pulp-platform/pulp/doc/IP_REFERENCES/BASIC_TIMER_reference.xlsx

Sheet: Info
Document Information
Name | BASIC_TIMER reference
Category | IP reference
Author | Florent Rotenberg
Version | 1.0
Status | Fisrt Release
Description | BASIC_TIMER interface definition
IP Information
IP type | BASIC_TIMER
Delivery Type
History
Date | Modification | Author
26/10/2016 | 1strelease | F.Rotenberg
Content
Info | This sheet. General information about document usage
Usage | Guidelines on how to used the various sheet
IP Release | Release information sheet describing
IPIF_relx.x | IP interface description reference, describing IP symbol/entity and integration and test information relative to IP interface.
IPDESCR_Relx.x | Description of the main features of the IP
IPREGLIST_rely.y | Description of the list of registers used by IP. Registers can be physically instanciated inside IP or outside IP.
IPREGMAP_relz.z | Description of mapping of bit fields when registers are internal to IP. This sheet is optional for IP which are not instanciating registers as information can be build from IPIF and IPRELIST sheet.
IPTREGMAP_relz.z | Description of mapping of test bit field when registers are internal to IP. This sheet is optional for IP which are not instanciating registers as information can be build from IPIF and IPRELIST sheet.

Sheet: Usage
IP Release Sheet
 | Column | Description | Possible Value
 | Version | IP release version numeroted as [major release].[minor release]. A release is major whenever IP interface is modified. | X.Y. Z
 | Release description | This is a free text entry expliciting the release main modifications and purpose. | Text
 | IPIF | IPIF sheet version to be used for this release. | X.Y. Z
 | IPDESCR | IPDESCR sheet version to nbe used for this release | X.Y.Z
 | IPREGLIST | IPREGLIST sheet version to be used for this release. | X.Y. Z
 | IPREGMAP | IPREGMAP sheet version to be used for this release. | X.Y. Z
 | IPDOC | IPDOC version to be used for this release. | X.Y. Z
 | GIT version | GIT database number corresponding to IP design code and IP reference XLS. | Integer
IPIF sheet
IP Interface description | IP Pin Name | Name of IP Pin. This must must exactly name find in code or schematic (including case).
 | Direction | Direction or type of signal | In,Out,IO
 | Type | Analog, Digital, supply, DR (Dual Rail), SR (SingleRail) | Analog,Digital, VDD, GND, DR, SR
 | Voltage Domain
 | Clock domain
 | IO
 | Size
 | Reset Value
 | Description
Integration information | Integration comment
 | Core Interface
 | Register Interface
 | Register name
 | DFT value
 | Level Shifter
 | Isolation cell
 | Connected to
 | Load
 | Drive
 | Destination supply
Hard Macro information | location
 | layer
 | Antenna
Additonal Information | FreeText 1
 | FreeText 2
Driver information | Function1
 | Function2

Sheet: IP Release
Version | Release description | IPIF | IPDESCR | IPREGLIST | IPREGMAP | IPDOC | GIT version
1.0.0 |  | Rel1.0.0 | Rel1.0.0 | Rel1.0.0 | Rel1.0.0

Sheet: IPIF_rel1.0.0
IP Interface description |  |  |  |  |  |  |  |  | Integration information |  |  |  |  |  |  |  |  |  |  |  |  | Hard Macro information |  |  | Additonal Information |  | Driver information
IP Pin Name | Direction | Type | Voltage Domain | Clock domain | IO | Size | Reset Value | Description | Integration comment | Core Interface | Register Interface | Register name | Bit position | Trim during production | DFT value | Level Shifter | Isolation cell | Connected to | Load | Drive | Destination supply | location | layer | Antenna | FreeText 1 | FreeText 2 | Function1 | Function2
clk_i | IN | digital
rstn_i | IN | digital

Sheet: IPDESCR_rel1.0.0
Description
BASIC TIMER component manages the following features: - 2 general purpose 32bits up counter timers - Input trigger sources: - FLL clock - FLL clock + Prescaler - Reference clock at 32kHz - External event - 8bit programmable prescaler to FLL clock - Counting modes: - One shot mode: timer is stopped after first comparison match - Continuous mode: timer continues counting after comparison match - Cycle mode: timer resets to 0 after comparison match and continues counting - 64 bit cascaded mode - Interrupt request generation on comparison match

Sheet: IPREGLIST_rel1.0.0
Register Name | Address | Size | Register Type | Host Access Type | IP access Type | Default Value | Description | FootNote | Comment
CFG_LO | 0x0 | 32 | Config | R/W | R/W | 0x0 | Timer Low Configuration register.
CFG_HI | 0x4 | 32 | Config | R/W | R/W | 0x0 | Timer High Configuration register.
CNT_LO | 0x8 | 32 | Data | R/W | R/W | 0x0 | Timer Low counter value register.
CNT_HI | 0xC | 32 | Data | R/W | R/W | 0x0 | Timer High counter value register.
CMP_LO | 0x10 | 32 | Config | R/W | R/W | 0x0 | Timer Low comparator value register.
CMP_HI | 0x14 | 32 | Config | R/W | R/W | 0x0 | Timer High comparator value register.
START_LO | 0x18 | 32 | Config | R/W | R/W | 0x0 | Start Timer Low counting register.
START_HI | 0x1C | 32 | Config | R/W | R/W | 0x0 | Start Timer High counting register.
RESET_LO | 0x20 | 32 | Config | R/W | R/W | 0x0 | Reset Timer Low counter register.
RESET_HI | 0x24 | 32 | Config | R/W | R/W | 0x0 | Reset Timer High counter register.

Sheet: IPREGMAP_rel1.0.0
Bit field | Register | Bit Position | Size | Host Access Type | IP access Type | Reset Value | Description
ENABLE | CFG_LO | 0 | 1 | R/W | R/W | 0x0 | Timer low enable configuration bitfield: - 1'b0: disabled - 1'b1: enabled
RESET | CFG_LO | 1 | 1 | R/W | R/W | 0x0 | Timer low counter reset command bitfield. Cleared after Timer Low reset execution.
IRQEN | CFG_LO | 2 | 1 | R/W | R/W | 0x0 | Timer low compare match interrupt enable configuration bitfield: - 1'b0: disabled - 1'b1: enabled
MODE | CFG_LO | 4 | 1 | R/W | R/W | 0x0 | Timer low continuous mode configuration bitfield: - 1'b0: Continue mode - continue incrementing Timer low counter when compare match with CMP_LO occurs. - 1'b1: Cycle mode - reset Timer low counter when compare match with CMP_LO occurs.
ONE_S | CFG_LO | 5 | 1 | R/W | R/W | 0x0 | Timer low one shot configuration bitfield: - 1'b0: let Timer low enabled counting when compare match with CMP_LO occurs. - 1'b1: disable Timer low when compare match with CMP_LO occurs.
PEN | CFG_LO | 6 | 1 | R/W | R/W | 0x0 | Timer low prescaler enable configuration bitfield: - 1'b0: disabled - 1'b1: enabled
CCFG | CFG_LO | 7 | 1 | R/W | R/W | 0x0 | Timer low clock source configuration bitfield: - 1'b0: FLL or FLL+Prescaler - 1'b1: Reference clock at 32kHz
PVAL | CFG_LO | 8 | 8 | R/W | R/W | 0x0 | Timer low prescaler value bitfield. Ftimer = Fclk / (1 + PRESC_VAL)
CASC | CFG_LO | 31 | 1 | R/W | R/W | 0x0 | Timer low + Timer high 64bit cascaded mode configuration bitfield.
ENABLE | CFG_HI | 0 | 1 | R/W | R/W | 0x0 | Timer high enable configuration bitfield: - 1'b0: disabled - 1'b1: enabled
RESET | CFG_HI | 1 | 1 | W | R | 0x0 | Timer high counter reset command bitfield. Cleared after Timer high reset execution.
IRQEN | CFG_HI | 2 | 1 | R/W | R/W | 0x0 | Timer high compare match interrupt enable configuration bitfield: - 1'b0: disabled - 1'b1: enabled
MODE | CFG_HI | 4 | 1 | R/W | R/W | 0x0 | Timer high continuous mode configuration bitfield: - 1'b0: Continue mode - continue incrementing Timer high counter when compare match with CMP_LO occurs. - 1'b1: Cycle mode - reset Timer high counter when compare match with CMP_LO occurs.
ONE_S | CFG_HI | 5 | 1 | R/W | R/W | 0x0 | Timer high one shot configuration bitfield: - 1'b0: let Timer high enabled counting when compare match with CMP_LO occurs. - 1'b1: disable Timer high when compare match with CMP_LO occurs.
PEN | CFG_HI | 6 | 1 | R/W | R/W | 0x0 | Timer high prescaler enable configuration bitfield: - 1'b0: disabled - 1'b1: enabled
CLKCFG | CFG_HI | 7 | 1 | R/W | R/W | 0x0 | Timer high clock source configuration bitfield: - 1'b0: FLL or FLL+Prescaler - 1'b1: Reference clock at 32kHz
CNT_LO | CNT_LO | 0 | 32 | R/W | R/W | 0x0 | Timer Low counter value bitfield.
CNT_HI | CNT_HI | 0 | 32 | R/W | R/W | 0x0 | Timer High counter value bitfield.
CMP_LO | CMP_LO | 0 | 32 | R/W | R/W | 0x0 | Timer Low comparator value bitfield.
CMP_HI | CMP_HI | 0 | 32 | R/W | R/W | 0x0 | Timer High comparator value bitfield.
STRT_LO | START_LO | 0 | 1 | W | R | 0x0 | Timer Low start command bitfield. When executed, CFG_LO.ENABLE is set.
STRT_HI | START_HI | 0 | 1 | W | R | 0x0 | Timer High start command bitfield. When executed, CFG_HI.ENABLE is set.
RST_LO | RESET_LO | 0 | 1 | W | R | 0x0 | Timer Low counter reset command bitfield. When executed, CFG_LO.RESET is set.
RST_HI | RESET_HI | 0 | 1 | W | R | 0x0 | Timer High counter reset command bitfield. When executed, CFG_HI.RESET is set.

Sheet: VerPlan_rel1.0.0
Name | Description | testcase location&name | Status
