pulp-platform/pulp/doc/IP_REFERENCES/CL_DMA_reference.xlsx

Sheet: Info
Document Information
Name | CL_DMA reference
Category | IP reference
Author | Florent Rotenberg
Version | 1.0
Status | Fisrt Release
Description | CL_DMA interface definition
IP Information
IP type | CL_DMA
Delivery Type
History
Date | Modification | Author
26/10/2016 | 1strelease | F.Rotenberg
Content
Info | This sheet. General information about document usage
Usage | Guidelines on how to used the various sheet
IP Release | Release information sheet describing
IPIF_relx.x | IP interface description reference, describing IP symbol/entity and integration and test information relative to IP interface.
IPDESCR_Relx.x | Description of the main features of the IP
IPREGLIST_rely.y | Description of the list of registers used by IP. Registers can be physically instanciated inside IP or outside IP.
IPREGMAP_relz.z | Description of mapping of bit fields when registers are internal to IP. This sheet is optional for IP which are not instanciating registers as information can be build from IPIF and IPRELIST sheet.
IPTREGMAP_relz.z | Description of mapping of test bit field when registers are internal to IP. This sheet is optional for IP which are not instanciating registers as information can be build from IPIF and IPRELIST sheet.
IPUDMACMDLIST_relz.z | Description of IP UDMA commands list used by IP.
IPUDMACMDMAP_relz.z | Description of mapping of bit fields in IP UDMA commands used by IP.

Sheet: Usage
IP Release Sheet
 | Column | Description | Possible Value
 | Version | IP release version numeroted as [major release].[minor release]. A release is major whenever IP interface is modified. | X.Y. Z
 | Release description | This is a free text entry expliciting the release main modifications and purpose. | Text
 | IPIF | IPIF sheet version to be used for this release. | X.Y. Z
 | IPDESCR | IPDESCR sheet version to nbe used for this release | X.Y.Z
 | IPREGLIST | IPREGLIST sheet version to be used for this release. | X.Y. Z
 | IPREGMAP | IPREGMAP sheet version to be used for this release. | X.Y. Z
 | IPUDMACMDLIST | IPUDMACMDLIST sheet version to be used for this release. | X.Y. Z
 | IPUDMACMDMAP | IPUDMACMDMAP sheet version to be used for this release. | X.Y. Z
 | IPDOC | IPDOC version to be used for this release. | X.Y. Z
 | GIT version | GIT database number corresponding to IP design code and IP reference XLS. | Integer
IPIF sheet
IP Interface description | IP Pin Name | Name of IP Pin. This must must exactly name find in code or schematic (including case).
 | Direction | Direction or type of signal | In,Out,IO
 | Type | Analog, Digital, supply, DR (Dual Rail), SR (SingleRail) | Analog,Digital, VDD, GND, DR, SR
 | Voltage Domain
 | Clock domain
 | IO
 | Size
 | Reset Value
 | Description
Integration information | Integration comment
 | Core Interface
 | Register Interface
 | Register name
 | DFT value
 | Level Shifter
 | Isolation cell
 | Connected to
 | Load
 | Drive
 | Destination supply
Hard Macro information | location
 | layer
 | Antenna
Additonal Information | FreeText 1
 | FreeText 2
Driver information | Function1
 | Function2

Sheet: IP Release
Version | Release description | IPDESCR | IPIF | IPREGLIST | IPREGMAP | IPUDMACMDLIST | IPUDMACMDMAP | IPDOC | GIT version
1.0.0 |  | Rel1.0.0 | Rel1.0.0 | Rel1.0.0 | Rel1.0.0 | Rel1.0.0 | Rel1.0.0

Sheet: IPIF_rel1.0.0
IP Interface description |  |  |  |  |  |  |  |  | Integration information |  |  |  |  |  |  |  |  |  |  |  |  | Hard Macro information |  |  | Additonal Information |  | Driver information
IP Pin Name | Direction | Type | Voltage Domain | Clock domain | IO | Size | Reset Value | Description | Integration comment | Core Interface | Register Interface | Register name | Bit position | Trim during production | DFT value | Level Shifter | Isolation cell | Connected to | Load | Drive | Destination supply | location | layer | Antenna | FreeText 1 | FreeText 2 | Function1 | Function2

Sheet: IPDESCR_rel1.0.0
Description
Cluster DMA component manages the following features: - 8 RX/TX full-duplex channels - Up to 16 outstanding transfers between L1 and L2 memories - Linear or 2D transfers modes

Sheet: IPREGLIST_rel1.0.0
Register Name | Address | Size | Register Type | Host Access Type | Host access bus | IP access Type | Default Value | Description | FootNote | Comment
CMD | 0x0 | 32 | Config | R/W | DEMUX | R/W | 0x0 | Cluster DMA configuration register.
STATUS | 0x4 | 32 | Status | R/W | DEMUX | R/W | 0x0 | Cluster DMA status register.

Sheet: IPREGMAP_rel1.0.0
Bit field | Register | Bit Position | Size | Host Access Type | IP access Type | Reset Value | Description
CMD | CMD | 0 | 32 | R/W | R/W | 0x0 | Format is operation dependent. See below.
STATUS | STATUS | 0 | 32 | R/W | R/W | 0x0 | Format is operation dependent. See below.

Sheet: IPFSMSTATES_rel1.0.0
State | Format Name | Next State | Start graph | Comment | Graph title
IDLE | GET_TID | ID_ACK | 1 |  | Queue transaction with ID
IDLE | CMD | CMD_ACK | 2 |  | Queue transaction without ID
IDLE | STATUS | IDLE | 3 |  | Get DMA status
IDLE | FREE_TID | IDLE | 4 |  | Free DMA transfer
ID_ACK | CMD | CMD_ACK
CMD_ACK | TCDM | TCDM_ACK
TCDM_ACK | EXT_L2 | IDLE |  | CMD - Not 2D
TCDM_ACK | EXT_L2 | EXT_ACK |  | CMD - 2D
EXT_ACK | 2D | IDLE

Sheet: IPFSMFMTLIST_rel1.0.0
Register Name | Format Name | Size | Host Access Type | Description | FootNote | Comment
CMD | GET_TID | 32 | R | Cluster DMA transfer identifier format.
CMD | CMD | 32 | W | Cluster DMA transfer configuration format.
CMD | TCDM | 32 | W | Cluster DMA L1 base address configuration format.
CMD | EXT_L2 | 32 | W | Cluster DMA L2 base address configuration format.
CMD | 2D | 32 | W | Cluster DMA 2D transfer configuration format.
STATUS | STATUS | 32 | R | Cluster DMA transfer free command format.
STATUS | FREE_TID | 32 | W | Cluster DMA transfer status format.

Sheet: IPFSMFMTMAP_rel1.0.0
Bit field | Register name | Format Name | Bit Position | Size | Host Access Type | IP access Type | Reset Value | Description
LEN | CMD | CMD | 0 | 16 | W | R | 0x0 | Transfer length in bytes configuration bitfield.
TYPE | CMD | CMD | 16 | 1 | W | R | 0x0 | Transfer direction configuration bitfield: - 1'b0: L1 to L2 - 1'b1: L2 to L1
INC | CMD | CMD | 17 | 1 | W | R | 0x0 | Transfer incremental configuration bitfield: - 1'b0: non incremental - 1'b1: incremental
2D | CMD | CMD | 18 | 1 | W | R | 0x0 | Transfer type configuration bitfield: - 1'b0: linear transfer - 1'b1: 2D transfer
ELE | CMD | CMD | 19 | 1 | W | R | 0x0 | Transfer event generation configuration bitfield: - 1'b0: disabled - 1'b1: enabled
ILE | CMD | CMD | 20 | 1 | W | R | 0x0 | Transfer interrupt generation configuration bitfield: - 1'b0: disabled - 1'b1: enabled
BLE | CMD | CMD | 21 | 1 | W | R | 0x0 | Transfer event or interrupt broadcast configuration bitfield: - 1'b0: event or interrupt is routed to the cluster core who initiated the transfer - 1'b1: event or interrupt are broadcasted to all cluster cores
TID | CMD | GET_TID | 0 | 4 | R | W | 0x0 | Transfer identifier value bitfield.
ADDR | CMD | TCDM | 0 | 32 | W | R | 0x0 | Transfer L1 base address configuration bitfield.
ADDR | CMD | EXT_L2 | 0 | 32 | W | R | 0x0 | Transfer L2 base address configuration bitfield.
LEN | CMD | 2D | 0 | 16 | W | R | 0x0 | 2D transfer length value configuration bitfield.
STRIDE | CMD | 2D | 16 | 16 | W | R | 0x0 | 2D transfer stride value configuration bitfield.
TID_TR | STATUS | STATUS | 0 | 16 | R | W | 0x0 | Transfer status bitfield: TID_TR[i]=1'b1 means that transfer with TID i is active.
TID_ALLOC | STATUS | STATUS | 16 | 16 | R | W | 0x0 | Transfer status bitfield: - TID_TR[i]=1'b0 means that transfer allocator with TID i-16 is free. - TID_TR[i]=1'b1 means that transfer allocator with TID i-16 is reserved.
TID_FREE | STATUS | FREE_TID | 0 | 16 | W | R | 0x0 | Transfer canceller configuration bitfield. Writing a 1'b1 in TID_FREE[i] will free transfer with TID i.

Sheet: VerPlan_rel1.0.0
Name | Description | testcase location&name | Status
