pulp-platform/pulp/doc/IP_REFERENCES/CLUSTER_ICACHE_CTRL_reference.xlsx

Sheet: Info
Document Information
Name | FC_ICACHE_CTRL reference
Category | IP reference
Author | Florent Rotenberg
Version | 1.0
Status | Fisrt Release
Description | FC_ICACHE_CTRL interface definition
IP Information
IP type | FC_ICACHE_CTRL
Delivery Type
History
Date | Modification | Author
26/10/2016 | 1st release | F.Rotenberg
Content
Info | This sheet. General information about document usage
Usage | Guidelines on how to used the various sheet
IP Release | Release information sheet describing
IPIF_relx.x | IP interface description reference, describing IP symbol/entity and integration and test information relative to IP interface.
IPDESCR_Relx.x | Description of the main features of the IP
IPREGLIST_rely.y | Description of the list of registers used by IP. Registers can be physically instanciated inside IP or outside IP.
IPREGMAP_relz.z | Description of mapping of bit fields when registers are internal to IP. This sheet is optional for IP which are not instanciating registers as information can be build from IPIF and IPRELIST sheet.
IPTREGMAP_relz.z | Description of mapping of test bit field when registers are internal to IP. This sheet is optional for IP which are not instanciating registers as information can be build from IPIF and IPRELIST sheet.

Sheet: Usage
IP Release Sheet
 | Column | Description | Possible Value
 | Version | IP release version numeroted as [major release].[minor release]. A release is major whenever IP interface is modified. | X.Y. Z
 | Release description | This is a free text entry expliciting the release main modifications and purpose. | Text
 | IPIF | IPIF sheet version to be used for this release. | X.Y. Z
 | IPDESCR | IPDESCR sheet version to nbe used for this release | X.Y.Z
 | IPREGLIST | IPREGLIST sheet version to be used for this release. | X.Y. Z
 | IPREGMAP | IPREGMAP sheet version to be used for this release. | X.Y. Z
 | IPDOC | IPDOC version to be used for this release. | X.Y. Z
 | GIT version | GIT database number corresponding to IP design code and IP reference XLS. | Integer
IPIF sheet
IP Interface description | IP Pin Name | Name of IP Pin. This must must exactly name find in code or schematic (including case).
 | Direction | Direction or type of signal | In,Out,IO
 | Type | Analog, Digital, supply, DR (Dual Rail), SR (SingleRail) | Analog,Digital, VDD, GND, DR, SR
 | Voltage Domain
 | Clock domain
 | IO
 | Size
 | Reset Value
 | Description
Integration information | Integration comment
 | Core Interface
 | Register Interface
 | Register name
 | DFT value
 | Level Shifter
 | Isolation cell
 | Connected to
 | Load
 | Drive
 | Destination supply
Hard Macro information | location
 | layer
 | Antenna
Additonal Information | FreeText 1
 | FreeText 2
Driver information | Function1
 | Function2

Sheet: IP Release
Version | Release description | IPIF | IPDESCR | IPREGLIST | IPREGMAP | IPDOC | GIT version
1.0.0 |  | Rel1.0.0 | Rel1.0.0 | Rel1.0.0 | Rel1.0.0

Sheet: IPIF_rel1.0.0
IP Interface description |  |  |  |  |  |  |  |  | Integration information |  |  |  |  |  |  |  |  |  |  |  |  | Hard Macro information |  |  | Additonal Information |  | Driver information
IP Pin Name | Direction | Type | Voltage Domain | Clock domain | IO | Size | Reset Value | Description | Integration comment | Core Interface | Register Interface | Register name | Bit position | Trim during production | DFT value | Level Shifter | Isolation cell | Connected to | Load | Drive | Destination supply | location | layer | Antenna | FreeText 1 | FreeText 2 | Function1 | Function2
clk_i | IN | digital
rstn_i | IN | digital

Sheet: IPDESCR_rel1.0.0
Description
CL_ICACHE_CTRL component manages the following features: - Bypassable Cluster instruction cache controller - Flush and selective flush commands

Sheet: IPREGLIST_rel1.0.0
Register Name | Header | Address | Size | Register Type | Host Access Type | IP access Type | Default Value | Description | FootNote | Comment | Hide
ENABLE |  | 0x0 | 32 | Config | W | R | 0x0 | Cluster instruction cache unit enable configuration register.
FLUSH |  | 0x4 | 32 | Config | W | R | 0x0 | Cluster instruction cache unit flush command register.
L0_FLUSH |  | 0x8 | 32 | Config | W | R | 0x0 | Cluster level 0 instruction cache unit flush command register. |  |  | X
SEL_FLUSH |  | 0xC | 32 | Config | W | R | 0x0 | Cluster instruction cache unit selective flush command register.
IS_PRIVATE |  | 0x10 | 32 | Config | W | R | 0x0 |  |  |  | X

Sheet: IPREGMAP_rel1.0.0
Bit field | Register | Bit Position | Size | Host Access Type | IP access Type | Reset Value | Description | Hide
EN | ENABLE | 0 | 1 | W | R | 0x0 | Cluster instruction cache enable configuration bitfield: - 1'b0: disabled - 1'b1: enabled
FL | FLUSH | 0 | 1 | W | R | 0x0 | Cluster instruction cache full flush command.
L0_FL | L0_FLUSH | 0 | 1 | W | R | 0x0 | Cluster level 0 instruction cache full flush command. | X
ADDR | SEL_FLUSH | 0 | 32 | W | R | 0x0 | Cluster instruction cache selective flush address configuration bitfield.

Sheet: VerPlan_rel1.0.0
Name | Description | testcase location&name | Status
