pulp-platform/pulp/doc/IP_REFERENCES/SOC_EVENT_GENERATOR_reference.xlsx

Sheet: Info
Document Information
Name | SOC_EVENT_GENERATOR reference
Category | IP reference
Author | Florent Rotenberg
Version | 1.0
Status | Fisrt Release
Description | SOC_EVENT_GENERATOR interface definition
IP Information
IP type | SOC_EVENT_GENERATOR
Delivery Type
History
Date | Modification | Author
26/10/2016 | 1strelease | F.Rotenberg
Content
Info | This sheet. General information about document usage
Usage | Guidelines on how to used the various sheet
IP Release | Release information sheet describing
IPIF_relx.x | IP interface description reference, describing IP symbol/entity and integration and test information relative to IP interface.
IPREGLIST_rely.y | Description of the list of registers used by IP. Registers can be physically instanciated inside IP or outside IP.
IPREGLIST_rely.y | Description of the list of registers used by IP. Registers can be physically instanciated inside IP or outside IP.
IPREGMAP_relz.z | Description of mapping of bit fields when registers are internal to IP. This sheet is optional for IP which are not instanciating registers as information can be build from IPIF and IPRELIST sheet.
IPTREGMAP_relz.z | Description of mapping of test bit field when registers are internal to IP. This sheet is optional for IP which are not instanciating registers as information can be build from IPIF and IPRELIST sheet.
IPUDMACMDLIST_relz.z | Description of IP UDMA commands list used by IP.
IPUDMACMDMAP_relz.z | Description of mapping of bit fields in IP UDMA commands used by IP.

Sheet: Usage
IP Release Sheet
 | Column | Description | Possible Value
 | Version | IP release version numeroted as [major release].[minor release]. A release is major whenever IP interface is modified. | X.Y. Z
 | Release description | This is a free text entry expliciting the release main modifications and purpose. | Text
 | IPIF | IPIF sheet version to be used for this release. | X.Y. Z
 | IPDESCR | IPDESCR sheet version to nbe used for this release | X.Y.Z
 | IPREGLIST | IPREGLIST sheet version to be used for this release. | X.Y. Z
 | IPREGMAP | IPREGMAP sheet version to be used for this release. | X.Y. Z
 | IPUDMACMDLIST | IPUDMACMDLIST sheet version to be used for this release. | X.Y. Z
 | IPUDMACMDMAP | IPUDMACMDMAP sheet version to be used for this release. | X.Y. Z
 | IPDOC | IPDOC version to be used for this release. | X.Y. Z
 | GIT version | GIT database number corresponding to IP design code and IP reference XLS. | Integer
IPIF sheet
IP Interface description | IP Pin Name | Name of IP Pin. This must must exactly name find in code or schematic (including case).
 | Direction | Direction or type of signal | In,Out,IO
 | Type | Analog, Digital, supply, DR (Dual Rail), SR (SingleRail) | Analog,Digital, VDD, GND, DR, SR
 | Voltage Domain
 | Clock domain
 | IO
 | Size
 | Reset Value
 | Description
Integration information | Integration comment
 | Core Interface
 | Register Interface
 | Register name
 | DFT value
 | Level Shifter
 | Isolation cell
 | Connected to
 | Load
 | Drive
 | Destination supply
Hard Macro information | location
 | layer
 | Antenna
Additonal Information | FreeText 1
 | FreeText 2
Driver information | Function1
 | Function2

Sheet: IP Release
Version | Release description | IPDESCR | IPIF | IPREGLIST | IPREGMAP | IPUDMACMDLIST | IPUDMACMDMAP | IPDOC | GIT version
1.0.0 |  | Rel1.0.0 | Rel1.0.0 | Rel1.0.0 | Rel1.0.0 | Rel1.0.0 | Rel1.0.0

Sheet: IPIF_rel1.0.0
IP Interface description |  |  |  |  |  |  |  |  | Integration information |  |  |  |  |  |  |  |  |  |  |  |  | Hard Macro information |  |  | Additonal Information |  | Driver information
IP Pin Name | Direction | Type | Voltage Domain | Clock domain | IO | Size | Reset Value | Description | Integration comment | Core Interface | Register Interface | Register name | Bit position | Trim during production | DFT value | Level Shifter | Isolation cell | Connected to | Load | Drive | Destination supply | location | layer | Antenna | FreeText 1 | FreeText 2 | Function1 | Function2

Sheet: IPDESCR_rel1.0.0
Description
SoC event generator component manages the following features: - Soc events dispatching to FC event unit, Cluster event unit and uDMA - FC High and Low timers input trigger events configuration - SoC software event generation - Event queue of width 2 for each event line with overflow error event generation - 2 high priority events generation Input events managed by SoC event generator are: - 32kHz reference clock - 48 SoC peripherals events inciming from uDMA interfaces, PMU, Advanced timers, GPIOs and RTC - 8 software events

Sheet: IPREGLIST_rel1.0.0
Register Name | Header | Address | Size | Register Type | Host Access Type | IP access Type | Default Value | Description | FootNote | Comment
SW_EVENT |  | 0x0 | 32 | Config | W | R | 0x0 | SoC software events trigger command register.
FC_MASK_MSB |  | 0x4 | 32 | Config | R/W | R/W | 0xFFFFFFFF | MSB FC event unit event dispatch mask configuration register.
FC_MASK_LSB |  | 0x8 | 32 | Config | R/W | R/W | 0xFFFFFFFF | LSB FC event unit event dispatch mask configuration register.
CL_MASK_MSB |  | 0xC | 32 | Config | R/W | R/W | 0xFFFFFFFF | MSB Cluster event dispatch mask configuration register.
CL_MASK_LSB |  | 0x10 | 32 | Config | R/W | R/W | 0xFFFFFFFF | LSB Cluster event dispatch mask configuration register.
PR_MASK_MSB |  | 0x14 | 32 | Config | R/W | R/W | 0xFFFFFFFF | MSB uDMA event dispatch mask configuration register.
PR_MASK_LSB |  | 0x18 | 32 | Config | R/W | R/W | 0xFFFFFFFF | LSB uDMA event dispatch mask configuration register.
ERR_MSB |  | 0x1C | 32 | Status | R | R/W | 0x0 | MSB event queue overflow status register.
ERR_LSB |  | 0x20 | 32 | Status | R | R/W | 0x0 | LSB event queue overflow status register.
TIMER_SEL_HI |  | 0x24 | 32 | Config | R/W | R/W | 0x0 | FC High Timer source event configuration register.
TIMER_SEL_LO |  | 0x28 | 32 | Config | R/W | R/W | 0x0 | FC Low Timer source event configuration register.

Sheet: IPREGMAP_rel1.0.0
Bit field | Register | Bit Position | Size | Host Access Type | IP access Type | Reset Value | Description
EVENT | SW_EVENT | 0 | 8 | W | R | 0x0 | Writing a one-hot value into EVENT bitfield triggers SoC software event i. 8 software events are provided.
FC_MASK_MSB | FC_MASK_MSB | 0 | 32 | R/W | R/W | 0xFFFFFFFF | MSB event mask to enable/disable event dispatch to FC event unit. - Setting bit[i] to 1'b1 disable dispatching event[32+i] to FC event unit. - Setting bit[i] to 1'b0 enable dispatching event[32+i] to FC event unit.
FC_MASK_LSB | FC_MASK_LSB | 0 | 32 | R/W | R/W | 0xFFFFFFFF | LSB event mask to enable/disable event dispatch to FC event unit. - Setting bit[i] to 1'b1 disable dispatching event[i] to FC event unit. - Setting bit[i] to 1'b0 enable dispatching event[i] to FC event unit.
CL_MASK_MSB | CL_MASK_MSB | 0 | 32 | R/W | R/W | 0xFFFFFFFF | MSB event mask to enable/disable event dispatch to Cluster event unit. - Setting bit[i] to 1'b1 disable dispatching event[32+i] to Cluster event unit. - Setting bit[i] to 1'b0 enable dispatching event[32+i] to Cluster event unit.
CL_MASK_LSB | CL_MASK_LSB | 0 | 32 | R/W | R/W | 0xFFFFFFFF | LSB event mask to enable/disable event dispatch to Cluster event unit. - Setting bit[i] to 1'b1 disable dispatching event[i] to Cluster event unit. - Setting bit[i] to 1'b0 enable dispatching event[i] to Cluster event unit.
PR_MASK_MSB | PR_MASK_MSB | 0 | 32 | R/W | R/W | 0xFFFFFFFF | MSB event mask to enable/disable event dispatch to UDMA peripherals. - Setting bit[i] to 1'b1 disable dispatching event[32+i] to uDMA. - Setting bit[i] to 1'b0 enable dispatching event[32+i] to uDMA.
PR_MASK_LSB | PR_MASK_LSB | 0 | 32 | R/W | R/W | 0xFFFFFFFF | LSB event mask to enable/disable event dispatch to UDMA peripherals. - Setting bit[i] to 1'b1 disable dispatching event[i] to uDMA. - Setting bit[i] to 1'b0 enable dispatching event[i] to uDMA.
ERR_MSB | ERR_MSB | 0 | 32 | R | R/W | 0x0 | Report MSB event queue overflows. Cleared after read. Reading a 1'b1 at ERR_MSB[i] means that an overflow occurred for SoC event[32+i] FIFO queue.
ERR_LSB | ERR_LSB | 0 | 32 | R | R/W | 0x0 | Report LSB event queue overflows. Cleared after read. Reading a 1'b1 at ERR_LSB[i] means that an overflow occurred for SoC event[i] FIFO queue.
TIMER_SEL_HI | TIMER_SEL_HI | 0 | 6 | R/W | R/W | 0x0 | Configure which SoC event generator input event is propagated to FC Timer High input trigger event.
TIMER_SEL_LO | TIMER_SEL_LO | 0 | 6 | R/W | R/W | 0x0 | Configure which SoC event generator input event is propagated to FC Timer Low input trigger event.

Sheet: IPUDMACMDLIST_rel1.0.0
Command name | Parameter | Description

Sheet: IPUDMACMDMAP_rel1.0.0
Parameter Bit field | Command name | Bit Position | Size | Reset Value | Description

Sheet: VerPlan_rel1.0.0
Name | Description | testcase location&name | Status
