pulp-platform/pulp/doc/IP_REFERENCES/CL_RI5CY_DEBUG_reference.xlsx

Sheet: Info
Document Information
Name | RI5CY_DEBUG reference
Category | IP reference
Author | Florent Rotenberg
Version | 1.0
Status | Fisrt Release
Description | RI5CY_DEBUG interface definition
IP Information
IP type | RI5CY_DEBUG
Delivery Type
History
Date | Modification | Author
26/10/2016 | 1strelease | F.Rotenberg
Content
Info | This sheet. General information about document usage
Usage | Guidelines on how to used the various sheet
IP Release | Release information sheet describing
IPIF_relx.x | IP interface description reference, describing IP symbol/entity and integration and test information relative to IP interface.
IPREGLIST_rely.y | Description of the list of registers used by IP. Registers can be physically instanciated inside IP or outside IP.
IPREGLIST_rely.y | Description of the list of registers used by IP. Registers can be physically instanciated inside IP or outside IP.
IPREGMAP_relz.z | Description of mapping of bit fields when registers are internal to IP. This sheet is optional for IP which are not instanciating registers as information can be build from IPIF and IPRELIST sheet.
IPTREGMAP_relz.z | Description of mapping of test bit field when registers are internal to IP. This sheet is optional for IP which are not instanciating registers as information can be build from IPIF and IPRELIST sheet.
IPUDMACMDLIST_relz.z | Description of IP UDMA commands list used by IP.
IPUDMACMDMAP_relz.z | Description of mapping of bit fields in IP UDMA commands used by IP.

Sheet: Usage
IP Release Sheet
 | Column | Description | Possible Value
 | Version | IP release version numeroted as [major release].[minor release]. A release is major whenever IP interface is modified. | X.Y. Z
 | Release description | This is a free text entry expliciting the release main modifications and purpose. | Text
 | IPIF | IPIF sheet version to be used for this release. | X.Y. Z
 | IPDESCR | IPDESCR sheet version to nbe used for this release | X.Y.Z
 | IPREGLIST | IPREGLIST sheet version to be used for this release. | X.Y. Z
 | IPREGMAP | IPREGMAP sheet version to be used for this release. | X.Y. Z
 | IPUDMACMDLIST | IPUDMACMDLIST sheet version to be used for this release. | X.Y. Z
 | IPUDMACMDMAP | IPUDMACMDMAP sheet version to be used for this release. | X.Y. Z
 | IPDOC | IPDOC version to be used for this release. | X.Y. Z
 | GIT version | GIT database number corresponding to IP design code and IP reference XLS. | Integer
IPIF sheet
IP Interface description | IP Pin Name | Name of IP Pin. This must must exactly name find in code or schematic (including case).
 | Direction | Direction or type of signal | In,Out,IO
 | Type | Analog, Digital, supply, DR (Dual Rail), SR (SingleRail) | Analog,Digital, VDD, GND, DR, SR
 | Voltage Domain
 | Clock domain
 | IO
 | Size
 | Reset Value
 | Description
Integration information | Integration comment
 | Core Interface
 | Register Interface
 | Register name
 | DFT value
 | Level Shifter
 | Isolation cell
 | Connected to
 | Load
 | Drive
 | Destination supply
Hard Macro information | location
 | layer
 | Antenna
Additonal Information | FreeText 1
 | FreeText 2
Driver information | Function1
 | Function2

Sheet: IP Release
Version | Release description | IPDESCR | IPIF | IPREGLIST | IPREGMAP | IPUDMACMDLIST | IPUDMACMDMAP | IPDOC | GIT version
1.0.0 |  | Rel1.0.0 | Rel1.0.0 | Rel1.0.0 | Rel1.0.0 | Rel1.0.0 | Rel1.0.0

Sheet: IPIF_rel1.0.0
IP Interface description |  |  |  |  |  |  |  |  | Integration information |  |  |  |  |  |  |  |  |  |  |  |  | Hard Macro information |  |  | Additonal Information |  | Driver information
IP Pin Name | Direction | Type | Voltage Domain | Clock domain | IO | Size | Reset Value | Description | Integration comment | Core Interface | Register Interface | Register name | Bit position | Trim during production | DFT value | Level Shifter | Isolation cell | Connected to | Load | Drive | Destination supply | location | layer | Antenna | FreeText 1 | FreeText 2 | Function1 | Function2

Sheet: IPDESCR_rel1.0.0
Description
Cluster RI5CY Debug component manages the following features: - controls break and single step RI5CY core execution modes - configurable execution behavior on RI5CY core exception occurrence - access to PC, GPR and CSR RI5CY core registers - no HW breakpoint are provided

Sheet: IPREGLIST_rel1.0.0
Register Name | Address | Size | Register Type | Host Access Type | IP access Type | Default Value | Description | FootNote | Comment
CTRL | 0x0 | 32 | Config | R/W | R/W | 0x0 | Debug control configuration register. |  | Always accessible, even when the RI5CY core is running.
HIT | 0x4 | 32 | Config | R/W | R/W | 0x0 | Debug hit status register. |  | Always accessible, even when the RI5CY core is running.
IE | 0x8 | 32 | Config | R/W | R/W | 0x0 | Debug exception trap enable configuration register. |  | Always accessible, even when the RI5CY core is running.
CAUSE | 0xC | 32 | Config | R | W | 0x0 | Debug trap cause status register. |  | Always accessible, even when the RI5CY core is running.
NPC | 0x2000 | 32 | Config | R/W | R/W | 0x0 | Debug next program counter value register. |  | Only accessible if the RI5CY core is halted.
PPC | 0x2004 | 32 | Config | R | W | 0x0 | Debug previous program counter value register. |  | Only accessible if the RI5CY core is halted.
GPR0 | 0x400 | 32 | Config | R/W | R/W | 0x0 | Core general purpose register 0 value register. |  | Only accessible if the RI5CY core is halted.
GPR1 | 0x404 | 32 | Config | R/W | R/W | 0x0 | Core general purpose register 1 value register. |  | Only accessible if the RI5CY core is halted.
GPR2 | 0x408 | 32 | Config | R/W | R/W | 0x0 | Core general purpose register 2 value register. |  | Only accessible if the RI5CY core is halted.
GPR3 | 0x40C | 32 | Config | R/W | R/W | 0x0 | Core general purpose register 3 value register. |  | Only accessible if the RI5CY core is halted.
GPR4 | 0x410 | 32 | Config | R/W | R/W | 0x0 | Core general purpose register 4 value register. |  | Only accessible if the RI5CY core is halted.
GPR5 | 0x414 | 32 | Config | R/W | R/W | 0x0 | Core general purpose register 5 value register. |  | Only accessible if the RI5CY core is halted.
GPR6 | 0x418 | 32 | Config | R/W | R/W | 0x0 | Core general purpose register 6 value register. |  | Only accessible if the RI5CY core is halted.
GPR7 | 0x41C | 32 | Config | R/W | R/W | 0x0 | Core general purpose register 7 value register. |  | Only accessible if the RI5CY core is halted.
GPR8 | 0x420 | 32 | Config | R/W | R/W | 0x0 | Core general purpose register 8 value register. |  | Only accessible if the RI5CY core is halted.
GPR9 | 0x424 | 32 | Config | R/W | R/W | 0x0 | Core general purpose register 9 value register. |  | Only accessible if the RI5CY core is halted.
GPR10 | 0x428 | 32 | Config | R/W | R/W | 0x0 | Core general purpose register 10 value register. |  | Only accessible if the RI5CY core is halted.
GPR11 | 0x42C | 32 | Config | R/W | R/W | 0x0 | Core general purpose register 11 value register. |  | Only accessible if the RI5CY core is halted.
GPR12 | 0x430 | 32 | Config | R/W | R/W | 0x0 | Core general purpose register 12 value register. |  | Only accessible if the RI5CY core is halted.
GPR13 | 0x434 | 32 | Config | R/W | R/W | 0x0 | Core general purpose register 13 value register. |  | Only accessible if the RI5CY core is halted.
GPR14 | 0x438 | 32 | Config | R/W | R/W | 0x0 | Core general purpose register 14 value register. |  | Only accessible if the RI5CY core is halted.
GPR15 | 0x43C | 32 | Config | R/W | R/W | 0x0 | Core general purpose register 15 value register. |  | Only accessible if the RI5CY core is halted.
GPR16 | 0x440 | 32 | Config | R/W | R/W | 0x0 | Core general purpose register 16 value register. |  | Only accessible if the RI5CY core is halted.
GPR17 | 0x444 | 32 | Config | R/W | R/W | 0x0 | Core general purpose register 17 value register. |  | Only accessible if the RI5CY core is halted.
GPR18 | 0x448 | 32 | Config | R/W | R/W | 0x0 | Core general purpose register 18 value register. |  | Only accessible if the RI5CY core is halted.
GPR19 | 0x44C | 32 | Config | R/W | R/W | 0x0 | Core general purpose register 19 value register. |  | Only accessible if the RI5CY core is halted.
GPR20 | 0x450 | 32 | Config | R/W | R/W | 0x0 | Core general purpose register 20 value register. |  | Only accessible if the RI5CY core is halted.
GPR21 | 0x454 | 32 | Config | R/W | R/W | 0x0 | Core general purpose register 21 value register. |  | Only accessible if the RI5CY core is halted.
GPR22 | 0x458 | 32 | Config | R/W | R/W | 0x0 | Core general purpose register 22 value register. |  | Only accessible if the RI5CY core is halted.
GPR23 | 0x45C | 32 | Config | R/W | R/W | 0x0 | Core general purpose register 23 value register. |  | Only accessible if the RI5CY core is halted.
GPR24 | 0x460 | 32 | Config | R/W | R/W | 0x0 | Core general purpose register 24 value register. |  | Only accessible if the RI5CY core is halted.
GPR25 | 0x464 | 32 | Config | R/W | R/W | 0x0 | Core general purpose register 25 value register. |  | Only accessible if the RI5CY core is halted.
GPR26 | 0x468 | 32 | Config | R/W | R/W | 0x0 | Core general purpose register 26 value register. |  | Only accessible if the RI5CY core is halted.
GPR27 | 0x46C | 32 | Config | R/W | R/W | 0x0 | Core general purpose register 27 value register. |  | Only accessible if the RI5CY core is halted.
GPR28 | 0x470 | 32 | Config | R/W | R/W | 0x0 | Core general purpose register 28 value register. |  | Only accessible if the RI5CY core is halted.
GPR29 | 0x474 | 32 | Config | R/W | R/W | 0x0 | Core general purpose register 29 value register. |  | Only accessible if the RI5CY core is halted.
GPR30 | 0x478 | 32 | Config | R/W | R/W | 0x0 | Core general purpose register 30 value register. |  | Only accessible if the RI5CY core is halted.
GPR31 | 0x47C | 32 | Config | R/W | R/W | 0x0 | Core general purpose register 31 value register. |  | Only accessible if the RI5CY core is halted.
CSR_MSTATUS | 0x4C00 | 32 | Config | R/W | R/W | 0x0 | Core CSR machine status value register. |  | Only accessible if the RI5CY core is halted.
CSR_MTVEC | 0x4C14 | 32 | Config | R/W | R | 0x0 | Core CSR machine vector-trap base address value register. |  | Only accessible if the RI5CY core is halted.
CSR_MEPC | 0x4D04 | 32 | Config | R/W | R/W | 0x0 | Core CSR machine exception program counter value register. |  | Only accessible if the RI5CY core is halted.
CSR_MCAUSE | 0x4D08 | 32 | Config | R/W | R/W | 0x0 | Core CSR machine trap cause value register. |  | Only accessible if the RI5CY core is halted.
CSR_PCCR | 0x5E00 | 32 | Config | R/W | R/W | 0x0 | Core CSR performance counter counter register. |  | Only accessible if the RI5CY core is halted.
CSR_PCER | 0x5E80 | 32 | Config | R/W | R/W | 0x0 | Core CSR performance counter enable configuration register. |  | Only accessible if the RI5CY core is halted.
CSR_PCMR | 0x5E84 | 32 | Config | R/W | R/W | 0x0 | Core CSR performance counter mode configuration register. |  | Only accessible if the RI5CY core is halted.
CSR_HWLP0S | 0x5EC0 | 32 | Config | R/W | R/W | 0x0 | Core CSR hardware loop 0 start configuration register. |  | Only accessible if the RI5CY core is halted.
CSR_HWLP0E | 0x5EC4 | 32 | Config | R/W | R/W | 0x0 | Core CSR hardware loop 0 end configuration register. |  | Only accessible if the RI5CY core is halted.
CSR_HWLP0C | 0x5EC8 | 32 | Config | R/W | R/W | 0x0 | Core CSR hardware loop 0 counter configuration register. |  | Only accessible if the RI5CY core is halted.
CSR_HWLP1S | 0x5ED0 | 32 | Config | R/W | R/W | 0x0 | Core CSR hardware loop 1 start configuration register. |  | Only accessible if the RI5CY core is halted.
CSR_HWLP1E | 0x5ED4 | 32 | Config | R/W | R/W | 0x0 | Core CSR hardware loop 1 end configuration register. |  | Only accessible if the RI5CY core is halted.
CSR_HWLP1C | 0x5ED8 | 32 | Config | R/W | R/W | 0x0 | Core CSR hardware loop 1 counter configuration register. |  | Only accessible if the RI5CY core is halted.
CSR_PRIVLV | 0x7040 | 32 | Config | R | W | 0x0 | Cose CSR privilege level status register. |  | Only accessible if the RI5CY core is halted.
CSR_UHARTID | 0x4050 | 32 | Config | R | W | 0x0 | Core CSR user privilege mode hardware thread ID status register. |  | Only accessible if the RI5CY core is halted.
CSR_MHARTID | 0x7C50 | 32 | Config | R | W | 0x0 | Core CSR machine privilege mode hardware thread ID status register. |  | Only accessible if the RI5CY core is halted.

Sheet: IPREGMAP_rel1.0.0
Bit field | Register | Core Privilege | Bit Position | Size | Host Access Type | IP access Type | Reset Value | Description | Hide
SSTE | CTRL | SECURED/NOT_SECURED | 0 | 1 | R/W | R/W | 0x0 | Single step mode configuration bitfield: - 1'b0: disabled - 1'b1: enabled
HALT | CTRL | SECURED/NOT_SECURED | 16 | 1 | W | R | 0x0 | Debug mode configuration bitfield: - 1'b0: exits debug mode - 1'b1: enters debug mode breaking code execution
HALT_STATUS | CTRL | SECURED/NOT_SECURED | 16 | 1 | R | W | 0x0 | Debug mode status bitfield: - 1'b0: running mode - 1'b1: debug mode
SSTH | HIT | SECURED/NOT_SECURED | 0 | 1 | R/W | R/W | 0x0 | Single step hit status bitfield: - 1'b0: disabled - single step mode disabled - 1'b1: enabled – single step mode enabled Sticky bit that must be cleared by external debugger.
SLEEP | HIT | SECURED/NOT_SECURED | 16 | 1 | R | W | 0x0 | Sleep mode status bitfield: - 1'b0: running - core is in running state - 1'b1: sleeping – core is in sleeping state and waits for en event to wake up
EILL | IE | SECURED/NOT_SECURED | 2 | 1 | R/W | R/W | 0x0 | Illegal instruction trap configuration bitfield: - 1'b0: normal - normal exception behavior mode - 1'b1: cause trap – exception causes trap and core switch into debug mode
EBRK | IE | SECURED/NOT_SECURED | 3 | 1 | R/W | R/W | 0x0 | Environment break trap configuration bitfield: - 1'b0: normal - normal exception behavior mode - 1'b1: cause trap – exception causes trap and core switch into debug mode
ELSU | IE | SECURED/NOT_SECURED | 5 | 1 | R/W | R/W | 0x0 | Load/store access fault trap configuration bitfield: - 1'b0: normal - normal exception behavior mode - 1'b1: cause trap – exception causes trap and core switch into debug mode
ELSU_DUP | IE | SECURED/NOT_SECURED | 7 | 1 | R/W | R/W | 0x0 | Load/store access fault trap configuration bitfield: - 1'b0: normal - normal exception behavior mode - 1'b1: cause trap – exception causes trap and core switch into debug mode This bitfield is duplicates the ELSU bitfield.
ECALL | IE | SECURED/NOT_SECURED | 11 | 1 | R/W | R/W | 0x0 | Environment call trap configuration bitfield: - 1'b0: normal - normal exception behavior mode - 1'b1: cause trap - exception causes trap and core switch into debug mode
CAUSE | CAUSE | SECURED/NOT_SECURED | 0 | 5 | R | W | 0x0 | Exception ID bitfield. If IRQ is 1'b1 contains interrupt number otherwise: - 6'h02: sigill - Illegal Instruction - 6'h03: sigtrap - breakpoint - 6'h0B: sigecall - eCall user mode - 6'h0b sigecall - eCall machine mode - 6'h1f sigstop - core was halted by an external signal
IRQ | CAUSE | SECURED/NOT_SECURED | 31 | 1 | R | W | 0x0 | Core in debug mode due to interrupt trap status bitfield: - 1'b0: false - 1'b1: true
NPC | NPC | SECURED/NOT_SECURED | 0 | 32 | R/W | R/W | 0x0 | Next program counter value bitfield.
PPC | PPC | SECURED/NOT_SECURED | 0 | 32 | R | W | 0x0 | Previous program counter value bitfield.
GPR0 | GPR0 | SECURED/NOT_SECURED | 0 | 32 | R/W | R/W | 0x0 | General purpose register 0 value bitfield.
GPR1 | GPR1 | SECURED/NOT_SECURED | 0 | 32 | R/W | R/W | 0x0 | General purpose register 1 value bitfield.
GPR2 | GPR2 | SECURED/NOT_SECURED | 0 | 32 | R/W | R/W | 0x0 | General purpose register 2 value bitfield.
GPR3 | GPR3 | SECURED/NOT_SECURED | 0 | 32 | R/W | R/W | 0x0 | General purpose register 3 value bitfield.
GPR4 | GPR4 | SECURED/NOT_SECURED | 0 | 32 | R/W | R/W | 0x0 | General purpose register 4 value bitfield.
GPR5 | GPR5 | SECURED/NOT_SECURED | 0 | 32 | R/W | R/W | 0x0 | General purpose register 5 value bitfield.
GPR6 | GPR6 | SECURED/NOT_SECURED | 0 | 32 | R/W | R/W | 0x0 | General purpose register 6 value bitfield.
GPR7 | GPR7 | SECURED/NOT_SECURED | 0 | 32 | R/W | R/W | 0x0 | General purpose register 7 value bitfield.
GPR8 | GPR8 | SECURED/NOT_SECURED | 0 | 32 | R/W | R/W | 0x0 | General purpose register 8 value bitfield.
GPR9 | GPR9 | SECURED/NOT_SECURED | 0 | 32 | R/W | R/W | 0x0 | General purpose register 9 value bitfield.
GPR10 | GPR10 | SECURED/NOT_SECURED | 0 | 32 | R/W | R/W | 0x0 | General purpose register 10 value bitfield.
GPR11 | GPR11 | SECURED/NOT_SECURED | 0 | 32 | R/W | R/W | 0x0 | General purpose register 11 value bitfield.
GPR12 | GPR12 | SECURED/NOT_SECURED | 0 | 32 | R/W | R/W | 0x0 | General purpose register 12 value bitfield.
GPR13 | GPR13 | SECURED/NOT_SECURED | 0 | 32 | R/W | R/W | 0x0 | General purpose register 13 value bitfield.
GPR14 | GPR14 | SECURED/NOT_SECURED | 0 | 32 | R/W | R/W | 0x0 | General purpose register 14 value bitfield.
GPR15 | GPR15 | SECURED/NOT_SECURED | 0 | 32 | R/W | R/W | 0x0 | General purpose register 15 value bitfield.
GPR16 | GPR16 | SECURED/NOT_SECURED | 0 | 32 | R/W | R/W | 0x0 | General purpose register 16 value bitfield.
GPR17 | GPR17 | SECURED/NOT_SECURED | 0 | 32 | R/W | R/W | 0x0 | General purpose register 17 value bitfield.
GPR18 | GPR18 | SECURED/NOT_SECURED | 0 | 32 | R/W | R/W | 0x0 | General purpose register 18 value bitfield.
GPR19 | GPR19 | SECURED/NOT_SECURED | 0 | 32 | R/W | R/W | 0x0 | General purpose register 19 value bitfield.
GPR20 | GPR20 | SECURED/NOT_SECURED | 0 | 32 | R/W | R/W | 0x0 | General purpose register 20 value bitfield.
GPR21 | GPR21 | SECURED/NOT_SECURED | 0 | 32 | R/W | R/W | 0x0 | General purpose register 21 value bitfield.
GPR22 | GPR22 | SECURED/NOT_SECURED | 0 | 32 | R/W | R/W | 0x0 | General purpose register 22 value bitfield.
GPR23 | GPR23 | SECURED/NOT_SECURED | 0 | 32 | R/W | R/W | 0x0 | General purpose register 23 value bitfield.
GPR24 | GPR24 | SECURED/NOT_SECURED | 0 | 32 | R/W | R/W | 0x0 | General purpose register 24 value bitfield.
GPR25 | GPR25 | SECURED/NOT_SECURED | 0 | 32 | R/W | R/W | 0x0 | General purpose register 25 value bitfield.
GPR26 | GPR26 | SECURED/NOT_SECURED | 0 | 32 | R/W | R/W | 0x0 | General purpose register 26 value bitfield.
GPR27 | GPR27 | SECURED/NOT_SECURED | 0 | 32 | R/W | R/W | 0x0 | General purpose register 27 value bitfield.
GPR28 | GPR28 | SECURED/NOT_SECURED | 0 | 32 | R/W | R/W | 0x0 | General purpose register 28 value bitfield.
GPR29 | GPR29 | SECURED/NOT_SECURED | 0 | 32 | R/W | R/W | 0x0 | General purpose register 29 value bitfield.
GPR30 | GPR30 | SECURED/NOT_SECURED | 0 | 32 | R/W | R/W | 0x0 | General purpose register 30 value bitfield.
GPR31 | GPR31 | SECURED/NOT_SECURED | 0 | 32 | R/W | R/W | 0x0 | General purpose register 31 value bitfield.
MIE | CSR_MSTATUS | SECURED | 3 | 1 | R/W | R/W | 0x0 | Machine privilege mode interrupt enable configuration bitfield: - 1'b0: disabled - 1'b1: enabled
MPIE | CSR_MSTATUS | SECURED | 7 | 1 | R/W | R/W | 0x0 | Machine privilege mode previous interrupt enable value bitfield. When an interrupis encountered, MPIE will store the value existing in MIE. When mret instruction is executed, the value of MPIE is restored into MIE.
MPP | CSR_MSTATUS | SECURED | 11 | 2 | R/W | R/W | 0x3 | Hardwired to 2'b11.
MTVEC | CSR_MTVEC | SECURED/NOT_SECURED | 8 | 24 | R/W | R/W | 0x0 | Machine trap-vector base address value bitfield.
MEPC | CSR_MEPC | SECURED/NOT_SECURED | 0 | 32 | R/W | R/W | 0x0 | Machine exception program counter value bitfield. When an exception is encountered, the current program counter is saved in MEPC, and the core jumps to the exception address. When an mret instruction is executed, the value from MEPC is restored to the current program counter.
CAUSE | CSR_MCAUSE | SECURED/NOT_SECURED | 0 | 5 | R | W | 0x0 | Exception ID bitfield. If IRQ is 1'b1 contains interrupt number otherwise: - 6'h02: sigill - Illegal Instruction - 6'h03: sigtrap - breakpoint - 6'h0B: sigecall - eCall user mode - 6'h0b sigecall - eCall machine mode - 6'h1f sigstop - core was halted by an external signal
IRQ | CSR_MCAUSE | SECURED/NOT_SECURED | 31 | 1 | R | W | 0x0 | Core triggered an exception due to interrupt status bitfield: - 1'b0: false - 1'b1: true
PCCR | CSR_PCCR | SECURED/NOT_SECURED | 0 | 32 | R/W | R/W | 0x0 | Program counter counter value bitfield.
PCER | CSR_PCER | SECURED/NOT_SECURED | 0 | 21 | R/W | R/W | 0x0 | See documentation on [RI5CY core](<https://pulp-platform.org//wp-content/uploads/2017/11/ri5cy_user_manual.pdf>) for details.
SAT | CSR_PCMR | SECURED/NOT_SECURED | 0 | 1 | R/W | R/W | 0x0 | Performance counter saturation mode configuration bitfield: - 1'b0: wrap around - wrap-around mode - 1'b1: saturation – saturation mode
GE | CSR_PCMR | SECURED/NOT_SECURED | 1 | 1 | R/W | R/W | 0x0 | Performance counter activation configuration bitfield: - 1'b0: disabled - 1'b1: enabled
START | CSR_HWLP0S | SECURED/NOT_SECURED | 0 | 32 | R/W | R/W | 0x0 | Hardware loop start address configuration bitfield.
END | CSR_HWLP0E | SECURED/NOT_SECURED | 0 | 32 | R/W | R/W | 0x0 | Hardware loop end address configuration bitfield.
CNT | CSR_HWLP0C | SECURED/NOT_SECURED | 0 | 32 | R/W | R/W | 0x0 | Hardware loop counter configuration bitfield.
START | CSR_HWLP1S | SECURED/NOT_SECURED | 0 | 32 | R/W | R/W | 0x0 | Hardware loop start address configuration bitfield.
END | CSR_HWLP1E | SECURED/NOT_SECURED | 0 | 32 | R/W | R/W | 0x0 | Hardware loop end address configuration bitfield.
CNT | CSR_HWLP1C | SECURED/NOT_SECURED | 0 | 32 | R/W | R/W | 0x0 | Hardware loop counter configuration bitfield.
PLEV | CSR_PRIVLV | SECURED/NOT_SECURED | 0 | 2 | R | W | 0x0 | Hardwired to 2'b11.
CORE_ID | CSR_UHARTID | SECURED/NOT_SECURED | 0 | 4 | R | W | 0x0 | RI5CY core ID value bitfield.
CLUSTER_ID | CSR_UHARTID | SECURED/NOT_SECURED | 5 | 6 | R | W | 0x0 | Cluster ID value bitfield.
CORE_ID | CSR_MHARTID | SECURED/NOT_SECURED | 0 | 4 | R | W | 0x0 | RI5CY core ID value bitfield.
CLUSTER_ID | CSR_MHARTID | SECURED/NOT_SECURED | 5 | 6 | R | W | 0x0 | Cluster ID value bitfield.

Sheet: VerPlan_rel1.0.0
Name | Description | testcase location&name | Status
