pulp-platform/pulp/doc/Pulp_configuration.xlsx

Sheet: Info
Document Information
Name | GAP8 configuration
Category | Template
Author | Florent Rotenberg
Version | 0.1
Status | Draft
Description | Reference document for GAP8 information exchange inside project team.
GAP8 Information
Delivery Type
History
Date | Modification | Author
Content
Info | This sheet. General information about document usage
Usage | Guidelines on how to use the various sheet
Release | PULP release information sheet
IPCONFIG_relx.y.z | Description of the list of IP used in Pulp.
MEMMAP_relx.y.z | Description of the Pulp memory map visible as a software programming interface.

Sheet: Usage
IP Config Sheet
 | Column | Description | Possible Value
 | IP name
 | IP owner
 | IP owner email
 | GIT version | GIT database number corresponding to IP design code and IP reference XLS. | Integer

Sheet: Release
Version | Release description | IPCONFIG | MEMMAP
1.0.0 | First PULP Release | Rel1.0.0 | Rel1.0.0

Sheet: IPCONFIG_rel1.0.0
IP domain | IP hierarchy | IP name | IP RTL review | RTL Lint | IP integrated | Memory Mapped IP | IP Base Address | IP hal/archi/driver SDK | IP spec summary | Register Map IP reference (xlsx) | IP UDMA CMD (xlsx) | doc IP person in charge | doc IP comment | IP Doc Location | IP detailed design spec | IP VERIF PLAN | IP testcase regression | IP unit test tetbench | GIT version | IP owner | IP owner email
SAFE
 |  | SAFE_DOMAIN_REG_IF |  |  | YES | NO | N/A | N/A | N/A | N/A | N/A |  | associated to apb_soc_ctrl | docs/IP_REFERENCES |  | To be done | To be checked | To be checked
 |  | POR_BOR_AON |  |  | YES | NO | N/A | N/A | To be done | N/A | N/A | Eric/Antonio | describe here how gap power startup sequence works with RAR/DCDC | docs/IP_REFERENCES |  | To be done | To be checked | To be checked |  | Dolphin/Antonio Pullini | antonio.pullini@greenwaves-technologies.com
 |  | PMU MAESTRO |  |  | YES | NO | N/A | To be checked | To be done | N/A | N/A | Eric | Describe here power architecture and programming model | docs/IP_REFERENCES |  | To be done | To be checked | To be checked |  | Dolphin/Antonio Pullini | antonio.pullini@greenwaves-technologies.com
 |  | PAD_CONTROL |  |  | YES | NO | N/A | N/A | N/A | N/A | N/A | Florent | this is padmux alternate description | docs/IP_REFERENCES |  | To be done | To be checked | To be checked |  | Antonio Pullini | antonio.pullini@greenwaves-technologies.com
 |  | JTAG |  |  | YES | NO | N/A | N/A | To be done | N/A | N/A | Florent |  | docs/IP_REFERENCES |  | To be done | To be checked | To be checked |  | Antonio Pullini | antonio.pullini@greenwaves-technologies.com
 |  | RAR(DCDC) |  |  | YES | NO | N/A | N/A | To be done | N/A | N/A | Eric/Antonio | describe here how gap power startup sequence works | docs/IP_REFERENCES |  | To be done | To be checked | To be checked |  | Dolphin/Antonio Pullini | antonio.pullini@greenwaves-technologies.com
 |  | RSTGEN (cluster_soc_rstgen) |  |  | YES | NO | N/A | N/A | YES | N/A | N/A | Florent |  | docs/IP_REFERENCES |  | To be done | To be checked | To be checked
 |  | RTC |  |  | YES | YES | YES | To be checked | YES | YES | N/A | Florent |  | docs/IP_REFERENCES |  | To be done | To be checked | To be checked |  | Dolphin/Antonio Pullini | antonio.pullini@greenwaves-technologies.com
SOC
 | SOC_TRC | CLICK (trc) |  |  | YES | NO | N/A | N/A | To be done | N/A | N/A | Eric/Antonio | Associated to PMU description | docs/IP_REFERENCES |  | To be done | To be checked | To be checked |  | Dolphin/Antonio Pullini | antonio.pullini@greenwaves-technologies.com
 | ULPSOC | DC_TOKEN_RING_FIFO_DIN (event_dc) |  |  | YES | NO | N/A | N/A | N/A | N/A | N/A | Eric/Antonio | Associated to bus architecture description | docs/IP_REFERENCES |  | To be done | To be checked | To be checked
 | ULPSOC | L2_RAM_MULTIBANK |  |  | YES | YES | YES | N/A | To be done | N/A | N/A |  |  | docs/IP_REFERENCES |  | To be done | To be checked | To be checked
 | ULPSOC | AXI_MEM_IF_DP_WRAP (L2_MEM_IF) |  |  | YES | NO | N/A | N/A | N/A | N/A | N/A |  |  | docs/IP_REFERENCES |  | To be done | To be checked | To be checked
 | ULPSOC | AXI_ID_REMAP_WRAP |  |  | YES | NO | N/A | N/A | N/A | N/A | N/A | Igor | Associated to bus architecture description | docs/IP_REFERENCES |  | To be done | To be checked | To be checked
 | ULPSOC | AXI_SLICE_DC_MASTER (dc_fifo_dataout) |  |  | YES | NO | N/A | N/A | N/A | N/A | N/A | Eric/Antonio | Associated to bus architecture description | docs/IP_REFERENCES |  | To be done | To be checked | To be checked
 | ULPSOC | AXI_SLICE_DC_SLAVE (dc_fifo_datain) |  |  | YES | NO | N/A | N/A | N/A | N/A | N/A | Eric/Antonio | Associated to bus architecture description | docs/IP_REFERENCES |  | To be done | To be checked | To be checked
 | ULPSOC | BOOT_ROM |  |  | YES | YES | YES | N/A | To be done | N/A | N/A |  |  | docs/IP_REFERENCES |  | To be done | To be checked | To be checked
 | ULPSOC | AXI_SPI_SLAVE |  |  | YES | NO | N/A | N/A | YES | N/A | N/A | Florent |  | docs/IP_REFERENCES |  | To be done | To be checked | To be checked
 | ULPSOC | ADBG_AXIONLY |  |  | YES | NO | N/A | To be checked | To be done | N/A | N/A | Florent |  | docs/IP_REFERENCES |  | To be done | To be checked | To be checked
 | ULPSOC | AXI2APB |  |  | YES | NO | N/A | N/A | To be done | N/A | N/A | Igor | Associated to bus architecture description | docs/IP_REFERENCES |  | To be done | To be checked | To be checked
 | ULPSOC/APB_MPU | ADDRESS_FILTER |  |  | YES | NO | N/A | N/A | To be done | N/A | N/A | Igor | Associated to MPU architecture description | docs/IP_REFERENCES |  | To be done | To be checked | To be checked
 | ULPSOC/SOC_PERIPH | SOC_EVENT_GENERATOR |  |  | YES | YES | YES | To be checked | YES | YES | N/A | Florent |  | docs/IP_REFERENCES |  | To be done | To be checked | To be checked |  | Antonio Pullini | antonio.pullini@greenwaves-technologies.com
 | ULPSOC/SOC_PERIPH | DLC_BRIDGE_APB (Maestro) |  |  | YES | YES | YES | To be checked | To be done | YES | N/A | Martin |  | docs/IP_REFERENCES |  | To be done | To be checked | To be checked |  | Antonio Pullini
 | ULPSOC/SOC_PERIPH | PERIPH_BUS (APB_NODE) |  |  | YES | NO | N/A | N/A | To be done | N/A | N/A | Igor | Associated to bus architecture description | docs/IP_REFERENCES |  | To be done | To be checked | To be checked
 | ULPSOC/SOC_PERIPH/UDMA_SUBSYSTEM | UDMA_CORE |  |  | YES | NO | N/A | N/A | To be done | N/A | N/A | Antonio |  | fe/ips/udma/doc |  | To be done | To be checked | To be checked |  | Antonio Pullini | antonio.pullini@greenwaves-technologies.com
 | ULPSOC/SOC_PERIPH/UDMA_SUBSYSTEM | UDMA_CTRL |  |  | YES | YES | YES | To be checked | YES | YES | N/A | Florent |  | fe/ips/udma/doc |  | To be done | To be checked | To be checked |  | Antonio Pullini | antonio.pullini@greenwaves-technologies.com
 | ULPSOC/SOC_PERIPH/UDMA_SUBSYSTEM | UART |  |  | YES | YES | YES | To be checked | YES | YES | N/A | Florent |  | fe/ips/udma/doc |  | To be done | To be checked | To be checked |  | Antonio Pullini | antonio.pullini@greenwaves-technologies.com
 | ULPSOC/SOC_PERIPH/UDMA_SUBSYSTEM | LVDS TRANSCEIVER |  |  | YES | YES | YES | To be checked | To be done | To be checked | N/A | Fabien |  | fe/ips/udma/doc |  | To be done | To be checked | To be checked
 | ULPSOC/SOC_PERIPH/UDMA_SUBSYSTEM | TCDM_IF |  |  | YES | YES | YES | To be checked | YES | YES | N/A | Florent |  | fe/ips/udma/doc |  | To be done | To be checked | To be checked
 | ULPSOC/SOC_PERIPH/UDMA_SUBSYSTEM | SPIM (0 to 2) |  |  | YES | YES | YES | To be checked | YES | YES | YES | Florent |  | fe/ips/udma/doc |  | To be done | To be checked | To be checked |  | Antonio Pullini | antonio.pullini@greenwaves-technologies.com
 | ULPSOC/SOC_PERIPH/UDMA_SUBSYSTEM | I2S 2 inputs channels |  |  | YES | YES | YES | To be checked | YES | YES | N/A | Florent |  | fe/ips/udma/doc |  | To be done | To be checked | To be checked |  | Antonio Pullini | antonio.pullini@greenwaves-technologies.com
 | ULPSOC/SOC_PERIPH/UDMA_SUBSYSTEM | I2C (0 to 1) |  |  | YES | YES | YES | To be checked | YES | YES | YES | Florent |  | fe/ips/udma/doc |  | To be done | To be checked | To be checked |  | Antonio Pullini | antonio.pullini@greenwaves-technologies.com
 | ULPSOC/SOC_PERIPH/UDMA_SUBSYSTEM | CAMERA_IF |  |  | YES | YES | YES | To be checked | YES | YES | N/A | Florent |  | fe/ips/udma/doc |  | To be done | To be checked | To be checked |  | Antonio Pullini | antonio.pullini@greenwaves-technologies.com
 | ULPSOC/SOC_PERIPH/UDMA_SUBSYSTEM | HYPERMEM |  |  | YES | YES | YES | To be checked | To be done | YES | N/A | Florent |  | fe/ips/udma/doc |  | To be done | To be checked | To be checked |  | Antonio Pullini | antonio.pullini@greenwaves-technologies.com
 | ULPSOC/SOC_PERIPH/UDMA_SUBSYSTEM | APB_IF |  |  | YES | NO | N/A | N/A | N/A | N/A | N/A |  |  | fe/ips/udma/doc |  | To be done | To be checked | To be checked
 | ULPSOC/SOC_PERIPH/UDMA_SUBSYSTEM | CLOCK_GATE (for all periphs) |  |  | YES | NO | N/A | N/A | N/A | N/A | N/A |  |  | fe/ips/udma/doc |  | To be done | To be checked | To be checked
 | ULPSOC/SOC_PERIPH | APB_SOC_CTRL |  |  | YES | YES | YES | To be checked | YES | YES | N/A | Martin | safe_domain_reg_if included | docs/IP_REFERENCES |  | To be done | To be checked | To be checked |  | Antonio Pullini | antonio.pullini@greenwaves-technologies.com
 | ULPSOC/SOC_PERIPH | APB_GPIO |  |  | YES | YES | YES | To be checked | YES | YES | N/A | Florent |  | docs/IP_REFERENCES |  | To be done | To be checked | To be checked |  | Antonio Pullini | antonio.pullini@greenwaves-technologies.com
 | ULPSOC/SOC_PERIPH | APB_FLL_IF |  |  | YES | NO | N/A | N/A | N/A | N/A | N/A
 | ULPSOC/SOC_PERIPH | APB_EFUSE_IF |  |  | YES | YES | YES | To be checked | YES | YES | N/A | Florent |  | docs/IP_REFERENCES |  | To be done | To be checked |  |  | Antonio Pullini | antonio.pullini@greenwaves-technologies.com
 | ULPSOC/SOC_PERIPH | APB_ADV_TIMER |  |  | YES | NO | N/A | N/A | N/A | N/A | N/A |  |  | docs/IP_REFERENCES |  | To be done | To be checked |  |  | Antonio Pullini | antonio.pullini@greenwaves-technologies.com
 | ULPSOC/SOC_PERIPH/APB_ADV_TIMER | TIMER_MODULE (0 to 3) |  |  | YES | NO | N/A | N/A | N/A | N/A | N/A |  |  |  |  |  |  |  |  | Antonio Pullini | antonio.pullini@greenwaves-technologies.com
 | ULPSOC/SOC_PERIPH/APB_ADV_TIMER | ADV_TIMER_APB_IF |  |  | YES | YES | YES | To be checked | YES | YES | N/A | Florent |  |  |  |  |  |  |  | Antonio Pullini | antonio.pullini@greenwaves-technologies.com
 | ULPSOC/SOC_BUS_WRAP | AXI_BUS |  |  | YES | NO | N/A | N/A | To be done | N/A | N/A | Igor | Associated to bus architecture description
 | ULPSOC/SOC_BUS_WRAP | AXI_INTERCONNECT |  |  | YES | NO | N/A | N/A | To be done | N/A | N/A | Igor | Associated to bus architecture description
 | ULPSOC/CLK_RST_GEN | SOC_RSTGEN |  |  | YES | NO | N/A | N/A | N/A | N/A | N/A |  |  |  |  |  |  |  |  | Antonio Pullini | antonio.pullini@greenwaves-technologies.com
 | ULPSOC/CLK_RST_GEN | CLUSTER_RSTGEN |  |  | YES | NO | N/A | N/A | N/A | N/A | N/A |  |  |  |  |  |  |  |  | Antonio Pullini | antonio.pullini@greenwaves-technologies.com
 | ULPSOC/CLK_RST_GEN | SOC_RSTCTRL |  |  | YES | NO | N/A | N/A | N/A | N/A | N/A |  |  |  |  |  |  |  |  | Antonio Pullini | antonio.pullini@greenwaves-technologies.com
 | ULPSOC/CLK_RST_GEN | CLUSTER_RSTCTRL |  |  | YES | NO | N/A | N/A | N/A | N/A | N/A |  |  |  |  |  |  |  |  | Antonio Pullini | antonio.pullini@greenwaves-technologies.com
 | ULPSOC/CLK_RST_GEN | SOC_CG |  |  | YES | NO | N/A | N/A | N/A | N/A | N/A
 | ULPSOC/CLK_RST_GEN | CLUSTER_CG |  |  | YES | NO | N/A | N/A | N/A | N/A | N/A
 | ULPSOC/CLK_RST_GEN | SOC_FLL |  |  | YES | YES | YES | To be checked | YES | YES | N/A | Florent
 | ULPSOC/CLK_RST_GEN | CLUSTER_FLL |  |  | YES | YES | YES | To be checked | YES | YES | N/A | Florent
 | ULPSOC/FC_SUBSYSTEM | PER2AXI |  |  | YES | NO | N/A | N/A | To be done | N/A | N/A | Igor | Associated to bus architecture description
 | ULPSOC/FC_SUBSYSTEM | IC_DEMUX |  |  | YES | NO | N/A | N/A | To be done | N/A | N/A | Igor | Associated to bus architecture description
 | ULPSOC/FC_SUBSYSTEM | RSTGEN (cluster_soc_rstgen) |  |  | YES | NO | N/A | N/A | YES | N/A | N/A | Florent
 | ULPSOC/FC_SUBSYSTEM | TIMER_UNIT |  |  | YES | YES | YES | To be checked | YES | YES | N/A | Florent |  | docs/IP_REFERENCES |  | To be done | To be checked |  |  | Davide Rossi
 | ULPSOC/FC_SUBSYSTEM | FC_TCDM_XBAR |  |  | YES | NO | N/A | N/A | To be done | N/A | N/A | Igor | Associated to bus architecture description
 | ULPSOC/FC_SUBSYSTEM | TCDM_BANK |  |  | YES | YES | YES | N/A | To be done | N/A | N/A
 | ULPSOC/FC_SUBSYSTEM | FC_TCDM_ADDRESS_FILTER |  |  | YES | NO | N/A | N/A | To be done | N/A | N/A | Igor | Associated to bus architecture description
 | ULPSOC/FC_SUBSYSTEM | XBAR_PE (fc_periph_interco) |  |  | YES | NO | N/A | N/A | To be done | N/A | N/A | Igor | Associated to bus architecture description |  |  |  |  |  |  | Igor
 | ULPSOC/FC_SUBSYSTEM | FC_PERIPH_DEMUX |  |  | YES | NO | N/A | N/A | To be done | N/A | N/A | Igor | Associated to bus architecture description
 | ULPSOC/FC_SUBSYSTEM | FC_MPU |  |  | YES | YES | YES | To be checked | YES | YES | N/A | Martin
 | ULPSOC/FC_SUBSYSTEM | FC_ICACHE |  |  | YES | NO | N/A | N/A | N/A | N/A | N/A | Igor |  |  |  |  |  |  |  | Igor & Davide
 | ULPSOC/FC_SUBSYSTEM | FC_ICACHE_CTRL |  |  | YES | YES | YES | To be checked | YES | YES | N/A | Florent
 | ULPSOC/FC_SUBSYSTEM | FC_EVENT_UNIT |  |  | YES | YES | YES | To be checked | YES | YES | N/A | Florent |  | docs/IP_REFERENCES |  | To be done | To be checked | To be checked |  | Andy traburn
 | ULPSOC/FC_SUBSYSTEM | FC_CTRL |  |  | YES | YES | YES | To be checked | YES | YES | N/A | Florent |  | docs/IP_REFERENCES |  | To be done | To be checked | To be checked
 | ULPSOC/FC_SUBSYSTEM | FC_CORE_DEMUX |  |  | YES | NO | N/A | N/A | To be done | N/A | N/A | Igor | Associated to bus architecture description
 | ULPSOC/FC_SUBSYSTEM | RISCV_CORE (FC_CORE) |  |  | YES | YES | YES | To be checked | To be done | to be finished | N/A | Eric/Antonio
 | ULPSOC/FC_SUBSYSTEM | APB_NODE (fc_bus) |  |  | YES | NO | N/A | N/A | To be done | N/A | N/A | Igor | Associated to bus architecture description
 | ULPSOC/FC_SUBSYSTEM | APB2MEM |  |  | YES | NO | N/A | N/A | To be done | N/A | N/A | Igor | Associated to bus architecture description
 | ULPSOC/FC_SUBSYSTEM | APB2PER |  |  | YES | NO | N/A | N/A | To be done | N/A | N/A | Igor | Associated to bus architecture description
 | ULPSOC/FC_SUBSYSTEM | APB2PER_DBG |  |  | YES | NO | N/A | N/A | N/A | N/A | N/A
CLUSTER |  |  |  |  | YES
 | CLUSTER_TRC | ICK_HVT_HSTRCDL (cluster_trc) |  |  | YES | NO | N/A | N/A | To be done | N/A | N/A | Eric/Antonio | Associated to PMU description
 | CLUSTER | DC_TOKEN_RING_FIFO_DOUT (event_dc) |  |  | YES | NO | N/A | N/A | N/A | N/A | N/A | Eric/Antonio
 | CLUSTER | CLUSTER_CLOCK_GATE |  |  | YES | NO | N/A | N/A | N/A | N/A | N/A
 | CLUSTER | TCDM_BANKS (tcdm_sram_island) |  |  | YES | YES | YES | N/A | To be done | N/A | N/A
 | CLUSTER | TCDM_BUS_2x1_ARB |  |  | YES | NO | N/A | N/A | N/A | N/A | N/A
 | CLUSTER | RSTGEN |  |  | YES | NO | N/A | N/A | YES | N/A | N/A | Florent
 | CLUSTER | PER_DEMUX |  |  | YES | NO | N/A | N/A | To be done | N/A | N/A | Igor | Associated to bus architecture description
 | CLUSTER | PER2AXI |  |  | YES | NO | N/A | N/A | To be done | N/A | N/A | Igor | Associated to bus architecture description
 | CLUSTER | MMU |  |  | YES | NO | N/A | N/A | N/A | N/A | N/A |  | NOT IMPLEMENTED IN GAP
 | CLUSTER | ICACHE_TOP_SCM_MP_R5 |  |  | YES | NO | N/A | N/A | N/A | N/A | N/A
 | CLUSTER | HWCE |  |  | YES | YES | YES | To be checked | YES | YES | N/A | Martin |  | docs/IP_REFERENCES |  |  |  |  | gap branch | Francesco Conti | f.conti@unibo.it or fconti@iis.ee.ethz.ch
 | CLUSTER | MCHAN (dmac) |  |  | YES | YES | YES | To be checked | YES | YES | N/A | Florent |  | docs/IP_REFERENCES |  |  |  |  |  | Davide Rossi
 | CLUSTER | PER_DEMUX (debug_interco) |  |  | YES | NO | N/A | N/A | To be done | N/A | N/A | Igor | Associated to bus architecture description
 | CLUSTER | AXI_SLICE_DC_MASTER (data_slave_slice) |  |  | YES | NO | N/A | N/A | N/A | N/A | N/A
 | CLUSTER | AXI_SLICE_DC_SLAVE (data_master_slice) |  |  | YES | NO | N/A | N/A | N/A | N/A | N/A
 | CLUSTER | CORE_REGION (core 0 to 7) |  |  | YES | YES | YES | To be checked | To be done | to be finished | N/A | Eric/Antonio
 | CLUSTER/CORE_REGION | RISCV_CORE |  |  | YES | NO | N/A | To be checked | N/A | N/A | N/A | Eric/Antonio | difference with FC_CORE is that secured mode is not implemented here |  |  |  |  |  |  | Pasquale Davide Schiavone
 | CLUSTER/CORE_REGION | PERIPH_DEMUX |  |  | YES | NO | N/A | N/A | To be done | N/A | N/A | Igor | Associated to bus architecture description
 | CLUSTER/CORE_REGION | CORE_DEMUX |  |  | YES | NO | N/A | N/A | To be done | N/A | N/A | Igor | Associated to bus architecture description
 | CLUSTER/CORE_REGION | CLUSTER_CLOCK_GATING |  |  | YES | NO | N/A | N/A | N/A | N/A | N/A
 | CLUSTER/CLUSTER_PERIPHERALS | NEW_ICACHE_CTRL_UNIT |  |  | YES | YES | YES | To be checked | YES | YES | N/A | Florent |  | docs/IP_REFERENCES |  |  |  |  |  | Igor
+ | CLUSTER/CLUSTER_PERIPHERALS | EVENT_UNIT_FLEX |  |  | YES | YES | YES | To be checked | YES | YES | N/A | Florent |  | docs/IP_REFERENCES |  |  |  |  |  | Florian Glaser
 | CLUSTER/CLUSTER_PERIPHERALS | TIMER_UNIT |  |  | YES | YES | YES | To be checked | YES | YES | N/A | Florent |  | docs/IP_REFERENCES |  | To be done | To be checked |  |  | Davide Rossi
 | CLUSTER/CLUSTER_PERIPHERALS | CLUSTER_CONTROL_UNIT |  |  | YES | YES | YES | To be checked | YES | YES | N/A | Florent |  | docs/IP_REFERENCES |  | To be done | To be checked
 | CLUSTER | CLUSTER_INTERCONNECT |  |  | YES | NO | N/A | N/A | To be done | N/A | N/A | Igor | Associated to bus architecture description
 | CLUSTER/CLUSTER_INTERCONNECT | XBAR_PE |  |  | YES | NO | N/A | N/A | To be done | N/A | N/A | Igor | Associated to bus architecture description
 | CLUSTER/CLUSTER_INTERCONNECT | XBAR_TCDM |  |  | YES | NO | N/A | N/A | To be done | N/A | N/A | Igor | Associated to bus architecture description
 | CLUSTER | AXI_NODE (cluster bus) |  |  | YES | NO | N/A | N/A | To be done | N/A | N/A | Igor | Associated to bus architecture description
 | CLUSTER | CLKGATE_BBMUX_UNIT |  |  | YES
 | CLUSTER | AXI2PER |  |  | YES | NO | N/A | N/A | To be done | N/A | N/A | Igor | Associated to bus architecture description
 | CLUSTER | AXI2MEM |  |  | YES | NO | N/A | N/A | To be done | N/A | N/A | Igor | Associated to bus architecture description
PADFRAME |  | all pads instantiation |  |  | YES | NO | N/A | N/A | To be done | N/A | N/A | Florent

Sheet: MEMMAP_rel1.0.0
IP instance | IP name | IP instance description | Base address | Aliased base address | Length | Description | IP file | IP md file | IP version | IP hierarchy
ALIASED_AREA | ALIASED |  | 0x00000000 |  | 0x00400000 |  | None | None |  | ALIASED
ALIASED_L2_PRI_CH0_SCM | ALIASED_L2_PRI_CH0_SCM |  | 0x00006000 |  | 0x2000 |  | None | None |  | ALIASED
CL_TCDM | CL_TCDM | Cluster L1 RAM (128kB) | 0x10000000 | 0x00000000 | 0x20000 |  | None | None |  | CLUSTER
CL_TEST&SET | CL_TEST&SET |  | 0x10100000 | 0x00100000 | 0x100000 |  | None | None |  | CLUSTER
CL_CTRL_EOC | CLUSTER_CTRL_UNIT |  | 0x10200000 | 0x00200000 | 0x400 |  | docs/IP_REFERENCES/CLUSTER_CRTL_UNIT_reference.xlsx | None | rel1.0.0 | CLUSTER
CL_TIMER_UNIT | BASIC_TIMER | Cluster timer | 0x10200400 | 0x00200400 | 0x400 |  | docs/IP_REFERENCES/BASIC_TIMER_reference.xlsx | None | rel1.0.0 | CLUSTER
CL_EVENT_UNIT | CLUSTER_EU_CORE | Cluster event unit | 0x10200800 |  | 0x800 |  | docs/IP_REFERENCES/CL_EVENT_UNIT_reference.xlsx | None | rel1.0.0 | CLUSTER
CL_ICACHE_CTRL | CL_ICACHE_CTRL |  | 0x10201400 | 0x00201400 | 0x400 |  | docs/IP_REFERENCES/CLUSTER_ICACHE_CTRL_reference.xlsx | None | rel1.0.0 | CLUSTER
DMA | DMA |  | 0X10201C00 | 0X00201C00 | 0x400 |  | docs/IP_REFERENCES/CL_DMA_reference.xlsx | None | rel1.0.0 | CLUSTER
CL_DEMUX_EU | CL_EU_CORE |  | 0x10204000 |  | 0x400 |  | None | None |  | CLUSTER
CL_DEMUX_MCHAN | DMA |  | 0x10204400 |  | 0x400 |  | None | None |  | CLUSTER
CL_CORE0 | CL_RI5CY_DEBUG | Cluster Core 0 (Debug Unit) | 0x10300000 | 0x00300000 | 0x8000 |  | docs/IP_REFERENCES/CL_RI5CY_DEBUG_reference.xlsx | None | rel1.0.0 | CLUSTER
CL_CORE1 | CL_RI5CY_DEBUG | Cluster Core 1 (Debug Unit) | 0x10308000 | 0x00308000 | 0x8000 |  | docs/IP_REFERENCES/CL_RI5CY_DEBUG_reference.xlsx | None | rel1.0.0 | CLUSTER
CL_CORE2 | CL_RI5CY_DEBUG | Cluster Core 2 (Debug Unit) | 0x10310000 | 0x00310000 | 0x8000 |  | docs/IP_REFERENCES/CL_RI5CY_DEBUG_reference.xlsx | None | rel1.0.0 | CLUSTER
CL_CORE3 | CL_RI5CY_DEBUG | Cluster Core 3 (Debug Unit) | 0x10318000 | 0x00318000 | 0x8000 |  | docs/IP_REFERENCES/CL_RI5CY_DEBUG_reference.xlsx | None | rel1.0.0 | CLUSTER
CL_CORE4 | CL_RI5CY_DEBUG | Cluster Core 4 (Debug Unit) | 0x10320000 | 0x00320000 | 0x8000 |  | docs/IP_REFERENCES/CL_RI5CY_DEBUG_reference.xlsx | None | rel1.0.0 | CLUSTER
CL_CORE5 | CL_RI5CY_DEBUG | Cluster Core 5 (Debug Unit) | 0x10328000 | 0x00328000 | 0x8000 |  | docs/IP_REFERENCES/CL_RI5CY_DEBUG_reference.xlsx | None | rel1.0.0 | CLUSTER
CL_CORE6 | CL_RI5CY_DEBUG | Cluster Core 6 (Debug Unit) | 0x10330000 | 0x00330000 | 0x8000 |  | docs/IP_REFERENCES/CL_RI5CY_DEBUG_reference.xlsx | None | rel1.0.0 | CLUSTER
CL_CORE7 | CL_RI5CY_DEBUG | Cluster Core 7 (Debug Unit) | 0x10338000 | 0x00338000 | 0x8000 |  | docs/IP_REFERENCES/CL_RI5CY_DEBUG_reference.xlsx | None | rel1.0.0 | CLUSTER
ROM | ROM | ROM (8kB) | 0x1A000000 |  | 0x4000 |  | None | None |  | ROM
SOC_FLL | FLL | SoC FLL | 0x1A100000 |  | 0x800 |  | docs/IP_REFERENCES/FLL_reference.xlsx | None | rel1.0.0 | SOC_PERIPH
APB_GPIO | APB_GPIO | Apb GPIO | 0x1A101000 |  | 0x1000 |  | docs/IP_REFERENCES/APB_GPIO_reference.xlsx | None | rel1.0.0 | SOC_PERIPH
UDMA | UDMA | Micro DMA | 0x1A102000 |  | 0x2000 |  | None | None |  | SOC_PERIPH
UART | UART | UART Channel | 0x1A102000 |  | 0x80 |  | ips/udma/doc/UART_reference.xlsx | None | rel1.0.0 | SOC_PERIPH/UDMA
SPIM0 | SPIM | SPI Master Channel 0 | 0x1A102080 |  | 0x80 |  | ips/udma/doc/SPIM_reference.xlsx | None | rel1.0.0 | SOC_PERIPH/UDMA
STDIO | STDIO | STDIO Channel | 0x1A102100 |  | 0x80 |  | None | None | rel1.0.0 | SOC_PERIPH/UDMA
I2C0 | I2C | I2C Channel 0 | 0x1A102180 |  | 0x80 |  | ips/udma/doc/I2C_reference.xlsx | None | rel1.0.0 | SOC_PERIPH/UDMA
I2C1 | I2C | I2C Channel 1 | 0x1A102200 |  | 0x80 |  | ips/udma/doc/I2C_reference.xlsx | None | rel1.0.0 | SOC_PERIPH/UDMA
I2S | I2S | I2S Channel 0 | 0x1A102280 |  | 0x100 |  | ips/udma/doc/I2S_reference.xlsx | None | rel1.0.0 | SOC_PERIPH/UDMA
CAM | CAM | CAM channel | 0x1A102380 |  | 0x80 |  | ips/udma/doc/CPI_reference.xlsx | None | rel1.0.0 | SOC_PERIPH/UDMA
UDMA_CTRL | UDMA_CTRL | UDMA control | 0x1A102780 |  | 0x80 |  | ips/udma/doc/UDMA_CTRL_reference.xlsx | None | rel1.0.0 | SOC_PERIPH/UDMA
APB_SOC_CTRL | APB_SOC_CTRL | SoC Control | 0x1A104000 |  | 0x1000 |  | docs/IP_REFERENCES/APB_SOC_CTRL_reference.xlsx | None | rel1.0.0 | SOC_PERIPH
APB_ADV_TIMER | APB_ADV_TIMER | Advanced timers | 0x1A105000 |  | 0x1000 |  | docs/IP_REFERENCES/APB_ADV_TIMER_reference.xlsx | None | rel1.0.0 | SOC_PERIPH
SOC_EVENT_GENERATOR | SOC_EVENT_GENERATOR | SoC Event Generator | 0x1A106000 |  | 0x1000 |  | docs/IP_REFERENCES/SOC_EVENT_GENERATOR_reference.xlsx | None | rel1.0.0 | SOC_PERIPH
DLC_BRIDGE | DLC_BRIDGE |  | 0x1A107000 |  | 0x1000 |  | docs/IP_REFERENCES/DLC_reference.xlsx | None | rel1.0.0 | SOC_PERIPH
SOC_EVENT_UNIT | SOC_EVENT_UNIT | SoC Event Unit | 0x1A109000 |  | 0x2000 |  | None | None | rel1.0.0 | SOC_PERIPH
APB_TIMER_UNIT | APB_TIMER_UNIT | FC timer | 0X1A10B000 |  | 0X1000 |  | docs/IP_REFERENCES/BASIC_TIMER_reference.xlsx | None | rel1.0.0 | SOC_PERIPH
FC_HWPE_UNIT | HWPE | Hw processing element | 0x1A10C000 |  | 0X1000 |  | None | None |  | SOC_PERIPH
STDOUT | STDOUT | Stdout | 0x1A10F000 |  | 0X1000 |  | None | None |  | SOC_PERIPH
DEBUG | DEBUG | FC Debug | 0x1A110000 |  | 0x1000 |  | docs/IP_REFERENCES/FC_RI5CY_DEBUG_reference.xlsx | None | rel1.0.0 | SOC_PERIPH
L2 | L2 | L2 RAM (512kB) | 0x1C000000 |  | 0x800000 |  | None | None |  | L2
L2_PRIVATE_CH0 | L2_PRIVATE_CH0 | L2 RAM PRIVATE CH 0 | 0x1C000000 |  | 0x8000 |  | None | None |  | L2
L2_PRIVATE_CH0_SCM | L2_PRIVATE_CH0_SCM | L2 RAM PRIVATE CH 0 (SCM) | 0x1C006000 |  | 0x2000 |  | None | None |  | L2
L2_PRIVATE_CH1 | L2_PRIVATE_CH1 | L2 RAM PRIVATE CH 1 | 0x1C008000 |  | 0x8000 |  | None | None |  | L2
L2_TCDM_INTERLEAVED | L2_TCDM_INTERLEAVED | L2 RAM INTERLEAVED (TCDM) | 0x1C010000 |  | 0x82000 |  | None | None |  | L2

Sheet: IPNAMEDESC_rel1.0.0
IP name | IP description
L2 | L2 memory
ROM | ROM memory
CL_TCDM | Cluster L1 memory
DMA | DMA
CL_ICACHE_CTRL | Cluster instruction cache control unit
CLUSTER_EU_CORE | Cluster event unit
CL_TIMER_UNIT | Cluster timer
CLUSTER_CTRL_UNIT | Cluster control unit
CL_TEST&SET | Cluster L1 memory test and set unit
ADV_DEBUG | Advanced debug unit
APB_GPIO | GPIO
FLL | FLL
DLC_BRIDGE | PMU DLC bridge
UDMA_CTRL | uDMA control unit
UART | uDMA UART interface
MEMCPY | uDMA MEMCPY interface
SPIM | uDMA SPI master interface
I2S | uDMA I2S interface
I2C | uDMA I2C interface
CPI | uDMA CPI interface
APB_SOC_CTRL | SoC control unit
APB_ADV_TIMER | Advanced timer
APB_FLL_IF | SoC and cluster FLL unit
SOC_EVENT_GENERATOR | SoC event generator
BASIC_TIMER | Basic timer
FC_TCDM | FC TCDM memory
FC_CTRL | FC control unit
CL_RI5CY_DEBUG | Cluster RISCY core
ALIASED | Aliased memory map area
FC_TIMER_UNIT | FC timer
HWPE | Hardware processing element
STDIO | Standard I/O
SOC_EVENT_UNIT | FC_event_unit

Sheet: IPHIERARCHY_rel1.0.0
Name | Description | Base address | End address
ALIASED | Aliased Memory Area | 0x00000000 | 0x003FFFFF
SOC_PERIPH | SoC Peripherals Subsystem | 0x1A100000 | 0x1A10FFFF
UDMA | MicroDMA Subsystem | 0x1A102000 | 0x1A102FFF
FC_SUBSYSTEM | Fabric Controller Subsystem | 0x1B000000 | 0x1B3FFFFF
CLUSTER | Cluster Subsystem | 0x10000000 | 0x103FFFFF
L2 | L2 Memory | 0x1C000000 | 0x1FFFFFFF
ROM | ROM Memory | 0x1A000000 | 0x1A0FFFFF

Sheet: PADFRAME_rel1.0.0
 | Power Domain | Pad Number | Package Pad Position | Name | VDDIO GROUP | Cell Type | Driving Strength | SlewRate controll | Schmitt Trigger | PU | PD | default func | Direction default | Alternate 1 | Direction 1 | Alternate 2 | Direction 2 | Alternate 3 | Direction 3 | SCAN | Direction | FMC boards | DS & PE config Index
LVDS Interface | LVDS (2.5V) | 0 | B20 | pad_rf_txd_p | VDDIO_lvds | LDP_OU_675_25V_T |  |  |  |  |  | rf_txd_p | O |  |  |  |  |  |  |  |  | Chartreuse
 |  | 1 | A22 | pad_rf_txd_n | VDDIO_lvds |  |  |  |  |  |  | rf_txd_n | O |  |  |  |  |  |  |  |  | Chartreuse
 |  | 2 | B19 | pad_rf_txclk_p | VDDIO_lvds | LDP_OU_675_25V_T |  |  |  |  |  | rf_txclk_p | O |  |  |  |  |  |  |  |  | Chartreuse
 |  | 3 | A21 | pad_rf_txclk_n | VDDIO_lvds |  |  |  |  |  |  | rf_txclk_n | O |  |  |  |  |  |  |  |  | Chartreuse
 |  | 4 | A19 | pad_rf_rxd_p | VDDIO_lvds | LDP_IN_675_25V_DN |  |  |  |  |  | rf_rxd_p | I |  |  |  |  |  |  |  |  | Chartreuse
 |  | 5 | B18 | pad_rf_rxd_n | VDDIO_lvds |  |  |  |  |  |  | rf_rxd_n | I |  |  |  |  |  |  |  |  | Chartreuse
 |  | 6 | A18 | pad_rf_rxclk_p | VDDIO_lvds | LDP_IN_675_25V_DN |  |  |  |  |  | rf_rxclk_p | I |  |  |  |  |  |  |  |  | Chartreuse
 |  | 7 | B17 | pad_rf_rxclk_n | VDDIO_lvds |  |  |  |  |  |  | rf_rxclk_n | I |  |  |  |  |  |  |  |  | Chartreuse
 | PD CAM (1.8V-2.5V-3.3V) | 8 | A4 | pad_rf_miso | cam_VDDIO | PDDW0812CDG | 0812 | NO | NO | NO | YES | spim1_miso | I | gpioA0 | IO |  |  |  |  |  |  | Chartreuse | 0
 |  | 9 | B3 | pad_rf_mosi | cam_VDDIO | PDDW0812CDG | 0812 | NO | NO | NO | YES | spim1_mosi | O | gpioA1 | IO |  |  |  |  |  |  | Chartreuse | 1
 |  | 10 | A5 | pad_rf_csn | cam_VDDIO | PDDW0812CDG | 0812 | NO | NO | NO | YES | spim1_cs0 | O | gpioA2 | IO | i2c1_sda | IO |  |  |  |  | Chartreuse | 2
 |  | 11 | B4 | pad_rf_sck | cam_VDDIO | PDDW0812SCDG | 0812 | NO | YES | NO | YES | spim1_sck | O | gpioA3 | IO | i2c1_scl | IO |  |  |  |  | Chartreuse | 3
 |  | 12 | A3 | pad_rf_pactrl0 | cam_VDDIO | PDDW0812CDG | 0812 | NO | NO | NO | YES | orca_txsync | I | gpioA0 | IO | spim1_cs0 | O |  |  |  |  | Chartreuse | 4
 |  | 13 | B2 | pad_rf_pactrl1 | cam_VDDIO | PDDW0812CDG | 0812 | NO | NO | NO | YES | orca_rxsync | I | gpioA1 | IO | spim1_cs1 | O |  |  |  |  | Chartreuse | 5
 |  | 14 | A2 | pad_rf_pactrl2 | cam_VDDIO | PDDW0812CDG | 0812 | NO | NO | NO | YES | orca_txi | O | gpioA2 | IO |  |  |  |  |  |  | Chartreuse | 6
 |  | 15 | B1 | pad_rf_pactrl3 | cam_VDDIO | PDDW0812CDG | 0812 | NO | NO | NO | YES | orca_txq | O | gpioA3 | IO |  |  |  |  |  |  | Chartreuse | 7
 |  | 16 | A44 | pad_rf_pactrl4 | cam_VDDIO | PDDW0812CDG | 0812 | NO | NO | NO | YES | orca_rxi | I | gpioA4 | IO | spis0_sdio0 | IO | spis0_sdio2 | IO | IN OSI_DFT_ICG_SE | I | Chartreuse | 8
 |  | 17 | B40 | pad_rf_pactrl5 | cam_VDDIO | PDDW0812CDG | 0812 | NO | NO | NO | YES | orca_rxq | I | gpioA5 | IO | spis0_sdio1 | IO | spis0_sdio3 | IO | IN OSI_DFT_SE | I | Chartreuse | 9
Camera Interface |  | 18 | A43 | pad_cam_pclk | cam_VDDIO | PDDW0812SCDG | 0812 | NO | YES | NO | YES | cam_pclk | I | gpioA4 | IO | timer1_ch0 | O |  |  | OUT soc edt channels out 1 | O | Sensor | 10
 |  | 19 | A37 | pad_cam_hsync | cam_VDDIO | PDDW0812CDG | 0812 | NO | NO | NO | YES | cam_hsync | I | gpioA5 | IO | timer1_ch1 | O |  |  | Spare | IO | Sensor | 11
 |  | 20 | B39 | pad_cam_data0 | cam_VDDIO | PDDW0812CDG | 0812 | NO | NO | NO | YES | cam_data0 | I | gpioA6 | IO | timer1_ch2 | O |  |  | IN slow_clk5 | I | Sensor | 12
 |  | 21 | A42 | pad_cam_data1 | cam_VDDIO | PDDW0812CDG | 0812 | NO | NO | NO | YES | cam_data1 | I | gpioA7 | IO | timer1_ch3 | O |  |  | IN slow_clk6 | I | Sensor | 13
 |  | 22 | B38 | pad_cam_data2 | cam_VDDIO | PDDW0812CDG | 0812 | NO | NO | NO | YES | cam_data2 | I | gpioA8 | IO | timer2_ch0 | O |  |  | IN slow_clk7 | I | Sensor | 14
 |  | 23 | A41 | pad_cam_data3 | cam_VDDIO | PDDW0812CDG | 0812 | NO | NO | NO | YES | cam_data3 | I | gpioA9 | IO | timer2_ch1 | O |  |  | IN osi_dft_occ_sdi | I | Sensor | 15
 |  | 24 | B37 | pad_cam_data4 | cam_VDDIO | PDDW0812CDG | 0812 | NO | NO | NO | YES | cam_data4 | I | gpioA10 | IO | timer2_ch2 | O |  |  | IN soc edt channels_in 0 | I | Sensor | 16
 |  | 25 | A40 | pad_cam_data5 | cam_VDDIO | PDDW0812CDG | 0812 | NO | NO | NO | YES | cam_data5 | I | gpioA11 | IO | timer2_ch3 | O |  |  | IN soc edt channels_in 1 | I | Sensor | 17
 |  | 26 | B36 | pad_cam_data6 | cam_VDDIO | PDDW0812CDG | 0812 | NO | NO | NO | YES | cam_data6 | I | gpioA12 | IO | timer3_ch0 | O |  |  | IN top edt channels in | I | Sensor | 18
 |  | 27 | A38 | pad_cam_data7 | cam_VDDIO | PDDW0812CDG | 0812 | NO | NO | NO | YES | cam_data7 | I | gpioA13 | IO | timer3_ch1 | O |  |  | OUT top edt channels out | O | Sensor | 19
 |  | 28 | A36 | pad_cam_vsync | cam_VDDIO | PDDW0812CDG | 0812 | NO | NO | NO | YES | cam_vsync | I | gpioA14 | IO | timer3_ch2 | O |  |  | Spare | IO | Sensor | 20
 |  | 29 | B34 | pad_cam_sda | cam_VDDIO | PDDW0812CDG | 0812 | NO | NO | NO | YES | i2c1_sda | IO | gpioA15 | IO | timer3_ch3 | O |  |  | IN slow_clk4 | I | Sensor | 21
V |  | 30 | D1 | pad_cam_scl | cam_VDDIO | PDDW0812SCDG | 0812 | NO | YES | NO | YES | i2c1_scl | IO | gpioA16 | IO | orca_clk | I |  |  | OUT osi_dft_occ_sdo | O | Sensor | 22
TIMER | PD GPIO (1.8V-2.5V-3.3) | 31 | B11 | pad_timer0_ch0 | spim_VDDIO | PDDW0812CDG | 0812 | NO | NO | NO | YES | timer0_ch0 | O | gpioA17 | IO |  |  |  |  | Spare | IO | Sensor | 23
 |  | 32 | A13 | pad_timer0_ch1 | spim_VDDIO | PDDW0812CDG | 0812 | NO | NO | NO | YES | timer0_ch1 | O | gpioA18 | IO | timer1_ch0 | O |  |  | Spare | IO | Sensor | 24
 |  | 33 | B12 | pad_timer0_ch2 | spim_VDDIO | PDDW0812CDG | 0812 | NO | NO | NO | YES | timer0_ch2 | O | gpioA19 | IO | timer2_ch0 | O |  |  |  |  | Sensor | 25
 |  | 34 | A14 | pad_timer0_ch3 | spim_VDDIO | PDDW0812CDG | 0812 | NO | NO | NO | YES | timer0_ch3 | O | gpioA20 | IO | timer3_ch0 | O |  |  |  |  | Sensor | 26
I2S1 |  | 35 | B13 | pad_i2s1_sck | spim_VDDIO | PDDW0812SCDG | 0812 | NO | YES | NO | YES | i2s1_sck | IO | gpioA21 | IO | spis0_sck | I | i2s1_sdi | I | IN slow_clk1 | I | Sensor | 27
 |  | 36 | A15 | pad_i2s1_ws | spim_VDDIO | PDDW0812CDG | 0812 | NO | NO | NO | YES | i2s1_ws | IO | gpioA22 | IO | spis0_cs | I | hyper_ckn | O | IN slow_clk3 | I | Sensor | 28
 |  | 37 | B14 | pad_i2s1_sdi | spim_VDDIO | PDDW0812CDG | 0812 | NO | NO | NO | YES | i2s1_sdi | I | gpioA23 | IO | spis0_sdio2 | IO | hyper_ck | O | IN slow_clk2 | I | Sensor | 29
UART |  | 38 | B6 | pad_uart_rx | spim_VDDIO | PDUW0812CDG | 0812 | NO | NO | YES | NO | uart_rx | I | gpioA24 | IO |  |  |  |  | Spare | IO | Sensor | 30
 |  | 39 | A7 | pad_uart_tx | spim_VDDIO | PDUW0812CDG | 0812 | NO | NO | YES | NO | uart_tx | O | gpioA25 | IO |  |  |  |  | Spare | IO | Sensor | 31
SPIM0 |  | 40 | D2 | pad_spim0_sdio0 (mosi) | spim_VDDIO | PDDW0812CDG | 0812 | NO | NO | NO | YES | spim0_sdio0 | IO |  |  |  |  | hyper_dq[0] | IO |  |  | Sensor | 32
 |  | 41 | A11 | pad_spim0_sdio1 (miso) | spim_VDDIO | PDDW0812CDG | 0812 | NO | NO | NO | YES | spim0_sdio1 | IO |  |  |  |  | hyper_dq[1] | IO |  |  | Sensor | 33
 |  | 42 | B10 | pad_spim0_sdio2 | spim_VDDIO | PDDW0812CDG | 0812 | NO | NO | NO | YES | spim0_sdio2 | IO | gpioA26 | IO | i2c1_sda | IO | hyper_dq[2] | IO |  |  | Sensor | 34
 |  | 43 | A10 | pad_spim0_sdio3 | spim_VDDIO | PDDW0812SCDG | 0812 | NO | YES | NO | YES | spim0_sdio3 | IO | gpioA27 | IO | i2c1_scl | IO | hyper_dq[3] | IO |  |  | Sensor | 35
 |  | 44 | B8 | pad_spim0_csn0 | spim_VDDIO | PDDW0812CDG | 0812 | NO | NO | NO | YES | spim0_cs0 | O |  |  |  |  | hyper_dq[4] | IO |  |  | Sensor | 36
 |  | 45 | A8 | pad_spim0_csn1 | spim_VDDIO | PDDW0812CDG | 0812 | NO | NO | NO | YES | spim0_cs1 | O | gpioA28 | IO | spis0_sdio3 | IO | hyper_dq[5] | IO |  |  | Sensor | 37
 |  | 46 | B7 | pad_spim0_sck | spim_VDDIO | PDDW0812SCDG | 0812 | NO | YES | NO | YES | spim0_sck | O |  |  |  |  | hyper_dq[6] | IO |  |  | Sensor | 38
SPIM1 |  | 47 | A9 | pad_spis0_csn | spim_VDDIO | PDDW0812CDG | 0812 | NO | NO | NO | YES | spis0_cs | I | gpioA29 | IO | spim1_cs0 | O | hyper_dq[7] | IO | OUT cluster edt channels out 0 | O | Sensor | 39
 |  | 48 | B15 | pad_spis0_miso | spim_VDDIO | PDDW0812CDG | 0812 | NO | NO | NO | YES | spis0_sdio0 | IO | gpioA30 | IO | spim1_cs1 | O | hyper_csn0 | O | OUT cluster edt channels out 1 | O | Sensor | 40
 |  | 49 | A16 | pad_spis0_mosi | spim_VDDIO | PDDW0812CDG | 0812 | NO | NO | NO | YES | spis0_sdio1 | IO | gpioA31 | IO |  |  | hyper_csn1 | O | OUT soc edt channels out 0 | O | Sensor | 41
 |  | 50 | B9 | pad_spis0_sck | spim_VDDIO | PDUW0204CDG | 0204 | NO | NO | YES | NO | spis0_sck | I |  |  |  |  | hyper_rwds | IO |  |  | Sensor | 42
 | XTAL PD | 51 | A32 | pad_xtal_in | xtal_AVDD,xtal_AVSS |  |  |  |  |  |  | xtal_in | I
 |  | 52 | B30 | pad_xtal_out | xtal_AVDD,xtal_AVSS |  |  |  |  |  |  | xtal_out | O
I2C | SAFE PD (1.8V- 2.5V-3.3V) | 53 | B22 | pad_i2c0_sda | safe_VDDIO | PDDW0812CDG | 0812 | NO | NO | NO | YES | i2c0_sda | IO |  |  |  |  |  |  | IN cluster_edt_channels_in_1 | I | Sensor | 43
 |  | 54 | A25 | pad_i2c0_scl | safe_VDDIO | PDDW0812SCDG | 0812 | NO | NO | NO | YES | i2c0_scl | IO |  |  |  |  |  |  | IN cluster_edt_channels_in_0 | I | Sensor | 44
I2S0 |  | 55 | A24 | pad_i2s0_sck | safe_VDDIO | PDDW0812SCDG | 0812 | NO | YES | NO | YES | i2s0_sck | IO |  |  |  |  |  |  | IN osi_dft_scan_reset | I | Sensor | 45
 |  | 56 | A26 | pad_i2s0_ws | safe_VDDIO | PDDW0812CDG | 0812 | NO | NO | NO | YES | i2s0_ws | IO |  |  |  |  |  |  | IN edt_Update | I | Sensor | 46
 |  | 57 | B23 | pad_i2s0_sdi | safe_VDDIO | PDDW0812CDG | 0812 | NO | NO | NO | YES | i2s0_sdi | I |  |  |  |  |  |  | IN edt_Clock | I | Sensor | 47
 |  | 58 | A23 | pad_reset_n | safe_VDDIO | PDUW0204SCDG | 0204 | NO | YES | YES | NO | reset_n | I |  |  |  |  |  |  |  |  | zc706 connector
DEBUG |  | 59 | B25 | pad_jtag_tck | safe_VDDIO | PDUW0204SCDG | 0204 | NO | YES | YES | NO | jtag_tck | I |  |  |  |  |  |  |  |  | zc706 connector
 |  | 60 | A28 | pad_jtag_tdi | safe_VDDIO | PDUW0204CDG | 0204 | NO | NO | YES | NO | jtag_tdi | I |  |  |  |  |  |  |  |  | zc706 connector
 |  | 61 | B26 | pad_jtag_tdo | safe_VDDIO | PDDW0812CDG | 0204 | NO | NO | NO | YES | jtag_tdo | O |  |  |  |  |  |  |  |  | zc706 connector
 |  | 62 | A29 | pad_jtag_tms | safe_VDDIO | PDUW0204CDG | 0204 | NO | NO | YES | NO | jtag_tms | I |  |  |  |  |  |  |  |  | zc706 connector
 |  | 63 | B27 | pad_jtag_trst | safe_VDDIO | PDUW0204SCDG | 0204 | NO | YES | YES | NO | jtag_trst | I |  |  |  |  |  |  |  |  | zc706 connector
 | CORE PD | 64 | A33 | RAR_AVS |  |  |  |  |  |  |  | RAR_AVS
 |  | 65 | A34 | RAR_AVD |  |  |  |  |  |  |  | RAR_AVD
 |  | 66 | A35 | RAR_VSENSE |  |  |  |  |  |  |  | RAR_VSENSE
 |  | 67 | B31 | RAR_AVDPWR |  |  |  |  |  |  |  | RAR_AVDPWR
 |  | 68 | B32 | RAR_GNDSENSE |  |  |  |  |  |  |  | RAR_GNDSENSE
 |  | 69 | D4 | RAR_LX |  |  |  |  |  |  |  | RAR_LX
 |  | 70 | B5 | VDD_ext_cluster |  |  |  |  |  |  |  | VDD_ext_cluster
 |  | 71 | B16 | VDD_ext_cluster |  |  |  |  |  |  |  | VDD_ext_cluster
 |  | 72 | B35 | VDD_ext_cluster |  |  |  |  |  |  |  | VDD_ext_cluster
 |  | 74 | A6 | VDD_ext_cluster |  |  |  |  |  |  |  | VDD_ext_cluster
 |  | 75 | A17 | VDD |  |  |  |  |  |  |  | VDD
 |  | 76 | A30 | VDD |  |  |  |  |  |  |  | VDD
 |  | 77 | B33 | VDD |  |  |  |  |  |  |  | VDD
 | PD CAM (2.5V-3.3V) | 78 | A1 | cam_VDDIO |  |  |  |  |  |  |  | cam_VDDIO
 |  | 79 | A39 | cam_VDDIO |  |  |  |  |  |  |  | cam_VDDIO
 | PD GPIO (1.8V-2.5V-3.3) | 80 | A12 | spim_VDDIO |  |  |  |  |  |  |  | spim_VDDIO
 |  | 81 | A27 | safe_VDDIO |  |  |  |  |  |  |  | safe_VDDIO
 | LVDS (2.5V) | 82 | D3 | VDDIO_lvds |  |  |  |  |  |  |  | VDDIO_lvds
 | XTAL PD | 83 | A31 | xtal_AVSS |  |  |  |  |  |  |  | xtal_AVSS
 |  | 84 | B29 | xtal_AVDD |  |  |  |  |  |  |  | xtal_AVDD
 |  | 85 | A20 | VDD_lvds1p2v |  |  |  |  |  |  |  | VDD_lvds_1p2v
 |  | 86 | B28 | VQPS |  |  |  |  |  |  |  | VQPS
 |  | 87 | B24 | pad_jtag_tapsel_en | safe_VDDIO |  |  |  |  |  |  | jtag_tapsel_en | I
 |  | 73 | B21 | VSS |  |  |  |  |  |  |  | VSS

Sheet: EFUSELIST_rel1.0.0
Setting Name | Register number | Size | Description | Comment
INFO | 0 | 8 | Info register 1
INFO2 | 1 | 8 | Info register 2
AES_KEY | 2 | 128 | Secure boot AES key
AES_IV | 18 | 128 | Secure boot AES IV
WAIT_XTAL_DELTA | 26 | 16 | XTAL delta threshold | A fixed point Q15 fraction. The variation between 2 consecutive measurement should not be higher than this percentage.
WAIT_XTAL_MIN | 28 | 8 | XTAL minimum stabilization time
WAIT_XTAL_MAX | 29 | 8 | XTAL maximum stabilization time
HYPER_RDS_DELAY | 30 | 8 | HyperFlash read delay
FLL_FREQ | 31 | 8 | FLL frequency
FLL_TOLERANCE | 32 | 8 | FLL tolerance
FLL_ASSERT_CYCLES | 33 | 8 | FLL assert cycles
RESERVED | 35 | 48 | Reserved for future use
USER | 40 | 704 | Free for application use

Sheet: EFUSEMAP_rel1.0.0
Bit field | Setting Name | Bit Position | Size | Description
PLT | INFO | 0 | 3 | Platform type: - 3'b000: Other - 3'b001: FPGA - 3'b010: RTL - 3'b011: VP - 3'b100: Chip
BOOT | INFO | 3 | 3 | Platform type: - 3'b000: Other - 3'b001: SPIS_ALT2 - 3'b010: JTAG - 3'b011: SPIS_DFLT - 3'b100: PRELOAD - 3'b101: HYPER - 3'b110: SPIM - 3'b111: SPIM_QPI
ENCRYPTED | INFO | 6 | 1 | Encrypted boot code: - 1'b0: Not encrypted - 1'b1: Encrypted
WAIT_XTAL | INFO | 7 | 1 | Wait for clock to settle: - 1'b0: Don't wait - 1'b1: Wait
FLL_FREQ_SET | INFO2 | 0 | 1 | Set FLL frequency: - 1'b0: Don't set - 1'b1: Set
FLL_CONF | INFO2 | 1 | 1 | Configure FLL: - 1'b0: Don't configure - 1'b1: Configure
FLL_BYPASS_LOCK | INFO2 | 2 | 1 | Gate FLL output: - 1'b0: Don't gate - 1'b1: Gate
SPIM_CLKDIV | INFO2 | 3 | 1 | SPIM clock division factor - 1'b0: 1 - 1'b1: 2
LSB | WAIT_XTAL_DELTA | 8 | 8 | LSB of delta
MSB | WAIT_XTAL_DELTA | 0 | 8 | MSB of delta
TIME | WAIT_XTAL_MIN | 0 | 8 | Minimum time that the clock must be under the threshold to be considered stable.
TIME | WAIT_XTAL_MAX | 0 | 8 | Maximum amount of time to wait for clock stabilization

Sheet: IPEVENTS_rel1.0.0
Event sheet name | Version | Associated IP hierarchy | Description | Hide
SOC_PERIPH_EVENTS | rel1.0.0 | SOC_PERIPH | Events generated by all SoC peripherals
UDMA_SUBSYSTEM_EVENTS | rel1.0.0 | SOC_PERIPH/UDMA | Events generated by uDMA interfaces | Not relevant for datasheet
FC_SUBSYSTEM_EVENTS | rel1.0.0 | FC_SUBSYSTEM | Events managed by FC event unit
CLUSTER_EVENTS | rel1.0.0 | CLUSTER | Events managed by Cluster event unit

Sheet: SOC_PERIPH_EVENTS_rel1.0.0
Event number | Event name | IP instance name | Description | Direction | Hide
0 | UART_RX_EVT | UART | uDMA UART RX channel transfer done event | Input
1 | UART_TX_EVT | UART | uDMA UART TX channel transfer done event | Input
2 | SPIM0_RX_EVT | SPIM0 | uDMA SPIM1 RX channel transfer done event | Input
3 | SPIM0_TX_EVT | SPIM0 | uDMA SPIM1 TX channel transfer done event | Input
4 | STDIO_RX_EVT | STDIO | uDMA SDIO TX channel transfer done event | Input
5 | STDIO_TX_EVT | STDIO | uDMA SDIO RX channel transfer done event | Input
6 | I2C0_RX_EVT | I2C0 | uDMA I2C0 RX channel transfer done event | Input
7 | I2C0_TX_EVT | I2C0 | uDMA I2C0 TX channel transfer done event | Input
8 | I2C1_RX_EVT | I2C1 | uDMA I2C1 RX channel transfer done event | Input
9 | I2C1_TX_EVT | I2C1 | uDMA I2C1 TX channel transfer done event | Input
10 | Reserved |  | Reserved
11 | Reserved |  | Reserved
12 | CPI_RX_EVT | CAM | uDMA CPI RX channel transfer done event | Input
13 | CPI_EVT | CAM | uDMA CPI channel event | Input
14 | Reserved |  | Reserved
15 | Reserved |  | Reserved
16 | Reserved |  | Reserved
17 | Reserved |  | Reserved
18 | Reserved |  | Reserved
19 | Reserved |  | Reserved
20 | I2S_EVT | I2S | uDMA I2S channel event | Input
21 | I2S_CH1_RX_EVT | I2S | uDMA I2S TX channel transfer done event | Input
22 | UART_EVT | UART | uDMA SPIM0 End of Transaction event | Input
23 | SPIM0_EOT_EVT | SPIM0 | uDMA SPIM0 End of Transaction event | Input
24 | Reserved |  | Reserved
25 | I2C0_EVT | I2C0 | uDMA I2C0 channel event | Input
26 | I2C1_EVT | I2C0 | uDMA I2C1 channel event | Input
27 | I2S_CH0_RX_EVT | I2S | uDMA I2S RX channel transfer done event | Input
28 | Reserved |  | Reserved
29 | Reserved |  | Reserved
30 | Reserved |  | Reserved
31 | Reserved |  | Reserved
32 | Reserved |  | Reserved
33 | Reserved |  | Reserved
34 | Reserved |  | Reserved
35 | Reserved |  | Reserved
36 | Reserved |  | Reserved
37 | Reserved |  | Reserved
38 | ADV_TIMER_EVT_0 | APB_ADV_TIMER | ADV_TIMER event 0 | Input
39 | ADV_TIMER_EVT_1 | APB_ADV_TIMER | ADV_TIMER event 1 | Input
40 | ADV_TIMER_EVT_2 | APB_ADV_TIMER | ADV_TIMER event 2 | Input
41 | ADV_TIMER_EVT_3 | APB_ADV_TIMER | ADV_TIMER event 3 | Input
42 | GPIO_EVT | APB_GPIO | GPIO event | Input
43 | Reserved |  | Reserved
44 | Reserved |  | Reserved
45 | Reserved |  | Reserved
46 | HWPE_EVT_0 | FC_HWPE_UNIT | Hwpe event 0 | Input
47 | HWPE_EVT_1 | FC_HWPE_UNIT | Hwpe event 1 | Input

Sheet: UDMA_SUBSYSTEM_EVENTS_rel1.0.0
Event number | Event name | IP instance name | Description | Direction | Hide
0 | Reserved |  | Reserved
1 | Reserved |  | Reserved
2 | Reserved |  | Reserved
3 | Reserved |  | Reserved
4 | UART_TX_EVT | UART | uDMA UART TX channel transfer done event | Output
5 | UART_RX_EVT | UART | uDMA UART RX channel transfer done event | Output
6 | UART_EVT | UART | uDMA SPIM0 End of Transaction event | Output
7 | SPIM0_TX_EVT | SPIM0 | uDMA SPIM0 TX channel transfer done event | Output
8 | SPIM0_RX_EVT | SPIM0 | uDMA SPIM0 RX channel transfer done event | Output
9 | SPIM0_EVT | SPIM0 | uDMA SPIM0 End of Transaction event | Output
10 | SDIO_TX_EVT | SDIO | uDMA SDIO TX channel transfer done event | Output
11 | SDIO_RX_EVT | SDIO | uDMA SDIO RX channel transfer done event | Output
12 | Reserved |  | Reserved
13 | I2C0_TX_EVT | I2C0 | uDMA I2C0 TX channel transfer done event | Output
14 | I2C0_RX_EVT | I2C0 | uDMA I2C0 RX channel transfer done event | Output
15 | I2C0_EVT | I2C0 | uDMA I2C0 channel event | Output
16 | I2C1_TX_EVT | I2C1 | uDMA I2C1 TX channel transfer done event | Output
17 | I2C1_RX_EVT | I2C1 | uDMA I2C1 RX channel transfer done event | Output
18 | I2C1_EVT | I2C1 | uDMA I2C1 channel event | Output
19 | Reserved |  | Reserved
20 | Reserved |  | Reserved
21 | I2S_CH0_RX_EVT | I2S | uDMA I2S RX channel transfer done event | Output
22 | I2S_CH1_RX_EVT | I2S | uDMA I2S TX channel transfer done event | Output
23 | I2S_EVT | I2S | uDMA I2S channel event | Output
24 | CPI_RX_EVT | CAM | uDMA CPI RX channel transfer done event | Output
25 | CPI_EVT | CAM | uDMA CPI channel event | Output
26 | Reserved |  | Reserved
27 | Reserved |  | Reserved
28 | Reserved |  | Reserved

Sheet: FC_SUBSYSTEM_EVENTS_rel1.0.0
Event number | Event name | IP instance name | Description | Direction
0 | SW_EVT_0 | FC_CORE | Software event 0 from FC_CORE or FC interconnect | Input
1 | SW_EVT_1 | FC_CORE | Software event 1 from FC_CORE or FC interconnect | Input
2 | SW_EVT_2 | FC_CORE | Software event 2 from FC_CORE or FC interconnect | Input
3 | SW_EVT_3 | FC_CORE | Software event 3 from FC_CORE or FC interconnect | Input
4 | SW_EVT_4 | FC_CORE | Software event 4 from FC_CORE or FC interconnect | Input
5 | SW_EVT_5 | FC_CORE | Software event 5 from FC_CORE or FC interconnect | Input
6 | SW_EVT_6 | FC_CORE | Software event 6 from FC_CORE or FC interconnect | Input
7 | SW_EVT_7 | FC_CORE | Software event 7 from FC_CORE or FC interconnect | Input
8 | uDMA_EVT | uDMA | uDMA event | Input
9 | DMA_IRQ | uDMA | Interrupt request from uDMA | Input
10 | FC_TIMER_LO_EVT | FC_TIMER_UNIT | FC timer low event | Input
11 | FC_TIMER_HI_EVT | FC_TIMER_UNIT | FC timer high event | Input
12 | Reserved |  | Reserved
13 | Reserved |  | Reserved
14 | Reserved |  | Reserved
15 | GPIO_EVT | APB_GPIO | GPIO event | Input
16 | Reserved |  | Reserved
17 | ADV_TIMER_EVT_0 | APB_ADV_TIMER | ADV_TIMER event 0 | Input
18 | ADV_TIMER_EVT_1 | APB_ADV_TIMER | ADV_TIMER event 1 | Input
19 | ADV_TIMER_EVT_2 | APB_ADV_TIMER | ADV_TIMER event 2 | Input
20 | ADV_TIMER_EVT_3 | APB_ADV_TIMER | ADV_TIMER event 3 | Input
21 | Reserved |  | Reserved
22 | Reserved |  | Reserved
23 | Reserved |  | Reserved
24 | Reserved |  | Reserved
25 | Reserved |  | Reserved
26 | Reserved |  | Reserved
27 | Reserved |  | Reserved
28 | Reserved |  | Reserved
29 | FC_ERR_EVT | SOC_EVENT_GENERATOR | Fabric Controller error event | Input
30 | HP_EVT_0 | SOC_EVENT_GENERATOR | High priority event 0 | Input
31 | HP_EVT_1 | SOC_EVENT_GENERATOR | High priority event 1 | Input

Sheet: CLUSTER_EVENTS_rel1.0.0
Event number | Event name | IP instance name | Description | Direction
0 | SW_EVT_0 | [Cluster RISCY cores](#cluster_cl_ri5cy_debug) | Software event 0 from one of the CL_COREs | Input
1 | SW_EVT_1 | [Cluster RISCY cores](#cluster_cl_ri5cy_debug) | Software event 1 from one of the CL_COREs | Input
2 | SW_EVT_2 | [Cluster RISCY cores](#cluster_cl_ri5cy_debug) | Software event 2 from one of the CL_COREs | Input
3 | SW_EVT_3 | [Cluster RISCY cores](#cluster_cl_ri5cy_debug) | Software event 3 from one of the CL_COREs | Input
4 | SW_EVT_4 | [Cluster RISCY cores](#cluster_cl_ri5cy_debug) | Software event 4 from one of the CL_COREs | Input
5 | SW_EVT_5 | [Cluster RISCY cores](#cluster_cl_ri5cy_debug) | Software event 5 from one of the CL_COREs | Input
6 | SW_EVT_6 | [Cluster RISCY cores](#cluster_cl_ri5cy_debug) | Software event 6 from one of the CL_COREs | Input
7 | SW_EVT_7 | [Cluster RISCY cores](#cluster_cl_ri5cy_debug) | Software event 7 from one of the CL_COREs | Input
8 | DMA_EVT_0 | DMA | DMA event 0 | Input
9 | DMA_EVT_1 | DMA | DMA event 1 | Input
10 | CL_TIMER_LO_EVT | CL_TIMER_UNIT | Cluster basic timer low event | Input
11 | CL_TIMER_HI_EVT | CL_TIMER_UNIT | Cluster basic timer high event | Input
12 | Reserved |  | Reserved | Input
13 | Reserved |  | Reserved | Input
14 | Reserved |  | Reserved
15 | Reserved |  | Reserved
16 | BARRIER_EVT | CL_EVENT_UNIT | Barrier event | Input
17 | MUTEX_EVT | CL_EVENT_UNIT | Mutex event | Input
18 | DISPATCHER_EVT | CL_EVENT_UNIT | Dispatcher event | Input
19 | Reserved |  | Reserved
20 | Reserved |  | Reserved
21 | Reserved |  | Reserved
22 | Reserved |  | Reserved
23 | Reserved |  | Reserved
24 | Reserved |  | Reserved
25 | Reserved |  | Reserved
26 | Reserved |  | Reserved
27 | SOC_PERIPH_EVT | SOC_EVENT_GENERATOR | SoC peripheral event | Input
28 | Reserved |  | Reserved
29 | Reserved |  | Reserved
30 | Reserved |  | Reserved
31 | Reserved |  | Reserved

Sheet: INSTEXTCAT_rel1.0.0
Name | Description | Extra notes
COMPLEX | Complex number operations | *Complex number representation for multiply and subtract operations* C = {Re, Im} represented as a vector of 2 16bits signed numbers. Using gcc vector notation C[0] is the real part, C[1] is the imaginary part. Position in register in little endian: - Re : bits[15:0] - Im : bits[31:16]
COMPLEX/MULT | Complex multiplication operations
COMPLEX/SUB | Subtraction of 2 complexes with post rotation by -j | R = subrotmj(X, Y), R, X, Y complexes. R.Re = X.Im – Y.Im R.Im = Y.Re – X.Re It can be viewed as (XY) rotated by 90 degrees (multiplied by j).
COMPLEX/CONJUGATE | Complex conjugate operation
VECTOR | Extensions to existing RI5CY vector operations.
VECTOR/ADD | Addition of vector of half words with post right shift | Extends the existing pv.add instruction.
VECTOR/SUB | Subtraction of vectors of half words with post right shift | Extends the existing pv.sub instruction
VITERBI | Viterbi specific instructions | Selection of the survivor path relies on which branch the vector max2 has taken for each of its vector sub elements. The usual approach here is to have a variant of max setting 2 hardware flags to keep trace of which input operand has been selected for the elaboration of the max2. These 2 flags are then used by a selection operation taking 2 input vectors and the 2 flags and produce as an output a vector that is a selection of shifted by 1 to the left inputs with bit0 set according to flags.
SHUFFLING | Enhanced shuffling | Extension to RI5CY pv.pack.h rD, rA, rB operation

Sheet: INSTEXT_rel1.0.0
Mnemonic | Description | Category | Format
pv.cplxmul.s rD, rA, rB | Vector by Vector rD[15:0 ] = (rA[15:0 ]*rB[15:0 ] - rA[31:16]*rB[31:16])>>15 rD[31:16] = (rA[15:0 ]*rB[31:16] + rA[31:16]*rB[15:0 ])>>15 | COMPLEX/MULT | VEC
pv.cplxmul.s.div2 rD, rA, rB | Vector by Vector, Div2 rD[15:0 ] = (rA[15:0 ]*rB[15:0 ] - rA[31:16]*rB[31:16])>>16 rD[31:16] = (rA[15:0 ]*rB[31:16] + rA[31:16]*rB[15:0 ])>>16 | COMPLEX/MULT | VEC
pv.cplxmul.s.div4 rD, rA, rB | Vector by Vector, Div4 rD[15:0 ] = (rA[15:0 ]*rB[15:0 ] - rA[31:16]*rB[31:16])>>17 rD[31:16] = (rA[15:0 ]*rB[31:16] + rA[31:16]*rB[15:0 ])>>17 | COMPLEX/MULT | VEC
pv.cplxmul.s.sc rD, rA, rB | Vector by Scalar rD[15:0 ] = (rA[15:0 ]*rB[15:0 ] - rA[31:16]*rB[15:0])>>15 rD[31:16] = (rA[15:0 ]*rB[15:0 ] + rA[31:16]*rB[15:0])>>15 | COMPLEX/MULT | VEC
pv.cplxmul.s.sci | Vector by I6 Scalar rD[15:0 ] = (rA[15:0 ]*ExtS(I6) - rA[31:16]*ExtS(I6))>>15 rD[31:16] = (rA[15:0 ]*ExtS(I6) + rA[31:16]*ExtS(I6))>>15 | COMPLEX/MULT | VEC
pv.subrotmj.h rD, rA, rB | rD[15:0 ] = rA[31:16] - rB[31:16] rD[31:16] = rB[15:0 ] rA[15:0] | COMPLEX/SUB | VEC
pv.subrotmj.h.div2 rD, rA, rB | rD[15:0 ] = (rA[31:16] - rB[31:16]) >> 1 rD[31:16] = (rB[15:0 ] - rA[15:0]) >> 1 | COMPLEX/SUB | VEC
pv.subrotmj.h.div4 rD, rA, rB | rD[15:0 ] = (rA[31:16] - rB[31:16]) >> 2 rD[31:16] = (rB[15:0 ] - rA[15:0]) >> 2 | COMPLEX/SUB | VEC
pv.cplxconj.h rD, rA | rD[15:0 ] = rA[15:0 ] rD[31:16] = -rA[31:16] | COMPLEX/CONJUGATE | VEC
pv.add.h.div2 rD, rA, rB | rD[15:0 ] = (rA[15:0 ] + rB[15:0 ]) >> 1 rD[31:16] = (rA[31:16] + rB[31:16]) >> 1 | VECTOR/ADD | VEC
pv.add.b.div2 rD, rA, rB | rD[ 7:0 ] = (rA[ 7:0 ] + rB[ 7:0 ]) >> 1 rD[15:8 ] = (rA[15:8 ] + rB[15:8 ]) >> 1 rD[23:16] = (rA[23:16] + rB[23:16]) >> 1 rD[31:24] = (rA[31:24] + rB[31:24]) >> 1 | VECTOR/ADD | VEC
pv.add.h.div4 rD, rA, rB | rD[15:0 ] = (rA[15:0 ] + rB[15:0 ]) >> 2 rD[31:16] = (rA[31:16] + rB[31:16]) >> 2 | VECTOR/ADD | VEC
pv.add.b.div4 rD, rA, rB | rD[ 7:0 ] = (rA[ 7:0 ] + rB[ 7:0 ]) >> 2 rD[15:8 ] = (rA[15:8 ] + rB[15:8 ]) >> 2 rD[23:16] = (rA[23:16] + rB[23:16]) >> 2 rD[31:24] = (rA[31:24] + rB[31:24]) >> 2 | VECTOR/ADD | VEC
pv.sub.h.div2 rD, rA, rB | rD[15:0 ] = (rA[15:0 ] - rB[15:0 ]) >> 1 rD[31:16] = (rA[31:16] - rB[31:16]) >> 1 | VECTOR/SUB | VEC
pv.sub.b.div2 rD, rA, rB | rD[ 7:0 ] = (rA[ 7:0 ] - rB[ 7:0 ]) >> 1 rD[15:8 ] = (rA[15:8 ] - rB[15:8 ]) >> 1 rD[23:16] = (rA[23:16] - rB[23:16]) >> 1 rD[31:24] = (rA[31:24] - rB[31:24]) >> 1 | VECTOR/SUB | VEC
pv.sub.h.div4 rD, rA, rB | rD[15:0 ] = (rA[15:0 ] - rB[15:0 ]) >> 2 rD[31:16] = (rA[31:16] - rB[31:16]) >> 2 | VECTOR/SUB | VEC
pv.sub.b.div4 rD, rA, rB | rD[ 7:0 ] = (rA[ 7:0 ] - rB[ 7:0 ]) >> 2 rD[15:8 ] = (rA[15:8 ] - rB[15:8 ]) >> 2 rD[23:16] = (rA[23:16] - rB[23:16]) >> 2 rD[31:24] = (rA[31:24] - rB[31:24]) >> 2 | VECTOR/SUB | VEC
pv.vitop.max rD, rA, rB | rD[31:16] = max(rA[31:16], rB[31:16]) rD[15:0 ] = max(rA[15:0 ], rB[15:0 ]) $VF0 = (rA[31:16] <= rB[31:16]) $VF1 = (rA[15:0 ] <= rB[15:0 ]) | VITERBI | VEC
pv.vitop.sel rD, rA, rB | rD[31:16] = ((rA[31:16]<<1)&!$VF0)|(rB[31:16]<<1 | $VF0) rD[15:0 ] = ((rA[15:0 ]<<1)&!$VF1)|(rB[15:0 ]<<1 | $VF1) | VITERBI | VEC
pv.pack.h.h rD, rA, rB | rD[31:16] = rA[31:16] rD[15:0 ] = rB[31:16] | SHUFFLING | VEC
pv.pack.l.h rD, rA, rB | rD[31:16] = rA[15:0] rD[15:0 ] = rB[15:0] | SHUFFLING | VEC

Sheet: INSTEXTFMTVEC_rel1.0.0
Mnemonic | funct5 | F | S | Imm | rs2 | rs1 | funct3 | rD | opcode
pv.cplxmul.s rD, rA, rB | 5'b01010 | 1'b1 | 1'b0 |  | src2 | src1 | 3'b000 | dest | 7'b1010111
pv.cplxmul.s.div2 rD, rA, rB | 5'b01010 | 1'b1 | 1'b0 |  | src2 | src1 | 3'b010 | dest | 7'b1010111
pv.cplxmul.s.div4 rD, rA, rB | 5'b01010 | 1'b1 | 1'b1 |  | src2 | src1 | 3'b010 | dest | 7'b1010111
pv.cplxmul.s.sc rD, rA, rB | 5'b01010 | 1'b1 | 1'b0 |  | src2 | src1 | 3'b100 | dest | 7'b1010111
pv.cplxmul.s.sci | 5'b01010 | 1'b1 |  | Imm6[5:0]s |  | src1 | 3'b110 | dest | 7'b1010111
pv.subrotmj.h rD, rA, rB | 5'b01101 | 1'b1 | 1'b0 |  | src2 | src1 | 3'b000 | dest | 7'b1010111
pv.subrotmj.h.div2 rD, rA, rB | 5'b01101 | 1'b1 | 1'b0 |  | src2 | src1 | 3'b010 | dest | 7'b1010111
pv.subrotmj.h.div4 rD, rA, rB | 5'b01101 | 1'b1 | 1'b1 |  | src2 | src1 | 3'b010 | dest | 7'b1010111
pv.cplxconj.h rD, rA | 5'b01011 | 1'b1 |  | 6'b000000 |  | src1 | 3'b000 | dest | 7'b1010111
pv.add.h.div2 rD, rA, rB | 5'b00000 | 1'b0 | 1'b0 |  | src2 | src1 | 3'b010 | dest | 7'b1010111
pv.add.b.div2 rD, rA, rB | 5'b00000 | 1'b0 | 1'b0 |  | src2 | src1 | 3'b011 | dest | 7'b1010111
pv.add.h.div4 rD, rA, rB | 5'b00000 | 1'b0 | 1'b1 |  | src2 | src1 | 3'b010 | dest | 7'b1010111
pv.add.b.div4 rD, rA, rB | 5'b00000 | 1'b0 | 1'b1 |  | src2 | src1 | 3'b011 | dest | 7'b1010111
pv.sub.h.div2 rD, rA, rB | 5'b00001 | 1'b0 | 1'b0 |  | src2 | src1 | 3'b010 | dest | 7'b1010111
pv.sub.b.div2 rD, rA, rB | 5'b00001 | 1'b0 | 1'b0 |  | src2 | src1 | 3'b011 | dest | 7'b1010111
pv.sub.h.div4 rD, rA, rB | 5'b00001 | 1'b0 | 1'b1 |  | src2 | src1 | 3'b010 | dest | 7'b1010111
pv.sub.b.div4 rD, rA, rB | 5'b00001 | 1'b0 | 1'b1 |  | src2 | src1 | 3'b011 | dest | 7'b1010111
pv.vitop.max rD, rA, rB | 5'b01100 | 1'b1 | 1'b0 |  | src2 | src1 | 3'b001 | dest | 7'b1010111
pv.vitop.sel rD, rA, rB | 5'b01100 | 1'b1 | 1'b0 |  | src2 | src1 | 3'b000 | dest | 7'b1010111
pv.pack.h.h rD, rA, rB | 5'b11010 | 1'b0 | 1'b0 |  | src2 | src1 | 3'b110 | dest | 7'b1010111
pv.pack.l.h rD, rA, rB | 5'b11010 | 1'b0 | 1'b0 |  | src2 | src1 | 3'b100 | dest | 7'b1010111

Sheet: INSTEXTFMT_rel1.0.0
Format | Field | Title | Start | Length | Description | No table column
VEC | funct5 | funct5 | 31 | 5 | Sub opcode
VEC | F | F | 26 | 1 | Family
VEC | S | S | 25 | 1 | Post right shift
VEC | Imm |  | 20 | 6 | Immediate | Overlaps with S and rs2
VEC | rs2 | rs2 | 20 | 5 | Register src2
VEC | rs1 | rs1 | 15 | 5 | Register src1
VEC | funct3 | funct3 | 12 | 3 | Function
VEC | rD | rD | 7 | 11 | Register dst
VEC | opcode | opcode | 0 | 7 | Main opcode
