pulp-platform/pulp/doc/IP_REFERENCES/APB_SOC_CTRL_reference.xlsx

Sheet: Info
Document Information
Name | APB_SOC_CTRL reference
Category | IP reference
Author | Florent Rotenberg
Version | 1.0
Status | Fisrt Release
Description | APB_SOC_CTRL interface definition
IP Information
IP type | APB_SOC_CTRL
Delivery Type
History
Date | Modification | Author
26/10/2016 | 1strelease | F.Rotenberg
Content
Info | This sheet. General information about document usage
Usage | Guidelines on how to used the various sheet
IP Release | Release information sheet describing
IPIF_relx.x | IP interface description reference, describing IP symbol/entity and integration and test information relative to IP interface.
IPREGLIST_rely.y | Description of the list of registers used by IP. Registers can be physically instanciated inside IP or outside IP.
IPREGMAP_relz.z | Description of mapping of bit fields when registers are internal to IP. This sheet is optional for IP which are not instanciating registers as information can be build from IPIF and IPRELIST sheet.
IPTREGMAP_relz.z | Description of mapping of test bit field when registers are internal to IP. This sheet is optional for IP which are not instanciating registers as information can be build from IPIF and IPRELIST sheet.
IPUDMACMDLIST_relz.z | Description of IP UDMA commands list used by IP.
IPUDMACMDMAP_relz.z | Description of mapping of bit fields in IP UDMA commands used by IP.

Sheet: Usage
IP Release Sheet
 | Column | Description | Possible Value
 | Version | IP release version numeroted as [major release].[minor release]. A release is major whenever IP interface is modified. | X.Y. Z
 | Release description | This is a free text entry expliciting the release main modifications and purpose. | Text
 | IPIF | IPIF sheet version to be used for this release. | X.Y. Z
 | IPREGLIST | IPREGLIST sheet version to be used for this release. | X.Y. Z
 | IPREGMAP | IPREGMAP sheet version to be used for this release. | X.Y. Z
 | IPUDMACMDLIST | IPUDMACMDLIST sheet version to be used for this release. | X.Y. Z
 | IPUDMACMDMAP | IPUDMACMDMAP sheet version to be used for this release. | X.Y. Z
 | IPDOC | IPDOC version to be used for this release. | X.Y. Z
 | GIT version | GIT database number corresponding to IP design code and IP reference XLS. | Integer
IPIF sheet
IP Interface description | IP Pin Name | Name of IP Pin. This must must exactly name find in code or schematic (including case).
 | Direction | Direction or type of signal | In,Out,IO
 | Type | Analog, Digital, supply, DR (Dual Rail), SR (SingleRail) | Analog,Digital, VDD, GND, DR, SR
 | Voltage Domain
 | Clock domain
 | IO
 | Size
 | Reset Value
 | Description
Integration information | Integration comment
 | Core Interface
 | Register Interface
 | Register name
 | DFT value
 | Level Shifter
 | Isolation cell
 | Connected to
 | Load
 | Drive
 | Destination supply
Hard Macro information | location
 | layer
 | Antenna
Additonal Information | FreeText 1
 | FreeText 2
Driver information | Function1
 | Function2

Sheet: IP Release
Version | Release description | IPIF | IPREGLIST | IPREGMAP | IPUDMACMDLIST | IPUDMACMDMAP | IPDOC | GIT version
1.0.0 |  | Rel1.0.0 | Rel1.0.0 | Rel1.0.0

Sheet: IPDESCR_rel1.0.0
Description
The APB SoC Controller allows control of various SoC features such as: - PAD mux configuration - JTAG boot mode - Sleep modes - L2 retentive state configuration - DC/DC voltage regulator configuration in bypass mode

Sheet: IPIF_rel1.0.0
IP Interface description |  |  |  |  |  |  |  |  | Integration information |  |  |  |  |  |  |  |  |  |  |  |  | Hard Macro information |  |  | Additonal Information |  | Driver information
IP Pin Name | Direction | Type | Voltage Domain | Clock domain | IO | Size | Reset Value | Description | Integration comment | Core Interface | Register Interface | Register name | Bit position | Trim during production | DFT value | Level Shifter | Isolation cell | Connected to | Load | Drive | Destination supply | location | layer | Antenna | FreeText 1 | FreeText 2 | Function1 | Function2

Sheet: IPREGLIST_rel1.0.0
Register Name | Address | Size | Register Type | Host Access Type | IP access Type | Default Value | Description | FootNote | Comment | Hide | Note
INFO | 0x0 | 32 | Status | R | W | 0x18 | Core information register
REG_FCBOOT | 0x4 | 32 | Config | R/W | R/W | 0x1A000080 | FC Boot addres configuration register
REG_FCFETCH | 0x8 | 32 | Config | W | W | 0x1 | FC fetch enable configuration register (bit 0 sets fetch enable)
CL_ISOLATE | 0xC | 32 | Config | R/W | R | 0x1 | Isolate cluster register
CL_BUSY | 0x6C | 32 | Status | R | W | 0x0 | Cluster busy register
CL_BYPASS | 0x70 | 32 | Config | R/W | R/W | 0x400 | PMU bypass configuration register
JTAGREG | 0x74 | 32 | Config | R/W | R/W | 0x0 | JTAG external register |  | This register is used for synchronisation and boot mode configuration from an external debugger.
L2_SLEEP | 0x78 | 32 | Config | R/W | R/W | 0x1 | L2 sleep configuration register
SLEEP_CTRL | 0x7C | 32 | Status | R | W | 0x0 | Alias for SAFE_PMU_SLEEPCTRL |  | This register will be accessible in 1 clock cycle
CORESTATUS | 0xA0 | 32 | Status | R/W | R/W | 0x0 | EOC and chip status register
CORESTATUS_RO | 0xC0 | 32 | Status | R | R | 0x0 | EOC and chip status register read mirror
SAFE_PMU_RAR | 0x100 | 32 | Config | R/W | R/W | 0x0002A52D | DC/DC configuration register
SAFE_PMU_SLEEPCTRL | 0x104 | 32 | Config | R/W | R/W | 0x0 | Sleep modes configuration register
SAFE_PMU_FORCE | 0x108 | 32 | Config | R/W | R/W | 0x0 | L2 rententive state configuration
SAFE_PADFUN0 | 0x140 | 32 | Config | R/W | R/W | 0x0 | Mux config register (pad 0-15) |  |  |  | IPREGMAP auto generated by doc scripts
SAFE_PADFUN1 | 0x144 | 32 | Config | R/W | R/W | 0x0 | Mux config register (pad 16-31) |  |  |  | IPREGMAP auto generated by doc scripts
SAFE_PADFUN2 | 0x148 | 32 | Config | R/W | R/W | 0x0 | Mux config register (pad 32-47) |  |  |  | IPREGMAP auto generated by doc scripts
SAFE_PADFUN3 | 0x14C | 32 | Config | R/W | R/W | 0x0 | Mux config register (pad 48-63) |  |  | Not used | IPREGMAP auto generated by doc scripts
SAFE_SLEEPPADCFG0 | 0x150 | 32 | Config | R/W | R/W | 0x0 | Sleep config register (pad 0-15)
SAFE_SLEEPPADCFG1 | 0x154 | 32 | Config | R/W | R/W | 0x0 | Mux config register (pad 16-31)
SAFE_SLEEPPADCFG2 | 0x158 | 32 | Config | R/W | R/W | 0x0 | Mux config register (pad 32-47)
SAFE_SLEEPPADCFG3 | 0x15C | 32 | Config | R/W | R/W | 0x0 | Mux config register (pad 48-63) |  |  | Not used
SAFE_PADSLEEP | 0x160 | 32 | Config | R/W | R/W | 0x0 | Enable Sleep mode for pads
SAFE_PADCFG0 | 0x180 | 32 | Config | R/W | R/W | 0x0 | Function register (pad 0 to 3) |  |  |  | IPREGMAP auto generated by doc scripts
SAFE_PADCFG1 | 0x184 | 32 | Config | R/W | R/W | 0x0 | Function register (pad 4 to 7) |  |  |  | IPREGMAP auto generated by doc scripts
SAFE_PADCFG2 | 0x188 | 32 | Config | R/W | R/W | 0x0 | Function register (pad 8 to 11) |  |  |  | IPREGMAP auto generated by doc scripts
SAFE_PADCFG3 | 0x18C | 32 | Config | R/W | R/W | 0x0 | Function register (pad 12 to 15) |  |  |  | IPREGMAP auto generated by doc scripts
SAFE_PADCFG4 | 0x190 | 32 | Config | R/W | R/W | 0x0 | Function register (pad 16 to 19) |  |  |  | IPREGMAP auto generated by doc scripts
SAFE_PADCFG5 | 0x194 | 32 | Config | R/W | R/W | 0x0 | Function register (pad 20 to 23) |  |  |  | IPREGMAP auto generated by doc scripts
SAFE_PADCFG6 | 0x198 | 32 | Config | R/W | R/W | 0x0 | Function register (pad 24 to 27) |  |  |  | IPREGMAP auto generated by doc scripts
SAFE_PADCFG7 | 0x19C | 32 | Config | R/W | R/W | 0x0 | Function register (pad 28 to 31) |  |  |  | IPREGMAP auto generated by doc scripts
SAFE_PADCFG8 | 0x1A0 | 32 | Config | R/W | R/W | 0x0 | Function register (pad 32 to 35) |  |  |  | IPREGMAP auto generated by doc scripts
SAFE_PADCFG9 | 0x1A4 | 32 | Config | R/W | R/W | 0x0 | Function register (pad 36 to 39) |  |  |  | IPREGMAP auto generated by doc scripts
SAFE_PADCFG10 | 0x1A8 | 32 | Config | R/W | R/W | 0x0 | Function register (pad 40 to 43) |  |  |  | IPREGMAP auto generated by doc scripts
SAFE_PADCFG11 | 0x1AC | 32 | Config | R/W | R/W | 0x0 | Function register (pad 44 to 47) |  |  |  | IPREGMAP auto generated by doc scripts
SAFE_PADCFG12 | 0x1B0 | 32 | Config | R/W | R/W | 0x0 | Function register (pad 48 to 51) |  |  | Not used | IPREGMAP auto generated by doc scripts
SAFE_PADCFG13 | 0x1B4 | 32 | Config | R/W | R/W | 0x0 | Function register (pad 52 to 55) |  |  | Not used | IPREGMAP auto generated by doc scripts
SAFE_PADCFG14 | 0x1B8 | 32 | Config | R/W | R/W | 0x0 | Function register (pad 56 to 59) |  |  | Not used | IPREGMAP auto generated by doc scripts
SAFE_PADCFG15 | 0x1BC | 32 | Config | R/W | R/W | 0x0 | Function register (pad 60 to 63) |  |  | Not used | IPREGMAP auto generated by doc scripts
REG_GPIO_ISO | 0x1C0 | 32 | Config | R/W | R/W | 0x0 | GPIO power domain pad input isolation register
REG_CAM_ISO | 0x1C4 | 32 | Config | R/W | R/W | 0x0 | CAM power domain pad input isolation register
REG_LVDS_ISO | 0x1C8 | 32 | Config | R/W | R/W | 0x0 | LVDS power domain pad input isolation register

Sheet: IPREGMAP_rel1.0.0
Bit field | Register | Bit Position | Size | Host Access Type | IP access Type | Reset Value | Description | Hide
NB_CL | INFO | 0 | 16 | R | W | 0x0008 | Number of clusters
NB_CORES | INFO | 16 | 16 | R | W | 0x0001 | Number of cores
EN | CL_ISOLATE | 0 | 1 | R/W | R | 0x1 | Isolate cluster. Inhibits AXI transactions from cluster to SoC: - 1'b0: Disable - 1'b1: Enable
BUSY | CL_BUSY | 0 | 1 | R | W | 0x0 | Cluster busy flag (i.e. It's 1 if there is at least 1 active block in the cluster)
BYP_POW | CL_BYPASS | 0 | 1 | R/W | R/W | 0x0 | Bypass Maestro PMU controller configuration bitfield: - 1’b0: disabled - 1’b1: enabled
BYP_CFG | CL_BYPASS | 1 | 1 | R/W | R/W | 0x0 | Bypass Maestro PMU configuration selection configuration bitfield: - 1’b0: use default - 1’b1: use user configuration (bitfields from bits 3 to 15 of CL_BYPASS register)
CL_STATE | CL_BYPASS | 3 | 1 | R/W | R/W | 0x0 | Cluster state configuration and status bitfield: - 1’b0: off - 1’b1: on Status information is correct only when bypass mode is enabled.
CURRSET | CL_BYPASS | 4 | 3 | R/W | R/W | 0x0 | Max current allowed on cluster TRC configuration bitfield.
PROG_DEL | CL_BYPASS | 7 | 2 | R/W | R/W | 0x0 | Number of REFCLK 32kHz after cluster power ok has arised to release TR isolation configuration bitfield.
BYP_CLK | CL_BYPASS | 9 | 1 | R/W | R/W | 0x0 | Bypass cluster clock and reset control by Maestro PMU configuration bitfield: - 1’b0: disabled - 1’b1: enabled
CG | CL_BYPASS | 10 | 1 | R/W | R/W | 0x1 | Cluster clock gate configuration bitfield: - 1’b0: disabled - 1’b1: enabled It should always be used before switching cluster FLL to shutdown or retentive mode.
FLL_PWD | CL_BYPASS | 11 | 1 | R/W | R/W | 0x0 | Cluster FLL shutdown configuration bitfield: - 1’b0: FLL on - 1’b1: FLL shutdown mode
FLL_RET | CL_BYPASS | 12 | 1 | R/W | R/W | 0x0 | Cluster FLL retentive configuration bitfield: - 1’b0: FLL on - 1’b1: FLL retentive mode
RST | CL_BYPASS | 13 | 1 | R/W | R/W | 0x0 | Cluster reset configuration bitfield: - 1’b0: nothing - 1’b1: reset the cluster
BYP_ISO | CL_BYPASS | 14 | 1 | R/W | R/W | 0x0 | ? | not used by Eric
PWISO | CL_BYPASS | 15 | 1 | R/W | R/W | 0x0 | ? | not used by Eric
TRCPOWOK | CL_BYPASS | 16 | 1 | R/W | R/W | 0x0 | Cluster power ok from cluster TRC status bitfield
PMUPOWDOWN | CL_BYPASS | 17 | 1 | R/W | R/W | 0x0 | Cluster power down from Maestro PMU status bitfield.
INT_SYNC | JTAGREG | 0 | 1 | R/W | R/W | 0x0 | JTAG internal register used for synchronisation from external debugger
INT_BT_MD | JTAGREG | 1 | 3 | R/W | R/W | 0x0 | JTAG internal register used for selecting boot mode configuration from external debugger
EXT_SYNC | JTAGREG | 8 | 1 | R | W |  | JTAG external register used for synchronisation from external debugger
EXT_BT_MD | JTAGREG | 9 | 3 | R | W |  | JTAG external register used for selecting boot mode configuration from external debugger
L2_SLEEP | L2_SLEEP | 0 | 1 | R/W | R/W | 0x1 | L2 memory sleep configuration
SLEEP_CTRL | SLEEP_CTRL | 0 | 32 | R | W | 0x0 | Alias for SAFE_PMU_SLEEPCTRL(i.e. will be accessible in 1 clock cycle)
STATUS | CORESTATUS | 0 | 32 | R/W | R/W | 0x0 | EOC and chip status register
STATUS | CORESTATUS_RO | 0 | 32 | R | W | 0x0 | EOC and chip status register
NV_VOLT | SAFE_PMU_RAR | 0 | 5 | R/W | R/W | 5'h0D | DC/DC Nominal Voltage setting
MV_VOLT | SAFE_PMU_RAR | 8 | 5 | R/W | R/W | 5'h09 | DC/DC Medium Voltage setting (not used)
LV_VOLT | SAFE_PMU_RAR | 16 | 5 | R/W | R/W | 5'h09 | DC/DC Low Voltage setting
RV_VOLT | SAFE_PMU_RAR | 24 | 5 | R/W | R/W | 5'h05 | DC/DC Retentive Voltage setting
L2_R0 | SAFE_PMU_SLEEPCTRL | 0 | 1 | R/W | R/W | 1'b0 | Configure retention mode for region 0 of L2 memory: - 1'b0: Non retentive - 1'b1: Retentive
L2_R1 | SAFE_PMU_SLEEPCTRL | 1 | 1 | R/W | R/W | 1'b0 | Configure retention mode for region 1 of L2 memory: - 1'b0: Non retentive - 1'b1: Retentive
L2_R2 | SAFE_PMU_SLEEPCTRL | 2 | 1 | R/W | R/W | 1'b0 | Configure retention mode for region 2 of L2 memory: - 1'b0: Non retentive - 1'b1: Retentive
L2_R3 | SAFE_PMU_SLEEPCTRL | 3 | 1 | R/W | R/W | 1'b0 | Configure retention mode for region 3 of L2 memory: - 1'b0: Non retentive - 1'b1: Retentive
SOC_FLL | SAFE_PMU_SLEEPCTRL | 4 | 1 | R/W | R/W | 1'b0 | Configure retention mode for SoC FLL: - 1'b0: Non retentive - 1'b1: Retentive
CL_FLL | SAFE_PMU_SLEEPCTRL | 5 | 1 | R/W | R/W | 1'b0 | Configure retention mode for cluster FLL: - 1'b0: Non retentive - 1'b1: Retentive
EXTWAKE_SRC | SAFE_PMU_SLEEPCTRL | 6 | 5 | R/W | R/W | 5'b00000 | Select external wake-up source (GPIO ID): - 5'b00000: GPIO 0 - 5'b00001: GPIO 1 - 5'b00010: GPIO 2 - 5'b00011: GPIO 3 - 5'b00100: GPIO 4 - 5'b00101: GPIO 5 - 5'b00110: GPIO 6 - 5'b00111: GPIO 7 - 5'b01000: GPIO 8 - 5'b01001: GPIO 9 - 5'b01010: GPIO 10 - 5'b01011: GPIO 11 - 5'b01100: GPIO 12 - 5'b01101: GPIO 13 - 5'b01110: GPIO 14 - 5'b01111: GPIO 15 - 5'b10000: GPIO 16 - 5'b10001: GPIO 17 - 5'b10010: GPIO 18 - 5'b10011: GPIO 19 - 5'b10100: GPIO 20 - 5'b10101: GPIO 21 - 5'b10110: GPIO 22 - 5'b10111: GPIO 23 - 5'b11000: GPIO 24 - 5'b11001: GPIO 25 - 5'b11010: GPIO 26 - 5'b11011: GPIO 27 - 5'b11100: GPIO 28 - 5'b11101: GPIO 29 - 5'b11110: GPIO 30 - 5'b11111: GPIO 31
EXTWAKE_TYPE | SAFE_PMU_SLEEPCTRL | 11 | 2 | R/W | R/W | 2'b00 | Select external wake-up mode: - 2'b00: rise event - 2'b01: fall event - 2'b10: high level - 2'b11: low level
EXTWAKE_EN | SAFE_PMU_SLEEPCTRL | 13 | 1 | R/W | R/W |  | Enable external wake-up; - 1'b0; external wake-up disabled - 1'b1: external wake-up enabled
WAKESTATE | SAFE_PMU_SLEEPCTRL | 14 | 1 | R/W | R/W | 1'b0 | Power state to restore after warm boot - 1'b0: SoC_LV - 1'b1: SoC_HV
WAKESTATE | SAFE_PMU_SLEEPCTRL | 15 | 1 | R/W | R/W | 1'b0 | - | not used because PMU cluster bypass is always enabled. It is part of above bitfield
BTDEV | SAFE_PMU_SLEEPCTRL | 16 | 1 | R/W | R/W | 1'b0 | Warm bootmode: - 1'b0: Boot from ROM - 1'b1: Boot from L2
EXTINT | SAFE_PMU_SLEEPCTRL | 17 | 1 | R | W | 1'b0 | External wake-up interrupt status (automatically resetted after read) - 1'b0: wake-up triggered by RTC - 1'b1: wake-up triggered by external event
BTTYPE | SAFE_PMU_SLEEPCTRL | 18 | 2 | R/W | R/W | 2'b00 | Select boot type: - 2'b00: cold boot - 2'b01: deep sleep - 2'b10: retentive deep sleep
CL_WAKE | SAFE_PMU_SLEEPCTRL | 20 | 1 | R/W | R/W | 1'b0 | Cluster state to restore after warm boot: - 1’b0: off - 1’b1: on
RET_L2_R0 | SAFE_PMU_FORCE | 0 | 1 | R/W | R/W | 1'b0 | Force retentive state on region 0 of L2 memory: 1'b0: not state retentive 1'b1: state retentive
RET_L2_R1 | SAFE_PMU_FORCE | 1 | 1 | R/W | R/W | 1'b0 | Force retentive state on region 1 of L2 memory: 1'b0: not state retentive 1'b1: state retentive
RET_L2_R2 | SAFE_PMU_FORCE | 2 | 1 | R/W | R/W | 1'b0 | Force retentive state on region 2 of L2 memory: 1'b0: not state retentive 1'b1: state retentive
RET_L2_R3 | SAFE_PMU_FORCE | 3 | 1 | R/W | R/W | 1'b0 | Force retentive state on region 3 of L2 memory: 1'b0: not state retentive 1'b1: state retentive
PD_L2_R0 | SAFE_PMU_FORCE | 4 | 1 | R/W | R/W | 1'b0 | Force power down on region 0 of L2 memory: 1'b0: power up 1'b1: power down
PD_L2_R1 | SAFE_PMU_FORCE | 5 | 1 | R/W | R/W | 1'b0 | Force power down on region 1 of L2 memory: 1'b0: power up 1'b1: power down
PD_L2_R2 | SAFE_PMU_FORCE | 6 | 1 | R/W | R/W | 1'b0 | Force power down on region 2 of L2 memory: 1'b0: power up 1'b1: power down
PD_L2_R3 | SAFE_PMU_FORCE | 7 | 1 | R/W | R/W | 1'b0 | Force power down on region 3 of L2 memory: 1'b0: power up 1'b1: power down
EN | SAFE_PADSLEEP | 0 | 1 | R/W | R/W | 1'b0 | Enable pad sleep mode: 1'b0: disable 1'b1: enable
ISO | REG_GPIO_ISO | 0 | 1 | R/W | R/W | 1'b0 | Configuration of GPIO domain pads isolation: - 1'b0: not isolated - 1'b1: isolated
ISO | REG_CAM_ISO | 0 | 1 | R/W | R/W | 1'b0 | Configuration of CAM domain pads isolation: - 1'b0: not isolated - 1'b1: isolated
ISO | REG_LVDS_ISO | 0 | 1 | R/W | R/W | 1'b0 | Configuration of LVDS domain pads isolation: - 1'b0: not isolated - 1'b1: isolated
EN | REG_FCFETCH | 0 | 1 | W | W | 1’b1 | Configuration of FC fetch enable: - 1'b0: not set - 1'b1: set
BOOT_ADDR | REG_FCBOOT | 0 | 32 | R/W | R/W | 32’h1A000080 | Configuration of FC boot address

Sheet: VerPlan_rel1.0.0
Name | Description | testcase location&name | Status
