pulp-platform/pulp/doc/IP_REFERENCES/APB_ADV_TIMER_reference.xlsx

Sheet: Info
Document Information
Name | ADV_TIMER reference
Category | IP reference
Author | Florent Rotenberg
Version | 1.0
Status | Fisrt Release
Description | ADV_TIMER interface definition
IP Information
IP type | ADV_TIMER
Delivery Type
History
Date | Modification | Author
26/10/2016 | 1st release | F.Rotenberg
Content
Info | This sheet. General information about document usage
Usage | Guidelines on how to used the various sheet
IP Release | Release information sheet describing
IPIF_relx.x | IP interface description reference, describing IP symbol/entity and integration and test information relative to IP interface.
IPDESCR_Relx.x | Description of the main features of the IP
IPREGLIST_rely.y | Description of the list of registers used by IP. Registers can be physically instanciated inside IP or outside IP.
IPREGMAP_relz.z | Description of mapping of bit fields when registers are internal to IP. This sheet is optional for IP which are not instanciating registers as information can be build from IPIF and IPRELIST sheet.
IPTREGMAP_relz.z | Description of mapping of test bit field when registers are internal to IP. This sheet is optional for IP which are not instanciating registers as information can be build from IPIF and IPRELIST sheet.

Sheet: Usage
IP Release Sheet
 | Column | Description | Possible Value
 | Version | IP release version numeroted as [major release].[minor release]. A release is major whenever IP interface is modified. | X.Y. Z
 | Release description | This is a free text entry expliciting the release main modifications and purpose. | Text
 | IPIF | IPIF sheet version to be used for this release. | X.Y. Z
 | IPDESCR | IPDESCR sheet version to nbe used for this release | X.Y.Z
 | IPREGLIST | IPREGLIST sheet version to be used for this release. | X.Y. Z
 | IPREGMAP | IPREGMAP sheet version to be used for this release. | X.Y. Z
 | IPDOC | IPDOC version to be used for this release. | X.Y. Z
 | GIT version | GIT database number corresponding to IP design code and IP reference XLS. | Integer
IPIF sheet
IP Interface description | IP Pin Name | Name of IP Pin. This must must exactly name find in code or schematic (including case).
 | Direction | Direction or type of signal | In,Out,IO
 | Type | Analog, Digital, supply, DR (Dual Rail), SR (SingleRail) | Analog,Digital, VDD, GND, DR, SR
 | Voltage Domain
 | Clock domain
 | IO
 | Size
 | Reset Value
 | Description
Integration information | Integration comment
 | Core Interface
 | Register Interface
 | Register name
 | DFT value
 | Level Shifter
 | Isolation cell
 | Connected to
 | Load
 | Drive
 | Destination supply
Hard Macro information | location
 | layer
 | Antenna
Additonal Information | FreeText 1
 | FreeText 2
Driver information | Function1
 | Function2

Sheet: IP Release
Version | Release description | IPIF | IPDESCR | IPREGLIST | IPREGMAP | IPDOC | GIT version
1.0.0 |  | Rel1.0.0 | Rel1.0.0 | Rel1.0.0 | Rel1.0.0

Sheet: IPIF_rel1.0.0
IP Interface description |  |  |  |  |  |  |  |  | Integration information |  |  |  |  |  |  |  |  |  |  |  |  | Hard Macro information |  |  | Additonal Information |  | Driver information
IP Pin Name | Direction | Type | Voltage Domain | Clock domain | IO | Size | Reset Value | Description | Integration comment | Core Interface | Register Interface | Register name | Bit position | Trim during production | DFT value | Level Shifter | Isolation cell | Connected to | Load | Drive | Destination supply | location | layer | Antenna | FreeText 1 | FreeText 2 | Function1 | Function2

Sheet: IPDESCR_rel1.0.0
Description
ADV_ TIMER component manages the following features: - 4 advanced timers with 4 output signal channels each. Provides PWM generation functionality - multiple trigger input sources: - output signal channels of all timers - 32 GPIOs - reference clock at 32kHz - SoC FLL clock - configurable input trigger modes - configurable prescaler for each timer - configurable counting mode for each timer - configurable channel threshold action for each timer - 4 configurable output events - configurable clock gating of each timer

Sheet: IPREGLIST_rel1.0.0
Register Name | Header | Address | Size | Register Type | Host Access Type | IP access Type | Default Value | Description | FootNote | Comment
T0_CMD |  | 0x0 | 32 | Config | R/W | R/W | 0x0 | ADV_TIMER0 command register.
T0_CONFIG |  | 0x4 | 32 | Config | R/W | R/W | 0x0 | ADV_TIMER0 configuration register.
T0_THRESHOLD |  | 0x8 | 32 | Config | R/W | R/W | 0x0 | ADV_TIMER0 threshold configuration register.
T0_TH_CHANNEL0 |  | 0xC | 32 | Config | R/W | R/W | 0x0 | ADV_TIMER0 channel 0 threshold configuration register.
T0_TH_CHANNEL1 |  | 0x10 | 32 | Config | R/W | R/W | 0x0 | ADV_TIMER0 channel 1 threshold configuration register.
T0_TH_CHANNEL2 |  | 0x14 | 32 | Config | R/W | R/W | 0x0 | ADV_TIMER0 channel 2 threshold configuration register.
T0_TH_CHANNEL3 |  | 0x18 | 32 | Config | R/W | R/W | 0x0 | ADV_TIMER0 channel 3 threshold configuration register.
T0_COUNTER |  | 0x2C | 32 | Status | R | W | 0x0 | ADV_TIMER0 counter register.
T1_CMD |  | 0x40 | 32 | Config | R/W | R/W | 0x0 | ADV_TIMER1 command register.
T1_CONFIG |  | 0x44 | 32 | Config | R/W | R/W | 0x0 | ADV_TIMER1 configuration register.
T1_THRESHOLD |  | 0x48 | 32 | Config | R/W | R/W | 0x0 | ADV_TIMER1 threshold configuration register.
T1_TH_CHANNEL0 |  | 0x4C | 32 | Config | R/W | R/W | 0x0 | ADV_TIMER1 channel 0 threshold configuration register.
T1_TH_CHANNEL1 |  | 0x50 | 32 | Config | R/W | R/W | 0x0 | ADV_TIMER1 channel 1 threshold configuration register.
T1_TH_CHANNEL2 |  | 0x54 | 32 | Config | R/W | R/W | 0x0 | ADV_TIMER1 channel 2 threshold configuration register.
T1_TH_CHANNEL3 |  | 0x58 | 32 | Config | R/W | R/W | 0x0 | ADV_TIMER1 channel 3 threshold configuration register.
T1_COUNTER |  | 0x6C | 32 | Status | R | W | 0x0 | ADV_TIMER1 counter register.
T2_CMD |  | 0x80 | 32 | Config | R/W | R/W | 0x0 | ADV_TIMER2 command register.
T2_CONFIG |  | 0x84 | 32 | Config | R/W | R/W | 0x0 | ADV_TIMER2 configuration register.
T2_THRESHOLD |  | 0x88 | 32 | Config | R/W | R/W | 0x0 | ADV_TIMER2 threshold configuration register.
T2_TH_CHANNEL0 |  | 0x8C | 32 | Config | R/W | R/W | 0x0 | ADV_TIMER2 channel 0 threshold configuration register.
T2_TH_CHANNEL1 |  | 0x90 | 32 | Config | R/W | R/W | 0x0 | ADV_TIMER2 channel 1 threshold configuration register.
T2_TH_CHANNEL2 |  | 0x94 | 32 | Config | R/W | R/W | 0x0 | ADV_TIMER2 channel 2 threshold configuration register.
T2_TH_CHANNEL3 |  | 0x98 | 32 | Config | R/W | R/W | 0x0 | ADV_TIMER2 channel 3 threshold configuration register.
T2_COUNTER |  | 0xAC | 32 | Status | R | W | 0x0 | ADV_TIMER2 counter register.
T3_CMD |  | 0xC0 | 32 | Config | R/W | R/W | 0x0 | ADV_TIMER3 command register.
T3_CONFIG |  | 0xC4 | 32 | Config | R/W | R/W | 0x0 | ADV_TIMER3 configuration register.
T3_THRESHOLD |  | 0xC8 | 32 | Config | R/W | R/W | 0x0 | ADV_TIMER3 threshold configuration register.
T3_TH_CHANNEL0 |  | 0xCC | 32 | Config | R/W | R/W | 0x0 | ADV_TIMER3 channel 0 threshold configuration register.
T3_TH_CHANNEL1 |  | 0xD0 | 32 | Config | R/W | R/W | 0x0 | ADV_TIMER3 channel 1 threshold configuration register.
T3_TH_CHANNEL2 |  | 0xD4 | 32 | Config | R/W | R/W | 0x0 | ADV_TIMER3 channel 2 threshold configuration register.
T3_TH_CHANNEL3 |  | 0xD8 | 32 | Config | R/W | R/W | 0x0 | ADV_TIMER3 channel 3 threshold configuration register.
T3_COUNTER |  | 0xEC | 32 | Status | R | W | 0x0 | ADV_TIMER3 counter register.
EVENT_CFG |  | 0x100 | 32 | Config | R/W | R/W | 0x0 | ADV_TIMERS events configuration register.
CG |  | 0x104 | 32 | Config | R/W | R/W | 0x0 | ADV_TIMERS channels clock gating configuration register.

Sheet: IPREGMAP_rel1.0.0
Bit field | Register | Bit Position | Size | Host Access Type | IP access Type | Reset Value | Description
START | T0_CMD | 0 | 1 | R/W | R/W | 0x0 | ADV_TIMER0 start command bitfield.
STOP | T0_CMD | 1 | 1 | R/W | R/W | 0x0 | ADV_TIMER0 stop command bitfield.
UPDATE | T0_CMD | 2 | 1 | R/W | R/W | 0x0 | ADV_TIMER0 update command bitfield.
RESET | T0_CMD | 3 | 1 | R/W | R/W | 0x0 | ADV_TIMER0 reset command bitfield.
ARM | T0_CMD | 4 | 1 | R/W | R/W | 0x1 | ADV_TIMER0 arm command bitfield.
INSEL | T0_CONFIG | 0 | 8 | R/W | R/W | 0x0 | ADV_TIMER0 input source configuration bitfield: - 0-31: GPIO[0] to GPIO[31] - 32-35: Channel 0 to 3 of ADV_TIMER0 - 36-39: Channel 0 to 3 of ADV_TIMER1 - 40-43: Channel 0 to 3 of ADV_TIMER2 - 44-47: Channel 0 to 3 of ADV_TIMER3
MODE | T0_CONFIG | 8 | 3 | R/W | R/W | 0x1 | ADV_TIMER0 trigger mode configuration bitfield: - 3'h0: trigger event at each clock cycle. - 3'h1: trigger event if input source is 0 - 3'h2: trigger event if input source is 1 - 3'h3: trigger event on input source rising edge - 3'h4: trigger event on input source falling edge - 3'h5: trigger event on input source falling or rising edge - 3'h6: trigger event on input source rising edge when armed - 3'h7: trigger event on input source falling edge when armed
CLKSEL | T0_CONFIG | 11 | 1 | R/W | R/W | 0x0 | ADV_TIMER0 clock source configuration bitfield: - 1'b0: FLL - 1'b1: reference clock at 32kHz
UPDOWNSEL | T0_CONFIG | 12 | 1 | R/W | R/W | 0x0 | ADV_TIMER0 center-aligned mode configuration bitfield: - 1'b0: The counter counts up and down alternatively. - 1'b1: The counter counts up and resets to 0 when reach threshold.
PRESC | T0_CONFIG | 16 | 8 | R/W | R/W | 0x0 | ADV_TIMER0 prescaler value configuration bitfield.
TH_LO | T0_THRESHOLD | 0 | 16 | R/W | R/W | 0x0 | ADV_TIMER0 threshold low part configuration bitfield. It defines start counter value.
TH_HI | T0_THRESHOLD | 16 | 16 | R/W | R/W | 0x0 | ADV_TIMER0 threshold high part configuration bitfield. It defines end counter value.
TH | T0_TH_CHANNEL0 | 0 | 16 | R/W | R/W | 0x0 | ADV_TIMER0 channel 0 threshold configuration bitfield.
MODE | T0_TH_CHANNEL0 | 16 | 3 | R/W | R/W | 0x0 | ADV_TIMER0 channel 0 threshold match action on channel output signal configuration bitfield: - 3'h0: set. - 3'h1: toggle then next threshold match action is clear. - 3'h2: set then next threshold match action is clear. - 3'h3: toggle. - 3'h4: clear. - 3'h5: toggle then next threshold match action is set. - 3'h6: clear then next threshold match action is set.
TH | T0_TH_CHANNEL1 | 0 | 16 | R/W | R/W | 0x0 | ADV_TIMER0 channel 1 threshold configuration bitfield.
MODE | T0_TH_CHANNEL1 | 16 | 3 | R/W | R/W | 0x0 | ADV_TIMER0 channel 1 threshold match action on channel output signal configuration bitfield: - 3'h0: set. - 3'h1: toggle then next threshold match action is clear. - 3'h2: set then next threshold match action is clear. - 3'h3: toggle. - 3'h4: clear. - 3'h5: toggle then next threshold match action is set. - 3'h6: clear then next threshold match action is set.
TH | T0_TH_CHANNEL2 | 0 | 16 | R/W | R/W | 0x0 | ADV_TIMER0 channel 2 threshold configuration bitfield.
MODE | T0_TH_CHANNEL2 | 16 | 3 | R/W | R/W | 0x0 | ADV_TIMER0 channel 2 threshold match action on channel output signal configuration bitfield: - 3'h0: set. - 3'h1: toggle then next threshold match action is clear. - 3'h2: set then next threshold match action is clear. - 3'h3: toggle. - 3'h4: clear. - 3'h5: toggle then next threshold match action is set. - 3'h6: clear then next threshold match action is set.
TH | T0_TH_CHANNEL3 | 0 | 16 | R/W | R/W | 0x0 | ADV_TIMER0 channel 3 threshold configuration bitfield.
MODE | T0_TH_CHANNEL3 | 16 | 3 | R/W | R/W | 0x0 | ADV_TIMER0 channel 3 threshold match action on channel output signal configuration bitfield: - 3'h0: set. - 3'h1: toggle then next threshold match action is clear. - 3'h2: set then next threshold match action is clear. - 3'h3: toggle. - 3'h4: clear. - 3'h5: toggle then next threshold match action is set. - 3'h6: clear then next threshold match action is set.
START | T1_CMD | 0 | 1 | R/W | R/W | 0x0 | ADV_TIMER1 start command bitfield.
STOP | T1_CMD | 1 | 1 | R/W | R/W | 0x0 | ADV_TIMER1 stop command bitfield.
UPDATE | T1_CMD | 2 | 1 | R/W | R/W | 0x0 | ADV_TIMER1 update command bitfield.
RESET | T1_CMD | 3 | 1 | R/W | R/W | 0x0 | ADV_TIMER1 reset command bitfield.
ARM | T1_CMD | 4 | 1 | R/W | R/W | 0x1 | ADV_TIMER1 arm command bitfield.
INSEL | T1_CONFIG | 0 | 8 | R/W | R/W | 0x0 | ADV_TIMER1 input source configuration bitfield: - 0-31: GPIO[0] to GPIO[31] - 32-35: Channel 0 to 3 of ADV_TIMER0 - 36-39: Channel 0 to 3 of ADV_TIMER1 - 40-43: Channel 0 to 3 of ADV_TIMER2 - 44-47: Channel 0 to 3 of ADV_TIMER3
MODE | T1_CONFIG | 8 | 3 | R/W | R/W | 0x1 | ADV_TIMER1 trigger mode configuration bitfield: - 3'h0: trigger event at each clock cycle. - 3'h1: trigger event if input source is 0 - 3'h2: trigger event if input source is 1 - 3'h3: trigger event on input source rising edge - 3'h4: trigger event on input source falling edge - 3'h5: trigger event on input source falling or rising edge - 3'h6: trigger event on input source rising edge when armed - 3'h7: trigger event on input source falling edge when armed
CLKSEL | T1_CONFIG | 11 | 1 | R/W | R/W | 0x0 | ADV_TIMER1 clock source configuration bitfield: - 1'b0: FLL - 1'b1: reference clock at 32kHz
UPDOWNSEL | T1_CONFIG | 12 | 1 | R/W | R/W | 0x0 | ADV_TIMER1 center-aligned mode configuration bitfield: - 1'b0: The counter counts up and down alternatively. - 1'b1: The counter counts up and resets to 0 when reach threshold.
PRESC | T1_CONFIG | 16 | 8 | R/W | R/W | 0x0 | ADV_TIMER1 prescaler value configuration bitfield.
TH_LO | T1_THRESHOLD | 0 | 16 | R/W | R/W | 0x0 | ADV_TIMER1 threshold low part configuration bitfield. It defines start counter value.
TH_HI | T1_THRESHOLD | 16 | 16 | R/W | R/W | 0x0 | ADV_TIMER1 threshold high part configuration bitfield. It defines end counter value.
TH | T1_TH_CHANNEL0 | 0 | 16 | R/W | R/W | 0x0 | ADV_TIMER1 channel 0 threshold configuration bitfield.
MODE | T1_TH_CHANNEL0 | 16 | 3 | R/W | R/W | 0x0 | ADV_TIMER1 channel 0 threshold match action on channel output signal configuration bitfield: - 3'h0: set. - 3'h1: toggle then next threshold match action is clear. - 3'h2: set then next threshold match action is clear. - 3'h3: toggle. - 3'h4: clear. - 3'h5: toggle then next threshold match action is set. - 3'h6: clear then next threshold match action is set.
TH | T1_TH_CHANNEL1 | 0 | 16 | R/W | R/W | 0x0 | ADV_TIMER1 channel 1 threshold configuration bitfield.
MODE | T1_TH_CHANNEL1 | 16 | 3 | R/W | R/W | 0x0 | ADV_TIMER1 channel 1 threshold match action on channel output signal configuration bitfield: - 3'h0: set. - 3'h1: toggle then next threshold match action is clear. - 3'h2: set then next threshold match action is clear. - 3'h3: toggle. - 3'h4: clear. - 3'h5: toggle then next threshold match action is set. - 3'h6: clear then next threshold match action is set.
TH | T1_TH_CHANNEL2 | 0 | 16 | R/W | R/W | 0x0 | ADV_TIMER1 channel 2 threshold configuration bitfield.
MODE | T1_TH_CHANNEL2 | 16 | 3 | R/W | R/W | 0x0 | ADV_TIMER1 channel 2 threshold match action on channel output signal configuration bitfield: - 3'h0: set. - 3'h1: toggle then next threshold match action is clear. - 3'h2: set then next threshold match action is clear. - 3'h3: toggle. - 3'h4: clear. - 3'h5: toggle then next threshold match action is set. - 3'h6: clear then next threshold match action is set.
TH | T1_TH_CHANNEL3 | 0 | 16 | R/W | R/W | 0x0 | ADV_TIMER1 channel 3 threshold configuration bitfield.
MODE | T1_TH_CHANNEL3 | 16 | 3 | R/W | R/W | 0x0 | ADV_TIMER1 channel 3 threshold match action on channel output signal configuration bitfield: - 3'h0: set. - 3'h1: toggle then next threshold match action is clear. - 3'h2: set then next threshold match action is clear. - 3'h3: toggle. - 3'h4: clear. - 3'h5: toggle then next threshold match action is set. - 3'h6: clear then next threshold match action is set.
START | T2_CMD | 0 | 1 | R/W | R/W | 0x0 | ADV_TIMER2 start command bitfield.
STOP | T2_CMD | 1 | 1 | R/W | R/W | 0x0 | ADV_TIMER2 stop command bitfield.
UPDATE | T2_CMD | 2 | 1 | R/W | R/W | 0x0 | ADV_TIMER2 update command bitfield.
RESET | T2_CMD | 3 | 1 | R/W | R/W | 0x0 | ADV_TIMER2 reset command bitfield.
ARM | T2_CMD | 4 | 1 | R/W | R/W | 0x1 | ADV_TIMER2 arm command bitfield.
INSEL | T2_CONFIG | 0 | 8 | R/W | R/W | 0x0 | ADV_TIMER2 input source configuration bitfield: - 0-31: GPIO[0] to GPIO[31] - 32-35: Channel 0 to 3 of ADV_TIMER0 - 36-39: Channel 0 to 3 of ADV_TIMER1 - 40-43: Channel 0 to 3 of ADV_TIMER2 - 44-47: Channel 0 to 3 of ADV_TIMER3
MODE | T2_CONFIG | 8 | 3 | R/W | R/W | 0x1 | ADV_TIMER2 trigger mode configuration bitfield: - 3'h0: trigger event at each clock cycle. - 3'h1: trigger event if input source is 0 - 3'h2: trigger event if input source is 1 - 3'h3: trigger event on input source rising edge - 3'h4: trigger event on input source falling edge - 3'h5: trigger event on input source falling or rising edge - 3'h6: trigger event on input source rising edge when armed - 3'h7: trigger event on input source falling edge when armed
CLKSEL | T2_CONFIG | 11 | 1 | R/W | R/W | 0x0 | ADV_TIMER2 clock source configuration bitfield: - 1'b0: FLL - 1'b1: reference clock at 32kHz
UPDOWNSEL | T2_CONFIG | 12 | 1 | R/W | R/W | 0x0 | ADV_TIMER2 center-aligned mode configuration bitfield: - 1'b0: The counter counts up and down alternatively. - 1'b1: The counter counts up and resets to 0 when reach threshold.
PRESC | T2_CONFIG | 16 | 8 | R/W | R/W | 0x0 | ADV_TIMER2 prescaler value configuration bitfield.
TH_LO | T2_THRESHOLD | 0 | 16 | R/W | R/W | 0x0 | ADV_TIMER2 threshold low part configuration bitfield. It defines start counter value.
TH_HI | T2_THRESHOLD | 16 | 16 | R/W | R/W | 0x0 | ADV_TIMER2 threshold high part configuration bitfield. It defines end counter value.
TH | T2_TH_CHANNEL0 | 0 | 16 | R/W | R/W | 0x0 | ADV_TIMER2 channel 0 threshold configuration bitfield.
MODE | T2_TH_CHANNEL0 | 16 | 3 | R/W | R/W | 0x0 | ADV_TIMER2 channel 0 threshold match action on channel output signal configuration bitfield: - 3'h0: set. - 3'h1: toggle then next threshold match action is clear. - 3'h2: set then next threshold match action is clear. - 3'h3: toggle. - 3'h4: clear. - 3'h5: toggle then next threshold match action is set. - 3'h6: clear then next threshold match action is set.
TH | T2_TH_CHANNEL1 | 0 | 16 | R/W | R/W | 0x0 | ADV_TIMER2 channel 1 threshold configuration bitfield.
MODE | T2_TH_CHANNEL1 | 16 | 3 | R/W | R/W | 0x0 | ADV_TIMER2 channel 1 threshold match action on channel output signal configuration bitfield: - 3'h0: set. - 3'h1: toggle then next threshold match action is clear. - 3'h2: set then next threshold match action is clear. - 3'h3: toggle. - 3'h4: clear. - 3'h5: toggle then next threshold match action is set. - 3'h6: clear then next threshold match action is set.
TH | T2_TH_CHANNEL2 | 0 | 16 | R/W | R/W | 0x0 | ADV_TIMER2 channel 2 threshold configuration bitfield.
MODE | T2_TH_CHANNEL2 | 16 | 3 | R/W | R/W | 0x0 | ADV_TIMER2 channel 2 threshold match action on channel output signal configuration bitfield: - 3'h0: set. - 3'h1: toggle then next threshold match action is clear. - 3'h2: set then next threshold match action is clear. - 3'h3: toggle. - 3'h4: clear. - 3'h5: toggle then next threshold match action is set. - 3'h6: clear then next threshold match action is set.
TH | T2_TH_CHANNEL3 | 0 | 16 | R/W | R/W | 0x0 | ADV_TIMER2 channel 3 threshold configuration bitfield.
MODE | T2_TH_CHANNEL3 | 16 | 3 | R/W | R/W | 0x0 | ADV_TIMER2 channel 3 threshold match action on channel output signal configuration bitfield: - 3'h0: set. - 3'h1: toggle then next threshold match action is clear. - 3'h2: set then next threshold match action is clear. - 3'h3: toggle. - 3'h4: clear. - 3'h5: toggle then next threshold match action is set. - 3'h6: clear then next threshold match action is set.
START | T3_CMD | 0 | 1 | R/W | R/W | 0x0 | ADV_TIMER3 start command bitfield.
STOP | T3_CMD | 1 | 1 | R/W | R/W | 0x0 | ADV_TIMER3 stop command bitfield.
UPDATE | T3_CMD | 2 | 1 | R/W | R/W | 0x0 | ADV_TIMER3 update command bitfield.
RESET | T3_CMD | 3 | 1 | R/W | R/W | 0x0 | ADV_TIMER3 reset command bitfield.
ARM | T3_CMD | 4 | 1 | R/W | R/W | 0x1 | ADV_TIMER3 arm command bitfield.
INSEL | T3_CONFIG | 0 | 8 | R/W | R/W | 0x0 | ADV_TIMER3 input source configuration bitfield: - 0-31: GPIO[0] to GPIO[31] - 32-35: Channel 0 to 3 of ADV_TIMER0 - 36-39: Channel 0 to 3 of ADV_TIMER1 - 40-43: Channel 0 to 3 of ADV_TIMER2 - 44-47: Channel 0 to 3 of ADV_TIMER3
MODE | T3_CONFIG | 8 | 3 | R/W | R/W | 0x1 | ADV_TIMER3 trigger mode configuration bitfield: - 3'h0: trigger event at each clock cycle. - 3'h1: trigger event if input source is 0 - 3'h2: trigger event if input source is 1 - 3'h3: trigger event on input source rising edge - 3'h4: trigger event on input source falling edge - 3'h5: trigger event on input source falling or rising edge - 3'h6: trigger event on input source rising edge when armed - 3'h7: trigger event on input source falling edge when armed
CLKSEL | T3_CONFIG | 11 | 1 | R/W | R/W | 0x0 | ADV_TIMER3 clock source configuration bitfield: - 1'b0: FLL - 1'b1: reference clock at 32kHz
UPDOWNSEL | T3_CONFIG | 12 | 1 | R/W | R/W | 0x0 | ADV_TIMER3 center-aligned mode configuration bitfield: - 1'b0: The counter counts up and down alternatively. - 1'b1: The counter counts up and resets to 0 when reach threshold.
PRESC | T3_CONFIG | 16 | 8 | R/W | R/W | 0x0 | ADV_TIMER3 prescaler value configuration bitfield.
TH_LO | T3_THRESHOLD | 0 | 16 | R/W | R/W | 0x0 | ADV_TIMER3 threshold low part configuration bitfield. It defines start counter value.
TH_HI | T3_THRESHOLD | 16 | 16 | R/W | R/W | 0x0 | ADV_TIMER3 threshold high part configuration bitfield. It defines end counter value.
TH | T3_TH_CHANNEL0 | 0 | 16 | R/W | R/W | 0x0 | ADV_TIMER3 channel 0 threshold configuration bitfield.
MODE | T3_TH_CHANNEL0 | 16 | 3 | R/W | R/W | 0x0 | ADV_TIMER3 channel 0 threshold match action on channel output signal configuration bitfield: - 3'h0: set. - 3'h1: toggle then next threshold match action is clear. - 3'h2: set then next threshold match action is clear. - 3'h3: toggle. - 3'h4: clear. - 3'h5: toggle then next threshold match action is set. - 3'h6: clear then next threshold match action is set.
TH | T3_TH_CHANNEL1 | 0 | 16 | R/W | R/W | 0x0 | ADV_TIMER3 channel 1 threshold configuration bitfield.
MODE | T3_TH_CHANNEL1 | 16 | 3 | R/W | R/W | 0x0 | ADV_TIMER3 channel 1 threshold match action on channel output signal configuration bitfield: - 3'h0: set. - 3'h1: toggle then next threshold match action is clear. - 3'h2: set then next threshold match action is clear. - 3'h3: toggle. - 3'h4: clear. - 3'h5: toggle then next threshold match action is set. - 3'h6: clear then next threshold match action is set.
TH | T3_TH_CHANNEL2 | 0 | 16 | R/W | R/W | 0x0 | ADV_TIMER3 channel 2 threshold configuration bitfield.
MODE | T3_TH_CHANNEL2 | 16 | 3 | R/W | R/W | 0x0 | ADV_TIMER3 channel 2 threshold match action on channel output signal configuration bitfield: - 3'h0: set. - 3'h1: toggle then next threshold match action is clear. - 3'h2: set then next threshold match action is clear. - 3'h3: toggle. - 3'h4: clear. - 3'h5: toggle then next threshold match action is set. - 3'h6: clear then next threshold match action is set.
TH | T3_TH_CHANNEL3 | 0 | 16 | R/W | R/W | 0x0 | ADV_TIMER3 channel 3 threshold configuration bitfield.
MODE | T3_TH_CHANNEL3 | 16 | 3 | R/W | R/W | 0x0 | ADV_TIMER3 channel 3 threshold match action on channel output signal configuration bitfield: - 3'h0: set. - 3'h1: toggle then next threshold match action is clear. - 3'h2: set then next threshold match action is clear. - 3'h3: toggle. - 3'h4: clear. - 3'h5: toggle then next threshold match action is set. - 3'h6: clear then next threshold match action is set.
SEL0 | EVENT_CFG | 0 | 4 | R/W | R/W |  | ADV_TIMER output event 0 source configuration bitfiled: - 4'h0: ADV_TIMER0 channel 0. - 4'h1: ADV_TIMER0 channel 1. - 4'h2: ADV_TIMER0 channel 2. - 4'h3: ADV_TIMER0 channel 3. - 4'h4: ADV_TIMER1 channel 0. - 4'h5: ADV_TIMER1 channel 1. - 4'h6: ADV_TIMER1 channel 2. - 4'h7: ADV_TIMER1 channel 3. - 4'h8: ADV_TIMER2 channel 0. - 4'h9: ADV_TIMER2 channel 1. - 4'hA: ADV_TIMER2 channel 2. - 4'hB: ADV_TIMER2 channel 3. - 4'hC: ADV_TIMER3 channel 0. - 4'hD: ADV_TIMER3 channel 1. - 4'hE: ADV_TIMER3 channel 2. - 4'hF: ADV_TIMER3 channel 3.
SEL1 | EVENT_CFG | 4 | 4 | R/W | R/W |  | ADV_TIMER output event 1 source configuration bitfiled: - 4'h0: ADV_TIMER0 channel 0. - 4'h1: ADV_TIMER0 channel 1. - 4'h2: ADV_TIMER0 channel 2. - 4'h3: ADV_TIMER0 channel 3. - 4'h4: ADV_TIMER1 channel 0. - 4'h5: ADV_TIMER1 channel 1. - 4'h6: ADV_TIMER1 channel 2. - 4'h7: ADV_TIMER1 channel 3. - 4'h8: ADV_TIMER2 channel 0. - 4'h9: ADV_TIMER2 channel 1. - 4'hA: ADV_TIMER2 channel 2. - 4'hB: ADV_TIMER2 channel 3. - 4'hC: ADV_TIMER3 channel 0. - 4'hD: ADV_TIMER3 channel 1. - 4'hE: ADV_TIMER3 channel 2. - 4'hF: ADV_TIMER3 channel 3.
SEL2 | EVENT_CFG | 8 | 4 | R/W | R/W |  | ADV_TIMER output event 2 source configuration bitfiled: - 4'h0: ADV_TIMER0 channel 0. - 4'h1: ADV_TIMER0 channel 1. - 4'h2: ADV_TIMER0 channel 2. - 4'h3: ADV_TIMER0 channel 3. - 4'h4: ADV_TIMER1 channel 0. - 4'h5: ADV_TIMER1 channel 1. - 4'h6: ADV_TIMER1 channel 2. - 4'h7: ADV_TIMER1 channel 3. - 4'h8: ADV_TIMER2 channel 0. - 4'h9: ADV_TIMER2 channel 1. - 4'hA: ADV_TIMER2 channel 2. - 4'hB: ADV_TIMER2 channel 3. - 4'hC: ADV_TIMER3 channel 0. - 4'hD: ADV_TIMER3 channel 1. - 4'hE: ADV_TIMER3 channel 2. - 4'hF: ADV_TIMER3 channel 3.
SEL3 | EVENT_CFG | 12 | 4 | R/W | R/W |  | ADV_TIMER output event 3 source configuration bitfiled: - 4'h0: ADV_TIMER0 channel 0. - 4'h1: ADV_TIMER0 channel 1. - 4'h2: ADV_TIMER0 channel 2. - 4'h3: ADV_TIMER0 channel 3. - 4'h4: ADV_TIMER1 channel 0. - 4'h5: ADV_TIMER1 channel 1. - 4'h6: ADV_TIMER1 channel 2. - 4'h7: ADV_TIMER1 channel 3. - 4'h8: ADV_TIMER2 channel 0. - 4'h9: ADV_TIMER2 channel 1. - 4'hA: ADV_TIMER2 channel 2. - 4'hB: ADV_TIMER2 channel 3. - 4'hC: ADV_TIMER3 channel 0. - 4'hD: ADV_TIMER3 channel 1. - 4'hE: ADV_TIMER3 channel 2. - 4'hF: ADV_TIMER3 channel 3.
ENA | EVENT_CFG | 16 | 4 | R/W | R/W |  | ADV_TIMER output event enable configuration bitfield. ENA[i]=1 enables output event i generation.
ENA | CG | 0 | 16 | R/W | R/W | 0x0 | ADV_TIMER clock gating configuration bitfield. - ENA[i]=0: clock gate ADV_TIMERi. - ENA[i]=1: enable ADV_TIMERi.

Sheet: VerPlan_rel1.0.0
Name | Description | testcase location&name | Status
