pulp-platform/pulp/doc/IP_REFERENCES/APB_GPIO_reference.xlsx

Sheet: Info
Document Information
Name | APB_GPIO reference
Category | IP reference
Author | Florent Rotenberg
Version | 1.0
Status | Fisrt Release
Description | APB_GPIO interface definition
IP Information
IP type | APB_GPIO
Delivery Type
History
Date | Modification | Author
26/10/2016 | 1st release | F.Rotenberg
Content
Info | This sheet. General information about document usage
Usage | Guidelines on how to used the various sheet
IP Release | Release information sheet describing
IPIF_relx.x | IP interface description reference, describing IP symbol/entity and integration and test information relative to IP interface.
IPDESCR_Relx.x | Description of the main features of the IP
IPREGLIST_rely.y | Description of the list of registers used by IP. Registers can be physically instanciated inside IP or outside IP.
IPREGMAP_relz.z | Description of mapping of bit fields when registers are internal to IP. This sheet is optional for IP which are not instanciating registers as information can be build from IPIF and IPRELIST sheet.
IPTREGMAP_relz.z | Description of mapping of test bit field when registers are internal to IP. This sheet is optional for IP which are not instanciating registers as information can be build from IPIF and IPRELIST sheet.
IPUDMACMDLIST_relz.z | Description of IP UDMA commands list used by IP.
IPUDMACMDMAP_relz.z | Description of mapping of bit fields in IP UDMA commands used by IP.

Sheet: Usage
IP Release Sheet
 | Column | Description | Possible Value
 | Version | IP release version numeroted as [major release].[minor release]. A release is major whenever IP interface is modified. | X.Y. Z
 | Release description | This is a free text entry expliciting the release main modifications and purpose. | Text
 | IPIF | IPIF sheet version to be used for this release. | X.Y. Z
 | IPDESCR | IPDESCR sheet version to nbe used for this release | X.Y.Z
 | IPREGLIST | IPREGLIST sheet version to be used for this release. | X.Y. Z
 | IPREGMAP | IPREGMAP sheet version to be used for this release. | X.Y. Z
 | IPUDMACMDLIST | IPUDMACMDLIST sheet version to be used for this release. | X.Y. Z
 | IPUDMACMDMAP | IPUDMACMDMAP sheet version to be used for this release. | X.Y. Z
 | IPDOC | IPDOC version to be used for this release. | X.Y. Z
 | GIT version | GIT database number corresponding to IP design code and IP reference XLS. | Integer
IPIF sheet
IP Interface description | IP Pin Name | Name of IP Pin. This must must exactly name find in code or schematic (including case).
 | Direction | Direction or type of signal | In,Out,IO
 | Type | Analog, Digital, supply, DR (Dual Rail), SR (SingleRail) | Analog,Digital, VDD, GND, DR, SR
 | Voltage Domain
 | Clock domain
 | IO
 | Size
 | Reset Value
 | Description
Integration information | Integration comment
 | Core Interface
 | Register Interface
 | Register name
 | DFT value
 | Level Shifter
 | Isolation cell
 | Connected to
 | Load
 | Drive
 | Destination supply
Hard Macro information | location
 | layer
 | Antenna
Additonal Information | FreeText 1
 | FreeText 2
Driver information | Function1
 | Function2

Sheet: IP Release
Version | Release description | IPIF | IPDESCR | IPREGLIST | IPREGMAP | IPUDMACMDLIST | IPUDMACMDMAP | IPDOC | GIT version
1.0.0 |  | Rel1.0.0 | Rel1.0.0 | Rel1.0.0 | Rel1.0.0 | Rel1.0.0 | Rel1.0.0

Sheet: IPIF_rel1.0.0
IP Interface description |  |  |  |  |  |  |  |  | Integration information |  |  |  |  |  |  |  |  |  |  |  |  | Hard Macro information |  |  | Additonal Information |  | Driver information
IP Pin Name | Direction | Type | Voltage Domain | Clock domain | IO | Size | Reset Value | Description | Integration comment | Core Interface | Register Interface | Register name | Bit position | Trim during production | DFT value | Level Shifter | Isolation cell | Connected to | Load | Drive | Destination supply | location | layer | Antenna | FreeText 1 | FreeText 2 | Function1 | Function2

Sheet: IPDESCR_rel1.0.0
Description
GPIO component manages the following features: - 32 general purpose input/ouput pads - configurable pull and drive strength on each GPIOs - configurable event trigger on GPIO event

Sheet: IPREGLIST_rel1.0.0
Register Name | Address | Size | Register Type | Host Access Type | IP access Type | Default Value | Description | FootNote | Comment
PADDIR | 0x0 | 32 | Config | R/W | R/W | 0x0 | GPIO pad direction configuration register.
PADIN | 0x4 | 32 | Config | R | W | 0x0 | GPIO pad input value register.
PADOUT | 0x8 | 32 | Config | R/W | R/W | 0x0 | GPIO pad output value register.
INTEN | 0xC | 32 | Config | R/W | R/W | 0x0 | GPIO pad interrupt enable configuration register.
INTTYPE0 | 0x10 | 32 | Config | R/W | R/W | 0x0 | GPIO pad interrupt type bit 0 configuration register.
INTTYPE1 | 0x14 | 32 | Config | R/W | R/W | 0x0 | GPIO pad interrupt type bit 1 configuration register.
INTSTATUS | 0x18 | 32 | Status | R | W | 0x0 | GPIO pad interrupt status register.
GPIOEN | 0x1C | 32 | Config | R/W | R/W | 0x0 | GPIO pad enable configuration register.
PADCFG0 | 0x20 | 32 | Config | R/W | R/W | 0x0 | GPIO pad pin 0 to 3 configuration register.
PADCFG1 | 0x24 | 32 | Config | R/W | R/W | 0x0 | GPIO pad pin 4 to 7 configuration register.
PADCFG2 | 0x28 | 32 | Config | R/W | R/W | 0x0 | GPIO pad pin 8 to 11 configuration register.
PADCFG3 | 0x2C | 32 | Config | R/W | R/W | 0x0 | GPIO pad pin 12 to 15 configuration register.
PADCFG4 | 0x30 | 32 | Config | R/W | R/W | 0x0 | GPIO pad pin 16 to 19 configuration register.
PADCFG5 | 0x34 | 32 | Config | R/W | R/W | 0x0 | GPIO pad pin 20 to 23 configuration register.
PADCFG6 | 0x38 | 32 | Config | R/W | R/W | 0x0 | GPIO pad pin 24 to 27 configuration register.
PADCFG7 | 0x3C | 32 | Config | R/W | R/W | 0x0 | GPIO pad pin 28 to 31 configuration register.

Sheet: IPREGMAP_rel1.0.0
Bit field | Register | Bit Position | Size | Host Access Type | IP access Type | Reset Value | Description
DIR | PADDIR | 0 | 32 | R/W | R | 0x0 | GPIO direction configuration bitfield: - bit[i]=1'b0: Input mode for GPIO[i] - bit[i]=1'b1: Output mode for GPIO[i]
DATA_IN | PADIN | 0 | 32 | R | W | 0x0 | GPIO input data read bitfield. DATA_IN[i] corresponds to input data of GPIO[i].
DATA_OUT | PADOUT | 0 | 32 | R/W | R | 0x0 | GPIO output data read bitfield. DATA_OUT[i] corresponds to output data set on GPIO[i].
INTEN | INTEN | 0 | 32 | R/W | R | 0x0 | GPIO interrupt enable configuration bitfield: - bit[i]=1'b0: disable interrupt for GPIO[i] - bit[i]=1'b1: enable interrupt for GPIO[i]
INTTYPE0 | INTTYPE0 | 0 | 32 | R/W | R | 0x0 | GPIO[15:0] interrupt type configuration bitfield: - bit[2*i+1:2*i]=2'b00: interrupt on falling edge for GPIO[i] - bit[2*i+1:2*i]=2'b01: interrupt on rising edge for GPIO[i] - bit[2*i+1:2*i]=2'b10: interrupt on rising and falling edge for GPIO[i] - bit[2*i+1:2*i]=2'b11: RFU
INTTYPE1 | INTTYPE1 | 0 | 32 | R/W | R | 0x0 | GPIO[31:16] interrupt type configuration bitfield: - bit[2*i+1:2*i]=2'b00: interrupt on falling edge for GPIO[16+i] - bit[2*i+1:2*i]=2'b01: interrupt on rising edge for GPIO[16+i] - bit[2*i+1:2*i]=2'b10: interrupt on rising and falling edge for GPIO[16+i] - bit[2*i+1:2*i]=2'b11: RFU
INTSTATUS | INTSTATUS | 0 | 32 | R | W | 0x0 | GPIO Interrupt status flags bitfield. INTSTATUS[i]=1 when interrupt received on GPIO[i]. INTSTATUS is cleared when it is red. GPIO interrupt line is also cleared when INTSTATUS register is red.
GPIOEN | GPIOEN | 0 | 32 | R/W | R | 0x0 | GPIO clock enable configuration bitfield: - bit[i]=1'b0: disable clock for GPIO[i] - bit[i]=1'b1: enable clock for GPIO[i] GPIOs are gathered by groups of 4. The clock gating of one group is done only if all 4 GPIOs are disabled. Clock must be enabled for a GPIO if it's direction is configured in input mode.
GPIO0_PE | PADCFG0 | 0 | 1 | R/W | R | 0x0 | GPIO[0] pull activation configuration bitfield: - 1'b0: pull disabled - 1'b1: pull enabled
GPIO0_DS | PADCFG0 | 1 | 1 | R/W | R | 0x0 | GPIO[0] drive strength configuration bitfield: - 1'b0: low drive strength - 1'b1: high drive strength
GPIO1_PE | PADCFG0 | 8 | 1 | R/W | R | 0x0 | GPIO[1] pull activation configuration bitfield: - 1'b0: pull disabled - 1'b1: pull enabled
GPIO1_DS | PADCFG0 | 9 | 1 | R/W | R | 0x0 | GPIO[1] drive strength configuration bitfield: - 1'b0: low drive strength - 1'b1: high drive strength
GPIO2_PE | PADCFG0 | 16 | 1 | R/W | R | 0x0 | GPIO[2] pull activation configuration bitfield: - 1'b0: pull disabled - 1'b1: pull enabled
GPIO2_DS | PADCFG0 | 17 | 1 | R/W | R | 0x0 | GPIO[2] drive strength configuration bitfield: - 1'b0: low drive strength - 1'b1: high drive strength
GPIO3_PE | PADCFG0 | 24 | 1 | R/W | R | 0x0 | GPIO[3] pull activation configuration bitfield: - 1'b0: pull disabled - 1'b1: pull enabled
GPIO3_DS | PADCFG0 | 25 | 1 | R/W | R | 0x0 | GPIO[3] drive strength configuration bitfield: - 1'b0: low drive strength - 1'b1: high drive strength
GPIO4_PE | PADCFG1 | 0 | 1 | R/W | R | 0x0 | GPIO[4] pull activation configuration bitfield: - 1'b0: pull disabled - 1'b1: pull enabled
GPIO4_DS | PADCFG1 | 1 | 1 | R/W | R | 0x0 | GPIO[4] drive strength configuration bitfield: - 1'b0: low drive strength - 1'b1: high drive strength
GPIO5_PE | PADCFG1 | 8 | 1 | R/W | R | 0x0 | GPIO[5] pull activation configuration bitfield: - 1'b0: pull disabled - 1'b1: pull enabled
GPIO5_DS | PADCFG1 | 9 | 1 | R/W | R | 0x0 | GPIO[5] drive strength configuration bitfield: - 1'b0: low drive strength - 1'b1: high drive strength
GPIO6_PE | PADCFG1 | 16 | 1 | R/W | R | 0x0 | GPIO[6] pull activation configuration bitfield: - 1'b0: pull disabled - 1'b1: pull enabled
GPIO6_DS | PADCFG1 | 17 | 1 | R/W | R | 0x0 | GPIO[6] drive strength configuration bitfield: - 1'b0: low drive strength - 1'b1: high drive strength
GPIO7_PE | PADCFG1 | 24 | 1 | R/W | R | 0x0 | GPIO[7] pull activation configuration bitfield: - 1'b0: pull disabled - 1'b1: pull enabled
GPIO7_DS | PADCFG1 | 25 | 1 | R/W | R | 0x0 | GPIO[7] drive strength configuration bitfield: - 1'b0: low drive strength - 1'b1: high drive strength
GPIO8_PE | PADCFG2 | 0 | 1 | R/W | R | 0x0 | GPIO[8] pull activation configuration bitfield: - 1'b0: pull disabled - 1'b1: pull enabled
GPIO8_DS | PADCFG2 | 1 | 1 | R/W | R | 0x0 | GPIO[8] drive strength configuration bitfield: - 1'b0: low drive strength - 1'b1: high drive strength
GPIO9_PE | PADCFG2 | 8 | 1 | R/W | R | 0x0 | GPIO[9] pull activation configuration bitfield: - 1'b0: pull disabled - 1'b1: pull enabled
GPIO9_DS | PADCFG2 | 9 | 1 | R/W | R | 0x0 | GPIO[9] drive strength configuration bitfield: - 1'b0: low drive strength - 1'b1: high drive strength
GPIO10_PE | PADCFG2 | 16 | 1 | R/W | R | 0x0 | GPIO[10] pull activation configuration bitfield: - 1'b0: pull disabled - 1'b1: pull enabled
GPIO10_DS | PADCFG2 | 17 | 1 | R/W | R | 0x0 | GPIO[10] drive strength configuration bitfield: - 1'b0: low drive strength - 1'b1: high drive strength
GPIO11_PE | PADCFG2 | 24 | 1 | R/W | R | 0x0 | GPIO[11] pull activation configuration bitfield: - 1'b0: pull disabled - 1'b1: pull enabled
GPIO11_DS | PADCFG2 | 25 | 1 | R/W | R | 0x0 | GPIO[11] drive strength configuration bitfield: - 1'b0: low drive strength - 1'b1: high drive strength
GPIO12_PE | PADCFG3 | 0 | 1 | R/W | R | 0x0 | GPIO[12] pull activation configuration bitfield: - 1'b0: pull disabled - 1'b1: pull enabled
GPIO12_DS | PADCFG3 | 1 | 1 | R/W | R | 0x0 | GPIO[12] drive strength configuration bitfield: - 1'b0: low drive strength - 1'b1: high drive strength
GPIO13_PE | PADCFG3 | 8 | 1 | R/W | R | 0x0 | GPIO[13] pull activation configuration bitfield: - 1'b0: pull disabled - 1'b1: pull enabled
GPIO13_DS | PADCFG3 | 9 | 1 | R/W | R | 0x0 | GPIO[13] drive strength configuration bitfield: - 1'b0: low drive strength - 1'b1: high drive strength
GPIO14_PE | PADCFG3 | 16 | 1 | R/W | R | 0x0 | GPIO[14] pull activation configuration bitfield: - 1'b0: pull disabled - 1'b1: pull enabled
GPIO14_DS | PADCFG3 | 17 | 1 | R/W | R | 0x0 | GPIO[14] drive strength configuration bitfield: - 1'b0: low drive strength - 1'b1: high drive strength
GPIO15_PE | PADCFG3 | 24 | 1 | R/W | R | 0x0 | GPIO[15] pull activation configuration bitfield: - 1'b0: pull disabled - 1'b1: pull enabled
GPIO15_DS | PADCFG3 | 25 | 1 | R/W | R | 0x0 | GPIO[15] drive strength configuration bitfield: - 1'b0: low drive strength - 1'b1: high drive strength
GPIO16_PE | PADCFG4 | 0 | 1 | R/W | R | 0x0 | GPIO[16] pull activation configuration bitfield: - 1'b0: pull disabled - 1'b1: pull enabled
GPIO16_DS | PADCFG4 | 1 | 1 | R/W | R | 0x0 | GPIO[16] drive strength configuration bitfield: - 1'b0: low drive strength - 1'b1: high drive strength
GPIO17_PE | PADCFG4 | 8 | 1 | R/W | R | 0x0 | GPIO[17] pull activation configuration bitfield: - 1'b0: pull disabled - 1'b1: pull enabled
GPIO17_DS | PADCFG4 | 9 | 1 | R/W | R | 0x0 | GPIO[17] drive strength configuration bitfield: - 1'b0: low drive strength - 1'b1: high drive strength
GPIO18_PE | PADCFG4 | 16 | 1 | R/W | R | 0x0 | GPIO[18] pull activation configuration bitfield: - 1'b0: pull disabled - 1'b1: pull enabled
GPIO18_DS | PADCFG4 | 17 | 1 | R/W | R | 0x0 | GPIO[18] drive strength configuration bitfield: - 1'b0: low drive strength - 1'b1: high drive strength
GPIO19_PE | PADCFG4 | 24 | 1 | R/W | R | 0x0 | GPIO[19] pull activation configuration bitfield: - 1'b0: pull disabled - 1'b1: pull enabled
GPIO19_DS | PADCFG4 | 25 | 1 | R/W | R | 0x0 | GPIO[19] drive strength configuration bitfield: - 1'b0: low drive strength - 1'b1: high drive strength
GPIO20_PE | PADCFG5 | 0 | 1 | R/W | R | 0x0 | GPIO[20] pull activation configuration bitfield: - 1'b0: pull disabled - 1'b1: pull enabled
GPIO20_DS | PADCFG5 | 1 | 1 | R/W | R | 0x0 | GPIO[20] drive strength configuration bitfield: - 1'b0: low drive strength - 1'b1: high drive strength
GPIO21_PE | PADCFG5 | 8 | 1 | R/W | R | 0x0 | GPIO[21] pull activation configuration bitfield: - 1'b0: pull disabled - 1'b1: pull enabled
GPIO21_DS | PADCFG5 | 9 | 1 | R/W | R | 0x0 | GPIO[21] drive strength configuration bitfield: - 1'b0: low drive strength - 1'b1: high drive strength
GPIO22_PE | PADCFG5 | 16 | 1 | R/W | R | 0x0 | GPIO[22] pull activation configuration bitfield: - 1'b0: pull disabled - 1'b1: pull enabled
GPIO22_DS | PADCFG5 | 17 | 1 | R/W | R | 0x0 | GPIO[22] drive strength configuration bitfield: - 1'b0: low drive strength - 1'b1: high drive strength
GPIO23_PE | PADCFG5 | 24 | 1 | R/W | R | 0x0 | GPIO[23] pull activation configuration bitfield: - 1'b0: pull disabled - 1'b1: pull enabled
GPIO23_DS | PADCFG5 | 25 | 1 | R/W | R | 0x0 | GPIO[23] drive strength configuration bitfield: - 1'b0: low drive strength - 1'b1: high drive strength
GPIO24_PE | PADCFG6 | 0 | 1 | R/W | R | 0x0 | GPIO[24] pull activation configuration bitfield: - 1'b0: pull disabled - 1'b1: pull enabled
GPIO24_DS | PADCFG6 | 1 | 1 | R/W | R | 0x0 | GPIO[24] drive strength configuration bitfield: - 1'b0: low drive strength - 1'b1: high drive strength
GPIO25_PE | PADCFG6 | 8 | 1 | R/W | R | 0x0 | GPIO[25] pull activation configuration bitfield: - 1'b0: pull disabled - 1'b1: pull enabled
GPIO25_DS | PADCFG6 | 9 | 1 | R/W | R | 0x0 | GPIO[25] drive strength configuration bitfield: - 1'b0: low drive strength - 1'b1: high drive strength
GPIO26_PE | PADCFG6 | 16 | 1 | R/W | R | 0x0 | GPIO[26] pull activation configuration bitfield: - 1'b0: pull disabled - 1'b1: pull enabled
GPIO26_DS | PADCFG6 | 17 | 1 | R/W | R | 0x0 | GPIO[26] drive strength configuration bitfield: - 1'b0: low drive strength - 1'b1: high drive strength
GPIO27_PE | PADCFG6 | 24 | 1 | R/W | R | 0x0 | GPIO[27] pull activation configuration bitfield: - 1'b0: pull disabled - 1'b1: pull enabled
GPIO27_DS | PADCFG6 | 25 | 1 | R/W | R | 0x0 | GPIO[27] drive strength configuration bitfield: - 1'b0: low drive strength - 1'b1: high drive strength
GPIO28_PE | PADCFG7 | 0 | 1 | R/W | R | 0x0 | GPIO[28] pull activation configuration bitfield: - 1'b0: pull disabled - 1'b1: pull enabled
GPIO28_DS | PADCFG7 | 1 | 1 | R/W | R | 0x0 | GPIO[28] drive strength configuration bitfield: - 1'b0: low drive strength - 1'b1: high drive strength
GPIO29_PE | PADCFG7 | 8 | 1 | R/W | R | 0x0 | GPIO[29] pull activation configuration bitfield: - 1'b0: pull disabled - 1'b1: pull enabled
GPIO29_DS | PADCFG7 | 9 | 1 | R/W | R | 0x0 | GPIO[29] drive strength configuration bitfield: - 1'b0: low drive strength - 1'b1: high drive strength
GPIO30_PE | PADCFG7 | 16 | 1 | R/W | R | 0x0 | GPIO[30] pull activation configuration bitfield: - 1'b0: pull disabled - 1'b1: pull enabled
GPIO30_DS | PADCFG7 | 17 | 1 | R/W | R | 0x0 | GPIO[30] drive strength configuration bitfield: - 1'b0: low drive strength - 1'b1: high drive strength
GPIO31_PE | PADCFG7 | 24 | 1 | R/W | R | 0x0 | GPIO[31] pull activation configuration bitfield: - 1'b0: pull disabled - 1'b1: pull enabled
GPIO31_DS | PADCFG7 | 25 | 1 | R/W | R | 0x0 | GPIO[31] drive strength configuration bitfield: - 1'b0: low drive strength - 1'b1: high drive strength

Sheet: IPUDMACMDLIST_rel1.0.0
Command name | Parameter | Description

Sheet: IPUDMACMDMAP_rel1.0.0
Parameter Bit field | Command name | Bit Position | Size | Reset Value | Description

Sheet: VerPlan_rel1.0.0
Name | Description | testcase location&name | Status
