pulp-platform/pulp/doc/IP_REFERENCES/CL_EVENT_UNIT_reference.xlsx

Sheet: Info
Document Information
Name | CL_EVENT_UNIT reference
Category | IP reference
Author | Florent Rotenberg
Version | 1.0
Status | Fisrt Release
Description | CL_EVENT_UNIT interface definition
IP Information
IP type | CL_EVENT_UNIT
Delivery Type
History
Date | Modification | Author
26/10/2016 | 1strelease | F.Rotenberg
Content
Info | This sheet. General information about document usage
Usage | Guidelines on how to used the various sheet
IP Release | Release information sheet describing
IPIF_relx.x | IP interface description reference, describing IP symbol/entity and integration and test information relative to IP interface.
IPDESCR_Relx.x | Description of the main features of the IP
IPREGLIST_rely.y | Description of the list of registers used by IP. Registers can be physically instanciated inside IP or outside IP.
IPREGMAP_relz.z | Description of mapping of bit fields when registers are internal to IP. This sheet is optional for IP which are not instanciating registers as information can be build from IPIF and IPRELIST sheet.
IPTREGMAP_relz.z | Description of mapping of test bit field when registers are internal to IP. This sheet is optional for IP which are not instanciating registers as information can be build from IPIF and IPRELIST sheet.

Sheet: Usage
IP Release Sheet
 | Column | Description | Possible Value
 | Version | IP release version numeroted as [major release].[minor release]. A release is major whenever IP interface is modified. | X.Y. Z
 | Release description | This is a free text entry expliciting the release main modifications and purpose. | Text
 | IPIF | IPIF sheet version to be used for this release. | X.Y. Z
 | IPDESCR | IPDESCR sheet version to nbe used for this release | X.Y.Z
 | IPREGLIST | IPREGLIST sheet version to be used for this release. | X.Y. Z
 | IPREGMAP | IPREGMAP sheet version to be used for this release. | X.Y. Z
 | IPDOC | IPDOC version to be used for this release. | X.Y. Z
 | GIT version | GIT database number corresponding to IP design code and IP reference XLS. | Integer
IPIF sheet
IP Interface description | IP Pin Name | Name of IP Pin. This must must exactly name find in code or schematic (including case).
 | Direction | Direction or type of signal | In,Out,IO
 | Type | Analog, Digital, supply, DR (Dual Rail), SR (SingleRail) | Analog,Digital, VDD, GND, DR, SR
 | Voltage Domain
 | Clock domain
 | IO
 | Size
 | Reset Value
 | Description
Integration information | Integration comment
 | Core Interface
 | Register Interface
 | Register name
 | DFT value
 | Level Shifter
 | Isolation cell
 | Connected to
 | Load
 | Drive
 | Destination supply
Hard Macro information | location
 | layer
 | Antenna
Additonal Information | FreeText 1
 | FreeText 2
Driver information | Function1
 | Function2

Sheet: IP Release
Version | Release description | IPIF | IPDESCR | IPREGLIST | IPREGMAP | IPDOC | GIT version
1.0.0 |  | Rel1.0.0 | Rel1.0.0 | Rel1.0.0 | Rel1.0.0

Sheet: IPIF_rel1.0.0
IP Interface description |  |  |  |  |  |  |  |  | Integration information |  |  |  |  |  |  |  |  |  |  |  |  | Hard Macro information |  |  | Additonal Information |  | Driver information
IP Pin Name | Direction | Type | Voltage Domain | Clock domain | IO | Size | Reset Value | Description | Integration comment | Core Interface | Register Interface | Register name | Bit position | Trim during production | DFT value | Level Shifter | Isolation cell | Connected to | Load | Drive | Destination supply | location | layer | Antenna | FreeText 1 | FreeText 2 | Function1 | Function2
clk_i | IN | digital
rstn_i | IN | digital

Sheet: IPDESCR_rel1.0.0
Description
Cluster event unit component manages the following features: - Cluster software events generation - Cluster cores clock gate control - Wait for event functionality - Input event mask configuration - Cluster cores IRQ generation - 2 hardware mutex - 8 hardware barriers - 1 message dispatcher
Events managed by Cluster event unit are: - 1 SoC peripheral event: when this event occurs, the SoC peripheral events fifo must be read to get the SoC event ID. - 1 message dispatcher event - 1 barrier event - up to 4 hardware accelerator events - 2 Cluster timer events - 2 DMA events - 8 software events that can come from cluster cores directly or external triggering.

Sheet: IPREGLIST_rel1.0.0
Register Name | Header | periph base address coreid offset | periph base address offset | demux base address offset | Address | Size | Register Type | Host Access Type | Host access bus | IP access Type | Default Value | Description | FootNote | Comment
EVT_MASK |  | 0x40 | 0x0 | 0x0 | 0x0 | 32 | Config | R/W | PERIPH/DEMUX | R/W | 0x0 | Input event mask configuration register.
EVT_MASK_AND |  | 0x40 | 0x0 | 0x0 | 0x4 | 32 | Config | W | PERIPH/DEMUX | R | 0x0 | Input event mask update command register with bitwise AND operation.
EVT_MASK_OR |  | 0x40 | 0x0 | 0x0 | 0x8 | 32 | Config | W | PERIPH/DEMUX | R | 0x0 | Input event mask update command register with bitwise OR operation.
IRQ_MASK |  | 0x40 | 0x0 | 0x0 | 0xC | 32 | Config | R/W | PERIPH/DEMUX | R/W | 0x0 | Interrupt request mask configuration register.
IRQ_MASK_AND |  | 0x40 | 0x0 | 0x0 | 0x10 | 32 | Config | W | PERIPH/DEMUX | R | 0x0 | Interrupt request mask update command register with bitwise AND operation.
IRQ_MASK_OR |  | 0x40 | 0x0 | 0x0 | 0x14 | 32 | Config | W | PERIPH/DEMUX | R | 0x0 | Interrupt request mask update command register with bitwise OR operation.
CLOCK_STATUS |  | 0x40 | 0x0 | 0x0 | 0x18 | 32 | Config | R | PERIPH/DEMUX | W | 0x0 | Cluster cores clock status register.
EVENT_BUFFER |  | 0x40 | 0x0 | 0x0 | 0x1C | 32 | Config | R | PERIPH/DEMUX | W | 0x0 | Pending input events status register.
EVENT_BUFFER_MASKED |  | 0x40 | 0x0 | 0x0 | 0x20 | 32 | Config | R | PERIPH/DEMUX | W | 0x0 | Pending input events status register with EVT_MASK applied.
EVENT_BUFFER_IRQ_MASKED |  | 0x40 | 0x0 | 0x0 | 0x24 | 32 | Config | R | PERIPH/DEMUX | W | 0x0 | Pending input events status register with IRQ_MASK applied.
EVENT_BUFFER_CLEAR |  | 0x40 | 0x0 | 0x0 | 0x28 | 32 | Config | W | PERIPH/DEMUX | R | 0x0 | Pending input events status clear command register.
SW_EVENT_MASK |  | 0x40 | 0x0 | 0x0 | 0x2C | 32 | Config | R/W | PERIPH/DEMUX | R/W | 0x0 | Software events cluster cores destination mask configuration register.
SW_EVENT_MASK_AND |  | 0x40 | 0x0 | 0x0 | 0x30 | 32 | Config | W | PERIPH/DEMUX | R | 0x0 | Software events cluster cores destination mask update command register with bitwise AND operation.
SW_EVENT_MASK_OR |  | 0x40 | 0x0 | 0x0 | 0x34 | 32 | Config | W | PERIPH/DEMUX | R | 0x0 | Software events cluster cores destination mask update command register with bitwise OR operation.
EVENT_WAIT |  |  |  | 0x0 | 0x38 | 32 | Config | R | DEMUX | W | 0x0 | Input event wait command register.
EVENT_WAIT_CLEAR |  |  |  | 0x0 | 0x3C | 32 | Config | R | DEMUX | W | 0x0 | Input event wait and clear command register.
HW_DISPATCH_PUSH_TASK |  |  |  | 0x80 | 0x0 | 32 | Config | W | DEMUX | R | 0x0 | Hardware task dispatcher push command register.
HW_DISPATCH_POP_TASK |  |  |  | 0x80 | 0x0 | 32 | Config | R | DEMUX | W | 0x0 | Hardware task dispatcher pop command register.
HW_DISPATCH_PUSH_TEAM_CONFIG |  |  |  | 0x80 | 0x4 | 32 | Config | W | DEMUX | R | 0x0 | Hardware task dispatcher cluster core team configuration register.
HW_MUTEX_0_MSG_PUT |  |  |  | 0xC0 | 0x0 | 32 | Config | W | DEMUX | R | 0x0 | Hardware mutex 0 non-blocking put command register.
HW_MUTEX_0_MSG_GET |  |  |  | 0xC0 | 0x0 | 32 | Config | R | DEMUX | W | 0x0 | Hardware mutex 0 blocking get command register.
HW_MUTEX_1_MSG_PUT |  |  |  | 0xC0 | 0x4 | 32 | Config | W | DEMUX | R | 0x0 | Hardware mutex 1 non-blocking put command register.
HW_MUTEX_1_MSG_GET |  |  |  | 0xC0 | 0x4 | 32 | Config | R | DEMUX | W | 0x0 | Hardware mutex 1 blocking get command register.
SW_EVENT_0_TRIG |  |  | 0x600 | 0x100 | 0x0 | 32 | Config | W | PERIPH/DEMUX | R | 0x0 | Cluster Software event 0 trigger command register.
SW_EVENT_1_TRIG |  |  | 0x600 | 0x100 | 0x4 | 32 | Config | W | PERIPH/DEMUX | R | 0x0 | Cluster Software event 1 trigger command register.
SW_EVENT_2_TRIG |  |  | 0x600 | 0x100 | 0x8 | 32 | Config | W | PERIPH/DEMUX | R | 0x0 | Cluster Software event 2 trigger command register.
SW_EVENT_3_TRIG |  |  | 0x600 | 0x100 | 0xC | 32 | Config | W | PERIPH/DEMUX | R | 0x0 | Cluster Software event 3 trigger command register.
SW_EVENT_4_TRIG |  |  | 0x600 | 0x100 | 0x10 | 32 | Config | W | PERIPH/DEMUX | R | 0x0 | Cluster Software event 4 trigger command register.
SW_EVENT_5_TRIG |  |  | 0x600 | 0x100 | 0x14 | 32 | Config | W | PERIPH/DEMUX | R | 0x0 | Cluster Software event 5 trigger command register.
SW_EVENT_6_TRIG |  |  | 0x600 | 0x100 | 0x18 | 32 | Config | W | PERIPH/DEMUX | R | 0x0 | Cluster Software event 6 trigger command register.
SW_EVENT_7_TRIG |  |  | 0x600 | 0x100 | 0x1C | 32 | Config | W | PERIPH/DEMUX | R | 0x0 | Cluster Software event 7 trigger command register.
SW_EVENT_0_TRIG_WAIT |  |  |  | 0x140 | 0x0 | 32 | Config | R | DEMUX | W | 0x0 | Cluster Software event 0 trigger and wait command register.
SW_EVENT_1_TRIG_WAIT |  |  |  | 0x140 | 0x4 | 32 | Config | R | DEMUX | W | 0x0 | Cluster Software event 1 trigger and wait command register.
SW_EVENT_2_TRIG_WAIT |  |  |  | 0x140 | 0x8 | 32 | Config | R | DEMUX | W | 0x0 | Cluster Software event 2 trigger and wait command register.
SW_EVENT_3_TRIG_WAIT |  |  |  | 0x140 | 0xC | 32 | Config | R | DEMUX | W | 0x0 | Cluster Software event 3 trigger and wait command register.
SW_EVENT_4_TRIG_WAIT |  |  |  | 0x140 | 0x10 | 32 | Config | R | DEMUX | W | 0x0 | Cluster Software event 4 trigger and wait command register.
SW_EVENT_5_TRIG_WAIT |  |  |  | 0x140 | 0x14 | 32 | Config | R | DEMUX | W | 0x0 | Cluster Software event 5 trigger and wait command register.
SW_EVENT_6_TRIG_WAIT |  |  |  | 0x140 | 0x18 | 32 | Config | R | DEMUX | W | 0x0 | Cluster Software event 6 trigger and wait command register.
SW_EVENT_7_TRIG_WAIT |  |  |  | 0x140 | 0x1C | 32 | Config | R | DEMUX | W | 0x0 | Cluster Software event 7 trigger and wait command register.
SW_EVENT_0_TRIG_WAIT_CLEAR |  |  |  | 0x180 | 0x0 | 32 | Config | R | DEMUX | W | 0x0 | Cluster Software event 0 trigger, wait and clear command register.
SW_EVENT_1_TRIG_WAIT_CLEAR |  |  |  | 0x180 | 0x4 | 32 | Config | R | DEMUX | W | 0x0 | Cluster Software event 1 trigger, wait and clear command register.
SW_EVENT_2_TRIG_WAIT_CLEAR |  |  |  | 0x180 | 0x8 | 32 | Config | R | DEMUX | W | 0x0 | Cluster Software event 2 trigger, wait and clear command register.
SW_EVENT_3_TRIG_WAIT_CLEAR |  |  |  | 0x180 | 0xC | 32 | Config | R | DEMUX | W | 0x0 | Cluster Software event 3 trigger, wait and clear command register.
SW_EVENT_4_TRIG_WAIT_CLEAR |  |  |  | 0x180 | 0x10 | 32 | Config | R | DEMUX | W | 0x0 | Cluster Software event 4 trigger, wait and clear command register.
SW_EVENT_5_TRIG_WAIT_CLEAR |  |  |  | 0x180 | 0x14 | 32 | Config | R | DEMUX | W | 0x0 | Cluster Software event 5 trigger, wait and clear command register.
SW_EVENT_6_TRIG_WAIT_CLEAR |  |  |  | 0x180 | 0x18 | 32 | Config | R | DEMUX | W | 0x0 | Cluster Software event 6 trigger, wait and clear command register.
SW_EVENT_7_TRIG_WAIT_CLEAR |  |  |  | 0x180 | 0x1C | 32 | Config | R | DEMUX | W | 0x0 | Cluster Software event 7 trigger, wait and clear command register.
SOC_PERIPH_EVENT_ID |  |  | 0x700 |  | 0x0 | 32 | Status | R | PERIPH | W | 0x0 | Cluster SoC peripheral event ID status register.
HW_BARRIER_0_TRIG_MASK |  |  | 0x400 | 0x200 | 0x0 | 32 | Config | R/W | PERIPH/DEMUX | R | 0x0 | Cluster hardware barrier 0 trigger mask configuration register.
HW_BARRIER_1_TRIG_MASK |  |  | 0x400 | 0x200 | 0x20 | 32 | Config | R/W | PERIPH/DEMUX | R | 0x0 | Cluster hardware barrier 1 trigger mask configuration register.
HW_BARRIER_2_TRIG_MASK |  |  | 0x400 | 0x200 | 0x40 | 32 | Config | R/W | PERIPH/DEMUX | R | 0x0 | Cluster hardware barrier 2 trigger mask configuration register.
HW_BARRIER_3_TRIG_MASK |  |  | 0x400 | 0x200 | 0x60 | 32 | Config | R/W | PERIPH/DEMUX | R | 0x0 | Cluster hardware barrier 3 trigger mask configuration register.
HW_BARRIER_4_TRIG_MASK |  |  | 0x400 | 0x200 | 0x80 | 32 | Config | R/W | PERIPH/DEMUX | R | 0x0 | Cluster hardware barrier 4 trigger mask configuration register.
HW_BARRIER_5_TRIG_MASK |  |  | 0x400 | 0x200 | 0xA0 | 32 | Config | R/W | PERIPH/DEMUX | R | 0x0 | Cluster hardware barrier 5 trigger mask configuration register.
HW_BARRIER_6_TRIG_MASK |  |  | 0x400 | 0x200 | 0xC0 | 32 | Config | R/W | PERIPH/DEMUX | R | 0x0 | Cluster hardware barrier 6 trigger mask configuration register.
HW_BARRIER_7_TRIG_MASK |  |  | 0x400 | 0x200 | 0xE0 | 32 | Config | R/W | PERIPH/DEMUX | R | 0x0 | Cluster hardware barrier 7 trigger mask configuration register.
HW_BARRIER_0_STATUS |  |  | 0x400 | 0x200 | 0x4 | 32 | Status | R | PERIPH/DEMUX | W | 0x0 | Cluster hardware barrier 0 status register.
HW_BARRIER_1_STATUS |  |  | 0x400 | 0x200 | 0x24 | 32 | Status | R | PERIPH/DEMUX | W | 0x0 | Cluster hardware barrier 1 status register.
HW_BARRIER_2_STATUS |  |  | 0x400 | 0x200 | 0x44 | 32 | Status | R | PERIPH/DEMUX | W | 0x0 | Cluster hardware barrier 2 status register.
HW_BARRIER_3_STATUS |  |  | 0x400 | 0x200 | 0x64 | 32 | Status | R | PERIPH/DEMUX | W | 0x0 | Cluster hardware barrier 3 status register.
HW_BARRIER_4_STATUS |  |  | 0x400 | 0x200 | 0x84 | 32 | Status | R | PERIPH/DEMUX | W | 0x0 | Cluster hardware barrier 4 status register.
HW_BARRIER_5_STATUS |  |  | 0x400 | 0x200 | 0xA4 | 32 | Status | R | PERIPH/DEMUX | W | 0x0 | Cluster hardware barrier 5 status register.
HW_BARRIER_6_STATUS |  |  | 0x400 | 0x200 | 0xC4 | 32 | Status | R | PERIPH/DEMUX | W | 0x0 | Cluster hardware barrier 6 status register.
HW_BARRIER_7_STATUS |  |  | 0x400 | 0x200 | 0xE4 | 32 | Status | R | PERIPH/DEMUX | W | 0x0 | Cluster hardware barrier 7 status register.
HW_BARRIER_0_STATUS_SUM |  |  | 0x400 | 0x200 | 0x8 | 32 | Status | R | PERIPH/DEMUX | W | 0x0 | Cluster hardware barrier summary status register.
HW_BARRIER_1_STATUS_SUM |  |  | 0x400 | 0x200 | 0x28 | 32 | Status | R | PERIPH/DEMUX | W | 0x0 | Cluster hardware barrier summary status register.
HW_BARRIER_2_STATUS_SUM |  |  | 0x400 | 0x200 | 0x48 | 32 | Status | R | PERIPH/DEMUX | W | 0x0 | Cluster hardware barrier summary status register.
HW_BARRIER_3_STATUS_SUM |  |  | 0x400 | 0x200 | 0x68 | 32 | Status | R | PERIPH/DEMUX | W | 0x0 | Cluster hardware barrier summary status register.
HW_BARRIER_4_STATUS_SUM |  |  | 0x400 | 0x200 | 0x88 | 32 | Status | R | PERIPH/DEMUX | W | 0x0 | Cluster hardware barrier summary status register.
HW_BARRIER_5_STATUS_SUM |  |  | 0x400 | 0x200 | 0xA8 | 32 | Status | R | PERIPH/DEMUX | W | 0x0 | Cluster hardware barrier summary status register.
HW_BARRIER_6_STATUS_SUM |  |  | 0x400 | 0x200 | 0xC8 | 32 | Status | R | PERIPH/DEMUX | W | 0x0 | Cluster hardware barrier summary status register.
HW_BARRIER_7_STATUS_SUM |  |  | 0x400 | 0x200 | 0xE8 | 32 | Status | R | PERIPH/DEMUX | W | 0x0 | Cluster hardware barrier summary status register.
HW_BARRIER_0_TARGET_MASK |  |  | 0x400 | 0x200 | 0xC | 32 | Config | R/W | PERIPH/DEMUX | R/W | 0x0 | Cluster hardware barrier 0 target mask configuration register.
HW_BARRIER_1_TARGET_MASK |  |  | 0x400 | 0x200 | 0x2C | 32 | Config | R/W | PERIPH/DEMUX | R/W | 0x0 | Cluster hardware barrier 1 target mask configuration register.
HW_BARRIER_2_TARGET_MASK |  |  | 0x400 | 0x200 | 0x4C | 32 | Config | R/W | PERIPH/DEMUX | R/W | 0x0 | Cluster hardware barrier 2 target mask configuration register.
HW_BARRIER_3_TARGET_MASK |  |  | 0x400 | 0x200 | 0x6C | 32 | Config | R/W | PERIPH/DEMUX | R/W | 0x0 | Cluster hardware barrier 3 target mask configuration register.
HW_BARRIER_4_TARGET_MASK |  |  | 0x400 | 0x200 | 0x8C | 32 | Config | R/W | PERIPH/DEMUX | R/W | 0x0 | Cluster hardware barrier 4 target mask configuration register.
HW_BARRIER_5_TARGET_MASK |  |  | 0x400 | 0x200 | 0xAC | 32 | Config | R/W | PERIPH/DEMUX | R/W | 0x0 | Cluster hardware barrier 5 target mask configuration register.
HW_BARRIER_6_TARGET_MASK |  |  | 0x400 | 0x200 | 0xCC | 32 | Config | R/W | PERIPH/DEMUX | R/W | 0x0 | Cluster hardware barrier 6 target mask configuration register.
HW_BARRIER_7_TARGET_MASK |  |  | 0x400 | 0x200 | 0xEC | 32 | Config | R/W | PERIPH/DEMUX | R/W | 0x0 | Cluster hardware barrier 7 target mask configuration register.
HW_BARRIER_0_TRIG |  |  | 0x400 | 0x200 | 0x10 | 32 | Config | W | PERIPH/DEMUX | R | 0x0 | Cluster hardware barrier 0 trigger command register.
HW_BARRIER_1_TRIG |  |  | 0x400 | 0x200 | 0x30 | 32 | Config | W | PERIPH/DEMUX | R | 0x0 | Cluster hardware barrier 1 trigger command register.
HW_BARRIER_2_TRIG |  |  | 0x400 | 0x200 | 0x50 | 32 | Config | W | PERIPH/DEMUX | R | 0x0 | Cluster hardware barrier 2 trigger command register.
HW_BARRIER_3_TRIG |  |  | 0x400 | 0x200 | 0x70 | 32 | Config | W | PERIPH/DEMUX | R | 0x0 | Cluster hardware barrier 3 trigger command register.
HW_BARRIER_4_TRIG |  |  | 0x400 | 0x200 | 0x90 | 32 | Config | W | PERIPH/DEMUX | R | 0x0 | Cluster hardware barrier 4 trigger command register.
HW_BARRIER_5_TRIG |  |  | 0x400 | 0x200 | 0xB0 | 32 | Config | W | PERIPH/DEMUX | R | 0x0 | Cluster hardware barrier 5 trigger command register.
HW_BARRIER_6_TRIG |  |  | 0x400 | 0x200 | 0xD0 | 32 | Config | W | PERIPH/DEMUX | R | 0x0 | Cluster hardware barrier 6 trigger command register.
HW_BARRIER_7_TRIG |  |  | 0x400 | 0x200 | 0xF0 | 32 | Config | W | PERIPH/DEMUX | R | 0x0 | Cluster hardware barrier 7 trigger command register.
HW_BARRIER_0_SELF_TRIG |  |  |  | 0x200 | 0x14 | 32 | Config | R | DEMUX | W | 0x0 | Cluster hardware barrier 0 self trigger command register.
HW_BARRIER_1_SELF_TRIG |  |  |  | 0x200 | 0x34 | 32 | Config | R | DEMUX | W | 0x0 | Cluster hardware barrier 1 self trigger command register.
HW_BARRIER_2_SELF_TRIG |  |  |  | 0x200 | 0x54 | 32 | Config | R | DEMUX | W | 0x0 | Cluster hardware barrier 2 self trigger command register.
HW_BARRIER_3_SELF_TRIG |  |  |  | 0x200 | 0x74 | 32 | Config | R | DEMUX | W | 0x0 | Cluster hardware barrier 3 self trigger command register.
HW_BARRIER_4_SELF_TRIG |  |  |  | 0x200 | 0x94 | 32 | Config | R | DEMUX | W | 0x0 | Cluster hardware barrier 4 self trigger command register.
HW_BARRIER_5_SELF_TRIG |  |  |  | 0x200 | 0xB4 | 32 | Config | R | DEMUX | W | 0x0 | Cluster hardware barrier 5 self trigger command register.
HW_BARRIER_6_SELF_TRIG |  |  |  | 0x200 | 0xD4 | 32 | Config | R | DEMUX | W | 0x0 | Cluster hardware barrier 6 self trigger command register.
HW_BARRIER_7_SELF_TRIG |  |  |  | 0x200 | 0xF4 | 32 | Config | R | DEMUX | W | 0x0 | Cluster hardware barrier 7 self trigger command register.
HW_BARRIER_0_TRIG_WAIT |  |  |  | 0x200 | 0x18 | 32 | Config | R | DEMUX | W | 0x0 | Cluster hardware barrier 0 trigger and wait command register.
HW_BARRIER_1_TRIG_WAIT |  |  |  | 0x200 | 0x38 | 32 | Config | R | DEMUX | W | 0x0 | Cluster hardware barrier 1 trigger and wait command register.
HW_BARRIER_2_TRIG_WAIT |  |  |  | 0x200 | 0x58 | 32 | Config | R | DEMUX | W | 0x0 | Cluster hardware barrier 2 trigger and wait command register.
HW_BARRIER_3_TRIG_WAIT |  |  |  | 0x200 | 0x78 | 32 | Config | R | DEMUX | W | 0x0 | Cluster hardware barrier 3 trigger and wait command register.
HW_BARRIER_4_TRIG_WAIT |  |  |  | 0x200 | 0x98 | 32 | Config | R | DEMUX | W | 0x0 | Cluster hardware barrier 4 trigger and wait command register.
HW_BARRIER_5_TRIG_WAIT |  |  |  | 0x200 | 0xB8 | 32 | Config | R | DEMUX | W | 0x0 | Cluster hardware barrier 5 trigger and wait command register.
HW_BARRIER_6_TRIG_WAIT |  |  |  | 0x200 | 0xD8 | 32 | Config | R | DEMUX | W | 0x0 | Cluster hardware barrier 6 trigger and wait command register.
HW_BARRIER_7_TRIG_WAIT |  |  |  | 0x200 | 0xF8 | 32 | Config | R | DEMUX | W | 0x0 | Cluster hardware barrier 7 trigger and wait command register.
HW_BARRIER_0_TRIG_WAIT_CLEAR |  |  |  | 0x200 | 0x1C | 32 | Config | R | DEMUX | W | 0x0 | Cluster hardware barrier 0 trigger, wait and clear command register.
HW_BARRIER_1_TRIG_WAIT_CLEAR |  |  |  | 0x200 | 0x3C | 32 | Config | R | DEMUX | W | 0x0 | Cluster hardware barrier 1 trigger, wait and clear command register.
HW_BARRIER_2_TRIG_WAIT_CLEAR |  |  |  | 0x200 | 0x5C | 32 | Config | R | DEMUX | W | 0x0 | Cluster hardware barrier 2 trigger, wait and clear command register.
HW_BARRIER_3_TRIG_WAIT_CLEAR |  |  |  | 0x200 | 0x7C | 32 | Config | R | DEMUX | W | 0x0 | Cluster hardware barrier 3 trigger, wait and clear command register.
HW_BARRIER_4_TRIG_WAIT_CLEAR |  |  |  | 0x200 | 0x9C | 32 | Config | R | DEMUX | W | 0x0 | Cluster hardware barrier 4 trigger, wait and clear command register.
HW_BARRIER_5_TRIG_WAIT_CLEAR |  |  |  | 0x200 | 0xBC | 32 | Config | R | DEMUX | W | 0x0 | Cluster hardware barrier 5 trigger, wait and clear command register.
HW_BARRIER_6_TRIG_WAIT_CLEAR |  |  |  | 0x200 | 0xDC | 32 | Config | R | DEMUX | W | 0x0 | Cluster hardware barrier 6 trigger, wait and clear command register.
HW_BARRIER_7_TRIG_WAIT_CLEAR |  |  |  | 0x200 | 0xFC | 32 | Config | R | DEMUX | W | 0x0 | Cluster hardware barrier 7 trigger, wait and clear command register.

Sheet: IPREGMAP_rel1.0.0
Bit field | Register | Bit Position | Size | Host Access Type | IP access Type | Reset Value | Description | Hide
EMSOC | EVT_MASK | 31 | 1 | R/W | R/W | 0x0 | Soc peripheral input event mask configuration bitfield: - EMSOC[i]=1'b0: Input event request i is masked - EMSOC[i]=1'b1: Input event request i is not masked
EMINTCL | EVT_MASK | 30 | 1 | R/W | R/W | 0x0 | Inter-cluster input event mask configuration bitfield: - EMINTCL[i]=1'b0: Input event request i is masked - EMINTCL[i]=1'b1: Input event request i is not masked | X
EMCL | EVT_MASK | 0 | 30 | R/W | R/W | 0x0 | Cluster internal input event mask configuration bitfield: - EMCL[i]=1'b0: Input event request i is masked - EMCL[i]=1'b1: Input event request i is not masked
EMA | EVT_MASK_AND | 0 | 32 | W | R | 0x0 | Input event mask configuration bitfield update with bitwise AND operation. It allows clearing EMCL[i], EMINTCL[i] or EMSOC[i] if EMA[i]=1'b1.
EMO | EVT_MASK_OR | 0 | 32 | W | R | 0x0 | Input event mask configuration bitfield update with bitwise OR operation. It allows setting EMCL[i], EMINTCL[i] or EMSOC[i] if EMO[i]=1'b1.
IMSOC | IRQ_MASK | 31 | 1 | R/W | R/W | 0x0 | Soc peripheral interrupt request mask configuration bitfield: - bit[i]=1'b0: Interrupt request i is masked - bit[i]=1'b1: Interrupt request i is not masked
IMINTCL | IRQ_MASK | 30 | 1 | R/W | R/W | 0x0 | Inter-cluster interrupt request mask configuration bitfield: - bit[i]=1'b0: Interrupt request i is masked - bit[i]=1'b1: Interrupt request i is not masked
IMCL | IRQ_MASK | 0 | 30 | R/W | R/W | 0x0 | Cluster internal interrupt request mask configuration bitfield: - bit[i]=1'b0: Interrupt request i is masked - bit[i]=1'b1: Interrupt request i is not masked
IMA | IRQ_MASK_AND | 0 | 32 | W | R | 0x0 | Interrupt request mask configuration bitfield update with bitwise AND operation. It allows clearing IMCL[i], IMINTCL[i] or IMSOC[i] if IMA[i]=1'b1.
IMO | IRQ_MASK_OR | 0 | 32 | W | R | 0x0 | Interrupt request mask configuration bitfield update with bitwise OR operation. It allows setting IMCL[i], IMINTCL[i] or IMSOC[i] if IMO[i]=1'b1.
CS | CLOCK_STATUS | 0 | 1 | R | W | 0x0 | Cluster core clock status bitfield: - 1'b0: Cluster core clocked is gated - 1'b1: Cluster core clocked is running
EB | EVENT_BUFFER | 0 | 32 | R | W | 0x0 | Pending input events status bitfield. EB[i]=1'b1: one or more input event i request are pending.
EBM | EVENT_BUFFER_MASKED | 0 | 32 | R | W | 0x0 | Pending input events status bitfield with EVT_MASK applied. EBM[i]=1'b1: one or more input event i request are pending.
IBM | EVENT_BUFFER_IRQ_MASKED | 0 | 32 | R | W | 0x0 | Pending input events status bitfield with IRQ_MASK applied. IBM[i]=1'b1: one or more input events i are pending.
EBC | EVENT_BUFFER_CLEAR | 0 | 32 | W | R | 0x0 | Pending input events status clear command bitfield. It allows clearing EB[i] if EBC[i]=1'b1.
SWEM | SW_EVENT_MASK | 0 | 8 | R/W | R | 0x0 | Software events mask configuration bitfield: - bit[i]=1'b0: software events are masked for CL_CORE[i] - bit[i]=1'b1: software events are not masked for CL_CORE[i]
SWEMA | SW_EVENT_MASK_AND | 0 | 8 | W | W | 0x0 | Software event mask configuration bitfield update with bitwise AND operation. It allows clearing SWEM[i] if SWEMA[i]=1'b1.
SWEMO | SW_EVENT_MASK_OR | 0 | 8 | W | W | 0x0 | Software event mask configuration bitfield update with bitwise OR operation. It allows setting SWEM[i] if SWEMO[i]=1'b1.
EBM | EVENT_WAIT | 0 | 32 | R | W | 0x0 | Reading this register will gate the Cluster core clock until at least one unmasked event occurs. The read content of this bitfield is equivalent to EVENT_BUFFER_MASKED.EBM
EBM | EVENT_WAIT_CLEAR | 0 | 32 | R | W | 0x0 | Reading this register has the same effect as reading EVENT_WAIT.EBM. In addition, EVENT_BUFFER.EB[i] bits are cleared if EVT_MASK[i]=1'b1. The read content of this bitfield is equivalent to EVENT_BUFFER_MASKED.EBM
MSG | HW_DISPATCH_PUSH_TASK | 0 | 32 | W | R | 0x0 | Message to dispatch to all cluster cores selected in HW_DISPATCH_PUSH_TEAM_CONFIG.CT configuration bitfield.
MSG | HW_DISPATCH_POP_TASK | 0 | 32 | R | W | 0x0 | Message dispatched using HW_DISPATCH_PUSH_TASK command and popped by cluster core who issued HW_DISPATCH_POP_TASK command.
CT | HW_DISPATCH_PUSH_TEAM_CONFIG | 0 | 8 | R/W | R | 0x0 | Cluster cores team selection configuration bitfield. It allows to transmit HW_DISPATCH_PUSH_TASK.MSG to cluster core i if CT[i]=1'b1.
MSG | HW_MUTEX_0_MSG_PUT | 0 | 32 | W | R | 0x0 | Message pushed when releasing hardware mutex 0 configuration bitfiled. It is a non-blocking access.
MSG | HW_MUTEX_0_MSG_GET | 0 | 32 | R | W | 0x0 | Message popped when taking hardware mutex 0 data bitfiled. It is a blocking access.
MSG | HW_MUTEX_1_MSG_PUT | 0 | 32 | W | R | 0x0 | Message pushed when releasing hardware mutex 1 configuration bitfiled. It is a non-blocking access.
MSG | HW_MUTEX_1_MSG_GET | 0 | 32 | R | W | 0x0 | Message popped when taking hardware mutex 1 data bitfiled. It is a blocking access.
SW0T | SW_EVENT_0_TRIG | 0 | 8 | W | R | 0x0 | Triggers software event 0 for cluster core i if SW0T[i]=1'b1.
SW1T | SW_EVENT_1_TRIG | 0 | 8 | W | R | 0x0 | Triggers software event 1 for cluster core i if SW1T[i]=1'b1.
SW2T | SW_EVENT_2_TRIG | 0 | 8 | W | R | 0x0 | Triggers software event 2 for cluster core i if SW2T[i]=1'b1.
SW3T | SW_EVENT_3_TRIG | 0 | 8 | W | R | 0x0 | Triggers software event 3 for cluster core i if SW3T[i]=1'b1.
SW4T | SW_EVENT_4_TRIG | 0 | 8 | W | R | 0x0 | Triggers software event 4 for cluster core i if SW4T[i]=1'b1.
SW5T | SW_EVENT_5_TRIG | 0 | 8 | W | R | 0x0 | Triggers software event 5 for cluster core i if SW5T[i]=1'b1.
SW6T | SW_EVENT_6_TRIG | 0 | 8 | W | R | 0x0 | Triggers software event 6 for cluster core i if SW6T[i]=1'b1.
SW7T | SW_EVENT_7_TRIG | 0 | 8 | W | R | 0x0 | Triggers software event 7 for cluster core i if SW7T[i]=1'b1.
EBM | SW_EVENT_0_TRIG_WAIT | 0 | 32 | R | W | 0x0 | Triggers software event 0 to all cluster cores targeted in SW_EVENT_MASK and gate the issuing cluster core clock until at least one unmasked event occurs. The read content of this bitfield is equivalent to EVENT_BUFFER_MASKED.EBM
EBM | SW_EVENT_1_TRIG_WAIT | 0 | 32 | R | W | 0x0 | Triggers software event 1 to all cluster cores targeted in SW_EVENT_MASK and gate the issuing cluster core clock until at least one unmasked event occurs. The read content of this bitfield is equivalent to EVENT_BUFFER_MASKED.EBM
EBM | SW_EVENT_2_TRIG_WAIT | 0 | 32 | R | W | 0x0 | Triggers software event 2 to all cluster cores targeted in SW_EVENT_MASK and gate the issuing cluster core clock until at least one unmasked event occurs. The read content of this bitfield is equivalent to EVENT_BUFFER_MASKED.EBM
EBM | SW_EVENT_3_TRIG_WAIT | 0 | 32 | R | W | 0x0 | Triggers software event 3 to all cluster cores targeted in SW_EVENT_MASK and gate the issuing cluster core clock until at least one unmasked event occurs. The read content of this bitfield is equivalent to EVENT_BUFFER_MASKED.EBM
EBM | SW_EVENT_4_TRIG_WAIT | 0 | 32 | R | W | 0x0 | Triggers software event 4 to all cluster cores targeted in SW_EVENT_MASK and gate the issuing cluster core clock until at least one unmasked event occurs. The read content of this bitfield is equivalent to EVENT_BUFFER_MASKED.EBM
EBM | SW_EVENT_5_TRIG_WAIT | 0 | 32 | R | W | 0x0 | Triggers software event 5 to all cluster cores targeted in SW_EVENT_MASK and gate the issuing cluster core clock until at least one unmasked event occurs. The read content of this bitfield is equivalent to EVENT_BUFFER_MASKED.EBM
EBM | SW_EVENT_6_TRIG_WAIT | 0 | 32 | R | W | 0x0 | Triggers software event 6 to all cluster cores targeted in SW_EVENT_MASK and gate the issuing cluster core clock until at least one unmasked event occurs. The read content of this bitfield is equivalent to EVENT_BUFFER_MASKED.EBM
EBM | SW_EVENT_7_TRIG_WAIT | 0 | 32 | R | W | 0x0 | Triggers software event 7 to all cluster cores targeted in SW_EVENT_MASK and gate the issuing cluster core clock until at least one unmasked event occurs. The read content of this bitfield is equivalent to EVENT_BUFFER_MASKED.EBM
EBM | SW_EVENT_0_TRIG_WAIT_CLEAR | 0 | 32 | R | W | 0x0 | Triggers software event 0 to all cluster cores targeted in SW_EVENT_MASK and gate the issuing cluster core clock until at least one unmasked event occurs. In addition, EVENT_BUFFER.EB[i] bits are cleared after the read if EVT_MASK[i]=1'b1. The read content of this bitfield is equivalent to EVENT_BUFFER_MASKED.EBM
EBM | SW_EVENT_1_TRIG_WAIT_CLEAR | 0 | 32 | R | W | 0x0 | Triggers software event 1 to all cluster cores targeted in SW_EVENT_MASK and gate the issuing cluster core clock until at least one unmasked event occurs. In addition, EVENT_BUFFER.EB[i] bits are cleared after the read if EVT_MASK[i]=1'b1. The read content of this bitfield is equivalent to EVENT_BUFFER_MASKED.EBM
EBM | SW_EVENT_2_TRIG_WAIT_CLEAR | 0 | 32 | R | W | 0x0 | Triggers software event 2 to all cluster cores targeted in SW_EVENT_MASK and gate the issuing cluster core clock until at least one unmasked event occurs. In addition, EVENT_BUFFER.EB[i] bits are cleared after the read if EVT_MASK[i]=1'b1. The read content of this bitfield is equivalent to EVENT_BUFFER_MASKED.EBM
EBM | SW_EVENT_3_TRIG_WAIT_CLEAR | 0 | 32 | R | W | 0x0 | Triggers software event 3 to all cluster cores targeted in SW_EVENT_MASK and gate the issuing cluster core clock until at least one unmasked event occurs. In addition, EVENT_BUFFER.EB[i] bits are cleared after the read if EVT_MASK[i]=1'b1. The read content of this bitfield is equivalent to EVENT_BUFFER_MASKED.EBM
EBM | SW_EVENT_4_TRIG_WAIT_CLEAR | 0 | 32 | R | W | 0x0 | Triggers software event 4 to all cluster cores targeted in SW_EVENT_MASK and gate the issuing cluster core clock until at least one unmasked event occurs. In addition, EVENT_BUFFER.EB[i] bits are cleared after the read if EVT_MASK[i]=1'b1. The read content of this bitfield is equivalent to EVENT_BUFFER_MASKED.EBM
EBM | SW_EVENT_5_TRIG_WAIT_CLEAR | 0 | 32 | R | W | 0x0 | Triggers software event 5 to all cluster cores targeted in SW_EVENT_MASK and gate the issuing cluster core clock until at least one unmasked event occurs. In addition, EVENT_BUFFER.EB[i] bits are cleared after the read if EVT_MASK[i]=1'b1. The read content of this bitfield is equivalent to EVENT_BUFFER_MASKED.EBM
EBM | SW_EVENT_6_TRIG_WAIT_CLEAR | 0 | 32 | R | W | 0x0 | Triggers software event 6 to all cluster cores targeted in SW_EVENT_MASK and gate the issuing cluster core clock until at least one unmasked event occurs. In addition, EVENT_BUFFER.EB[i] bits are cleared after the read if EVT_MASK[i]=1'b1. The read content of this bitfield is equivalent to EVENT_BUFFER_MASKED.EBM
EBM | SW_EVENT_7_TRIG_WAIT_CLEAR | 0 | 32 | R | W | 0x0 | Triggers software event 7 to all cluster cores targeted in SW_EVENT_MASK and gate the issuing cluster core clock until at least one unmasked event occurs. In addition, EVENT_BUFFER.EB[i] bits are cleared after the read if EVT_MASK[i]=1'b1. The read content of this bitfield is equivalent to EVENT_BUFFER_MASKED.EBM
ID | SOC_PERIPH_EVENT_ID | 0 | 8 | R | W | 0x0 | Oldest SoC peripheral event ID status bitfield.
VALID | SOC_PERIPH_EVENT_ID | 31 | 1 | R | W | 0x0 | Validity bit of SOC_PERIPH_EVENT_ID.ID bitfield.
HB0TM | HW_BARRIER_0_TRIG_MASK | 0 | 8 | R/W | R | 0x0 | Trigger mask for hardware barrier 0 bitfield. Hardware barrier 0 will be triggered only if for all HB0TM[i] = 1'b1, HW_BARRIER_0_STATUS.HB0S[i]=1'b1. HB0TM=0 means that hardware barrier 0 is disabled.
HB1TM | HW_BARRIER_1_TRIG_MASK | 0 | 8 | R/W | R | 0x0 | Trigger mask for hardware barrier 1 bitfield. Hardware barrier 1 will be triggered only if for all HB1TM[i] = 1'b1, HW_BARRIER_1_STATUS.HB1S[i]=1'b1. HB1TM=0 means that hardware barrier 1 is disabled.
HB2TM | HW_BARRIER_2_TRIG_MASK | 0 | 8 | R/W | R | 0x0 | Trigger mask for hardware barrier 2 bitfield. Hardware barrier 2 will be triggered only if for all HB2TM[i] = 1'b1, HW_BARRIER_2_STATUS.HB2S[i]=1'b1. HB2TM=0 means that hardware barrier 2 is disabled.
HB3TM | HW_BARRIER_3_TRIG_MASK | 0 | 8 | R/W | R | 0x0 | Trigger mask for hardware barrier 3 bitfield. Hardware barrier 3 will be triggered only if for all HB3TM[i] = 1'b1, HW_BARRIER_3_STATUS.HB3S[i]=1'b1. HB3TM=0 means that hardware barrier 3 is disabled.
HB4TM | HW_BARRIER_4_TRIG_MASK | 0 | 8 | R/W | R | 0x0 | Trigger mask for hardware barrier 4 bitfield. Hardware barrier 4 will be triggered only if for all HB4TM[i] = 1'b1, HW_BARRIER_4_STATUS.HB4S[i]=1'b1. HB4TM=0 means that hardware barrier 4 is disabled.
HB5TM | HW_BARRIER_5_TRIG_MASK | 0 | 8 | R/W | R | 0x0 | Trigger mask for hardware barrier 5 bitfield. Hardware barrier 5 will be triggered only if for all HB5TM[i] = 1'b1, HW_BARRIER_5_STATUS.HB5S[i]=1'b1. HB5TM=0 means that hardware barrier 5 is disabled.
HB6TM | HW_BARRIER_6_TRIG_MASK | 0 | 8 | R/W | R | 0x0 | Trigger mask for hardware barrier 6 bitfield. Hardware barrier 6 will be triggered only if for all HB6TM[i] = 1'b1, HW_BARRIER_6_STATUS.HB6S[i]=1'b1. HB6TM=0 means that hardware barrier 6 is disabled.
HB7TM | HW_BARRIER_7_TRIG_MASK | 0 | 8 | R/W | R | 0x0 | Trigger mask for hardware barrier 7 bitfield. Hardware barrier 7 will be triggered only if for all HB7TM[i] = 1'b1, HW_BARRIER_7_STATUS.HB7S[i]=1'b1. HB7TM=0 means that hardware barrier 7 is disabled.
HBS | HW_BARRIER_0_STATUS | 0 | 8 | R | W | 0x0 | Current status of hardware barrier 0 bitfield. HBS[i]=1'b1 means that cluster core i has triggered hardware barrier 0. It is cleared when HBS matches HW_BARRIER_0_TRIG_MASK.HB0TM.
HBS | HW_BARRIER_1_STATUS | 0 | 8 | R | W | 0x0 | Current status of hardware barrier 1 bitfield. HBS[i]=1'b1 means that cluster core i has triggered hardware barrier 1. It is cleared when HBS matches HW_BARRIER_1_TRIG_MASK.HB1TM.
HBS | HW_BARRIER_2_STATUS | 0 | 8 | R | W | 0x0 | Current status of hardware barrier 2 bitfield. HBS[i]=1'b1 means that cluster core i has triggered hardware barrier 2. It is cleared when HBS matches HW_BARRIER_2_TRIG_MASK.HB2TM.
HBS | HW_BARRIER_3_STATUS | 0 | 8 | R | W | 0x0 | Current status of hardware barrier 3 bitfield. HBS[i]=1'b1 means that cluster core i has triggered hardware barrier 3. It is cleared when HBS matches HW_BARRIER_3_TRIG_MASK.HB3TM.
HBS | HW_BARRIER_4_STATUS | 0 | 8 | R | W | 0x0 | Current status of hardware barrier 4 bitfield. HBS[i]=1'b1 means that cluster core i has triggered hardware barrier 4. It is cleared when HBS matches HW_BARRIER_4_TRIG_MASK.HB4TM.
HBS | HW_BARRIER_5_STATUS | 0 | 8 | R | W | 0x0 | Current status of hardware barrier 5 bitfield. HBS[i]=1'b1 means that cluster core i has triggered hardware barrier 5. It is cleared when HBS matches HW_BARRIER_5_TRIG_MASK.HB5TM.
HBS | HW_BARRIER_6_STATUS | 0 | 8 | R | W | 0x0 | Current status of hardware barrier 6 bitfield. HBS[i]=1'b1 means that cluster core i has triggered hardware barrier 6. It is cleared when HBS matches HW_BARRIER_6_TRIG_MASK.HB6TM.
HBS | HW_BARRIER_7_STATUS | 0 | 8 | R | W | 0x0 | Current status of hardware barrier 7 bitfield. HBS[i]=1'b1 means that cluster core i has triggered hardware barrier 7. It is cleared when HBS matches HW_BARRIER_7_TRIG_MASK.HB7TM.
HBSS | HW_BARRIER_0_STATUS_SUM | 0 | 8 | R | W | 0x0 | Current status of hardware barrier 0. HBSS[i] represents a summary of the barrier status for core i.
HBSS | HW_BARRIER_1_STATUS_SUM | 0 | 8 | R | W | 0x0 | Current status of hardware barrier 1. HBSS[i] represents a summary of the barrier status for core i.
HBSS | HW_BARRIER_2_STATUS_SUM | 0 | 8 | R | W | 0x0 | Current status of hardware barrier 2. HBSS[i] represents a summary of the barrier status for core i.
HBSS | HW_BARRIER_3_STATUS_SUM | 0 | 8 | R | W | 0x0 | Current status of hardware barrier 3. HBSS[i] represents a summary of the barrier status for core i.
HBSS | HW_BARRIER_4_STATUS_SUM | 0 | 8 | R | W | 0x0 | Current status of hardware barrier 4. HBSS[i] represents a summary of the barrier status for core i.
HBSS | HW_BARRIER_5_STATUS_SUM | 0 | 8 | R | W | 0x0 | Current status of hardware barrier 5. HBSS[i] represents a summary of the barrier status for core i.
HBSS | HW_BARRIER_6_STATUS_SUM | 0 | 8 | R | W | 0x0 | Current status of hardware barrier 6. HBSS[i] represents a summary of the barrier status for core i.
HBSS | HW_BARRIER_7_STATUS_SUM | 0 | 8 | R | W | 0x0 | Current status of hardware barrier 7. HBSS[i] represents a summary of the barrier status for core i.
HBTAM | HW_BARRIER_0_TARGET_MASK | 0 | 8 | R/W | R | 0x0 | Cluster hardware barrier 0 target mask configuration bitfield. HBATM[i]=1'b1 means that cluster core i will receive hardware barrier 0 event when HW_BARRIER_0_STATUS will match HW_BARRIER_0_TRIG_MASK.
HBTAM | HW_BARRIER_1_TARGET_MASK | 0 | 8 | R/W | R | 0x0 | Cluster hardware barrier 1 target mask configuration bitfield. HBATM[i]=1'b1 means that cluster core i will receive hardware barrier 1 event when HW_BARRIER_1_STATUS will match HW_BARRIER_1_TRIG_MASK.
HBTAM | HW_BARRIER_2_TARGET_MASK | 0 | 8 | R/W | R | 0x0 | Cluster hardware barrier 2 target mask configuration bitfield. HBATM[i]=1'b1 means that cluster core i will receive hardware barrier 2 event when HW_BARRIER_2_STATUS will match HW_BARRIER_2_TRIG_MASK.
HBTAM | HW_BARRIER_3_TARGET_MASK | 0 | 8 | R/W | R | 0x0 | Cluster hardware barrier 3 target mask configuration bitfield. HBATM[i]=1'b1 means that cluster core i will receive hardware barrier 3 event when HW_BARRIER_3_STATUS will match HW_BARRIER_3_TRIG_MASK.
HBTAM | HW_BARRIER_4_TARGET_MASK | 0 | 8 | R/W | R | 0x0 | Cluster hardware barrier 4 target mask configuration bitfield. HBATM[i]=1'b1 means that cluster core i will receive hardware barrier 4 event when HW_BARRIER_4_STATUS will match HW_BARRIER_4_TRIG_MASK.
HBTAM | HW_BARRIER_5_TARGET_MASK | 0 | 8 | R/W | R | 0x0 | Cluster hardware barrier 5 target mask configuration bitfield. HBATM[i]=1'b1 means that cluster core i will receive hardware barrier 5 event when HW_BARRIER_5_STATUS will match HW_BARRIER_5_TRIG_MASK.
HBTAM | HW_BARRIER_6_TARGET_MASK | 0 | 8 | R/W | R | 0x0 | Cluster hardware barrier 6 target mask configuration bitfield. HBATM[i]=1'b1 means that cluster core i will receive hardware barrier 6 event when HW_BARRIER_6_STATUS will match HW_BARRIER_6_TRIG_MASK.
HBTAM | HW_BARRIER_7_TARGET_MASK | 0 | 8 | R/W | R | 0x0 | Cluster hardware barrier 7 target mask configuration bitfield. HBATM[i]=1'b1 means that cluster core i will receive hardware barrier 7 event when HW_BARRIER_7_STATUS will match HW_BARRIER_7_TRIG_MASK.
T | HW_BARRIER_0_TRIG | 0 | 8 | W | R | 0x0 | Sets HW_BARRIER_0_STATUS.HBS[i] to 1'b1 when T[i]=1'b1.
T | HW_BARRIER_1_TRIG | 0 | 8 | W | R | 0x0 | Sets HW_BARRIER_1_STATUS.HBS[i] to 1'b1 when T[i]=1'b1.
T | HW_BARRIER_2_TRIG | 0 | 8 | W | R | 0x0 | Sets HW_BARRIER_2_STATUS.HBS[i] to 1'b1 when T[i]=1'b1.
T | HW_BARRIER_3_TRIG | 0 | 8 | W | R | 0x0 | Sets HW_BARRIER_3_STATUS.HBS[i] to 1'b1 when T[i]=1'b1.
T | HW_BARRIER_4_TRIG | 0 | 8 | W | R | 0x0 | Sets HW_BARRIER_4_STATUS.HBS[i] to 1'b1 when T[i]=1'b1.
T | HW_BARRIER_5_TRIG | 0 | 8 | W | R | 0x0 | Sets HW_BARRIER_5_STATUS.HBS[i] to 1'b1 when T[i]=1'b1.
T | HW_BARRIER_6_TRIG | 0 | 8 | W | R | 0x0 | Sets HW_BARRIER_6_STATUS.HBS[i] to 1'b1 when T[i]=1'b1.
T | HW_BARRIER_7_TRIG | 0 | 8 | W | R | 0x0 | Sets HW_BARRIER_7_STATUS.HBS[i] to 1'b1 when T[i]=1'b1.
T | HW_BARRIER_0_SELF_TRIG | 0 | 32 | R | W | 0x0 | Sets HW_BARRIER_0_STATUS.HBS[i] to 1'b1 when issued by cluster core i.
T | HW_BARRIER_1_SELF_TRIG | 0 | 32 | R | W | 0x0 | Sets HW_BARRIER_1_STATUS.HBS[i] to 1'b1 when issued by cluster core i.
T | HW_BARRIER_2_SELF_TRIG | 0 | 32 | R | W | 0x0 | Sets HW_BARRIER_2_STATUS.HBS[i] to 1'b1 when issued by cluster core i.
T | HW_BARRIER_3_SELF_TRIG | 0 | 32 | R | W | 0x0 | Sets HW_BARRIER_3_STATUS.HBS[i] to 1'b1 when issued by cluster core i.
T | HW_BARRIER_4_SELF_TRIG | 0 | 32 | R | W | 0x0 | Sets HW_BARRIER_4_STATUS.HBS[i] to 1'b1 when issued by cluster core i.
T | HW_BARRIER_5_SELF_TRIG | 0 | 32 | R | W | 0x0 | Sets HW_BARRIER_5_STATUS.HBS[i] to 1'b1 when issued by cluster core i.
T | HW_BARRIER_6_SELF_TRIG | 0 | 32 | R | W | 0x0 | Sets HW_BARRIER_6_STATUS.HBS[i] to 1'b1 when issued by cluster core i.
T | HW_BARRIER_7_SELF_TRIG | 0 | 32 | R | W | 0x0 | Sets HW_BARRIER_7_STATUS.HBS[i] to 1'b1 when issued by cluster core i.
EBM | HW_BARRIER_0_TRIG_WAIT | 0 | 32 | R | W | 0x0 | Set HW_BARRIER_0[i] when issued by cluster core i and gate the issuing cluster core i clock until HW_BARRIER_0 is released. The read content of this bitfield is equivalent to EVENT_BUFFER_MASKED.EBM
EBM | HW_BARRIER_1_TRIG_WAIT | 0 | 32 | R | W | 0x0 | Set HW_BARRIER_1[i] when issued by cluster core i and gate the issuing cluster core i clock until HW_BARRIER_1 is released. The read content of this bitfield is equivalent to EVENT_BUFFER_MASKED.EBM
EBM | HW_BARRIER_2_TRIG_WAIT | 0 | 32 | R | W | 0x0 | Set HW_BARRIER_2[i] when issued by cluster core i and gate the issuing cluster core i clock until HW_BARRIER_2 is released. The read content of this bitfield is equivalent to EVENT_BUFFER_MASKED.EBM
EBM | HW_BARRIER_3_TRIG_WAIT | 0 | 32 | R | W | 0x0 | Set HW_BARRIER_3[i] when issued by cluster core i and gate the issuing cluster core i clock until HW_BARRIER_3 is released. The read content of this bitfield is equivalent to EVENT_BUFFER_MASKED.EBM
EBM | HW_BARRIER_4_TRIG_WAIT | 0 | 32 | R | W | 0x0 | Set HW_BARRIER_4[i] when issued by cluster core i and gate the issuing cluster core i clock until HW_BARRIER_4 is released. The read content of this bitfield is equivalent to EVENT_BUFFER_MASKED.EBM
EBM | HW_BARRIER_5_TRIG_WAIT | 0 | 32 | R | W | 0x0 | Set HW_BARRIER_5[i] when issued by cluster core i and gate the issuing cluster core i clock until HW_BARRIER_5 is released. The read content of this bitfield is equivalent to EVENT_BUFFER_MASKED.EBM
EBM | HW_BARRIER_6_TRIG_WAIT | 0 | 32 | R | W | 0x0 | Set HW_BARRIER_6[i] when issued by cluster core i and gate the issuing cluster core i clock until HW_BARRIER_6 is released. The read content of this bitfield is equivalent to EVENT_BUFFER_MASKED.EBM
EBM | HW_BARRIER_7_TRIG_WAIT | 0 | 32 | R | W | 0x0 | Set HW_BARRIER_7[i] when issued by cluster core i and gate the issuing cluster core i clock until HW_BARRIER_7 is released. The read content of this bitfield is equivalent to EVENT_BUFFER_MASKED.EBM
EBM | HW_BARRIER_0_TRIG_WAIT_CLEAR | 0 | 32 | R | W | 0x0 | Set HW_BARRIER_0[i] when issued by cluster core i and gate the issuing cluster core i clock until HW_BARRIER_0 is released. In addition, EVENT_BUFFER.EB[i] bits are cleared after the read if EVT_MASK[i]=1'b1. The read content of this bitfield is equivalent to EVENT_BUFFER_MASKED.EBM
EBM | HW_BARRIER_1_TRIG_WAIT_CLEAR | 0 | 32 | R | W | 0x0 | Set HW_BARRIER_1[i] when issued by cluster core i and gate the issuing cluster core i clock until HW_BARRIER_1 is released. In addition, EVENT_BUFFER.EB[i] bits are cleared after the read if EVT_MASK[i]=1'b1. The read content of this bitfield is equivalent to EVENT_BUFFER_MASKED.EBM
EBM | HW_BARRIER_2_TRIG_WAIT_CLEAR | 0 | 32 | R | W | 0x0 | Set HW_BARRIER_2[i] when issued by cluster core i and gate the issuing cluster core i clock until HW_BARRIER_2 is released. In addition, EVENT_BUFFER.EB[i] bits are cleared after the read if EVT_MASK[i]=1'b1. The read content of this bitfield is equivalent to EVENT_BUFFER_MASKED.EBM
EBM | HW_BARRIER_3_TRIG_WAIT_CLEAR | 0 | 32 | R | W | 0x0 | Set HW_BARRIER_3[i] when issued by cluster core i and gate the issuing cluster core i clock until HW_BARRIER_3 is released. In addition, EVENT_BUFFER.EB[i] bits are cleared after the read if EVT_MASK[i]=1'b1. The read content of this bitfield is equivalent to EVENT_BUFFER_MASKED.EBM
EBM | HW_BARRIER_4_TRIG_WAIT_CLEAR | 0 | 32 | R | W | 0x0 | Set HW_BARRIER_4[i] when issued by cluster core i and gate the issuing cluster core i clock until HW_BARRIER_4 is released. In addition, EVENT_BUFFER.EB[i] bits are cleared after the read if EVT_MASK[i]=1'b1. The read content of this bitfield is equivalent to EVENT_BUFFER_MASKED.EBM
EBM | HW_BARRIER_5_TRIG_WAIT_CLEAR | 0 | 32 | R | W | 0x0 | Set HW_BARRIER_5[i] when issued by cluster core i and gate the issuing cluster core i clock until HW_BARRIER_5 is released. In addition, EVENT_BUFFER.EB[i] bits are cleared after the read if EVT_MASK[i]=1'b1. The read content of this bitfield is equivalent to EVENT_BUFFER_MASKED.EBM
EBM | HW_BARRIER_6_TRIG_WAIT_CLEAR | 0 | 32 | R | W | 0x0 | Set HW_BARRIER_6[i] when issued by cluster core i and gate the issuing cluster core i clock until HW_BARRIER_6 is released. In addition, EVENT_BUFFER.EB[i] bits are cleared after the read if EVT_MASK[i]=1'b1. The read content of this bitfield is equivalent to EVENT_BUFFER_MASKED.EBM
EBM | HW_BARRIER_7_TRIG_WAIT_CLEAR | 0 | 32 | R | W | 0x0 | Set HW_BARRIER_7[i] when issued by cluster core i and gate the issuing cluster core i clock until HW_BARRIER_7 is released. In addition, EVENT_BUFFER.EB[i] bits are cleared after the read if EVT_MASK[i]=1'b1. The read content of this bitfield is equivalent to EVENT_BUFFER_MASKED.EBM

Sheet: VerPlan_rel1.0.0
Name | Description | testcase location&name | Status
