pulp-platform/pulp/doc/IP_REFERENCES/CLUSTER_CRTL_UNIT_reference.xlsx

Sheet: Info
Document Information
Name | CLUSTER_CTRL_UNIT reference
Category | IP reference
Author | Florent Rotenberg
Version | 1.0
Status | Fisrt Release
Description | CLUSTER_CTRL_UNIT interface definition
IP Information
IP type | CLUSTER_CTRL_UNIT
Delivery Type
History
Date | Modification | Author
26/10/2016 | 1strelease | F.Rotenberg
Content
Info | This sheet. General information about document usage
Usage | Guidelines on how to used the various sheet
IP Release | Release information sheet describing
IPIF_relx.x | IP interface description reference, describing IP symbol/entity and integration and test information relative to IP interface.
IPDESCR_Relx.x | Description of the main features of the IP
IPREGLIST_rely.y | Description of the list of registers used by IP. Registers can be physically instanciated inside IP or outside IP.
IPREGMAP_relz.z | Description of mapping of bit fields when registers are internal to IP. This sheet is optional for IP which are not instanciating registers as information can be build from IPIF and IPRELIST sheet.
IPTREGMAP_relz.z | Description of mapping of test bit field when registers are internal to IP. This sheet is optional for IP which are not instanciating registers as information can be build from IPIF and IPRELIST sheet.

Sheet: Usage
IP Release Sheet
 | Column | Description | Possible Value
 | Version | IP release version numeroted as [major release].[minor release]. A release is major whenever IP interface is modified. | X.Y. Z
 | Release description | This is a free text entry expliciting the release main modifications and purpose. | Text
 | IPIF | IPIF sheet version to be used for this release. | X.Y. Z
 | IPDESCR | IPDESCR sheet version to nbe used for this release | X.Y.Z
 | IPREGLIST | IPREGLIST sheet version to be used for this release. | X.Y. Z
 | IPREGMAP | IPREGMAP sheet version to be used for this release. | X.Y. Z
 | IPDOC | IPDOC version to be used for this release. | X.Y. Z
 | GIT version | GIT database number corresponding to IP design code and IP reference XLS. | Integer
IPIF sheet
IP Interface description | IP Pin Name | Name of IP Pin. This must must exactly name find in code or schematic (including case).
 | Direction | Direction or type of signal | In,Out,IO
 | Type | Analog, Digital, supply, DR (Dual Rail), SR (SingleRail) | Analog,Digital, VDD, GND, DR, SR
 | Voltage Domain
 | Clock domain
 | IO
 | Size
 | Reset Value
 | Description
Integration information | Integration comment
 | Core Interface
 | Register Interface
 | Register name
 | DFT value
 | Level Shifter
 | Isolation cell
 | Connected to
 | Load
 | Drive
 | Destination supply
Hard Macro information | location
 | layer
 | Antenna
Additonal Information | FreeText 1
 | FreeText 2
Driver information | Function1
 | Function2

Sheet: IP Release
Version | Release description | IPIF | IPDESCR | IPREGLIST | IPREGMAP | IPDOC | GIT version
1.0.0 |  | Rel1.0.0 | Rel1.0.0 | Rel1.0.0 | Rel1.0.0

Sheet: IPIF_rel1.0.0
IP Interface description |  |  |  |  |  |  |  |  | Integration information |  |  |  |  |  |  |  |  |  |  |  |  | Hard Macro information |  |  | Additonal Information |  | Driver information
IP Pin Name | Direction | Type | Voltage Domain | Clock domain | IO | Size | Reset Value | Description | Integration comment | Core Interface | Register Interface | Register name | Bit position | Trim during production | DFT value | Level Shifter | Isolation cell | Connected to | Load | Drive | Destination supply | location | layer | Antenna | FreeText 1 | FreeText 2 | Function1 | Function2
clk_i | IN | digital
rstn_i | IN | digital

Sheet: IPDESCR_rel1.0.0
Description
CL_CTRL_UNIT component manages the following features: - End of Computation status flag - Configurable fetch activation for all cores of the Cluster - Configurable core 0 boot address to define where to fetch first instruction in CL_CORE_0 after releasing the reset - Configurable full cluster clock gating - Configurable Cluster L1 memory arbitration policy - Cluster cores resume command control - Cluster cores halt status flags - Configurable cluster cores debug halt command group mask policy

Sheet: IPREGLIST_rel1.0.0
Register Name | Address | Size | Register Type | Host Access Type | IP access Type | Default Value | Description | FootNote | Comment | Hide
EOC | 0x0 | 32 | Status | R/W | W | 0x0 | End Of Computation status register.
FETCH_EN | 0x8 | 32 | Config | R/W | R | 0x0 | Cluster cores fetch enable configuration register.
CLOCK_GATE | 0x20 | 32 | Config | R/W | R | 0x0 | Cluster clock gate configuration register.
DBG_RESUME | 0x28 | 32 | Config | W | R | 0x0 | Cluster cores debug resume register.
DBG_HALT_STATUS | 0x28 | 32 | Config | R | W | 0x0 | Cluster cores debug halt status register.
DBG_HALT_MASK | 0x38 | 32 | Config | R/W | R | 0x0 | Cluster cores debug halt mask configuration register.
BOOT_ADDR0 | 0x40 | 32 | Config | R/W | R | 0x0 | Cluster core 0 boot address configuration register.
BOOT_ADDR1 | 0x44 | 32 | Config | R/W | R | 0x0 | Cluster core 1 boot address configuration register. |  |  | X
BOOT_ADDR2 | 0x48 | 32 | Config | R/W | R | 0x0 | Cluster core 2 boot address configuration register. |  |  | X
BOOT_ADDR3 | 0x4C | 32 | Config | R/W | R | 0x0 | Cluster core 3 boot address configuration register. |  |  | X
BOOT_ADDR4 | 0x50 | 32 | Config | R/W | R | 0x0 | Cluster core 4 boot address configuration register. |  |  | X
BOOT_ADDR5 | 0x54 | 32 | Config | R/W | R | 0x0 | Cluster core 5 boot address configuration register. |  |  | X
BOOT_ADDR6 | 0x58 | 32 | Config | R/W | R | 0x0 | Cluster core 6 boot address configuration register. |  |  | X
BOOT_ADDR7 | 0x5C | 32 | Config | R/W | R | 0x0 | Cluster core 7 boot address configuration register. |  |  | X
TCDM_ARB_POLICY_CH0 | 0x80 | 32 | Config | R/W | R | 0x0 | TCDM arbitration policy ch0 for cluster cores configuration register.
TCDM_ARB_POLICY_CH1 | 0x88 | 32 | Config | R/W | R | 0x0 | TCDM arbitration policy ch1 for DMA/HWCE configuration register.
TCDM_ARB_POLICY_CH0_REP | 0xC0 | 32 | Config | R/W | R | 0x0 | Read only duplicate of TCDM_ARB_POLICY_CH0 register
TCDM_ARB_POLICY_CH1_REP | 0xC8 | 32 | Config | R/W | R | 0x0 | Read only duplicate of TCDM_ARB_POLICY_CH1 register

Sheet: IPREGMAP_rel1.0.0
Bit field | Register | Bit Position | Size | Host Access Type | IP access Type | Reset Value | Description
EOC | EOC | 0 | 1 | R/W | W | 0x0 | End of computation status flag bitfield: - 1'b0: program execution under going - 1'b1: end of computation reached
CORE0 | FETCH_EN | 0 | 1 | R/W | R | 0x0 | Core 0 fetch enable configuration bitfield: - 1'b0: disabled - 1'b1: enabled
CORE1 | FETCH_EN | 1 | 1 | R/W | R | 0x0 | Core 1 fetch enable configuration bitfield: - 1'b0: disabled - 1'b1: enabled
CORE2 | FETCH_EN | 2 | 1 | R/W | R | 0x0 | Core 2 fetch enable configuration bitfield: - 1'b0: disabled - 1'b1: enabled
CORE3 | FETCH_EN | 3 | 1 | R/W | R | 0x0 | Core 3 fetch enable configuration bitfield: - 1'b0: disabled - 1'b1: enabled
CORE4 | FETCH_EN | 4 | 1 | R/W | R | 0x0 | Core 4 fetch enable configuration bitfield: - 1'b0: disabled - 1'b1: enabled
CORE5 | FETCH_EN | 5 | 1 | R/W | R | 0x0 | Core 5 fetch enable configuration bitfield: - 1'b0: disabled - 1'b1: enabled
CORE6 | FETCH_EN | 6 | 1 | R/W | R | 0x0 | Core 6 fetch enable configuration bitfield: - 1'b0: disabled - 1'b1: enabled
CORE7 | FETCH_EN | 7 | 1 | R/W | R | 0x0 | Core 7 fetch enable configuration bitfield: - 1'b0: disabled - 1'b1: enabled
EN | CLOCK_GATE | 0 | 1 | R/W | R | 0x0 | Cluster clock gate configuration bitfield: - 1'b0: disabled - 1'b1: enabled
CORE0 | DBG_HALT_STATUS | 0 | 1 | R | W | 0x0 | Core 0 debug halt status flag bitfield: - 1'b0: running - 1'b1: halted
CORE0 | DBG_RESUME | 0 | 1 | W | R | 0x0 | Core 0 debug resume configuration bitfield: - 1'b0: stay halted - 1'b1: resume core 0
CORE1 | DBG_HALT_STATUS | 1 | 1 | R | W | 0x0 | Core 1 debug halt status flag bitfield: - 1'b0: running - 1'b1: halted
CORE1 | DBG_RESUME | 1 | 1 | W | R | 0x0 | Core 1 debug resume configuration bitfield: - 1'b0: stay halted - 1'b1: resume core 1
CORE2 | DBG_HALT_STATUS | 2 | 1 | R | W | 0x0 | Core 2 debug halt status flag bitfield: - 1'b0: running - 1'b1: halted
CORE2 | DBG_RESUME | 2 | 1 | W | R | 0x0 | Core 2 debug resume configuration bitfield: - 1'b0: stay halted - 1'b1: resume core 2
CORE3 | DBG_HALT_STATUS | 3 | 1 | R | W | 0x0 | Core 3 debug halt status flag bitfield: - 1'b0: running - 1'b1: halted
CORE3 | DBG_RESUME | 3 | 1 | W | R | 0x0 | Core 3 debug resume configuration bitfield: - 1'b0: stay halted - 1'b1: resume core 3
CORE4 | DBG_HALT_STATUS | 4 | 1 | R | W | 0x0 | Core 4 debug halt status flag bitfield: - 1'b0: running - 1'b1: halted
CORE4 | DBG_RESUME | 4 | 1 | W | R | 0x0 | Core 4 debug resume configuration bitfield: - 1'b0: stay halted - 1'b1: resume core 4
CORE5 | DBG_HALT_STATUS | 5 | 1 | R | W | 0x0 | Core 5 debug halt status flag bitfield: - 1'b0: running - 1'b1: halted
CORE5 | DBG_RESUME | 5 | 1 | W | R | 0x0 | Core 5 debug resume configuration bitfield: - 1'b0: stay halted - 1'b1: resume core 5
CORE6 | DBG_HALT_STATUS | 6 | 1 | R | W | 0x0 | Core 6 debug halt status flag bitfield: - 1'b0: running - 1'b1: halted
CORE6 | DBG_RESUME | 6 | 1 | W | R | 0x0 | Core 6 debug resume configuration bitfield: - 1'b0: stay halted - 1'b1: resume core 6
CORE7 | DBG_HALT_STATUS | 7 | 1 | R | W | 0x0 | Core 7 debug halt status flag bitfield: - 1'b0: running - 1'b1: halted
CORE7 | DBG_RESUME | 7 | 1 | W | R | 0x0 | Core 7 debug resume configuration bitfield: - 1'b0: stay halted - 1'b1: resume core 7
CORE0 | DBG_HALT_MASK | 0 | 1 | R/W | R | 0x0 | Core 0 debug halt mask bitfield. When bit is set, core will be part of mask group and stopped when one of the members of the group stops.
CORE1 | DBG_HALT_MASK | 1 | 1 | R/W | R | 0x0 | Core 1 debug halt mask bitfield. When bit is set, core will be part of mask group and stopped when one of the members of the group stops.
CORE2 | DBG_HALT_MASK | 2 | 1 | R/W | R | 0x0 | Core 2 debug halt mask bitfield. When bit is set, core will be part of mask group and stopped when one of the members of the group stops.
CORE3 | DBG_HALT_MASK | 3 | 1 | R/W | R | 0x0 | Core 3 debug halt mask bitfield. When bit is set, core will be part of mask group and stopped when one of the members of the group stops.
CORE4 | DBG_HALT_MASK | 4 | 1 | R/W | R | 0x0 | Core 4 debug halt mask bitfield. When bit is set, core will be part of mask group and stopped when one of the members of the group stops.
CORE5 | DBG_HALT_MASK | 5 | 1 | R/W | R | 0x0 | Core 5 debug halt mask bitfield. When bit is set, core will be part of mask group and stopped when one of the members of the group stops.
CORE6 | DBG_HALT_MASK | 6 | 1 | R/W | R | 0x0 | Core 6 debug halt mask bitfield. When bit is set, core will be part of mask group and stopped when one of the members of the group stops.
CORE7 | DBG_HALT_MASK | 7 | 1 | R/W | R | 0x0 | Core 7 debug halt mask bitfield. When bit is set, core will be part of mask group and stopped when one of the members of the group stops.
BA | BOOT_ADDR0 | 0 | 32 | R/W | R | 0x0 | Cluster core 0 boot address configuration bitfield.
POL | TCDM_ARB_POLICY_CH0 | 0 | 1 | R/W | R | 0x0 | TCDM arbitration policy for cluster cores configuration bitfield: - 1'b0: fair round robin - 1'b1: fixed order
POL | TCDM_ARB_POLICY_CH1 | 0 | 1 | R/W | R | 0x0 | TCDM arbitration policy for DMA/HWCE configuration bitfield: - 1'b0: fair round robin - 1'b1: fixed order
POL | TCDM_ARB_POLICY_CH0_REP | 0 | 1 | R/W | R | 0x0 | TCDM arbitration policy for cluster cores configuration bitfield: - 1'b0: fair round robin - 1'b1: fixed order
POL | TCDM_ARB_POLICY_CH1_REP | 0 | 1 | R/W | R | 0x0 | TCDM arbitration policy for DMA/HWCE configuration bitfield: - 1'b0: fair round robin - 1'b1: fixed order

Sheet: VerPlan_rel1.0.0
Name | Description | testcase location&name | Status
