pulp-platform/pulp/doc/IP_REFERENCES/FC_EVENT_UNIT_reference.xlsx

Sheet: Info
Document Information
Name | FC_EVENT_UNIT reference
Category | IP reference
Author | Florent Rotenberg
Version | 1.0
Status | Fisrt Release
Description | FC_EVENT_UNIT interface definition
IP Information
IP type | FC_EVENT_UNIT
Delivery Type
History
Date | Modification | Author
26/10/2016 | 1st release | F.Rotenberg
Content
Info | This sheet. General information about document usage
Usage | Guidelines on how to used the various sheet
IP Release | Release information sheet describing
IPIF_relx.x | IP interface description reference, describing IP symbol/entity and integration and test information relative to IP interface.
IPDESCR_Relx.x | Description of the main features of the IP
IPREGLIST_rely.y | Description of the list of registers used by IP. Registers can be physically instanciated inside IP or outside IP.
IPREGMAP_relz.z | Description of mapping of bit fields when registers are internal to IP. This sheet is optional for IP which are not instanciating registers as information can be build from IPIF and IPRELIST sheet.
IPTREGMAP_relz.z | Description of mapping of test bit field when registers are internal to IP. This sheet is optional for IP which are not instanciating registers as information can be build from IPIF and IPRELIST sheet.
IPUDMACMDLIST_relz.z | Description of IP UDMA commands list used by IP.
IPUDMACMDMAP_relz.z | Description of mapping of bit fields in IP UDMA commands used by IP.

Sheet: Usage
IP Release Sheet
 | Column | Description | Possible Value
 | Version | IP release version numeroted as [major release].[minor release]. A release is major whenever IP interface is modified. | X.Y. Z
 | Release description | This is a free text entry expliciting the release main modifications and purpose. | Text
 | IPIF | IPIF sheet version to be used for this release. | X.Y. Z
 | IPDESCR | IPDESCR sheet version to nbe used for this release | X.Y.Z
 | IPREGLIST | IPREGLIST sheet version to be used for this release. | X.Y. Z
 | IPREGMAP | IPREGMAP sheet version to be used for this release. | X.Y. Z
 | IPUDMACMDLIST | IPUDMACMDLIST sheet version to be used for this release. | X.Y. Z
 | IPUDMACMDMAP | IPUDMACMDMAP sheet version to be used for this release. | X.Y. Z
 | IPDOC | IPDOC version to be used for this release. | X.Y. Z
 | GIT version | GIT database number corresponding to IP design code and IP reference XLS. | Integer
IPIF sheet
IP Interface description | IP Pin Name | Name of IP Pin. This must must exactly name find in code or schematic (including case).
 | Direction | Direction or type of signal | In,Out,IO
 | Type | Analog, Digital, supply, DR (Dual Rail), SR (SingleRail) | Analog,Digital, VDD, GND, DR, SR
 | Voltage Domain
 | Clock domain
 | IO
 | Size
 | Reset Value
 | Description
Integration information | Integration comment
 | Core Interface
 | Register Interface
 | Register name
 | DFT value
 | Level Shifter
 | Isolation cell
 | Connected to
 | Load
 | Drive
 | Destination supply
Hard Macro information | location
 | layer
 | Antenna
Additonal Information | FreeText 1
 | FreeText 2
Driver information | Function1
 | Function2

Sheet: IP Release
Version | Release description | IPDESCR | IPIF | IPREGLIST | IPREGMAP | IPUDMACMDLIST | IPUDMACMDMAP | IPDOC | GIT version
1.0.0 |  | Rel1.0.0 | Rel1.0.0 | Rel1.0.0 | Rel1.0.0 | Rel1.0.0 | Rel1.0.0

Sheet: IPIF_rel1.0.0
IP Interface description |  |  |  |  |  |  |  |  | Integration information |  |  |  |  |  |  |  |  |  |  |  |  | Hard Macro information |  |  | Additonal Information |  | Driver information
IP Pin Name | Direction | Type | Voltage Domain | Clock domain | IO | Size | Reset Value | Description | Integration comment | Core Interface | Register Interface | Register name | Bit position | Trim during production | DFT value | Level Shifter | Isolation cell | Connected to | Load | Drive | Destination supply | location | layer | Antenna | FreeText 1 | FreeText 2 | Function1 | Function2

Sheet: IPDESCR_rel1.0.0
Description
FC_CORE event unit component manages the following features: - FC_CORE software events generation - FC_CORE clock gate control - Wait for event functionality - Input event mask configuration - FC_CORE IRQ generation - FC_CORE secured and non-secured mode IRQ mask configuration
Events managed by FC event unit are: - 2 SoC high prioriy events - 1 SoC event generator fifo overflow error event - 1 MPU error event - 1 SoC peripheral event: when this event occurs, the SoC peripheral events fifo must be read to get the SoC event ID. - 2 FC timer events - 8 software events that can come from FC_CORE directly or external triggering.

Sheet: IPREGLIST_rel1.0.0
Register Name | Header | Address | Size | Register Type | Host Access Type | Host access bus | IP access Type | Default Value | Description | FootNote | Comment
EVT_MASK |  | 0x0 | 32 | Config | R/W | PERIPH/DEMUX | R/W | 0x0 | Input event mask configuration register.
EVT_MASK_AND |  | 0x4 | 32 | Config | W | PERIPH/DEMUX | R | 0x0 | Input event mask update command register with bitwise AND operation.
EVT_MASK_OR |  | 0x8 | 32 | Config | W | PERIPH/DEMUX | R | 0x0 | Input event mask update command register with bitwise OR operation.
IRQ_MASK |  | 0xC | 32 | Config | R/W | PERIPH/DEMUX | R/W | 0x0 | Interrupt request mask configuration register.
IRQ_MASK_AND |  | 0x10 | 32 | Config | W | PERIPH/DEMUX | R | 0x0 | Interrupt request mask update command register with bitwise AND operation.
IRQ_MASK_OR |  | 0x14 | 32 | Config | W | PERIPH/DEMUX | R | 0x0 | Interrupt request mask update command register with bitwise OR operation.
CLOCK_STATUS |  | 0x18 | 32 | Config | R | PERIPH/DEMUX | W | 0x0 | FC_CORE clock status register.
EVENT_BUFFER |  | 0x1C | 32 | Config | R | PERIPH/DEMUX | W | 0x0 | Pending input events status register.
EVENT_BUFFER_MASKED |  | 0x20 | 32 | Config | R | PERIPH/DEMUX | W | 0x0 | Pending input events status register with EVT_MASK applied.
EVENT_BUFFER_IRQ_MASKED |  | 0x24 | 32 | Config | R | PERIPH/DEMUX | W | 0x0 | Pending input events status register with IRQ_MASK applied.
EVENT_BUFFER_CLEAR |  | 0x28 | 32 | Config | W | PERIPH/DEMUX | R | 0x0 | Pending input events status clear command register.
EVENT_WAIT |  | 0x38 | 32 | Config | R | DEMUX | W | 0x0 | Input event wait command register.
EVENT_WAIT_CLEAR |  | 0x3C | 32 | Config | R | DEMUX | W | 0x0 | Input event wait and clear command register.
SEC_IRQ_MASK |  | 0x40 | 32 | Config | R/W | PERIPH/DEMUX | R/W | 0x0 | FC_CORE secured mode interrupt request mask configuration register.
SEC_IRQ_MASK_AND |  | 0x44 | 32 | Config | W | DEMUX | R | 0x0 | FC_CORE secured mode interrupt request mask update command register with bitwise AND operation.
SEC_IRQ_MASK_OR |  | 0x48 | 32 | Config | W | DEMUX | R | 0x0 | FC_CORE secured mode interrupt request mask update command register with bitwise OR operation.
SW_EVENT_0_TRIG |  | 0x100 | 32 | Config | W | DEMUX | R | 0x0 | FC_CORE Software event 0 trigger command register.
SW_EVENT_1_TRIG |  | 0x104 | 32 | Config | W | DEMUX | R | 0x0 | FC_CORE Software event 1 trigger command register.
SW_EVENT_2_TRIG |  | 0x108 | 32 | Config | W | DEMUX | R | 0x0 | FC_CORE Software event 2 trigger command register.
SW_EVENT_3_TRIG |  | 0x10C | 32 | Config | W | DEMUX | R | 0x0 | FC_CORE Software event 3 trigger command register.
SW_EVENT_4_TRIG |  | 0x110 | 32 | Config | W | DEMUX | R | 0x0 | FC_CORE Software event 4 trigger command register.
SW_EVENT_5_TRIG |  | 0x114 | 32 | Config | W | DEMUX | R | 0x0 | FC_CORE Software event 5 trigger command register.
SW_EVENT_6_TRIG |  | 0x118 | 32 | Config | W | DEMUX | R | 0x0 | FC_CORE Software event 6 trigger command register.
SW_EVENT_7_TRIG |  | 0x11C | 32 | Config | W | DEMUX | R | 0x0 | FC_CORE Software event 7 trigger command register.
SW_EVENT_0_WAIT |  | 0x140 | 32 | Config | R | DEMUX | W | 0x0 | FC_CORE Software event 0 wait command register.
SW_EVENT_1_WAIT |  | 0x144 | 32 | Config | R | DEMUX | W | 0x0 | FC_CORE Software event 1 wait command register.
SW_EVENT_2_WAIT |  | 0x148 | 32 | Config | R | DEMUX | W | 0x0 | FC_CORE Software event 2 wait command register.
SW_EVENT_3_WAIT |  | 0x14C | 32 | Config | R | DEMUX | W | 0x0 | FC_CORE Software event 3 wait command register.
SW_EVENT_4_WAIT |  | 0x150 | 32 | Config | R | DEMUX | W | 0x0 | FC_CORE Software event 4 wait command register.
SW_EVENT_5_WAIT |  | 0x154 | 32 | Config | R | DEMUX | W | 0x0 | FC_CORE Software event 5 wait command register.
SW_EVENT_6_WAIT |  | 0x158 | 32 | Config | R | DEMUX | W | 0x0 | FC_CORE Software event 6 wait command register.
SW_EVENT_7_WAIT |  | 0x15C | 32 | Config | R | DEMUX | W | 0x0 | FC_CORE Software event 7 wait command register.
SW_EVENT_0_WAIT_CLEAR |  | 0x180 | 32 | Config | R | DEMUX | W | 0x0 | FC_CORE Software event 0 wait and clear command register.
SW_EVENT_1_WAIT_CLEAR |  | 0x184 | 32 | Config | R | DEMUX | W | 0x0 | FC_CORE Software event 1 wait and clear command register.
SW_EVENT_2_WAIT_CLEAR |  | 0x188 | 32 | Config | R | DEMUX | W | 0x0 | FC_CORE Software event 2 wait and clear command register.
SW_EVENT_3_WAIT_CLEAR |  | 0x18C | 32 | Config | R | DEMUX | W | 0x0 | FC_CORE Software event 3 wait and clear command register.
SW_EVENT_4_WAIT_CLEAR |  | 0x190 | 32 | Config | R | DEMUX | W | 0x0 | FC_CORE Software event 4 wait and clear command register.
SW_EVENT_5_WAIT_CLEAR |  | 0x194 | 32 | Config | R | DEMUX | W | 0x0 | FC_CORE Software event 5 wait and clear command register.
SW_EVENT_6_WAIT_CLEAR |  | 0x198 | 32 | Config | R | DEMUX | W | 0x0 | FC_CORE Software event 6 wait and clear command register.
SW_EVENT_7_WAIT_CLEAR |  | 0x19C | 32 | Config | R | DEMUX | W | 0x0 | FC_CORE Software event 7 wait and clear command register.
REMOTE_SW_EVENT_0_TRIG |  | 0x600 | 32 | Config | W | PERIPH | R | 0x0 | Remote software event 0 trigger command register.
REMOTE_SW_EVENT_1_TRIG |  | 0x604 | 32 | Config | W | PERIPH | R | 0x0 | Remote software event 1 trigger command register.
REMOTE_SW_EVENT_2_TRIG |  | 0x608 | 32 | Config | W | PERIPH | R | 0x0 | Remote software event 2 trigger command register.
REMOTE_SW_EVENT_3_TRIG |  | 0x60C | 32 | Config | W | PERIPH | R | 0x0 | Remote software event 3 trigger command register.
REMOTE_SW_EVENT_4_TRIG |  | 0x610 | 32 | Config | W | PERIPH | R | 0x0 | Remote software event 4 trigger command register.
REMOTE_SW_EVENT_5_TRIG |  | 0x614 | 32 | Config | W | PERIPH | R | 0x0 | Remote software event 5 trigger command register.
REMOTE_SW_EVENT_6_TRIG |  | 0x618 | 32 | Config | W | PERIPH | R | 0x0 | Remote software event 6 trigger command register.
REMOTE_SW_EVENT_7_TRIG |  | 0x61C | 32 | Config | W | PERIPH | R | 0x0 | Remote software event 7 trigger command register.
SOC_PERIPH_EVENT_ID |  | 0x700 | 32 | Status | R | PERIPH | W | 0x0 | SoC peripheral event ID status register.

Sheet: IPREGMAP_rel1.0.0
Bit field | Register | Bit Position | Size | Host Access Type | IP access Type | Reset Value | Description
EM | EVT_MASK | 0 | 32 | R/W | R/W | 0x0 | Input event mask configuration bitfield: - EM[i]=1'b0: Input event request i is masked - EM[i]=1'b1: Input event request i is not masked
EMA | EVT_MASK_AND | 0 | 32 | W | R | 0x0 | Input event mask configuration bitfield update with bitwise AND operation. It allows clearing EM[i] if EMA[i]=1'b1.
EMO | EVT_MASK_OR | 0 | 32 | W | R | 0x0 | Input event mask configuration bitfield update with bitwise OR operation. It allows setting EM[i] if EMO[i]=1'b1.
IM | IRQ_MASK | 0 | 32 | R/W | R/W | 0x0 | Interrupt request mask configuration bitfield: - bit[i]=1'b0: Interrupt request i is masked - bit[i]=1'b1: Interrupt request i is not masked
IMA | IRQ_MASK_AND | 0 | 32 | W | R | 0x0 | Interrupt request mask configuration bitfield update with bitwise AND operation. It allows clearing IM[i] if IMA[i]=1'b1.
IMO | IRQ_MASK_OR | 0 | 32 | W | R | 0x0 | Interrupt request mask configuration bitfield update with bitwise OR operation. It allows setting IM[i] if IMO[i]=1'b1.
CS | CLOCK_STATUS | 0 | 1 | R | W | 0x0 | FC_CORE clock status bitfield: - CS=1'b0: FC_CORE clocked is gated - CS=1'b1: FC_CORE clocked is running
EB | EVENT_BUFFER | 0 | 32 | R | W | 0x0 | Pending input events status bitfield. EB[i]=1'b1 means that one or more input event i request are pending.
EBM | EVENT_BUFFER_MASKED | 0 | 32 | R | W | 0x0 | Pending input events status bitfield with EM applied. EBM[i]=1'b1 means that one or more input event i request are pending.
IBM | EVENT_BUFFER_IRQ_MASKED | 0 | 32 | R | W | 0x0 | Pending input events status bitfield with IM applied. IBM[i]=1'b1 means that one or more input events i are pending.
EBC | EVENT_BUFFER_CLEAR | 0 | 32 | W | R | 0x0 | Pending input events status clear command bitfield. It allows clearing EB[i] if EBC[i]=1'b1. | Clear content depends on the secured state of FC_CORE
EBM | EVENT_WAIT | 0 | 32 | R | W | 0x0 | Reading this register will gate the FC_CORE clock until at least one unmasked event occurs. The read content of this bitfield is equivalent to EVENT_BUFFER_MASKED.EBM
EBM | EVENT_WAIT_CLEAR | 0 | 32 | R | W | 0x0 | Reading this register has the same effect as reading EVENT_WAIT.EBM. In addition, EVENT_BUFFER.EB[i] bits are cleared if EVT_MASK.EM[i]=1'b1. The read content of this bitfield is equivalent to EVENT_BUFFER_MASKED.EBM
SIM | SEC_IRQ_MASK | 0 | 32 | R/W | R/W | 0x0 | Interrupt request mask configuration bitfield when FC_CORE is in secured mode: - bit[i]=1'b0: Interrupt request I is masked - bit[i]=1'b1: Interrupt request I is not masked
SIMA | SEC_IRQ_MASK_AND | 0 | 32 | W | R | 0x0 | Interrupt request mask configuration bitfield update with bitwise AND operation when FC_CORE is in secured mode. It allows clearing IM[i] if IMA[i]=1'b1.
SIMO | SEC_IRQ_MASK_OR | 0 | 32 | W | R | 0x0 | Interrupt request mask configuration bitfield update with bitwise OR operation when FC_CORE is in secured mode. It allows setting IM[i] if IMO[i]=1'b1.
SW0T | SW_EVENT_0_TRIG | 0 | 32 | W | R | 0x0 | Writing to this register triggers FC_CORE software event 0.
SW1T | SW_EVENT_1_TRIG | 0 | 32 | W | R | 0x0 | Writing to this register triggers FC_CORE software event 1.
SW2T | SW_EVENT_2_TRIG | 0 | 32 | W | R | 0x0 | Writing to this register triggers FC_CORE software event 2.
SW3T | SW_EVENT_3_TRIG | 0 | 32 | W | R | 0x0 | Writing to this register triggers FC_CORE software event 3.
SW4T | SW_EVENT_4_TRIG | 0 | 32 | W | R | 0x0 | Writing to this register triggers FC_CORE software event 4.
SW5T | SW_EVENT_5_TRIG | 0 | 32 | W | R | 0x0 | Writing to this register triggers FC_CORE software event 5.
SW6T | SW_EVENT_6_TRIG | 0 | 32 | W | R | 0x0 | Writing to this register triggers FC_CORE software event 6.
SW7T | SW_EVENT_7_TRIG | 0 | 32 | W | R | 0x0 | Writing to this register triggers FC_CORE software event 7.
EBM | SW_EVENT_0_WAIT | 0 | 32 | R | W | 0x0 | Reading this register will trigger FC_CORE sofware event 0 and gate the FC_CORE clock until at least one unmasked event occurs. The read content of this bitfield is equivalent to EVENT_BUFFER_MASKED.EBM
EBM | SW_EVENT_1_WAIT | 0 | 32 | R | W | 0x0 | Reading this register will trigger FC_CORE sofware event 1 and gate the FC_CORE clock until at least one unmasked event occurs. The read content of this bitfield is equivalent to EVENT_BUFFER_MASKED.EBM
EBM | SW_EVENT_2_WAIT | 0 | 32 | R | W | 0x0 | Reading this register will trigger FC_CORE sofware event 2 and gate the FC_CORE clock until at least one unmasked event occurs. The read content of this bitfield is equivalent to EVENT_BUFFER_MASKED.EBM
EBM | SW_EVENT_3_WAIT | 0 | 32 | R | W | 0x0 | Reading this register will trigger FC_CORE sofware event 3 and gate the FC_CORE clock until at least one unmasked event occurs. The read content of this bitfield is equivalent to EVENT_BUFFER_MASKED.EBM
EBM | SW_EVENT_4_WAIT | 0 | 32 | R | W | 0x0 | Reading this register will trigger FC_CORE sofware event 4 and gate the FC_CORE clock until at least one unmasked event occurs. The read content of this bitfield is equivalent to EVENT_BUFFER_MASKED.EBM
EBM | SW_EVENT_5_WAIT | 0 | 32 | R | W | 0x0 | Reading this register will trigger FC_CORE sofware event 5 and gate the FC_CORE clock until at least one unmasked event occurs. The read content of this bitfield is equivalent to EVENT_BUFFER_MASKED.EBM
EBM | SW_EVENT_6_WAIT | 0 | 32 | R | W | 0x0 | Reading this register will trigger FC_CORE sofware event 6 and gate the FC_CORE clock until at least one unmasked event occurs. The read content of this bitfield is equivalent to EVENT_BUFFER_MASKED.EBM
EBM | SW_EVENT_7_WAIT | 0 | 32 | R | W | 0x0 | Reading this register will trigger FC_CORE sofware event 7 and gate the FC_CORE clock until at least one unmasked event occurs. The read content of this bitfield is equivalent to EVENT_BUFFER_MASKED.EBM
EBM | SW_EVENT_0_WAIT_CLEAR | 0 | 32 | R | W | 0x0 | Reading this register will trigger FC_CORE sofware event 0 and gate the FC_CORE clock until at least one unmasked event occurs. In addition, EVENT_BUFFER.EB[i] bits are cleared if EVT_MASK.EM[i]=1'b1 after the read. The read content of this bitfield is equivalent to EVENT_BUFFER_MASKED.EBM
EBM | SW_EVENT_1_WAIT_CLEAR | 0 | 32 | R | W | 0x0 | Reading this register will trigger FC_CORE sofware event 1 and gate the FC_CORE clock until at least one unmasked event occurs. In addition, EVENT_BUFFER.EB[i] bits are cleared if EVT_MASK.EM[i]=1'b1 after the read. The read content of this bitfield is equivalent to EVENT_BUFFER_MASKED.EBM
EBM | SW_EVENT_2_WAIT_CLEAR | 0 | 32 | R | W | 0x0 | Reading this register will trigger FC_CORE sofware event 2 and gate the FC_CORE clock until at least one unmasked event occurs. In addition, EVENT_BUFFER.EB[i] bits are cleared if EVT_MASK.EM[i]=1'b1 after the read. The read content of this bitfield is equivalent to EVENT_BUFFER_MASKED.EBM
EBM | SW_EVENT_3_WAIT_CLEAR | 0 | 32 | R | W | 0x0 | Reading this register will trigger FC_CORE sofware event 3 and gate the FC_CORE clock until at least one unmasked event occurs. In addition, EVENT_BUFFER.EB[i] bits are cleared if EVT_MASK.EM[i]=1'b1 after the read. The read content of this bitfield is equivalent to EVENT_BUFFER_MASKED.EBM
EBM | SW_EVENT_4_WAIT_CLEAR | 0 | 32 | R | W | 0x0 | Reading this register will trigger FC_CORE sofware event 4 and gate the FC_CORE clock until at least one unmasked event occurs. In addition, EVENT_BUFFER.EB[i] bits are cleared if EVT_MASK.EM[i]=1'b1 after the read. The read content of this bitfield is equivalent to EVENT_BUFFER_MASKED.EBM
EBM | SW_EVENT_5_WAIT_CLEAR | 0 | 32 | R | W | 0x0 | Reading this register will trigger FC_CORE sofware event 5 and gate the FC_CORE clock until at least one unmasked event occurs. In addition, EVENT_BUFFER.EB[i] bits are cleared if EVT_MASK.EM[i]=1'b1 after the read. The read content of this bitfield is equivalent to EVENT_BUFFER_MASKED.EBM
EBM | SW_EVENT_6_WAIT_CLEAR | 0 | 32 | R | W | 0x0 | Reading this register will trigger FC_CORE sofware event 6 and gate the FC_CORE clock until at least one unmasked event occurs. In addition, EVENT_BUFFER.EB[i] bits are cleared if EVT_MASK.EM[i]=1'b1 after the read. The read content of this bitfield is equivalent to EVENT_BUFFER_MASKED.EBM
EBM | SW_EVENT_7_WAIT_CLEAR | 0 | 32 | R | W | 0x0 | Reading this register will trigger FC_CORE sofware event 7 and gate the FC_CORE clock until at least one unmasked event occurs. In addition, EVENT_BUFFER.EB[i] bits are cleared if EVT_MASK.EM[i]=1'b1 after the read. The read content of this bitfield is equivalent to EVENT_BUFFER_MASKED.EBM
TRIG | REMOTE_SW_EVENT_0_TRIG | 0 | 32 | W | R | 0x0 | Writing any value will trigger SoC software event 0
TRIG | REMOTE_SW_EVENT_1_TRIG | 0 | 32 | W | R | 0x0 | Writing any value will trigger SoC software event 1
TRIG | REMOTE_SW_EVENT_2_TRIG | 0 | 32 | W | R | 0x0 | Writing any value will trigger SoC software event 2
TRIG | REMOTE_SW_EVENT_3_TRIG | 0 | 32 | W | R | 0x0 | Writing any value will trigger SoC software event 3
TRIG | REMOTE_SW_EVENT_4_TRIG | 0 | 32 | W | R | 0x0 | Writing any value will trigger SoC software event 4
TRIG | REMOTE_SW_EVENT_5_TRIG | 0 | 32 | W | R | 0x0 | Writing any value will trigger SoC software event 5
TRIG | REMOTE_SW_EVENT_6_TRIG | 0 | 32 | W | R | 0x0 | Writing any value will trigger SoC software event 6
TRIG | REMOTE_SW_EVENT_7_TRIG | 0 | 32 | W | R | 0x0 | Writing any value will trigger SoC software event 7
ID | SOC_PERIPH_EVENT_ID | 0 | 8 | R | W | 0x0 | Oldest SoC peripheral event ID status bitfield.
VALID | SOC_PERIPH_EVENT_ID | 31 | 1 | R | W | 0x0 | Validity bit of SOC_PERIPH_EVENT_ID.ID bitfield.

Sheet: VerPlan_rel1.0.0
Name | Description | testcase location&name | Status
