pulp-platform/pulp/doc/IP_REFERENCES/FLL_reference.xlsx

Sheet: Info
Document Information
Name | FLL reference
Category | IP reference
Author | Florent Rotenberg
Version | 1.0
Status | Fisrt Release
Description | FLL interface definition
IP Information
IP type | FLL
Delivery Type
History
Date | Modification | Author
26/10/2016 | 1st release | F.Rotenberg
Content
Info | This sheet. General information about document usage
Usage | Guidelines on how to used the various sheet
IP Release | Release information sheet describing
IPIF_relx.x | IP interface description reference, describing IP symbol/entity and integration and test information relative to IP interface.
IPDESCR_Relx.x | Description of the main features of the IP
IPREGLIST_rely.y | Description of the list of registers used by IP. Registers can be physically instanciated inside IP or outside IP.
IPREGMAP_relz.z | Description of mapping of bit fields when registers are internal to IP. This sheet is optional for IP which are not instanciating registers as information can be build from IPIF and IPRELIST sheet.
IPTREGMAP_relz.z | Description of mapping of test bit field when registers are internal to IP. This sheet is optional for IP which are not instanciating registers as information can be build from IPIF and IPRELIST sheet.

Sheet: Usage
IP Release Sheet
 | Column | Description | Possible Value
 | Version | IP release version numeroted as [major release].[minor release]. A release is major whenever IP interface is modified. | X.Y. Z
 | Release description | This is a free text entry expliciting the release main modifications and purpose. | Text
 | IPIF | IPIF sheet version to be used for this release. | X.Y. Z
 | IPDESCR | IPDESCR sheet version to nbe used for this release | X.Y.Z
 | IPREGLIST | IPREGLIST sheet version to be used for this release. | X.Y. Z
 | IPREGMAP | IPREGMAP sheet version to be used for this release. | X.Y. Z
 | IPDOC | IPDOC version to be used for this release. | X.Y. Z
 | GIT version | GIT database number corresponding to IP design code and IP reference XLS. | Integer
IPIF sheet
IP Interface description | IP Pin Name | Name of IP Pin. This must must exactly name find in code or schematic (including case).
 | Direction | Direction or type of signal | In,Out,IO
 | Type | Analog, Digital, supply, DR (Dual Rail), SR (SingleRail) | Analog,Digital, VDD, GND, DR, SR
 | Voltage Domain
 | Clock domain
 | IO
 | Size
 | Reset Value
 | Description
Integration information | Integration comment
 | Core Interface
 | Register Interface
 | Register name
 | DFT value
 | Level Shifter
 | Isolation cell
 | Connected to
 | Load
 | Drive
 | Destination supply
Hard Macro information | location
 | layer
 | Antenna
Additonal Information | FreeText 1
 | FreeText 2
Driver information | Function1
 | Function2

Sheet: IP Release
Version | Release description | IPIF | IPDESCR | IPREGLIST | IPREGMAP | IPDOC | GIT version
1.0.0 |  | Rel1.0.0 | Rel1.0.0 | Rel1.0.0 | Rel1.0.0

Sheet: IPIF_rel1.0.0
IP Interface description |  |  |  |  |  |  |  |  | Integration information |  |  |  |  |  |  |  |  |  |  |  |  | Hard Macro information |  |  | Additonal Information |  | Driver information
IP Pin Name | Direction | Type | Voltage Domain | Clock domain | IO | Size | Reset Value | Description | Integration comment | Core Interface | Register Interface | Register name | Bit position | Trim during production | DFT value | Level Shifter | Isolation cell | Connected to | Load | Drive | Destination supply | location | layer | Antenna | FreeText 1 | FreeText 2 | Function1 | Function2

Sheet: IPDESCR_rel1.0.0
Description
FLL component manages the following features: - generation of a clock signal that is locked to a frequency requested - 2 configurable modes: normal and standalone - output clock can be gated when unlocked

Sheet: IPREGLIST_rel1.0.0
Register Name | Header | Address | Size | Register Type | Host Access Type | IP access Type | Default Value | Description | FootNote | Comment
STATUS |  | 0x0 | 32 | Config | R/W | R/W | 0x0 | FLL status register.
CFG1 |  | 0x4 | 32 | Config | R/W | R/W | 0x0 | FLL configuration 1 register.
CFG2 |  | 0x8 | 32 | Config | R/W | R/W | 0x0 | FLL configuration 2 register.
INTEG |  | 0xC | 32 | Config | R/W | R/W | 0x0 | FLL integrator configuration register.

Sheet: IPREGMAP_rel1.0.0
Bit field | Register | Bit Position | Size | Host Access Type | IP access Type | Reset Value | Description
MF | STATUS | 0 | 16 | R | W | 0x0 | Current DCO multiplication factor value bitfield.
MFN | CFG1 | 0 | 16 | R/W | R/W | 0x0 | Target clock multiplication factor in normal mode bitfield.
ICS | CFG1 | 16 | 10 | R/W | R/W | 0x0 | DCO input code in standalone mode bitfield.
CKDIV | CFG1 | 26 | 4 | R/W | R/W | 0x0 | FLL output clock divider configuration bitfield.
CKG | CFG1 | 30 | 1 | R/W | R/W | 0x0 | FLL output gated by LOCK signal configuration bitfield: - 1'b0: not gated - 1'b1: gated
CKM | CFG1 | 31 | 1 | R/W | R/W | 0x0 | FLL operation mode configuration bitfield: - 1'b0: standalone - 1'b1: normal
LG | CFG2 | 0 | 4 | R/W | R/W | 0x9 | FLL loop gain setting bitfield.
UCKL | CFG2 | 4 | 6 | R/W | R/W | 0x0 | Number of unstable REFCLK cycles until LOCK de-assert in normal mode. Lower 6-bit of LOCK assert counter target in standalone mode.
SCKL | CFG2 | 10 | 6 | R/W | R/W | 0x0 | Number of stable REFCLK cycles until LOCK assert in normal mode. Upper 6-bit of LOCK assert counter target in standalone mode.
LT | CFG2 | 16 | 12 | R/W | R/W | 0x0 | Lock tolerance configuration bitfield. It is the margin around multiplication factor within which the output clock is considered stable.
CKSEL | CFG2 | 29 | 1 | R/W | R/W | 0x0 | Configuration clock selection in standalone mode bitfield: - 1'b0: DCO clock - 1'b1: Reference clock
OL | CFG2 | 30 | 1 | R/W | R/W | 0x0 | Open loop when locked activation bitfield: - 1'b0: disabled - 1'b1: enabled
DITH | CFG2 | 31 | 1 | R/W | R/W | 0x0 | Dithering activation bitfield: - 1'b0: disabled - 1'b1: enabled
FRAC | INTEG | 6 | 10 | R/W | R/W | 0x0 | Fractional part of integrator state bitfield. It corresponds to dither unit input.
INTEG | INTEG | 16 | 10 | R/W | R/W | 0x0 | integer part of integrator state bitfield. It corresponds to DCO unit bits.

Sheet: VerPlan_rel1.0.0
Name | Description | testcase location&name | Status
