pulp-platform/pulp/(list of files, cad)

Other CAD files:
doc/datasheet/figures_raw/riscv_overview.obj
