pulp-platform/pulp/(threads)

Thread 5 (2019-02-05):

Import Error on ./update-ips

AshwiniPohekar, 2019-02-05:
When I try to build the RTL simulation platform for the PULP system.
On trying to run ./update-ips this error is generated and ips.mk and rtl.mk files are not created inside the sim folder.

```
SUMMARY
IPs updated successfully!
Traceback (most recent call last):
  File "./generate-scripts", line 7, in <module>
    from ipstools_cfg import *
  File "/home/ashwini/pulp-sdk/pulp-master/ipstools_cfg.py", line 43, in <module>
    import ipstools
  File "/home/ashwini/pulp-sdk/pulp-master/ipstools/__init__.py", line 16, in <module>
    from .ipstools import *
  File "ipstools/ipstools/__init__.py", line 13, in <module>
    from .SubIPConfig import *
  File "ipstools/ipstools/SubIPConfig.py", line 14, in <module>
    from .IPApproX_common        import *
  File "ipstools/ipstools/IPApproX_common.py", line 20, in <module>
    import yaml
ImportError: No module named yaml
```

I am also attaching a screenshot of the error from the terminal. Also, I am building the sdk before building the rtl platfrom. The sdk is built sucessfully.

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

FrancescoConti, 2019-02-05:
As indicated by the last line, you need to install the YAML package.

https://stackoverflow.com/questions/14261614/how-do-i-install-the-yaml-package-for-python

AshwiniPohekar, 2019-02-05:
I forgot to mention this but ./update-ips works without any issue for pulpissimo. Should it not have complained about this package in that case as well.

In any case I will look into the link that you have mentioned for installing the package.

AshwiniPohekar, 2019-02-05:
I was able to get it to work after installing the package : pyyaml.

Thanks!

BenoitDenkinger, 2019-02-07:
I also got the same issue with yaml installed, until I realized generate-scripts is using the default python (usually python 2) and I had yaml installed for python 3. So I changed the first line to #!/usr/bin/env python3

lso425, 2021-06-04:
I have this problem, when I put the command ./update-ips

**Traceback (most recent call last):
  File "./update-ips", line 7, in <module>
    from ipstools import ipstools
ImportError: No module named **'ipstools'****

How can I solve it?

RaphaelKlink, 2021-07-01:
I have the same problem in the pulpissimo project. I checked multiple times if this module is installed and it finds it every time.
@Iso425 what kind of OS are you using? I am using Ubuntu 20.04 LTS.

darphee1025, 2023-03-27:
I had this problem . When I try to build the RTL simulation platform for the PULP system.
Updating ip 'L2_tcdm_hybrid_interco'...
Traceback (most recent call last):
  File "./update-ips", line 53, in <module>
    ipdb.update_ips()
  File "ipstools/ipstools/IPDatabase.py", line 604, in update_ips
ValueError: invalid literal for int() with base 10: b''

what can I do for it?

Closed 2020-05-26.

Thread 6 (2019-02-26):

L2_priv0 saturation

Alessandro0110, 2019-02-26:
Hello, thank you for your work. I am trying to run a program in which almost all data are stored in the L1 memory located in the cluster domain. In order to do this almost all variables are global and the statement RT_L1_DATA is used in their declaration. I have computed the quantity of data occupied by these variables and it is equal to almost 32KB (a little bit less). The other temporary variables declared during the execution of the program should occupy much lower space and I think that they are negligible in this computation.
The problem is the following:

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

Since the L1 memory is mainly used, I don't understand the reason why the problem is related to L2_priv0 that is a private FC memory bank. Anyone have an idea how to solve this problem?

Thank you in advance for the help.

haugoug, 2019-02-26:
Since pulp chips always have the cluster powered down when the application binary is loaded, we put L1 initial values in L2, so that we can transfer them from L2 to L1 when the cluster is powered up during execution.
Although the open-source pulp always have the cluster powered-up, the runtime is still keeping L1 initial values in L2, which gets saturated in your case.
We will remove this feature soon for pulp. For now the only solution is for you is to patch this linker script: runtime/pulp-rt/rules/pulp/link.ld

Alessandro0110, 2019-02-26:
I think that an other solutions could be the dynamic allocation by using the utility rt_alloc(RT_ALLOC_CL_DATA,...) in the cluster is it right?
I tried to modify the linker script but when I move the ORIGIN address of the L2_priv1 the result is the following:

#          26409859620: Illegal instruction (core 0) at PC 0x1c008080:

# Instruction is valid, but has at least one X

#          26410086948: Illegal instruction (core 0) at PC 0x1c008084:

# Instruction is valid, but has at least one X

Thank you in advance for the help.

haugoug, 2019-02-26:
Yes going through dynamic allocation is a better solution

Closed 2019-02-27.

Thread 8 (2019-09-09):

spi flash boot

hb-yu-asic, 2019-09-09:
Hi, I'm trying to boot openpulp through external spi flash. I have followed the steps described in the README (https://github.com/pulp-platform/pulp/tree/master/rtl/vip/spi_flash), but i can not boot pulp successfully. I can not see any active waveform on the spim ports. How can i solve this problem?

Thread 21 (2019-12-26):

build pulp sdk failed

869523031, 2019-12-26:
I'm following the tutorial on PULP SDK build process ,I'm blocked at the stage of SDK build when I tape the command "$ make all" and I can't understand what's mean these errors.

git submodule update --init
source init.sh && ./pulp-tools/bin/plpbuild --p sdk checkout build env --stdout
Configuring Pulp project at /root/pulpshp/pulp-sdk
FATAL ERROR: Configurations must e given either through PULP_CURRENT_CONFIG or PULP_CONFIGS
Makefile:6: recipe for target 'all' failed
make: *** [all] Error 255

Waitting for your help

milos-tomic, 2020-01-28:
I'm facing the same issue. It looks for the environmental variables and fails if they are not defined:

What is strange is that I checked PULP_CURRENT_CONFIG and it is set:
```
echo $PULP_CURRENT_CONFIG
pulpissimo@config_file=chips/pulpissimo/pulpissimo_ibex.json
```
I'm not sure if this is good though... It is a value from the config file I sourced. I tried different configs, but always the same error.

milos-tomic, 2020-01-28:
@869523031 Did you try `echo` command on environmental variable? They should be set with "source configs/<config_file>"
I just found the answer to my question in this thread: https://pulp-platform.org/community/printthread.php?tid=132
I was executing the command using with `sudo` prefix and that caused the issue.

FrancescoConti, 2020-05-26:
Running anything related to PULP as root (i.e. prepended with `sudo`) is **definitely** not recommended -- the only exception is installing packages with APT or similar.

Closed 2020-05-26.

Thread 41 (2020-12-22):

How many cores does the pulp support at most?

First-Killer, 2020-12-22:
I read it is an open-source multi-core computing platform,but what's the largest number of cores?

FrancescoConti, 2020-12-22:
The main scalability limitation of a tightly coupled cluster of cores is the timing of the L1-core interconnect. Currently, we taped out and tested PULP chips with up to 16 cores (http://asic.ethz.ch/2020/Dustin.html). Keep in mind that the main target of PULP is low-power extreme edge computing, so the benefit of going much beyond that in symmetric multi-processing is probably overrun by the limitations.
That said, people in our group are working on larger scale applications (e.g., @suehtamacv https://arxiv.org/pdf/2012.02973.pdf ) so stay tuned.

First-Killer, 2020-12-24:
> 紧密耦合的内核集群的主要可伸缩性限制是L1内核互连的时序。目前，我们以最多16个内核（http://asic.ethz.ch/2020/Dustin.html）进行了磁带测试。请记住，PULP的主要目标是低功耗的极端边缘计算，因此，在限制上，超出对称多处理中的范围的好处可能超出了限制。
> 就是说，我们小组中的人们正在开发更大规模的应用程序（例如@suehtamacv https://arxiv.org/pdf/2012.02973.pdf），敬请关注。

Thank you!

Closed 2020-12-22.

Thread 43 (2021-01-22):

How to change Pulp clusters' core to cv32e40p core

DongYu2013, 2021-01-22:
Recently, when I transplanted cv32e40p on the cluster side of Pulp, I have some difficulties——I failed to change the core, but I could not solved it. In addition to the interface mismatch, some internal logic is also different, including the fetching and decoding stages.
In this regard, I would like to ask how to implement Pulp's cluster kernel to cv32e40p. I have read cv32e40p user manual，but I still not success for it.
Thank you.

Thread 46 (2021-04-02):

openocd can't hart the fc core

zhangpipi-xyz, 2021-04-02:
Hi,
I move the pulp project from fpga xcku115-flvd1924-1-c to fpga xczu15eg-ffvb1156-2-i.the clock of the cluster is griven by the soc_clk_rst_gen module same as the clk of the fc.
However,openocd can hart the fc core on the platform of the  xcku115-flvd1924-1-c；and can't hart the fc core on the platform of the xczu15eg-ffvb1156-2-i,the error is unable to halt hart 992;Target not examined yet and so on.
On the other hand ,if the clk of the cluster is 1'b0 always;the openocd can hart the fc core on the platform  xczu15eg-ffvb1156-2-i.
The version of the openocd is Open On-Chip Debugger 0.10.0+dev-01404-g1ba1b87 ;ubuntu 16.04;
The following pic is the situation openocd can't hart fc core.
Thank you!
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

x11to, 2023-07-06:
I encountered  the same problem. How did you solved it?

zhangpipi-xyz, 2023-07-06:
您好，晨曦收到您的来信，祝您愉快~O(∩_∩)O~

Closed 2021-06-04.

Thread 50 (2021-06-04):

after the code eoc_fetch_enable_remote is execute，the fc can not read data from cluster tcdm

zhangpipi-xyz, 2021-06-04:
after the code eoc_fetch_enable_remote is execute，the fc can not read data from cluster tcdm. I wonder why the cluster core can decide the fc whether have access to the cluster tcdm. thank you very much!

Closed 2021-06-07.

Thread 64 (2021-12-06):

Error with OpenOCD

odedeini, 2021-12-06:
Hi,

I followed the instructions for the implementation of the platform over vcu118 FPGA.

I programmed the FPGA with the bitstream and closed the connected server from Vivado.

I cloned pulp-sdk with the mentioned tag and built it accordingly.

A config file for vcu118 is not provided so I looked online and gathered configurations to a config file (I set the frequency as 10MHz everywhere so I also set it as 10MHz for the config file):

===========================================================================================
adapter_khz     10000

interface ftdi

ftdi_vid_pid 0x0403 0x6014

ftdi_layout_init 0x00e8 0x00eb
ftdi_layout_signal nSRST -oe 0x0200
ftdi_layout_signal nTRST -data 0x0100
ftdi_layout_signal LED -data 0x0800

set _CHIPNAME riscv

jtag newtap $_CHIPNAME unknown0 -irlen 5 -expected-id 0x10102001
jtag newtap $_CHIPNAME cpu -irlen 5 -expected-id 0x249511C3

set _TARGETNAME $_CHIPNAME.cpu
target create $_TARGETNAME riscv -chain-position $_TARGETNAME -coreid 0x3e0

gdb_report_data_abort enable
gdb_report_register_access_error enable

riscv set_reset_timeout_sec 120
riscv set_command_timeout_sec 120

\# prefer to use sba for system bus access
riscv set_prefer_sba on

\# dump jtag chain
scan_chain

init
halt
echo "Ready for Remote Connections"

===========================================================================================

The  output of the command "$OPENOCD/bin/openocd -f ./vcu118.cfg" is:

===========================================================================================
~/pulp-sdk$ $OPENOCD/bin/openocd -f ./vcu118.cfg
Open On-Chip Debugger 0.10.0+dev-00615-ge0035f875-dirty (2021-12-06-10:54)
Licensed under GNU GPL v2
For bug reports, read
	http://openocd.org/doc/doxygen/bugs.html
adapter speed: 10000 kHz
Info : auto-selecting first available session transport "jtag". To override use 'transport select <transport>'.
   TapName             Enabled  IdCode     Expected   IrLen IrCap IrMask
-- ------------------- -------- ---------- ---------- ----- ----- ------
 0 riscv.unknown0         Y     0x00000000 0x10102001     5 0x01  0x03
 1 riscv.cpu              Y     0x00000000 0x249511c3     5 0x01  0x03
Info : ftdi: if you experience problems at higher adapter clocks, try the command "ftdi_tdo_sample_edge falling"
Info : clock speed 10000 kHz
Info : JTAG tap: riscv.unknown0 tap/device found: 0x14b31093 (mfg: 0x049 (Xilinx), part: 0x4b31, ver: 0x1)
Warn : JTAG tap: riscv.unknown0       UNEXPECTED: 0x14b31093 (mfg: 0x049 (Xilinx), part: 0x4b31, ver: 0x1)
Error: JTAG tap: riscv.unknown0  expected 1 of 1: 0x10102001 (mfg: 0x000 (<invalid>), part: 0x0102, ver: 0x1)
Info : JTAG tap: riscv.cpu tap/device found: 0xffffffff (mfg: 0x7ff (<invalid>), part: 0xffff, ver: 0xf)
Warn : JTAG tap: riscv.cpu       UNEXPECTED: 0xffffffff (mfg: 0x7ff (<invalid>), part: 0xffff, ver: 0xf)
Error: JTAG tap: riscv.cpu  expected 1 of 1: 0x249511c3 (mfg: 0x0e1 (Wintec Industries), part: 0x4951, ver: 0x2)
Error: Trying to use configured scan chain anyway...
Error: riscv.cpu: IR capture error; saw 0x0b not 0x01
Warn : Bypassing JTAG setup events due to errors
Error: Unsupported DTM version: 15
Info : Listening on port 3333 for gdb connections
Error: Target not examined yet

Error: Unsupported DTM version: 15

===========================================================================================

I don't know if it matters, but in Vivado I noticed that the ID code of the xcvu9p_0 chip is also 14B31093 (same as in the previous output).

Thanks for your help

Thread 83 (2023-07-11):

Attaching a hardware accelerator / Custom IP within pulp_cluster via AXI

prajwalkashyap, 2023-07-11:
Hello,

I want to attach a custom IP within the pulp_cluster. I couldn't find any documents or steps anywhere to do this. I used this
https://github.com/pulp-platform/pulpissimo/issues/222 to attach an IP in pulp_soc and it works fine.  Can somebody share the steps/doc to attach an IP in pulp_cluster ?

Thank you

FrancescoConti, 2023-07-11:
It does not make too much sense IMHO to attach an AXI accelerator _within_ the cluster, as the act of coupling them by AXI makes them pretty much decoupled (same level of coupling as a L2 accelerator). For example, the cluster is itself an "AXI-coupled accelerator" of the pulp-soc.
So I see two options:
1. you attach the accelerator to the AXI cluster interconnect, which is not that different from doing exactly the same on the SoC side... there is nothing "premade" there, but you can follow what is done for the cores themselves https://github.com/pulp-platform/pulp_cluster/blob/e87fc585b90aa54148017a2d3072337ec7534f17/rtl/pulp_cluster.sv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 . Notice you will be limited in bandwidth by the width of the AXI bus. This is more similar to what you are asking in your question!
2. you exploit HWPE IPs as suggested by @GiannaP in the referred issue. You can find several examples +  docs in https://hwpe-doc.readthedocs.io/en/latest/ . This is less aligned with your original request as it allows for much tighter integration with the cluster (and much higher bandwidth to TCDM).

prajwalkashyap, 2023-07-11:
Hi @FrancescoConti Thank you for replying. I am implementing point no 1. I think the cluster address is 32'h1000_0000 to 32'h1040_0000 according to soc_mem_map.svh file. But in cluster_bus_wrap.sv there is something called ext slave with address as

start_addr: cluster_base_addr + 32'h0040_0000,
end_addr:   32'hFFFF_FFFF

Now if I add my IP, what address range can I use? and also should I add this address anywhere in pulp_soc or soc_interconnect_wrap.sv ?

Thank you

Closed 2023-07-11.

Thread 89 (2023-10-11):

Debug Module did not become active. dmcontrol=0x0

prajwalkashyap, 2023-10-11:
Hello,

I am trying to OpenPULP on NEXYS VIDEO board but with just the FC CORE and 1 Cluster Core. I am using the below commands in my openocd cfg file

########################################

adapter_khz     1000

interface ftdi
ftdi_vid_pid 0x0403 0x6010
ftdi_channel 0
ftdi_layout_init 0x0018 0x001b
ftdi_layout_signal nTRST -ndata 0x0010

set _CHIPNAME riscv

jtag newtap $_CHIPNAME unknown0 -irlen 5 -expected-id 0x10102001
jtag newtap $_CHIPNAME cpu -irlen 5 -expected-id 0x249511C3

set _TARGETNAME $_CHIPNAME.cpu
target create $_TARGETNAME riscv -chain-position $_TARGETNAME -coreid 0x3e0

gdb_report_data_abort enable
gdb_report_register_access_error enable

riscv set_reset_timeout_sec 120
riscv set_command_timeout_sec 120

# prefer to use sba for system bus access
#riscv set_prefer_sba on

# dump jtag chain
scan_chain

init
halt
echo "Ready for Remote Connections"

##########################################################

when I run openocd -f <the_above_cfg.cfg> I get the below error

Open On-Chip Debugger 0.12.0+dev-01243-g24b656bff (2023-06-05-14:15)
Licensed under GNU GPL v2
For bug reports, read
	http://openocd.org/doc/doxygen/bugs.html
DEPRECATED! use 'adapter speed' not 'adapter_khz'
DEPRECATED! use 'adapter driver' not 'interface'
DEPRECATED! use 'ftdi vid_pid' not 'ftdi_vid_pid'
DEPRECATED! use 'ftdi channel' not 'ftdi_channel'
DEPRECATED! use 'ftdi layout_init' not 'ftdi_layout_init'
DEPRECATED! use 'ftdi layout_signal' not 'ftdi_layout_signal'
Info : auto-selecting first available session transport "jtag". To override use 'transport select <transport>'.
Info : clock speed 1000 kHz
Info : JTAG tap: riscv.unknown0 tap/device found: 0x10102001 (mfg: 0x000 (<invalid>), part: 0x0102, ver: 0x1)
Info : JTAG tap: riscv.cpu tap/device found: 0x249511c3 (mfg: 0x0e1 (Wintec Industries), part: 0x4951, ver: 0x2)
Error: Debug Module did not become active. dmcontrol=0x0
Warn : target riscv.cpu examination failed
Info : starting gdb server for riscv.cpu on 3333
Info : Listening on port 3333 for gdb connections
Error: Target not examined yet

How can this be solved?

l1onog, 2024-05-07:
hi, @prajwalkashyap I have the same problem as you, have you solved it and what method did you use?

Thread 93 (2024-05-07):

Error: Debug Module did not become active. dmcontrol=0x0

l1onog, 2024-05-07:
I implemented PULP SoC on a Zcu102 fpga. I am trying to use openOCD and jtag-hs2 to download code to the board as instructed in the README. Does anyone know what could potentially cause this error and ways to fix it? I would really appreciate it.

Here is what it shows when I run with -d3 flag:
[d3-2024-05-07.txt](https://github.com/pulp-platform/pulp/files/15236174/d3-2024-05-07.txt)

Thread 95 (2025-03-01):

Makefile:87:1ibrbs.so  or multiple definition of 'tck'

wudeshijie, 2025-03-01:
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
you can  modify remote_bitbang.h, like this

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
then  modify remote_bitbang.c, can solve

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

FrancescoConti, 2025-03-01:
Do you care to explain what this means? What is the supposed issue here?

wudeshijie, 2025-03-01:
These variables are defined directly (rather than declared) in the header file, resulting in each source file (.c or .cpp) containing the header file generating a separate variable entity at compile time, which conflicts are created when linked.

PengchengYang-xdu, 2025-03-01:
Same. ^_^
