pulp-platform/pulp/rtl/pulp/pulp.sv

// Copyright 2018 ETH Zurich and University of Bologna.
// Copyright and related rights are licensed under the Solderpad Hardware
// License, Version 0.51 (the "License"); you may not use this file except in
// compliance with the License.  You may obtain a copy of the License at
// http://solderpad.org/licenses/SHL-0.51. Unless required by applicable law
// or agreed to in writing, software, hardware and materials distributed under
// this License is distributed on an "AS IS" BASIS, WITHOUT WARRANTIES OR
// CONDITIONS OF ANY KIND, either express or implied. See the License for the
// specific language governing permissions and limitations under the License.

`include "pulp_soc_defines.sv"
`include "soc_bus_defines.sv"

module pulp
#(
  parameter CORE_TYPE_FC = 0, // 0 for RISCY, 1 for IBEX RV32IMC (formerly ZERORISCY), 2 for IBEX RV32EC (formerly MICRORISCY)
  parameter CORE_TYPE_CL = 0, // 0 for RISCY, 1 for IBEX RV32IMC (formerly ZERORISCY), 2 for IBEX RV32EC (formerly MICRORISCY)
  parameter USE_FPU      = 1,
  parameter USE_HWPE     = 1,
  parameter USE_HWPE_CL  = 1
)
(

   inout  wire        pad_spim_sdio0,
   inout  wire        pad_spim_sdio1,
   inout  wire        pad_spim_sdio2,
   inout  wire        pad_spim_sdio3,
   inout  wire        pad_spim_csn0,
   inout  wire        pad_spim_csn1,
   inout  wire        pad_spim_sck,

   inout  wire        pad_uart_rx,
   inout  wire        pad_uart_tx,

   inout  wire        pad_cam_pclk,
   inout  wire        pad_cam_hsync,
   inout  wire        pad_cam_data0,
   inout  wire        pad_cam_data1,
   inout  wire        pad_cam_data2,
   inout  wire        pad_cam_data3,
   inout  wire        pad_cam_data4,
   inout  wire        pad_cam_data5,
   inout  wire        pad_cam_data6,
   inout  wire        pad_cam_data7,
   inout  wire        pad_cam_vsync,

   inout  wire        pad_sdio_clk,
   inout  wire        pad_sdio_cmd,
   inout  wire        pad_sdio_data0,
   inout  wire        pad_sdio_data1,
   inout  wire        pad_sdio_data2,
   inout  wire        pad_sdio_data3,

   inout  wire        pad_i2c0_sda,
   inout  wire        pad_i2c0_scl,

   inout  wire        pad_i2s0_sck,
   inout  wire        pad_i2s0_ws,
   inout  wire        pad_i2s0_sdi,
   inout  wire        pad_i2s1_sdi,

   
   inout  wire [31:0] pad_gpios,
   inout  wire        pad_i2c1_sda,
   inout  wire        pad_i2c1_scl,     

   inout wire [7:0]   pad_hyper_dq0    ,
   inout wire [7:0]   pad_hyper_dq1    ,
   inout wire         pad_hyper_ck     ,
   inout wire         pad_hyper_ckn    ,
   inout wire         pad_hyper_csn0   ,
   inout wire         pad_hyper_csn1   ,
   inout wire         pad_hyper_rwds0  ,
   inout wire         pad_hyper_rwds1  ,
   inout wire         pad_hyper_reset  ,

   inout  wire        pad_reset_n,
   inout  wire        pad_bootsel0,
   inout  wire        pad_bootsel1,

   inout  wire        pad_jtag_tck,
   inout  wire        pad_jtag_tdi,
   inout  wire        pad_jtag_tdo,
   inout  wire        pad_jtag_tms,
   inout  wire        pad_jtag_trst,

   inout  wire        pad_xtal_in
  );

  localparam AXI_ADDR_WIDTH             = 32;
  localparam AXI_CLUSTER_SOC_DATA_WIDTH = 64;
  localparam AXI_SOC_CLUSTER_DATA_WIDTH = 32;
  localparam AXI_SOC_CLUSTER_ID_WIDTH   = pkg_soc_interconnect::AXI_ID_OUT_WIDTH; // Backrouting through the AXI-XBAR in pulp_soc requries some extra ID bits. Check axi_xbar docu for details
  localparam AXI_CLUSTER_SOC_ID_WIDTH   = AXI_SOC_CLUSTER_ID_WIDTH + $clog2(`NB_SLAVE);

  localparam AXI_USER_WIDTH             = 6;
  localparam AXI_CLUSTER_SOC_STRB_WIDTH = AXI_CLUSTER_SOC_DATA_WIDTH/8;
  localparam AXI_SOC_CLUSTER_STRB_WIDTH = AXI_SOC_CLUSTER_DATA_WIDTH/8;

  localparam AXI_CLUSTER_SOC_AW_WIDTH   = AXI_CLUSTER_SOC_ID_WIDTH+AXI_ADDR_WIDTH+AXI_USER_WIDTH+$bits(axi_pkg::len_t)+$bits(axi_pkg::size_t)+$bits(axi_pkg::burst_t)+$bits(axi_pkg::cache_t)+$bits(axi_pkg::prot_t)+$bits(axi_pkg::qos_t)+$bits(axi_pkg::region_t)+$bits(axi_pkg::atop_t)+1;  
  localparam AXI_CLUSTER_SOC_W_WIDTH    = AXI_USER_WIDTH+AXI_CLUSTER_SOC_STRB_WIDTH+AXI_CLUSTER_SOC_DATA_WIDTH+1;   
  localparam AXI_CLUSTER_SOC_R_WIDTH    = AXI_CLUSTER_SOC_ID_WIDTH+AXI_CLUSTER_SOC_DATA_WIDTH+AXI_USER_WIDTH+$bits(axi_pkg::resp_t)+1;
  localparam AXI_CLUSTER_SOC_B_WIDTH    = AXI_USER_WIDTH+AXI_CLUSTER_SOC_ID_WIDTH+$bits(axi_pkg::resp_t);   
  localparam AXI_CLUSTER_SOC_AR_WIDTH   = AXI_CLUSTER_SOC_ID_WIDTH+AXI_ADDR_WIDTH+AXI_USER_WIDTH+$bits(axi_pkg::len_t)+$bits(axi_pkg::size_t)+$bits(axi_pkg::burst_t)+$bits(axi_pkg::cache_t)+$bits(axi_pkg::prot_t)+$bits(axi_pkg::qos_t)+$bits(axi_pkg::region_t)+1;

  localparam AXI_SOC_CLUSTER_AW_WIDTH   = AXI_SOC_CLUSTER_ID_WIDTH+AXI_ADDR_WIDTH+AXI_USER_WIDTH+$bits(axi_pkg::len_t)+$bits(axi_pkg::size_t)+$bits(axi_pkg::burst_t)+$bits(axi_pkg::cache_t)+$bits(axi_pkg::prot_t)+$bits(axi_pkg::qos_t)+$bits(axi_pkg::region_t)+$bits(axi_pkg::atop_t)+1;  
  localparam AXI_SOC_CLUSTER_W_WIDTH    = AXI_USER_WIDTH+AXI_SOC_CLUSTER_STRB_WIDTH+AXI_SOC_CLUSTER_DATA_WIDTH+1;   
  localparam AXI_SOC_CLUSTER_R_WIDTH    = AXI_SOC_CLUSTER_ID_WIDTH+AXI_SOC_CLUSTER_DATA_WIDTH+AXI_USER_WIDTH+$bits(axi_pkg::resp_t)+1;
  localparam AXI_SOC_CLUSTER_B_WIDTH    = AXI_USER_WIDTH+AXI_SOC_CLUSTER_ID_WIDTH+$bits(axi_pkg::resp_t);   
  localparam AXI_SOC_CLUSTER_AR_WIDTH   = AXI_SOC_CLUSTER_ID_WIDTH+AXI_ADDR_WIDTH+AXI_USER_WIDTH+$bits(axi_pkg::len_t)+$bits(axi_pkg::size_t)+$bits(axi_pkg::burst_t)+$bits(axi_pkg::cache_t)+$bits(axi_pkg::prot_t)+$bits(axi_pkg::qos_t)+$bits(axi_pkg::region_t)+1;

  localparam BUFFER_WIDTH               = 8;
  localparam EVENT_WIDTH                = 8;
  localparam LOG_DEPTH                  = 3;
   
  localparam CVP_ADDR_WIDTH             = 32;
  localparam CVP_DATA_WIDTH             = 32;

  //***********************************************************
  //********** PAD FRAME TO PAD CONTROL SIGNALS ***************
  //***********************************************************

  logic [72:0][5:0] s_pad_cfg ;

  logic s_out_spim_sdio0 ;
  logic s_out_spim_sdio1 ;
  logic s_out_spim_sdio2 ;
  logic s_out_spim_sdio3 ;
  logic s_out_spim_csn0  ;
  logic s_out_spim_csn1  ;
  logic s_out_spim_sck   ;
  logic s_out_uart_rx    ;
  logic s_out_uart_tx    ;
  logic s_out_cam_pclk   ;
  logic s_out_cam_hsync  ;
  logic s_out_cam_data0  ;
  logic s_out_cam_data1  ;
  logic s_out_cam_data2  ;
  logic s_out_cam_data3  ;
  logic s_out_cam_data4  ;
  logic s_out_cam_data5  ;
  logic s_out_cam_data6  ;
  logic s_out_cam_data7  ;
  logic s_out_cam_vsync  ;
  logic s_out_sdio_clk   ;
  logic s_out_sdio_cmd   ;
  logic s_out_sdio_data0 ;
  logic s_out_sdio_data1 ;
  logic s_out_sdio_data2 ;
  logic s_out_sdio_data3 ;
  logic s_out_i2c0_sda   ;
  logic s_out_i2c0_scl   ;
  logic s_out_i2s0_sck   ;
  logic s_out_i2s0_ws    ;
  logic s_out_i2s0_sdi   ;
  logic s_out_i2s1_sdi   ;
  
  logic[31:0] s_out_gpios;
  logic s_out_i2c1_sda   ;
  logic s_out_i2c1_scl   ;

  logic      s_out_hyper_csn0  ;
  logic      s_out_hyper_csn1  ;
  logic      s_out_hyper_ck    ;
  logic      s_out_hyper_ckn   ;
  logic      s_out_hyper_rwds0 ;
  logic      s_out_hyper_rwds1 ;
  logic[7:0] s_out_hyper_dq0   ;
  logic[7:0] s_out_hyper_dq1   ;
  logic      s_out_hyper_reset ;


  logic s_in_spim_sdio0  ;
  logic s_in_spim_sdio1  ;
  logic s_in_spim_sdio2  ;
  logic s_in_spim_sdio3  ;
  logic s_in_spim_csn0   ;
  logic s_in_spim_csn1   ;
  logic s_in_spim_sck    ;
  logic s_in_uart_rx     ;
  logic s_in_uart_tx     ;
  logic s_in_cam_pclk    ;
  logic s_in_cam_hsync   ;
  logic s_in_cam_data0   ;
  logic s_in_cam_data1   ;
  logic s_in_cam_data2   ;
  logic s_in_cam_data3   ;
  logic s_in_cam_data4   ;
  logic s_in_cam_data5   ;
  logic s_in_cam_data6   ;
  logic s_in_cam_data7   ;
  logic s_in_cam_vsync   ;
  logic s_in_sdio_clk    ;
  logic s_in_sdio_cmd    ;
  logic s_in_sdio_data0  ;
  logic s_in_sdio_data1  ;
  logic s_in_sdio_data2  ;
  logic s_in_sdio_data3  ;
  logic s_in_i2c0_sda    ;
  logic s_in_i2c0_scl    ;
  logic s_in_i2s0_sck    ;
  logic s_in_i2s0_ws     ;
  logic s_in_i2s0_sdi    ;
  logic s_in_i2s1_sdi    ;
  
  logic[31:0] s_in_gpios ;
  logic s_in_i2c1_sda    ;
  logic s_in_i2c1_scl    ;


  logic      s_in_hyper_csn0  ;
  logic      s_in_hyper_csn1  ;
  logic      s_in_hyper_ck    ;
  logic      s_in_hyper_ckn   ;
  logic      s_in_hyper_rwds0 ;
  logic      s_in_hyper_rwds1 ;
  logic[7:0] s_in_hyper_dq0   ;
  logic[7:0] s_in_hyper_dq1   ;
  logic      s_in_hyper_reset ;

  logic s_oe_spim_sdio0  ;
  logic s_oe_spim_sdio1  ;
  logic s_oe_spim_sdio2  ;
  logic s_oe_spim_sdio3  ;
  logic s_oe_spim_csn0   ;
  logic s_oe_spim_csn1   ;
  logic s_oe_spim_sck    ;
  logic s_oe_uart_rx     ;
  logic s_oe_uart_tx     ;
  logic s_oe_cam_pclk    ;
  logic s_oe_cam_hsync   ;
  logic s_oe_cam_data0   ;
  logic s_oe_cam_data1   ;
  logic s_oe_cam_data2   ;
  logic s_oe_cam_data3   ;
  logic s_oe_cam_data4   ;
  logic s_oe_cam_data5   ;
  logic s_oe_cam_data6   ;
  logic s_oe_cam_data7   ;
  logic s_oe_cam_vsync   ;
  logic s_oe_sdio_clk    ;
  logic s_oe_sdio_cmd    ;
  logic s_oe_sdio_data0  ;
  logic s_oe_sdio_data1  ;
  logic s_oe_sdio_data2  ;
  logic s_oe_sdio_data3  ;
  logic s_oe_i2c0_sda    ;
  logic s_oe_i2c0_scl    ;
  logic s_oe_i2s0_sck    ;
  logic s_oe_i2s0_ws     ;
  logic s_oe_i2s0_sdi    ;
  logic s_oe_i2s1_sdi    ;
  
  logic[31:0] s_oe_gpios ;
  logic s_oe_i2c1_sda    ;
  logic s_oe_i2c1_scl    ;

  logic s_oe_hyper_csn0  ;
  logic s_oe_hyper_csn1  ;
  logic s_oe_hyper_ck    ;
  logic s_oe_hyper_ckn   ;
  logic s_oe_hyper_rwds0 ;
  logic s_oe_hyper_rwds1 ;
  logic s_oe_hyper_dq0   ;
  logic s_oe_hyper_dq1   ;
  logic s_oe_hyper_reset ;

  //***********************************************************
  //********** OTHER PAD FRAME SIGNALS ************************
  //***********************************************************

  logic s_ref_clk        ;
  logic s_rstn           ;

  logic s_jtag_tck       ;
  logic s_jtag_tdi       ;
  logic s_jtag_tdo       ;
  logic s_jtag_tms       ;
  logic s_jtag_trst      ;

  //***********************************************************
  //********** SOC TO SAFE DOMAINS SIGNALS ********************
  //***********************************************************

  logic                        s_test_clk;
  logic                        s_slow_clk;
  logic                        s_sel_fll_clk;

  logic [11:0]                 s_pm_cfg_data;
  logic                        s_pm_cfg_req;
  logic                        s_pm_cfg_ack;


  logic                        s_soc_tck;
  logic                        s_soc_trstn;
  logic                        s_soc_tms;
  logic                        s_soc_tdi;

  logic                        s_test_mode;
  logic                        s_dft_cg_enable;
  logic                        s_mode_select;

  logic [31:0]                 s_gpio_out;
  logic [31:0]                 s_gpio_in;
  logic [31:0]                 s_gpio_dir;
  logic [191:0]                s_gpio_cfg;

  logic                        s_rf_tx_clk;
  logic                        s_rf_tx_oeb;
  logic                        s_rf_tx_enb;
  logic                        s_rf_tx_mode;
  logic                        s_rf_tx_vsel;
  logic                        s_rf_tx_data;
  logic                        s_rf_rx_clk;
  logic                        s_rf_rx_enb;
  logic                        s_rf_rx_data;

  logic                        s_uart_tx;
  logic                        s_uart_rx;

  logic                        s_i2c0_scl_out;
  logic                        s_i2c0_scl_in;
  logic                        s_i2c0_scl_oe;
  logic                        s_i2c0_sda_out;
  logic                        s_i2c0_sda_in;
  logic                        s_i2c0_sda_oe;
  logic                        s_i2c1_scl_out;
  logic                        s_i2c1_scl_in;
  logic                        s_i2c1_scl_oe;
  logic                        s_i2c1_sda_out;
  logic                        s_i2c1_sda_in;
  logic                        s_i2c1_sda_oe;
  logic                        s_i2s_sd0_in;
  logic                        s_i2s_sd1_in;
  logic                        s_i2s_sck_in;
  logic                        s_i2s_ws_in;
  logic                        s_i2s_sck0_out;
  logic                        s_i2s_ws0_out;
  logic [1:0]                  s_i2s_mode0_out;
  logic                        s_i2s_sck1_out;
  logic                        s_i2s_ws1_out;
  logic [1:0]                  s_i2s_mode1_out;
  logic                        s_i2s_slave_sck_oe;
  logic                        s_i2s_slave_ws_oe;
  logic                        s_spi_master0_csn0;
  logic                        s_spi_master0_csn1;
  logic                        s_spi_master0_sck;
  logic                        s_spi_master0_sdi0;
  logic                        s_spi_master0_sdi1;
  logic                        s_spi_master0_sdi2;
  logic                        s_spi_master0_sdi3;
  logic                        s_spi_master0_sdo0;
  logic                        s_spi_master0_sdo1;
  logic                        s_spi_master0_sdo2;
  logic                        s_spi_master0_sdo3;
  logic                        s_spi_master0_oen0;
  logic                        s_spi_master0_oen1;
  logic                        s_spi_master0_oen2;
  logic                        s_spi_master0_oen3;

  logic                        s_spi_master1_csn0;
  logic                        s_spi_master1_csn1;
  logic                        s_spi_master1_sck;
  logic                        s_spi_master1_sdi;
  logic                        s_spi_master1_sdo;
  logic [1:0]                  s_spi_master1_mode;

  logic                        s_sdio_clk;
  logic                        s_sdio_cmdi;
  logic                        s_sdio_cmdo;
  logic                        s_sdio_cmd_oen ;
  logic [3:0]                  s_sdio_datai;
  logic [3:0]                  s_sdio_datao;
  logic [3:0]                  s_sdio_data_oen;


  logic                        s_cam_pclk;
  logic [7:0]                  s_cam_data;
  logic                        s_cam_hsync;
  logic                        s_cam_vsync;
  logic [3:0]                  s_timer0;
  logic [3:0]                  s_timer1;
  logic [3:0]                  s_timer2;
  logic [3:0]                  s_timer3;

  logic [1:0]                  s_hyper_cs_n;
  logic                        s_hyper_ck;
  logic                        s_hyper_ck_n;
  logic [1:0]                  s_hyper_rwds_o;
  logic                        s_hyper_rwds_i;
  logic [1:0]                  s_hyper_rwds_oe;
  logic [15:0]                 s_hyper_dq_i;
  logic [15:0]                 s_hyper_dq_o;
  logic [1:0]                  s_hyper_dq_oe;
  logic                        s_hyper_reset_n;

  logic                        s_jtag_shift_dr;
  logic                        s_jtag_update_dr;
  logic                        s_jtag_capture_dr;

  logic                        s_axireg_sel;
  logic                        s_axireg_tdi;
  logic                        s_axireg_tdo;

  logic [7:0]                  s_soc_jtag_regi;
  logic [7:0]                  s_soc_jtag_rego;

  logic  [`NB_CORES-1:0]             s_dbg_irq_valid;

  logic                        s_rstn_por;
  

  logic                        s_dma_pe_irq_ack;
  logic                        s_dma_pe_irq_valid;

  logic [127:0]                s_pad_mux_soc;
  logic [383:0]                s_pad_cfg_soc;

  // due to the pad frame these numbers are fixed. Adjust the padframe
  // accordingly if you change these.
  localparam int unsigned N_UART = 1;
  localparam int unsigned N_SPI = 1;
  localparam int unsigned N_I2C = 2;

  logic [N_SPI-1:0]            s_spi_clk;
  logic [N_SPI-1:0][3:0]       s_spi_csn;
  logic [N_SPI-1:0][3:0]       s_spi_oen;
  logic [N_SPI-1:0][3:0]       s_spi_sdo;
  logic [N_SPI-1:0][3:0]       s_spi_sdi;

  logic [N_I2C-1:0]            s_i2c_scl_in;
  logic [N_I2C-1:0]            s_i2c_scl_out;
  logic [N_I2C-1:0]            s_i2c_scl_oe;
  logic [N_I2C-1:0]            s_i2c_sda_in;
  logic [N_I2C-1:0]            s_i2c_sda_out;
  logic [N_I2C-1:0]            s_i2c_sda_oe;

  //***********************************************************
  //********** SOC TO CLUSTER DOMAINS SIGNALS *****************
  //***********************************************************


  logic                        s_cluster_clk;
  logic                        s_cluster_rstn;
  logic                        s_cluster_busy;
  logic                        s_cluster_irq;
  logic                        s_cluster_rtc;
  logic                        s_cluster_fetch_enable;
  logic [63:0]                 s_cluster_boot_addr; 
  logic                        s_cluster_test_en;
  logic                        s_cluster_pow;
  logic                        s_cluster_byp;

  logic                        s_dma_pe_evt_ack;
  logic                        s_dma_pe_evt_valid;
  logic                        s_dma_pe_int_ack;
  logic                        s_dma_pe_int_valid;
  logic                        s_pf_evt_ack;
  logic                        s_pf_evt_valid;

  logic [LOG_DEPTH:0]                                  s_event_wptr;
  logic [LOG_DEPTH:0]                                  s_event_rptr;
  logic [2**LOG_DEPTH-1:0][EVENT_WIDTH-1:0]            s_event_dataasync;

  // SOC TO CLUSTER AXI BUS
  logic [LOG_DEPTH:0]                                    s_cluster_soc_bus_aw_wptr;
  logic [LOG_DEPTH:0]                                    s_cluster_soc_bus_aw_rptr;
  logic [2**LOG_DEPTH-1:0][AXI_CLUSTER_SOC_AW_WIDTH-1:0] s_cluster_soc_bus_aw_data;
          
  logic [LOG_DEPTH:0]                                    s_cluster_soc_bus_ar_wptr;
  logic [LOG_DEPTH:0]                                    s_cluster_soc_bus_ar_rptr;
  logic [2**LOG_DEPTH-1:0][AXI_CLUSTER_SOC_AR_WIDTH-1:0] s_cluster_soc_bus_ar_data;

  logic [LOG_DEPTH:0]                                    s_cluster_soc_bus_w_wptr;
  logic [LOG_DEPTH:0]                                    s_cluster_soc_bus_w_rptr;
  logic [2**LOG_DEPTH-1:0][AXI_CLUSTER_SOC_W_WIDTH-1:0]  s_cluster_soc_bus_w_data;

  logic [LOG_DEPTH:0]                                    s_cluster_soc_bus_r_wptr;
  logic [LOG_DEPTH:0]                                    s_cluster_soc_bus_r_rptr;
  logic [2**LOG_DEPTH-1:0][AXI_CLUSTER_SOC_R_WIDTH-1:0]  s_cluster_soc_bus_r_data;
  
  logic [LOG_DEPTH:0]                                    s_cluster_soc_bus_b_wptr;
  logic [LOG_DEPTH:0]                                    s_cluster_soc_bus_b_rptr;
  logic [2**LOG_DEPTH-1:0][AXI_CLUSTER_SOC_B_WIDTH-1:0]  s_cluster_soc_bus_b_data;
  
  // SOC TO CLUSTER AXI BUS
  logic [LOG_DEPTH:0]                                    s_soc_cluster_bus_aw_wptr;
  logic [LOG_DEPTH:0]                                    s_soc_cluster_bus_aw_rptr;
  logic [2**LOG_DEPTH-1:0][AXI_SOC_CLUSTER_AW_WIDTH-1:0] s_soc_cluster_bus_aw_data;
          
  logic [LOG_DEPTH:0]                                    s_soc_cluster_bus_ar_wptr;
  logic [LOG_DEPTH:0]                                    s_soc_cluster_bus_ar_rptr;
  logic [2**LOG_DEPTH-1:0][AXI_SOC_CLUSTER_AR_WIDTH-1:0] s_soc_cluster_bus_ar_data;

  logic [LOG_DEPTH:0]                                    s_soc_cluster_bus_w_wptr;
  logic [LOG_DEPTH:0]                                    s_soc_cluster_bus_w_rptr;
  logic [2**LOG_DEPTH-1:0][AXI_SOC_CLUSTER_W_WIDTH-1:0]  s_soc_cluster_bus_w_data;

  logic [LOG_DEPTH:0]                                    s_soc_cluster_bus_r_wptr;
  logic [LOG_DEPTH:0]                                    s_soc_cluster_bus_r_rptr;
  logic [2**LOG_DEPTH-1:0][AXI_SOC_CLUSTER_R_WIDTH-1:0]  s_soc_cluster_bus_r_data;
  
  logic [LOG_DEPTH:0]                                    s_soc_cluster_bus_b_wptr;
  logic [LOG_DEPTH:0]                                    s_soc_cluster_bus_b_rptr;
  logic [2**LOG_DEPTH-1:0][AXI_SOC_CLUSTER_B_WIDTH-1:0]  s_soc_cluster_bus_b_data;
  

  logic[1:0]                        s_bootsel;

  //APB_BUS        apb_debug();  //not used
  //XBAR_TCDM_BUS  lint_debug(); //not used

  //***********************************************************
  //********** PAD FRAME **************************************
  //***********************************************************

  pad_frame pad_frame_i
  (
        .pad_cfg_i             ( s_pad_cfg              ),
        .ref_clk_o             ( s_ref_clk              ),
        .rstn_o                ( s_rstn                 ),
        .jtag_tdo_i            ( s_jtag_tdo             ),
        .jtag_tck_o            ( s_jtag_tck             ),
        .jtag_tdi_o            ( s_jtag_tdi             ),
        .jtag_tms_o            ( s_jtag_tms             ),
        .jtag_trst_o           ( s_jtag_trst            ),

        .oe_spim_sdio0_i       ( s_oe_spim_sdio0        ),
        .oe_spim_sdio1_i       ( s_oe_spim_sdio1        ),
        .oe_spim_sdio2_i       ( s_oe_spim_sdio2        ),
        .oe_spim_sdio3_i       ( s_oe_spim_sdio3        ),
        .oe_spim_csn0_i        ( s_oe_spim_csn0         ),
        .oe_spim_csn1_i        ( s_oe_spim_csn1         ),
        .oe_spim_sck_i         ( s_oe_spim_sck          ),
        .oe_sdio_clk_i         ( s_oe_sdio_clk          ),
        .oe_sdio_cmd_i         ( s_oe_sdio_cmd          ),
        .oe_sdio_data0_i       ( s_oe_sdio_data0        ),
        .oe_sdio_data1_i       ( s_oe_sdio_data1        ),
        .oe_sdio_data2_i       ( s_oe_sdio_data2        ),
        .oe_sdio_data3_i       ( s_oe_sdio_data3        ),
        .oe_i2s0_sck_i         ( s_oe_i2s0_sck          ),
        .oe_i2s0_ws_i          ( s_oe_i2s0_ws           ),
        .oe_i2s0_sdi_i         ( s_oe_i2s0_sdi          ),
        .oe_i2s1_sdi_i         ( s_oe_i2s1_sdi          ),
        .oe_cam_pclk_i         ( s_oe_cam_pclk          ),
        .oe_cam_hsync_i        ( s_oe_cam_hsync         ),
        .oe_cam_data0_i        ( s_oe_cam_data0         ),
        .oe_cam_data1_i        ( s_oe_cam_data1         ),
        .oe_cam_data2_i        ( s_oe_cam_data2         ),
        .oe_cam_data3_i        ( s_oe_cam_data3         ),
        .oe_cam_data4_i        ( s_oe_cam_data4         ),
        .oe_cam_data5_i        ( s_oe_cam_data5         ),
        .oe_cam_data6_i        ( s_oe_cam_data6         ),
        .oe_cam_data7_i        ( s_oe_cam_data7         ),
        .oe_cam_vsync_i        ( s_oe_cam_vsync         ),
        .oe_i2c0_sda_i         ( s_oe_i2c0_sda          ),
        .oe_i2c0_scl_i         ( s_oe_i2c0_scl          ),
        .oe_uart_rx_i          ( s_oe_uart_rx           ),
        .oe_uart_tx_i          ( s_oe_uart_tx           ),
        
        .oe_gpios_i            ( s_oe_gpios             ),
        .oe_i2c1_sda_i         ( s_oe_i2c1_sda          ),
        .oe_i2c1_scl_i         ( s_oe_i2c1_scl          ),

        .oe_hyper_cs0n_i       ( s_oe_hyper_csn0        ),
        .oe_hyper_cs1n_i       ( s_oe_hyper_csn1        ),
        .oe_hyper_ck_i         ( s_oe_hyper_ck          ),
        .oe_hyper_ckn_i        ( s_oe_hyper_ckn         ),
        .oe_hyper_rwds0_i      ( s_oe_hyper_rwds0       ),
        .oe_hyper_rwds1_i      ( s_oe_hyper_rwds1       ),
        .oe_hyper_dq0_i        ( s_oe_hyper_dq0         ),
        .oe_hyper_dq1_i        ( s_oe_hyper_dq1         ),
        .oe_hyper_resetn_i     ( s_oe_hyper_reset       ),
 
        .out_spim_sdio0_i      ( s_out_spim_sdio0       ),
        .out_spim_sdio1_i      ( s_out_spim_sdio1       ),
        .out_spim_sdio2_i      ( s_out_spim_sdio2       ),
        .out_spim_sdio3_i      ( s_out_spim_sdio3       ),
        .out_spim_csn0_i       ( s_out_spim_csn0        ),
        .out_spim_csn1_i       ( s_out_spim_csn1        ),
        .out_spim_sck_i        ( s_out_spim_sck         ),
        .out_sdio_clk_i        ( s_out_sdio_clk         ),
        .out_sdio_cmd_i        ( s_out_sdio_cmd         ),
        .out_sdio_data0_i      ( s_out_sdio_data0       ),
        .out_sdio_data1_i      ( s_out_sdio_data1       ),
        .out_sdio_data2_i      ( s_out_sdio_data2       ),
        .out_sdio_data3_i      ( s_out_sdio_data3       ),
        .out_i2s0_sck_i        ( s_out_i2s0_sck         ),
        .out_i2s0_ws_i         ( s_out_i2s0_ws          ),
        .out_i2s0_sdi_i        ( s_out_i2s0_sdi         ),
        .out_i2s1_sdi_i        ( s_out_i2s1_sdi         ),
        .out_cam_pclk_i        ( s_out_cam_pclk         ),
        .out_cam_hsync_i       ( s_out_cam_hsync        ),
        .out_cam_data0_i       ( s_out_cam_data0        ),
        .out_cam_data1_i       ( s_out_cam_data1        ),
        .out_cam_data2_i       ( s_out_cam_data2        ),
        .out_cam_data3_i       ( s_out_cam_data3        ),
        .out_cam_data4_i       ( s_out_cam_data4        ),
        .out_cam_data5_i       ( s_out_cam_data5        ),
        .out_cam_data6_i       ( s_out_cam_data6        ),
        .out_cam_data7_i       ( s_out_cam_data7        ),
        .out_cam_vsync_i       ( s_out_cam_vsync        ),
        .out_i2c0_sda_i        ( s_out_i2c0_sda         ),
        .out_i2c0_scl_i        ( s_out_i2c0_scl         ),
        .out_uart_rx_i         ( s_out_uart_rx          ),
        .out_uart_tx_i         ( s_out_uart_tx          ),
        
        .out_gpios_i           ( s_out_gpios            ),
        .out_i2c1_sda_i        ( s_out_i2c1_sda         ),
        .out_i2c1_scl_i        ( s_out_i2c1_scl         ),

        .out_hyper_cs0n_i      ( s_out_hyper_csn0       ),
        .out_hyper_cs1n_i      ( s_out_hyper_csn1       ),
        .out_hyper_ck_i        ( s_out_hyper_ck         ),
        .out_hyper_ckn_i       ( s_out_hyper_ckn        ),
        .out_hyper_rwds0_i     ( s_out_hyper_rwds0      ),
        .out_hyper_rwds1_i     ( s_out_hyper_rwds1      ),
        .out_hyper_dq0_i       ( s_out_hyper_dq0        ),
        .out_hyper_dq1_i       ( s_out_hyper_dq1        ),
        .out_hyper_resetn_i    ( s_out_hyper_reset      ),


        .in_spim_sdio0_o       ( s_in_spim_sdio0        ),
        .in_spim_sdio1_o       ( s_in_spim_sdio1        ),
        .in_spim_sdio2_o       ( s_in_spim_sdio2        ),
        .in_spim_sdio3_o       ( s_in_spim_sdio3        ),
        .in_spim_csn0_o        ( s_in_spim_csn0         ),
        .in_spim_csn1_o        ( s_in_spim_csn1         ),
        .in_spim_sck_o         ( s_in_spim_sck          ),
        .in_sdio_clk_o         ( s_in_sdio_clk          ),
        .in_sdio_cmd_o         ( s_in_sdio_cmd          ),
        .in_sdio_data0_o       ( s_in_sdio_data0        ),
        .in_sdio_data1_o       ( s_in_sdio_data1        ),
        .in_sdio_data2_o       ( s_in_sdio_data2        ),
        .in_sdio_data3_o       ( s_in_sdio_data3        ),
        .in_i2s0_sck_o         ( s_in_i2s0_sck          ),
        .in_i2s0_ws_o          ( s_in_i2s0_ws           ),
        .in_i2s0_sdi_o         ( s_in_i2s0_sdi          ),
        .in_i2s1_sdi_o         ( s_in_i2s1_sdi          ),
        .in_cam_pclk_o         ( s_in_cam_pclk          ),
        .in_cam_hsync_o        ( s_in_cam_hsync         ),
        .in_cam_data0_o        ( s_in_cam_data0         ),
        .in_cam_data1_o        ( s_in_cam_data1         ),
        .in_cam_data2_o        ( s_in_cam_data2         ),
        .in_cam_data3_o        ( s_in_cam_data3         ),
        .in_cam_data4_o        ( s_in_cam_data4         ),
        .in_cam_data5_o        ( s_in_cam_data5         ),
        .in_cam_data6_o        ( s_in_cam_data6         ),
        .in_cam_data7_o        ( s_in_cam_data7         ),
        .in_cam_vsync_o        ( s_in_cam_vsync         ),
        .in_i2c0_sda_o         ( s_in_i2c0_sda          ),
        .in_i2c0_scl_o         ( s_in_i2c0_scl          ),
        .in_uart_rx_o          ( s_in_uart_rx           ),
        .in_uart_tx_o          ( s_in_uart_tx           ),
        
        .in_gpios_o            ( s_in_gpios             ),
        .in_i2c1_sda_o         ( s_in_i2c1_sda          ),
        .in_i2c1_scl_o         ( s_in_i2c1_scl          ),

        .in_hyper_cs0n_o       ( s_in_hyper_csn0        ),
        .in_hyper_cs1n_o       ( s_in_hyper_csn1        ),
        .in_hyper_ck_o         ( s_in_hyper_ck          ),
        .in_hyper_ckn_o        ( s_in_hyper_ckn         ),
        .in_hyper_rwds0_o      ( s_in_hyper_rwds0       ),
        .in_hyper_rwds1_o      ( s_in_hyper_rwds1       ),
        .in_hyper_dq0_o        ( s_in_hyper_dq0         ),
        .in_hyper_dq1_o        ( s_in_hyper_dq1         ),
        .in_hyper_resetn_o     ( s_in_hyper_reset       ),

 

        .bootsel_o             ( s_bootsel              ),

        //EXT CHIP to PAD
        .pad_spim_sdio0        ( pad_spim_sdio0         ),
        .pad_spim_sdio1        ( pad_spim_sdio1         ),
        .pad_spim_sdio2        ( pad_spim_sdio2         ),
        .pad_spim_sdio3        ( pad_spim_sdio3         ),
        .pad_spim_csn0         ( pad_spim_csn0          ),
        .pad_spim_csn1         ( pad_spim_csn1          ),
        .pad_spim_sck          ( pad_spim_sck           ),
        .pad_sdio_clk          ( pad_sdio_clk           ),
        .pad_sdio_cmd          ( pad_sdio_cmd           ),
        .pad_sdio_data0        ( pad_sdio_data0         ),
        .pad_sdio_data1        ( pad_sdio_data1         ),
        .pad_sdio_data2        ( pad_sdio_data2         ),
        .pad_sdio_data3        ( pad_sdio_data3         ),
        .pad_i2s0_sck          ( pad_i2s0_sck           ),
        .pad_i2s0_ws           ( pad_i2s0_ws            ),
        .pad_i2s0_sdi          ( pad_i2s0_sdi           ),
        .pad_i2s1_sdi          ( pad_i2s1_sdi           ),
        .pad_cam_pclk          ( pad_cam_pclk           ),
        .pad_cam_hsync         ( pad_cam_hsync          ),
        .pad_cam_data0         ( pad_cam_data0          ),
        .pad_cam_data1         ( pad_cam_data1          ),
        .pad_cam_data2         ( pad_cam_data2          ),
        .pad_cam_data3         ( pad_cam_data3          ),
        .pad_cam_data4         ( pad_cam_data4          ),
        .pad_cam_data5         ( pad_cam_data5          ),
        .pad_cam_data6         ( pad_cam_data6          ),
        .pad_cam_data7         ( pad_cam_data7          ),
        .pad_cam_vsync         ( pad_cam_vsync          ),
        .pad_i2c0_sda          ( pad_i2c0_sda           ),
        .pad_i2c0_scl          ( pad_i2c0_scl           ),
        .pad_uart_rx           ( pad_uart_rx            ),
        .pad_uart_tx           ( pad_uart_tx            ),
        
        .pad_gpios             ( pad_gpios              ),
        .pad_i2c1_sda          ( pad_i2c1_sda           ),
        .pad_i2c1_scl          ( pad_i2c1_scl           ),

        .pad_hyper_dq0         ( pad_hyper_dq0          ),
        .pad_hyper_dq1         ( pad_hyper_dq1          ),
        .pad_hyper_ck          ( pad_hyper_ck           ),
        .pad_hyper_ckn         ( pad_hyper_ckn          ),
        .pad_hyper_csn0        ( pad_hyper_csn0         ),
        .pad_hyper_csn1        ( pad_hyper_csn1         ),
        .pad_hyper_rwds0       ( pad_hyper_rwds0        ),
        .pad_hyper_rwds1       ( pad_hyper_rwds1        ),
        .pad_hyper_reset       ( pad_hyper_reset        ),

        .pad_bootsel0          ( pad_bootsel0           ),
        .pad_bootsel1          ( pad_bootsel1           ),
        .pad_reset_n           ( pad_reset_n            ),
        .pad_jtag_tck          ( pad_jtag_tck           ),
        .pad_jtag_tdi          ( pad_jtag_tdi           ),
        .pad_jtag_tdo          ( pad_jtag_tdo           ),
        .pad_jtag_tms          ( pad_jtag_tms           ),
        .pad_jtag_trst         ( pad_jtag_trst          ),
        .pad_xtal_in           ( pad_xtal_in            )

   );

  //***********************************************************
  //********** SAFE DOMAIN ************************************
  //***********************************************************
   safe_domain safe_domain_i (

        .ref_clk_i                  ( s_ref_clk                   ),
        .slow_clk_o                 ( s_slow_clk                  ),
        .rst_ni                     ( s_rstn                     ),

        .rst_no                     ( s_rstn_por                  ),

        .test_clk_o                 ( s_test_clk                  ),
        .test_mode_o                ( s_test_mode                 ),
        .mode_select_o              ( s_mode_select               ),
        .dft_cg_enable_o            ( s_dft_cg_enable             ),

        .pad_cfg_o                  ( s_pad_cfg                   ),

        .pad_cfg_i                  ( s_pad_cfg_soc               ),
        .pad_mux_i                  ( s_pad_mux_soc               ),

        .gpio_out_i                 ( s_gpio_out                  ),
        .gpio_in_o                  ( s_gpio_in                   ),
        .gpio_dir_i                 ( s_gpio_dir                  ),
        .gpio_cfg_i                 ( s_gpio_cfg                  ),

        .uart_tx_i                  ( s_uart_tx                   ),
        .uart_rx_o                  ( s_uart_rx                   ),

        .i2c_scl_out_i              ( s_i2c_scl_out               ),
        .i2c_scl_in_o               ( s_i2c_scl_in                ),
        .i2c_scl_oe_i               ( s_i2c_scl_oe                ),
        .i2c_sda_out_i              ( s_i2c_sda_out               ),
        .i2c_sda_in_o               ( s_i2c_sda_in                ),
        .i2c_sda_oe_i               ( s_i2c_sda_oe                ),

        .i2s_slave_sd0_o            ( s_i2s_sd0_in                ),
        .i2s_slave_sd1_o            ( s_i2s_sd1_in                ),
        .i2s_slave_ws_o             ( s_i2s_ws_in                 ),
        .i2s_slave_ws_i             ( s_i2s_ws0_out               ),
        .i2s_slave_ws_oe            ( s_i2s_slave_ws_oe           ),
        .i2s_slave_sck_o            ( s_i2s_sck_in                ),
        .i2s_slave_sck_i            ( s_i2s_sck0_out              ),
        .i2s_slave_sck_oe           ( s_i2s_slave_sck_oe          ),

        .spi_clk_i                  ( s_spi_clk                   ),
        .spi_csn_i                  ( s_spi_csn                   ),
        .spi_oen_i                  ( s_spi_oen                   ),
        .spi_sdo_i                  ( s_spi_sdo                   ),
        .spi_sdi_o                  ( s_spi_sdi                   ),

        .sdio_clk_i                 ( s_sdio_clk                  ),
        .sdio_cmd_i                 ( s_sdio_cmdo                 ),
        .sdio_cmd_o                 ( s_sdio_cmdi                 ),
        .sdio_cmd_oen_i             ( s_sdio_cmd_oen              ),
        .sdio_data_i                ( s_sdio_datao                ),
        .sdio_data_o                ( s_sdio_datai                ),
        .sdio_data_oen_i            ( s_sdio_data_oen             ),

        .cam_pclk_o                 ( s_cam_pclk                  ),
        .cam_data_o                 ( s_cam_data                  ),
        .cam_hsync_o                ( s_cam_hsync                 ),
        .cam_vsync_o                ( s_cam_vsync                 ),

        .timer0_i                   ( s_timer0                    ),
        .timer1_i                   ( s_timer1                    ),
        .timer2_i                   ( s_timer2                    ),
        .timer3_i                   ( s_timer3                    ),


        .hyper_cs_ni                  ( s_hyper_cs_n                     ),
        .hyper_ck_i                   ( s_hyper_ck                       ),
        .hyper_ck_ni                  ( s_hyper_ck_n                     ),
        .hyper_rwds_i                 ( s_hyper_rwds_o                   ),
        .hyper_rwds_o                 ( s_hyper_rwds_i                   ),
        .hyper_rwds_oe_i              ( s_hyper_rwds_oe                  ),
        .hyper_dq_o                   ( s_hyper_dq_i                     ),
        .hyper_dq_i                   ( s_hyper_dq_o                     ),
        .hyper_dq_oe_o                ( s_hyper_dq_oe                    ),
        .hyper_reset_no               ( s_hyper_reset_n                  ),


        .out_spim_sdio0_o           ( s_out_spim_sdio0            ),
        .out_spim_sdio1_o           ( s_out_spim_sdio1            ),
        .out_spim_sdio2_o           ( s_out_spim_sdio2            ),
        .out_spim_sdio3_o           ( s_out_spim_sdio3            ),
        .out_spim_csn0_o            ( s_out_spim_csn0             ),
        .out_spim_csn1_o            ( s_out_spim_csn1             ),
        .out_spim_sck_o             ( s_out_spim_sck              ),

        .out_sdio_clk_o             ( s_out_sdio_clk              ),
        .out_sdio_cmd_o             ( s_out_sdio_cmd              ),
        .out_sdio_data0_o           ( s_out_sdio_data0            ),
        .out_sdio_data1_o           ( s_out_sdio_data1            ),
        .out_sdio_data2_o           ( s_out_sdio_data2            ),
        .out_sdio_data3_o           ( s_out_sdio_data3            ),

        .out_uart_rx_o              ( s_out_uart_rx               ),
        .out_uart_tx_o              ( s_out_uart_tx               ),

        .out_cam_pclk_o             ( s_out_cam_pclk              ),
        .out_cam_hsync_o            ( s_out_cam_hsync             ),
        .out_cam_data0_o            ( s_out_cam_data0             ),
        .out_cam_data1_o            ( s_out_cam_data1             ),
        .out_cam_data2_o            ( s_out_cam_data2             ),
        .out_cam_data3_o            ( s_out_cam_data3             ),
        .out_cam_data4_o            ( s_out_cam_data4             ),
        .out_cam_data5_o            ( s_out_cam_data5             ),
        .out_cam_data6_o            ( s_out_cam_data6             ),
        .out_cam_data7_o            ( s_out_cam_data7             ),
        .out_cam_vsync_o            ( s_out_cam_vsync             ),

        .out_i2c0_sda_o             ( s_out_i2c0_sda              ),
        .out_i2c0_scl_o             ( s_out_i2c0_scl              ),
        .out_i2s0_sck_o             ( s_out_i2s0_sck              ),
        .out_i2s0_ws_o              ( s_out_i2s0_ws               ),
        .out_i2s0_sdi_o             ( s_out_i2s0_sdi              ),
        .out_i2s1_sdi_o             ( s_out_i2s1_sdi              ),
        
        .out_gpios_o                ( s_out_gpios                 ),
        .out_i2c1_sda_o             ( s_out_i2c1_sda              ),
        .out_i2c1_scl_o             ( s_out_i2c1_scl              ),

        .out_hyper_cs0n_o           ( s_out_hyper_csn0            ),
        .out_hyper_cs1n_o           ( s_out_hyper_csn1            ),
        .out_hyper_ck_o             ( s_out_hyper_ck              ),
        .out_hyper_ckn_o            ( s_out_hyper_ckn             ),
        .out_hyper_rwds0_o          ( s_out_hyper_rwds0           ),
        .out_hyper_rwds1_o          ( s_out_hyper_rwds1           ),
        .out_hyper_dq0_o            ( s_out_hyper_dq0             ),
        .out_hyper_dq1_o            ( s_out_hyper_dq1             ),
        .out_hyper_resetn_o         ( s_out_hyper_reset           ),

        .in_spim_sdio0_i            ( s_in_spim_sdio0             ),
        .in_spim_sdio1_i            ( s_in_spim_sdio1             ),
        .in_spim_sdio2_i            ( s_in_spim_sdio2             ),
        .in_spim_sdio3_i            ( s_in_spim_sdio3             ),
        .in_spim_csn0_i             ( s_in_spim_csn0              ),
        .in_spim_csn1_i             ( s_in_spim_csn1              ),
        .in_spim_sck_i              ( s_in_spim_sck               ),

        .in_sdio_clk_i              ( s_in_sdio_clk               ),
        .in_sdio_cmd_i              ( s_in_sdio_cmd               ),
        .in_sdio_data0_i            ( s_in_sdio_data0             ),
        .in_sdio_data1_i            ( s_in_sdio_data1             ),
        .in_sdio_data2_i            ( s_in_sdio_data2             ),
        .in_sdio_data3_i            ( s_in_sdio_data3             ),

        .in_uart_rx_i               ( s_in_uart_rx                ),
        .in_uart_tx_i               ( s_in_uart_tx                ),
        .in_cam_pclk_i              ( s_in_cam_pclk               ),
        .in_cam_hsync_i             ( s_in_cam_hsync              ),
        .in_cam_data0_i             ( s_in_cam_data0              ),
        .in_cam_data1_i             ( s_in_cam_data1              ),
        .in_cam_data2_i             ( s_in_cam_data2              ),
        .in_cam_data3_i             ( s_in_cam_data3              ),
        .in_cam_data4_i             ( s_in_cam_data4              ),
        .in_cam_data5_i             ( s_in_cam_data5              ),
        .in_cam_data6_i             ( s_in_cam_data6              ),
        .in_cam_data7_i             ( s_in_cam_data7              ),
        .in_cam_vsync_i             ( s_in_cam_vsync              ),

        .in_i2c0_sda_i              ( s_in_i2c0_sda               ),
        .in_i2c0_scl_i              ( s_in_i2c0_scl               ),
        .in_i2s0_sck_i              ( s_in_i2s0_sck               ),
        .in_i2s0_ws_i               ( s_in_i2s0_ws                ),
        .in_i2s0_sdi_i              ( s_in_i2s0_sdi               ),
        .in_i2s1_sdi_i              ( s_in_i2s1_sdi               ),
        
        .in_gpios_i                 ( s_in_gpios                  ),
        .in_i2c1_sda_i              ( s_in_i2c1_sda               ),
        .in_i2c1_scl_i              ( s_in_i2c1_scl               ),


        .in_hyper_cs0n_i            ( s_in_hyper_csn0            ),
        .in_hyper_cs1n_i            ( s_in_hyper_csn1            ),
        .in_hyper_ck_i              ( s_in_hyper_ck              ),
        .in_hyper_ckn_i             ( s_in_hyper_ckn             ),
        .in_hyper_rwds0_i           ( s_in_hyper_rwds0           ),
        .in_hyper_rwds1_i           ( s_in_hyper_rwds1           ),
        .in_hyper_dq0_i             ( s_in_hyper_dq0             ),
        .in_hyper_dq1_i             ( s_in_hyper_dq1             ),
        .in_hyper_resetn_i          ( s_in_hyper_reset           ),

        .oe_spim_sdio0_o            ( s_oe_spim_sdio0             ),
        .oe_spim_sdio1_o            ( s_oe_spim_sdio1             ),
        .oe_spim_sdio2_o            ( s_oe_spim_sdio2             ),
        .oe_spim_sdio3_o            ( s_oe_spim_sdio3             ),
        .oe_spim_csn0_o             ( s_oe_spim_csn0              ),
        .oe_spim_csn1_o             ( s_oe_spim_csn1              ),
        .oe_spim_sck_o              ( s_oe_spim_sck               ),

        .oe_sdio_clk_o              ( s_oe_sdio_clk               ),
        .oe_sdio_cmd_o              ( s_oe_sdio_cmd               ),
        .oe_sdio_data0_o            ( s_oe_sdio_data0             ),
        .oe_sdio_data1_o            ( s_oe_sdio_data1             ),
        .oe_sdio_data2_o            ( s_oe_sdio_data2             ),
        .oe_sdio_data3_o            ( s_oe_sdio_data3             ),

        .oe_uart_rx_o               ( s_oe_uart_rx                ),
        .oe_uart_tx_o               ( s_oe_uart_tx                ),
        .oe_cam_pclk_o              ( s_oe_cam_pclk               ),
        .oe_cam_hsync_o             ( s_oe_cam_hsync              ),
        .oe_cam_data0_o             ( s_oe_cam_data0              ),
        .oe_cam_data1_o             ( s_oe_cam_data1              ),
        .oe_cam_data2_o             ( s_oe_cam_data2              ),
        .oe_cam_data3_o             ( s_oe_cam_data3              ),
        .oe_cam_data4_o             ( s_oe_cam_data4              ),
        .oe_cam_data5_o             ( s_oe_cam_data5              ),
        .oe_cam_data6_o             ( s_oe_cam_data6              ),
        .oe_cam_data7_o             ( s_oe_cam_data7              ),
        .oe_cam_vsync_o             ( s_oe_cam_vsync              ),

        .oe_i2c0_sda_o              ( s_oe_i2c0_sda               ),
        .oe_i2c0_scl_o              ( s_oe_i2c0_scl               ),
        .oe_i2s0_sck_o              ( s_oe_i2s0_sck               ),
        .oe_i2s0_ws_o               ( s_oe_i2s0_ws                ),
        .oe_i2s0_sdi_o              ( s_oe_i2s0_sdi               ),
        .oe_i2s1_sdi_o              ( s_oe_i2s1_sdi               ),
        
        .oe_gpios_o                 ( s_oe_gpios                  ),
        .oe_i2c1_sda_o              ( s_oe_i2c1_sda               ),
        .oe_i2c1_scl_o              ( s_oe_i2c1_scl               ),
     
        .oe_hyper_cs0n_o            ( s_oe_hyper_csn0             ),
        .oe_hyper_cs1n_o            ( s_oe_hyper_csn1             ),
        .oe_hyper_ck_o              ( s_oe_hyper_ck               ),
        .oe_hyper_ckn_o             ( s_oe_hyper_ckn              ),
        .oe_hyper_rwds0_o           ( s_oe_hyper_rwds0            ),
        .oe_hyper_rwds1_o           ( s_oe_hyper_rwds1            ),
        .oe_hyper_dq0_o             ( s_oe_hyper_dq0              ),
        .oe_hyper_dq1_o             ( s_oe_hyper_dq1              ),
        .oe_hyper_resetn_o          ( s_oe_hyper_reset            ),

        .*
   );

   // SOC DOMAIN
   soc_domain #(
      .CORE_TYPE          ( CORE_TYPE_FC               ),
      .USE_FPU            ( USE_FPU                    ),
      .USE_HWPE           ( USE_HWPE                   ),
      .AXI_ADDR_WIDTH     ( AXI_ADDR_WIDTH             ),
      .AXI_DATA_IN_WIDTH  ( AXI_CLUSTER_SOC_DATA_WIDTH ),
      .AXI_DATA_OUT_WIDTH ( AXI_SOC_CLUSTER_DATA_WIDTH ),
      .AXI_ID_IN_WIDTH    ( AXI_CLUSTER_SOC_ID_WIDTH   ),
      .AXI_ID_OUT_WIDTH   ( AXI_SOC_CLUSTER_ID_WIDTH   ),
      .AXI_USER_WIDTH     ( AXI_USER_WIDTH             ),
      .AXI_STRB_IN_WIDTH  ( AXI_CLUSTER_SOC_STRB_WIDTH ),
      .AXI_STRB_OUT_WIDTH ( AXI_SOC_CLUSTER_STRB_WIDTH ),
      .BUFFER_WIDTH       ( BUFFER_WIDTH               ),
      .C2S_AW_WIDTH       ( AXI_CLUSTER_SOC_AW_WIDTH   ),
      .C2S_W_WIDTH        ( AXI_CLUSTER_SOC_W_WIDTH    ),
      .C2S_B_WIDTH        ( AXI_CLUSTER_SOC_B_WIDTH    ),
      .C2S_AR_WIDTH       ( AXI_CLUSTER_SOC_AR_WIDTH   ),
      .C2S_R_WIDTH        ( AXI_CLUSTER_SOC_R_WIDTH    ),
      .S2C_AW_WIDTH       ( AXI_SOC_CLUSTER_AW_WIDTH   ),
      .S2C_W_WIDTH        ( AXI_SOC_CLUSTER_W_WIDTH    ),
      .S2C_B_WIDTH        ( AXI_SOC_CLUSTER_B_WIDTH    ),
      .S2C_AR_WIDTH       ( AXI_SOC_CLUSTER_AR_WIDTH   ),
      .S2C_R_WIDTH        ( AXI_SOC_CLUSTER_R_WIDTH    ),
      .EVNT_WIDTH         ( EVENT_WIDTH                ),
      .NB_CL_CORES        ( `NB_CORES                  ),
      .N_UART             ( N_UART                     ),
      .N_SPI              ( N_SPI                      ),
      .N_I2C              ( N_I2C                      )
   ) soc_domain_i (

        .ref_clk_i                    ( s_ref_clk                        ),
        .slow_clk_i                   ( s_slow_clk                       ),
        .test_clk_i                   ( s_test_clk                       ),

        .rstn_glob_i                  ( s_rstn_por                       ),

        .mode_select_i                ( s_mode_select                    ),
        .dft_cg_enable_i              ( s_dft_cg_enable                  ),
        .dft_test_mode_i              ( s_test_mode                      ),

        .bootsel_i                    ( s_bootsel                        ),

        // we immediately start booting in the default setup
        .fc_fetch_en_valid_i          ( 1'b1                             ),
        .fc_fetch_en_i                ( 1'b1                             ),

        .jtag_tck_i                   ( s_jtag_tck                       ),
        .jtag_trst_ni                 ( s_jtag_trst                      ),
        .jtag_tms_i                   ( s_jtag_tms                       ),
        .jtag_tdi_i                   ( s_jtag_tdi                       ),
        .jtag_tdo_o                   ( s_jtag_tdo                       ),

        .pad_cfg_o                    ( s_pad_cfg_soc                    ),
        .pad_mux_o                    ( s_pad_mux_soc                    ),

        .gpio_in_i                    ( s_gpio_in                        ),
        .gpio_out_o                   ( s_gpio_out                       ),
        .gpio_dir_o                   ( s_gpio_dir                       ),
        .gpio_cfg_o                   ( s_gpio_cfg                       ),

        .uart_tx_o                    ( s_uart_tx                        ),
        .uart_rx_i                    ( s_uart_rx                        ),

        .cam_clk_i                    ( s_cam_pclk                       ),
        .cam_data_i                   ( s_cam_data                       ),
        .cam_hsync_i                  ( s_cam_hsync                      ),
        .cam_vsync_i                  ( s_cam_vsync                      ),

        .timer_ch0_o                  ( s_timer0                         ),
        .timer_ch1_o                  ( s_timer1                         ),
        .timer_ch2_o                  ( s_timer2                         ),
        .timer_ch3_o                  ( s_timer3                         ),

        .i2c_scl_i                    ( s_i2c_scl_in                     ),
        .i2c_scl_o                    ( s_i2c_scl_out                    ),
        .i2c_scl_oe_o                 ( s_i2c_scl_oe                     ),
        .i2c_sda_i                    ( s_i2c_sda_in                     ),
        .i2c_sda_o                    ( s_i2c_sda_out                    ),
        .i2c_sda_oe_o                 ( s_i2c_sda_oe                     ),

        .i2s_slave_sd0_i              ( s_i2s_sd0_in                     ),
        .i2s_slave_sd1_i              ( s_i2s_sd1_in                     ),
        .i2s_slave_ws_i               ( s_i2s_ws_in                      ),
        .i2s_slave_ws_o               ( s_i2s_ws0_out                    ),
        .i2s_slave_ws_oe              ( s_i2s_slave_ws_oe                ),
        .i2s_slave_sck_i              ( s_i2s_sck_in                     ),
        .i2s_slave_sck_o              ( s_i2s_sck0_out                   ),
        .i2s_slave_sck_oe             ( s_i2s_slave_sck_oe               ),

        .spi_clk_o                    ( s_spi_clk                        ),
        .spi_csn_o                    ( s_spi_csn                        ),
        .spi_oen_o                    ( s_spi_oen                        ),
        .spi_sdo_o                    ( s_spi_sdo                        ),
        .spi_sdi_i                    ( s_spi_sdi                        ),

        .sdio_clk_o                   ( s_sdio_clk                       ),
        .sdio_cmd_o                   ( s_sdio_cmdo                      ),
        .sdio_cmd_i                   ( s_sdio_cmdi                      ),
        .sdio_cmd_oen_o               ( s_sdio_cmd_oen                   ),
        .sdio_data_o                  ( s_sdio_datao                     ),
        .sdio_data_i                  ( s_sdio_datai                     ),
        .sdio_data_oen_o              ( s_sdio_data_oen                  ),

        .hyper_cs_no                  ( s_hyper_cs_n                     ),
        .hyper_ck_o                   ( s_hyper_ck                       ),
        .hyper_ck_no                  ( s_hyper_ck_n                     ),
        .hyper_rwds_o                 ( s_hyper_rwds_o                   ),
        .hyper_rwds_i                 ( s_hyper_rwds_i                   ),
        .hyper_rwds_oe_o              ( s_hyper_rwds_oe                  ),
        .hyper_dq_i                   ( s_hyper_dq_i                     ),
        .hyper_dq_o                   ( s_hyper_dq_o                     ),
        .hyper_dq_oe_o                ( s_hyper_dq_oe                    ),
        .hyper_reset_no               ( s_hyper_reset_n                  ),

        .cluster_busy_i               ( s_cluster_busy                   ),

        .async_cluster_events_wptr_o  ( s_event_wptr                     ),
        .async_cluster_events_rptr_i  ( s_event_rptr                     ),
        .async_cluster_events_data_o  ( s_event_dataasync                ),

        .cluster_irq_o                ( s_cluster_irq                    ),

        .dbg_irq_valid_o              ( s_dbg_irq_valid                  ),

        .dma_pe_evt_ack_o             ( s_dma_pe_evt_ack                 ),
        .dma_pe_evt_valid_i           ( s_dma_pe_evt_valid               ),
        .dma_pe_irq_ack_o             ( s_dma_pe_irq_ack                 ),
        .dma_pe_irq_valid_i           ( '0 ), // s_dma_pe_irq_valid               ),
        .pf_evt_ack_o                 ( s_pf_evt_ack                     ),
        .pf_evt_valid_i               ( '0 ), // s_pf_evt_valid                   ),

        .cluster_pow_o                ( s_cluster_pow                    ),
        .cluster_byp_o                ( s_cluster_byp                    ),

        .async_data_slave_aw_wptr_i   ( s_cluster_soc_bus_aw_wptr        ),
        .async_data_slave_aw_rptr_o   ( s_cluster_soc_bus_aw_rptr        ),
        .async_data_slave_aw_data_i   ( s_cluster_soc_bus_aw_data        ),
                   
        .async_data_slave_ar_wptr_i   ( s_cluster_soc_bus_ar_wptr        ),
        .async_data_slave_ar_rptr_o   ( s_cluster_soc_bus_ar_rptr        ),
        .async_data_slave_ar_data_i   ( s_cluster_soc_bus_ar_data        ),

        .async_data_slave_w_wptr_i    ( s_cluster_soc_bus_w_wptr         ),
        .async_data_slave_w_data_i    ( s_cluster_soc_bus_w_data         ),
        .async_data_slave_w_rptr_o    ( s_cluster_soc_bus_w_rptr         ),

        .async_data_slave_r_wptr_o    ( s_cluster_soc_bus_r_wptr         ),
        .async_data_slave_r_rptr_i    ( s_cluster_soc_bus_r_rptr         ),
        .async_data_slave_r_data_o    ( s_cluster_soc_bus_r_data         ),

        .async_data_slave_b_wptr_o    ( s_cluster_soc_bus_b_wptr         ),
        .async_data_slave_b_rptr_i    ( s_cluster_soc_bus_b_rptr         ),
        .async_data_slave_b_data_o    ( s_cluster_soc_bus_b_data         ),

        .async_data_master_aw_wptr_o  ( s_soc_cluster_bus_aw_wptr        ),
        .async_data_master_aw_rptr_i  ( s_soc_cluster_bus_aw_rptr        ),
        .async_data_master_aw_data_o  ( s_soc_cluster_bus_aw_data        ),
                                     
        .async_data_master_ar_wptr_o  ( s_soc_cluster_bus_ar_wptr        ),
        .async_data_master_ar_rptr_i  ( s_soc_cluster_bus_ar_rptr        ),
        .async_data_master_ar_data_o  ( s_soc_cluster_bus_ar_data        ),
                                     
        .async_data_master_w_wptr_o   ( s_soc_cluster_bus_w_wptr         ),
        .async_data_master_w_data_o   ( s_soc_cluster_bus_w_data         ),
        .async_data_master_w_rptr_i   ( s_soc_cluster_bus_w_rptr         ),
                                     
        .async_data_master_r_wptr_i   ( s_soc_cluster_bus_r_wptr         ),
        .async_data_master_r_rptr_o   ( s_soc_cluster_bus_r_rptr         ),
        .async_data_master_r_data_i   ( s_soc_cluster_bus_r_data         ),
                                     
        .async_data_master_b_wptr_i   ( s_soc_cluster_bus_b_wptr         ),
        .async_data_master_b_rptr_o   ( s_soc_cluster_bus_b_rptr         ),
        .async_data_master_b_data_i   ( s_soc_cluster_bus_b_data         ),
                   
        .cluster_clk_o                ( s_cluster_clk                    ),
        .cluster_rstn_o               ( s_cluster_rstn                   ),

        .cluster_rtc_o                ( s_cluster_rtc                    ),
        .cluster_fetch_enable_o       ( s_cluster_fetch_enable           ),
        .cluster_boot_addr_o          ( s_cluster_boot_addr              ),
        .cluster_test_en_o            ( s_cluster_test_en                ),
        .*
    );

cluster_domain#(
  //CLUSTER PARAMETERS
        .CORE_TYPE_CL        ( CORE_TYPE_CL ),
        .USE_HWPE_CL         ( USE_HWPE_CL ),
        .NB_CORES            (`NB_CORES),
        .NB_HWPE_PORTS       (4),
        .NB_DMAS             (4),
        .TCDM_SIZE           (64*1024),
        .NB_TCDM_BANKS       (16),
        .L2_SIZE             (512*1024),
  // ICACHE PARAMETERS
        .SET_ASSOCIATIVE     (4),
        .CACHE_LINE          (1),
        .CACHE_SIZE          (4096),
        .ICACHE_DATA_WIDTH   (128),
        .L0_BUFFER_FEATURE   ("DISABLED"),
        .MULTICAST_FEATURE   ("DISABLED"),
        .SHARED_ICACHE       ("ENABLED"),
        .DIRECT_MAPPED_FEATURE("DISABLED"),
  // CORE PARAMETERS
        .ROM_BOOT_ADDR       (32'h1A000000),
        .BOOT_ADDR           (32'h1C000000),
        .INSTR_RDATA_WIDTH   (32),
        .CLUST_FPU           (`CLUST_FPU),
        .CLUST_FP_DIVSQRT    (`CLUST_FP_DIVSQRT),
        .CLUST_SHARED_FP     (`CLUST_SHARED_FP),
        .CLUST_SHARED_FP_DIVSQRT(`CLUST_SHARED_FP_DIVSQRT),

  // AXI ADDR WIDTH
        .AXI_ADDR_WIDTH      (AXI_ADDR_WIDTH),
        .AXI_DATA_S2C_WIDTH  (AXI_SOC_CLUSTER_DATA_WIDTH),
        .AXI_DATA_C2S_WIDTH  (AXI_CLUSTER_SOC_DATA_WIDTH),
        .AXI_USER_WIDTH      (AXI_USER_WIDTH),
        .AXI_ID_IN_WIDTH     (AXI_SOC_CLUSTER_ID_WIDTH),
        .AXI_ID_OUT_WIDTH    (AXI_CLUSTER_SOC_ID_WIDTH),
        .DC_SLICE_BUFFER_WIDTH(BUFFER_WIDTH),
        .LOG_DEPTH           (LOG_DEPTH),
  // AXI CLUSTER TO SOC CDC
        .C2S_AW_WIDTH        (AXI_CLUSTER_SOC_AW_WIDTH),
        .C2S_W_WIDTH         (AXI_CLUSTER_SOC_W_WIDTH),
        .C2S_B_WIDTH         (AXI_CLUSTER_SOC_B_WIDTH),
        .C2S_AR_WIDTH        (AXI_CLUSTER_SOC_AR_WIDTH),
        .C2S_R_WIDTH         (AXI_CLUSTER_SOC_R_WIDTH),
 // AXI SOC TO CLUSTER
        .S2C_AW_WIDTH        (AXI_SOC_CLUSTER_AW_WIDTH),
        .S2C_W_WIDTH         (AXI_SOC_CLUSTER_W_WIDTH),
        .S2C_B_WIDTH         (AXI_SOC_CLUSTER_B_WIDTH),
        .S2C_AR_WIDTH        (AXI_SOC_CLUSTER_AR_WIDTH),
        .S2C_R_WIDTH         (AXI_SOC_CLUSTER_R_WIDTH), 
  // CLUSTER MAIN PARAMETERS
        .DATA_WIDTH          (32),
        .ADDR_WIDTH          (32),
  // TCDM PARAMETERS
        .TEST_SET_BIT        (20), // bits used to indicate a test and set opration during a load in TCDM
  // PERIPH PARAMETERS
        .LOG_CLUSTER         (5), // NOT USED RIGHT NOW
        .PE_ROUTING_LSB      (10), //LSB used as routing BIT in periph interco
        .EVNT_WIDTH          (8)
        )  cluster_domain_i
    (
        .clk_i                        ( s_cluster_clk                    ),
        .rst_ni                       ( s_cluster_rstn                   ),
        .ref_clk_i                    ( s_ref_clk                        ),

        .async_cluster_events_wptr_i  ( s_event_wptr                     ),
        .async_cluster_events_rptr_o  ( s_event_rptr                     ),
        .async_cluster_events_data_i  ( s_event_dataasync                ),

        .dma_pe_evt_ack_i             ( s_dma_pe_evt_ack                 ),
        .dma_pe_evt_valid_o           ( s_dma_pe_evt_valid               ),
        .dma_pe_irq_ack_i             ( s_dma_pe_irq_ack                 ),
        .dma_pe_irq_valid_o           ( s_dma_pe_irq_valid               ),

        .dbg_irq_valid_i              ( s_dbg_irq_valid                  ), //s_dbg_irq_valid


        .pf_evt_ack_i                 ( s_pf_evt_ack                     ),
        .pf_evt_valid_o               ( s_pf_evt_valid                   ),
        
        .busy_o                       ( s_cluster_busy                   ),

        .async_data_master_aw_wptr_o  ( s_cluster_soc_bus_aw_wptr        ),
        .async_data_master_aw_rptr_i  ( s_cluster_soc_bus_aw_rptr        ),
        .async_data_master_aw_data_o  ( s_cluster_soc_bus_aw_data        ),
        
        .async_data_master_ar_wptr_o  ( s_cluster_soc_bus_ar_wptr        ),
        .async_data_master_ar_rptr_i  ( s_cluster_soc_bus_ar_rptr        ),
        .async_data_master_ar_data_o  ( s_cluster_soc_bus_ar_data        ),
        
        .async_data_master_w_wptr_o   ( s_cluster_soc_bus_w_wptr         ),
        .async_data_master_w_rptr_i   ( s_cluster_soc_bus_w_rptr         ),
        .async_data_master_w_data_o   ( s_cluster_soc_bus_w_data         ),
                                                                       
        .async_data_master_r_wptr_i   ( s_cluster_soc_bus_r_wptr         ),
        .async_data_master_r_rptr_o   ( s_cluster_soc_bus_r_rptr         ),
        .async_data_master_r_data_i   ( s_cluster_soc_bus_r_data         ),
                                                                       
        .async_data_master_b_wptr_i   ( s_cluster_soc_bus_b_wptr         ),
        .async_data_master_b_rptr_o   ( s_cluster_soc_bus_b_rptr         ),
        .async_data_master_b_data_i   ( s_cluster_soc_bus_b_data         ),


        .async_data_slave_aw_wptr_i  ( s_soc_cluster_bus_aw_wptr        ),
        .async_data_slave_aw_rptr_o  ( s_soc_cluster_bus_aw_rptr        ),
        .async_data_slave_aw_data_i  ( s_soc_cluster_bus_aw_data        ),
        
        .async_data_slave_ar_wptr_i  ( s_soc_cluster_bus_ar_wptr        ),
        .async_data_slave_ar_rptr_o  ( s_soc_cluster_bus_ar_rptr        ),
        .async_data_slave_ar_data_i  ( s_soc_cluster_bus_ar_data        ),
        
        .async_data_slave_w_wptr_i   ( s_soc_cluster_bus_w_wptr         ),
        .async_data_slave_w_rptr_o   ( s_soc_cluster_bus_w_rptr         ),
        .async_data_slave_w_data_i   ( s_soc_cluster_bus_w_data         ),
                                                                       
        .async_data_slave_r_wptr_o   ( s_soc_cluster_bus_r_wptr         ),
        .async_data_slave_r_rptr_i   ( s_soc_cluster_bus_r_rptr         ),
        .async_data_slave_r_data_o   ( s_soc_cluster_bus_r_data         ),
                                                                       
        .async_data_slave_b_wptr_o   ( s_soc_cluster_bus_b_wptr         ),
        .async_data_slave_b_rptr_i   ( s_soc_cluster_bus_b_rptr         ),
        .async_data_slave_b_data_o   ( s_soc_cluster_bus_b_data         )
    );
endmodule
