pulp-platform/pulp/rtl/vip/camera/cam_vip.sv

/* 
 * cam_vip.sv
 * Antonio Pullini <pullinia@iis.ee.ethz.ch>
 *
 * Copyright (C) 2013-2018 ETH Zurich, University of Bologna.
 *
 * Copyright and related rights are licensed under the Solderpad Hardware
 * License, Version 0.51 (the "License"); you may not use this file except in
 * compliance with the License.  You may obtain a copy of the License at
 * http://solderpad.org/licenses/SHL-0.51. Unless required by applicable law
 * or agreed to in writing, software, hardware and materials distributed under
 * this License is distributed on an "AS IS" BASIS, WITHOUT WARRANTIES OR
 * CONDITIONS OF ANY KIND, either express or implied. See the License for the
 * specific language governing permissions and limitations under the License.
 *
 */

 module cam_vip    #(
        parameter HRES = 640,
        parameter VRES = 480
)
(
    output logic       cam_pclk_o,
    output logic       cam_vsync_o,
    output logic       cam_href_o,
    output logic [7:0] cam_data_o
);
    timeunit      1ns;
    timeprecision 1ps;

    localparam clk_period=150;
    localparam TP = 2;
    localparam TLINE = (HRES+144)*TP;

    logic [23:0] pixel_array0 [(HRES*VRES)-1:0];
    logic [23:0] pixel_array1 [(HRES*VRES)-1:0];

    logic [15:0] s_targetcnt;
    logic        s_startcnt;
    logic        s_rstn;
    logic [15:0] r_counter;
    logic [15:0] r_target;

    logic [15:0] r_colptr;
    logic [15:0] s_colptr;
    logic [15:0] r_lineptr;
    logic [15:0] s_lineptr;

    logic [23:0] s_currentpixel;

    logic        r_bytesel;
    logic        s_bytesel;
    logic        r_framesel;
    logic        s_framesel;

    logic        r_done;
    logic        r_active;

  string vsim_path;
  string frame0_path;
  string frame1_path;

    enum logic [4:0] {RST,SOF,WAIT_SOF,WAIT_EOF,SEND_LINE} state,state_next;
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
