pulp-platform/pulp/(commit log)

2018-03-09 fixed pad_mux[10] in pad_control assigned to different signals #10
    [pad_control.sv]
2018-06-15 Fixed JTAG ID readout
    [jtag_tap_top.sv, pulp.sv, safe_domain.sv, soc_domain.sv]
2019-01-17 added documentation and xlsx files
    [APB_ADV_TIMER_reference.xlsx, APB_GPIO_reference.xlsx, APB_SOC_CTRL_reference.xlsx, BASIC_TIMER_reference.xlsx, CLUSTER_CRTL_UNIT_reference.xlsx, CLUSTER_ICACHE_CTRL_reference.xlsx, CL_DMA_reference.xlsx, CL_EVENT_UNIT_reference.xlsx]
2019-01-31 Few fixes for CI tests
    [testset.cfg]
2019-02-11 updated documentation with missing info about FC config regs
    [APB_SOC_CTRL_reference.xlsx]
2019-10-03 initial commit for integration
    [pulpissimo_compliance_test.cfg, pulpissimo_debug.cfg, riscv_overview.obj]
2019-10-10 some top level fix
    [cluster_domain.sv, pulp_soc_defines.sv, soc_domain.sv]
2019-10-24 fixed params to integrate HWPE into the cluster
    [cluster_domain.sv, pulp_soc_defines.sv]
2019-10-28 fixed param name for icache
    [cluster_domain.sv]
2019-11-18 Improve testing
    Ported mostly from PULPissimo
    * Add gitlab CI support (.gitlab-ci.yml)
    update-tests-gitlab fetches tests for gitlab ci instance
    Add tests folder to reduce clutter in toplevel folder
    Update Makefile with new gitlab targets
    * Pin update-tests and update-tests-gitlab to specific test
    versions (latest atm)
    * sdk-releases scripts
    These scripts pull sdk releases from artifactory for testing
    * Add auto installing and handling for VIPs, adjust generate-script and
    update-ips for that
    Check the following flags:
    [-h] [--rt-dpi] [--i2c-vip] [--flash-vip] [--i2s-vip] [--verbose]
    [testset.cfg]
2019-11-19 tb: Improve error handling
    * Count number of errors
    * Go into $stop so that we can stop the simulation and return a proper
    error code
    [jtag_pkg.sv, tb_pulp.sv]
2019-11-19 tb: Fix expected value in dpc
    * DPC can only be half world aligned
    [jtag_pkg.sv]
2019-11-19 tb: Allow i2c model to be active even when dpi models are
2020-01-22 fix aci id width
    [cluster_domain.sv]
2020-01-24 Make setting VSIM_PATH independant of sourcing location
    Currently one is required to always source vsim.sh/sdk.sh from the
    respository's root folder. This patch loosens that requirement: No
    matter the sourcing location, VSIM_PATH will be set correctly.
2020-10-15 Updated I2C and SPI for pulp_soc compatibility. Based on changes in Pulpissimo.
2020-10-15 pulp_soc: nb_cores bugfix & bump to v1.4.0
    [pulp.sv, soc_domain.sv]
2020-11-03 Updated documentation folder, now it contains PULP instead of PULPISSIMO
    [Pulp_configuration.xlsx, riscv_overview.obj]
2020-11-11 Branch for de-multiplexed GPIOs and PADs
2021-01-19 Update SoC/cluster versions to include HCI, fix NB_HWPE_PORTS to 9
    [cluster_domain.sv]
2021-03-03 Update of tb_pulp and pulp to eliminate pad multiplexing. Update of safe domain, pad control and frame.
2021-03-03 Pulpemu fmc board and constraints update for bitstream gen
2021-03-15 Boot from SPI and Hyperflash added to regression tests
2021-05-17 Replace axi_cdc and minor testbench bug fix
    [cluster_domain.sv, jtag_pkg.sv, pulp.sv, soc_domain.sv, tb_pulp.sv]
2021-06-07 clean up the SBCS error checking in tb_pulp and jtag_pkg
    [jtag_pkg.sv, tb_pulp.sv]
2021-08-25 Remove bender overrides, fix port width
    [soc_domain.sv]
2021-09-10 Switch CI to bender
2021-09-28 Revert "Merge pull request #57 from pulp-platform/revert-55-bender_integration"
    This reverts commit 3c8645696313d253dd4473f5c0c004411ed437d4, reversing
    changes made to 7e44cc630e5b0efc6ed89ee048a162857464edd5.
    [cluster_domain.sv, jtag_tap_top.sv, pulp.sv, pulpemu.sv, soc_domain.sv]
2021-10-05 Add fpga to CI-flow
2022-04-08 Bump pulp_cluster to fix CI stalls
2022-12-23 Added uart_sim.sv
2022-12-23 [jtag]: Update JTAG IDcode
    [pulpissimo_compliance_test.cfg, pulpissimo_debug.cfg]
