pulp-platform/pulp/(notices)

Notices in the files:
rtl/vip/i2s/i2c_if.v:
This information is distributed under license from Young Engineering.
COPYRIGHT (c) 2011 YOUNG ENGINEERING
ALL RIGHTS RESERVED
